Mu-Miao/Sunward_Data/README.md

# Sunward_Data

自动行驶小车项目的固件、调试记录、关键资料和当前车架交付文件。

## 项目入口

- [小车调试实测记录](小车调试实测记录_2026-10-07.md)
- [最新 T29 固件工程](output/固件接入包/T29_任务三四转向余量包/staged_Sunward)
- [T29 转向余量与烧录说明](output/固件接入包/T29_任务三四转向余量包/转向余量与烧录说明.md)
- [V19 FreeCAD 工程](output/车架模型/车架建模_v19/car_assembly_v19.FCStd)
- [V19 打印交付 ZIP](output/车架模型/打印交付/发给打印同学_v19.zip)
- [V19 设计说明](output/车架模型/车架建模_v19/设计说明_v19.md)
- [比赛题目](资料/比赛题目/H题_自动行驶小车.pdf)
- [元器件清单](资料/元器件清单.xlsx)
- [本地固件工程说明](firmware/README.md)
- [F407 OLED 驱动说明](oled_f407_hal/README.md)

## 目录

| 目录 | 内容 |
| --- | --- |
| `firmware/` | 早期本地固件工程与依赖 |
| `oled_f407_hal/` | OLED 驱动与转换工具 |
| `示例代码/` | 示例程序 |
| `文档/` | 实验操作手册 |
| `资料/` | 比赛题目、器件清单、主板资料、芯片和模块手册及参考例程 |
| `output/车架模型/` | 当前 V19 工程、STEP/STL、预览和打印交付 |
| `output/固件接入包/` | 最新 T29 完整源码与依赖；各阶段说明、补丁及验证记录 |
| `output/调试工具/` | WASD、串口记录和蓝牙调试工具源码及使用说明 |

## 归档说明

本仓库初次上传于 2026-10-14。根据项目用途筛选上传内容；本地历史文件保留原样。

不上传：旧版车架和重复项目压缩包、完整固件备份、历史接入包中重复的完整工程、临时报告与渲染中间文件、编译产物和缓存、厂家软件安装包、个人编辑器状态及原始调试接收日志。具体规则见 [.gitignore](.gitignore)。保留最新 T29 的交付 HEX 与 V19 打印 ZIP，便于按对应说明使用。

部分历史文档和脚本包含原机器的绝对路径，或引用仅保存在本地的历史模型。原 [项目导航](项目导航.md) 与 [Obsidian 首页](车车项目首页.md) 为本地入口；在 GitHub 浏览时优先使用本页的相对链接。T29 完整工程已包含 `Core`、`Drivers`、启动文件、链接脚本、工程配置和测试源码。

软件验证、固件烧录和实车测试分别记录；当前测试结果以实测记录为准。
