Mu-Miao/Sunward_Data/项目导航.md

# 车车项目导航

## 最新车架：V19，上下电池槽及插头避让

- [打开 V19 FreeCAD 工程](/Users/mzh/Desktop/车车/output/车架模型/车架建模_v19/car_assembly_v19.FCStd)
- [发给打印同学的 ZIP](/Users/mzh/Desktop/车车/output/车架模型/打印交付/发给打印同学_v19.zip)
- [整车装配预览](/Users/mzh/Desktop/车车/output/车架模型/车架建模_v19/后侧效果图_v19.png)
- [插头与电源线局部预览](/Users/mzh/Desktop/车车/output/车架模型/车架建模_v19/电源插头走线_v19.png)
- [上下电池槽剖面](/Users/mzh/Desktop/车车/output/车架模型/车架建模_v19/电池上下槽剖面_v19.png)
- [设计说明](/Users/mzh/Desktop/车车/output/车架模型/车架建模_v19/设计说明_v19.md)
- [打印说明](/Users/mzh/Desktop/车车/output/车架模型/车架建模_v19/打印说明_v19.txt)
- [完整 V19 项目压缩包](/Users/mzh/Desktop/车车/output/车架模型/项目压缩包/车架建模_v19_插头走线避让.zip)

V19 需要打印下底板、上托板各一件；主铜柱柱身 80 mm，C10B 铜柱柱身 20 mm。按目前模型，轮胎外侧跨度 200 mm，含预留 35 mm 外伸的前后长度 145 mm，高度 130.4 mm。实际装配间隙仍需试装确认。

旧版本在 `output/车架模型/历史版本`，旧打印包在 `output/车架模型/打印交付/历史版本`。以后新增车架版本请放入 `output/车架模型`，打印 ZIP 放入 `打印交付`，旧版移到相应历史版本目录。

## 资料与文档

- [比赛题目](/Users/mzh/Desktop/车车/资料/比赛题目/H题_自动行驶小车.pdf)
- [元器件清单](/Users/mzh/Desktop/车车/资料/元器件清单.xlsx)
- [C10B 主板原理图](/Users/mzh/Desktop/车车/资料/主控板/C10B主板原理图_2025-02-24.pdf)
- [C10B 接口说明图](/Users/mzh/Desktop/车车/资料/主控板/C10B主板接口说明图.jpg)
- [实验 3：定时器、PWM 与编码器操作手册](/Users/mzh/Desktop/车车/文档/实验3_定时器_PWM_编码器_详细操作手册.md)
- [小车调试实测记录](/Users/mzh/Desktop/车车/小车调试实测记录_2026-10-07.md)

芯片手册在 `资料/芯片手册`，LF04 和 OLED 模块资料在 `资料/模块资料`，厂家提供的使用说明、参考源码及软件工具在 `资料/厂家小车套件/小车`。实测记录保留在项目根目录，便于持续记录。

## 软件、接入记录和调试工具

- [本地固件工程说明](/Users/mzh/Desktop/车车/firmware/README.md)
- [F407 OLED 驱动说明](/Users/mzh/Desktop/车车/oled_f407_hal/README.md)
- [近期 T25 任务四独立重写记录](/Users/mzh/Desktop/车车/output/固件接入包/T25_任务四独立重写包/任务四独立重写与烧录说明.md)
- [近期 T26 中文注释核对记录](/Users/mzh/Desktop/车车/output/固件接入包/T26_中文注释/核对记录.json)
- [T27 任务四容错增强与烧录说明](/Users/mzh/Desktop/车车/output/固件接入包/T27_任务四容错增强包/任务四容错增强与烧录说明.md)
- [T28 任务三、四受限寻线与烧录说明](/Users/mzh/Desktop/车车/output/固件接入包/T28_任务三四受限寻线包/受限寻线与烧录说明.md)
- [T29 任务三、四转向余量与烧录说明](/Users/mzh/Desktop/车车/output/固件接入包/T29_任务三四转向余量包/转向余量与烧录说明.md)

2026-10-15 用户已主动将当前 Sunward 工程回退到 T28；T29 作为独立试调交付包保留。当前工程 Debug HEX 已核对为 T28，若要试 T29，需要明确选择 T29 包内固件文件；车上实际已烧录版本以设备显示为准。

`firmware` 和 `oled_f407_hal` 工程保留原位置。`output/固件接入包` 存放各阶段的交付文件和验证记录；`output/固件备份` 存放 Sunward 备份；`output/调试工具` 存放串口记录、蓝牙测试和 WASD 工具；`示例代码` 存放原根目录两个 main 示例。

接入包和编译记录属于历史过程资料，不凭文件夹编号认定当前固件或实车验收状态。目录整理没有烧录固件，也没有修改固件源代码。

## 归档和整理记录

临时脚本、实验报告渲染中间文件和主机检查产物放在 `归档/临时工作区`。

- [旧路径到新路径的移动清单](/Users/mzh/Desktop/车车/归档/目录整理记录_2026-10-13/移动清单.json)
- [文件完整性清单](/Users/mzh/Desktop/车车/归档/目录整理记录_2026-10-13/文件完整性清单.json)
- [路径引用修正记录](/Users/mzh/Desktop/车车/归档/目录整理记录_2026-10-13/路径引用修正.json)
- [整理结果](/Users/mzh/Desktop/车车/归档/目录整理记录_2026-10-13/整理结果.json)

这次移动了 125 个入口，校验了 14477 个文件，修正了 184 个文本文件中的路径引用，没有删除资料。修改前原文保存在整理记录内。备份快照和历史 ZIP 保留原内容，因此它们内部的旧绝对路径可以按移动清单定位新位置；需重新构建历史快照时，应另存副本并更新对应构建配置，保留原始备份。
