Mu-Miao/Sunward_Data/output/TASK4_V18_FLOW_2026-10-22/修改与验证说明.md

# V18 FLOW：基于 V14 的提前转向和连续换段

日期：2026-10-22。基线为用户指定分支 `codex/task4-v14-pwm22`，提交 `242b647ed1a8470ea77b5fc2576e4198fb08c912`；本地新分支 `codex/task4-v14-rolling`。原工作目录 dev 及 `.eide/eide.yml` 的未提交改动保持原状。未推送、未烧录。

## 原因与修改

V14 在候选顶点处输出 HALT，去抖后进入刹停阶段；转向对正后再次等待两轮低于 5mm/s 并停稳 200ms。前三圈回 A 也停车重启。这些步骤增加停顿和重新加速时间。

本版从 V14 移植仓库现有的连续控制及积分衔接实现，并新增首次候选线预转和任务四独立转弯速度：

1. C/D：保留原 ±120mm 候选窗口。前置探头首次读到有效黑线便开始两轮前进的低速转向；原连续 30ms 确认完成后才记点、发提示并换段。窗口外不预转；窗口内全白不按固定距离提前盲转。单帧毛刺消失时恢复原斜线航向，不计点。
2. A/B/C/D：正常去抖、角度确认、捕线到入弧和巡线的交接不再输出显式零驱动；不要求中途轮速归零。对正仍要求 ±3° 连续 30ms。
3. 圈间：前三圈 A 点当拍接续下一圈，固定使用第一次建立的 AC 航向；第四圈保留最终停稳。总共 4 圈、8 段入弧、17 次声光提示。
4. PI：仅在首次低速确认或换段时，对降速轮执行 `积分 *= 新目标 / 旧目标`，不增加升速轮积分，不重置反向/堵转累计。普通巡线每拍不重复缩减。PI 在实速高于目标时仍允许零 PWM 减速滑行，正目标不等于保证实物每拍有驱动力。
5. 任务四转向外轮最高 100、内轮 20mm/s；近目标角外轮降到最低 55mm/s。相比移植后 80/20 的配置，提高差速可避免双轮前进使转向过慢。

## 参数与范围

| 项目 | V14 | V18 FLOW |
| --- | --- | --- |
| 直线 / 正常弧线目标 | 270 / 240mm/s | 270 / 240mm/s |
| 转向外 / 内轮 | 最高80 / 0mm/s | 最高100 / 20mm/s |
| 转向平均编码器位移预算 | 80mm | 120mm |
| 转向时限 / 角度确认 | 4秒 / ±3°、30ms | 相同 |
| 入弧 / 捕线速度 | 50mm/s | 相同 |
| PI 输出上限 | 2200 | 相同 |
| B→BD 少转量 | 3° | 相同 |
| 正常中间停稳 / 圈间停车 | 有 | 取消；末圈终点停车 |

双轮前进转向的平移大于 V14 单轮转向，因此任务四位移预算明确从 80 改为 120mm；4秒时限不延长。任务三仍使用原单轮转向、80mm预算和停稳流程。任务四有效性检查限制双轮模式位移预算不得超过120mm。

STOP/OFF、IMU/ADC/UART异常、低压、节拍、超速、反向、堵转、失线/捕线/寻线边界及160秒总时限继续优先停车并锁存。连续运动不覆盖这些异常情形。几何、前置探头实际安装位置、车身对顶点和弧线的覆盖仍需真实场地验证；不通过扩大候选窗口替代覆盖验证。

## 文章参考

用户提供的[《2024年电赛H题自动行驶小车全代码思路讲解》](https://blog.csdn.net/2301_79299887/article/details/141063042)中，采用探头见线/离线事件衔接直线与循迹，并按偏差改变控制参数。参考的是事件换段和按偏差分配速度的思路。本车原有边缘探头降至120mm/s的策略继续保留。

文章为七路灰度、直接PWM方案；本车为LF04四路、MPU6050和双轮编码器PI。因此没有移植其PID数值、固定PWM、定时测距或每段重置yaw的实现。文章示例中的多路独立if会覆盖位置，且全白默认0，不能代替本项目对全白/全黑/离散图样的有效性检查。未复制文章代码。

赛题资料：`/Users/mzh/Desktop/车车/资料/比赛题目/H题_自动行驶小车.pdf`，第2页要求经过顶点时车身投影覆盖顶点、弧线过程中投影覆盖弧线。本版仅在原点位窗口并结合实际探头观测预转，软件测试不能证明实车投影满足条件。

## 软件验证与固件

- 10 类场景、CarApp与兼容API共20组ASan/UBSan回归通过。覆盖四圈16次连续转向、3次A点移动接续、8段入弧、17次提示、正常衔接显式零驱动为0、最终停车以及故障优先级。
- 新增 C/D 首候选预转、窗口外/全白/全黑不预转、单帧毛刺不误记点、传感器/航向/里程/STOP优先级。
- 同样巡航速度、160mm轮距、45mm探头提前量的理想输入模型：模拟 V14 停车策略128130ms，V18 FLOW122210ms，约少5.92秒。此对照包含转向100/20与80/0的差异，不是实车预测；模型按给定航向与理想轮速运行，不验证实际轮胎、惯性或轨迹覆盖。
- PI带死区/滞后的27组电机假设均在120mm预算内完成C点转向，最大90.23mm。该模型用于发现旧积分导致的转向问题，不作为实车拟合。
- 50 个 ARM 编译单元通过编译、链接。FLASH 56856B，RAM 5864B。HEX 校验和、EOF、版本字符串、FLASH范围与向量检查通过；构建警告为原 `main.c` 未使用诊断变量/函数。
- 构建脚本 `tools/build_firmware.py`；测试脚本 `tools/tests/run_tests.py`。输出、日志与清单在 `build/Debug/`。
- HEX SHA256：`9eeab0b7acb77f2b54db94debbefa200582d310901a6f86d57f3633d68a0015c`。
- ELF SHA256：`9245bf3c749abe674591f05629b015063ce7d595eae67d11e61cd58e2ccff467`。

本版只有软件验证与构建完成，未烧录、未启动电机、未进行实车验收。部署时使用本版HEX并核对 `TASK 4 V18 FLOW` 标题，不选历史归档V14固件。
