Mu-Miao/Sunward_Data/output/TASK4_V18_FLOW_2026-10-22/参考仓库代码对比.md

# hshsgxlj/stm32 与 V18 的入弧控制对比

核对日期：2026-10-22。参考版本固定为 `d58e622c16aeb1735e2873f35c9fa72f22ab202f`（main）。阅读了正式入口chapter.c、h_course.c、h_course.h以及motor.c、track.c，并区分独立line_follow.c与正式任务控制。此次只读审阅，没有运行外部仓库脚本、修改车上参数或烧录。

pyOCD采集进程已退出。会话20261022_195646在20:03:12(+08:00)因探针读取超时断开，进程退出码1，未重新连接。此前现场数据和故障提取记录已保存。

## 与当前问题最相关的实现

| 项目 | 参考仓库实际实现 | V18实际实现/现场观察 |
| --- | --- | --- |
| 捕线放行 | CAPTURE中1～3路连续黑线、连续30ms即可转ARC，最外侧单探头也有效 | 捕线后进入ARC_ENTRY，非最外侧有效图样连续60ms且已入弧至少200ms才转ARC |
| 最外侧探头 | 在ARC内部进入line_recover_dir，低速保持纠偏；中间P2/P3任一压黑连续30ms后退出恢复 | ARC_ENTRY把偏差与弧向前馈相加并限幅；现场1110时目标30/70mm/s，仍不能放行 |
| 专用恢复 | 任务3/4基准PWM的70%，固定修正85；制动期限参数10ms | 入弧50mm/s，差速限幅为基速40%；参数是目标速度单位，不可直接用PWM参数替换 |
| 全白 | 恢复方向最长保留1500ms；普通短空白前150ms保持上次差速 | 原入弧/失线时间、位移、角度预算；本次另有500ms全白触发F7 |
| 顶点衔接 | VERTEX_BRAKE等待200ms并检查轮速，单轮转向；A/B出弯还有摆正与停稳 | 正常换段连续运动，两轮前进转向100/20mm/s |
| 轮速执行 | MOTOR_SetSpeeds实际输出直接PWM，编码器用于计距和部分同步 | 双轮以mm/s目标通过PI闭环执行 |

关键代码：

- [有效线定义](https://github.com/hshsgxlj/stm32/blob/d58e622c16aeb1735e2873f35c9fa72f22ab202f/Core/Src/h_course.c#L369-L390)：接受1～3路连续黑线，包含最外单探头。
- [CAPTURE转ARC](https://github.com/hshsgxlj/stm32/blob/d58e622c16aeb1735e2873f35c9fa72f22ab202f/Core/Src/h_course.c#L805-L822)：确认有效线后直接交给巡线，没有V18独立60mm入弧放行阶段。
- [弧线边缘恢复](https://github.com/hshsgxlj/stm32/blob/d58e622c16aeb1735e2873f35c9fa72f22ab202f/Core/Src/h_course.c#L905-L1066)：保持恢复方向，内侧探头稳定后退出；普通巡线包含P/I/D。
- [恢复参数](https://github.com/hshsgxlj/stm32/blob/d58e622c16aeb1735e2873f35c9fa72f22ab202f/Core/Inc/h_course.h#L109-L128)：任务3/4 70%、85、10ms和恢复全白1500ms。
- [电机输出](https://github.com/hshsgxlj/stm32/blob/d58e622c16aeb1735e2873f35c9fa72f22ab202f/Core/Src/motor.c#L109-L140)：速度命名的参数最终换成占空比，没有与我们相同的mm/s速度PI。

## 不宜直接移植的部分

1. **任务3/4线尾判定缺少几何终点约束。** ARC每拍先调用task2_all_white_event，持续全白450ms就按阶段记作B或A。该函数的已见有效线/最小350mm保护仅对task2启用，没有给task3/4加入我们的弧长窗口与出口航向条件。因此本次V18第三趟在入弧阶段的全白，若套用这种判定，存在误计B点的风险，不能把不停车或切段误认为跑通。
2. **仍有主动停车。** C/D顶点、单轮转向完成和A/B出弯均有零输出或停稳阶段，不是本次目标所需的全程连续换段方案。task34的10ms恢复制动只是期限参数，10ms主周期下实际是否产生一个零输出周期还取决于调度时刻。
3. **左右次序不同。** 他们按PC8/PC4/PC9/PB8定义P1～P4从左到右；我们对同一组原始引脚读数反序解码物理O4/O3/O2/O1。相同字符串和纠偏正负号在两车上不能直接对应。应保留我们的物理映射。
4. **现场标定不同。** 他们配置35°斜线、222.6mm轮周长、62400计数/圈、B出口-175°等；我们使用38.66°几何、204.20mm轮周长及左右独立CPR。这些数值不应随控制策略一起搬入。
5. **代码/注释不能证明完赛。** h_course.c及h_course.h本身标注参考Sunward；仓库README的功能、构建及标定说明不等于一份匹配该提交的四圈实测记录。此处只评价静态实现，没有验证其实际成绩。

线尾判定依据：[task2_all_white_event](https://github.com/hshsgxlj/stm32/blob/d58e622c16aeb1735e2873f35c9fa72f22ab202f/Core/Src/h_course.c#L320-L347)、[任务3/4 ARC调用](https://github.com/hshsgxlj/stm32/blob/d58e622c16aeb1735e2873f35c9fa72f22ab202f/Core/Src/h_course.c#L825-L840)、[450ms参数](https://github.com/hshsgxlj/stm32/blob/d58e622c16aeb1735e2873f35c9fa72f22ab202f/Core/Inc/h_course.h#L53)。

## 对下一版的建议

参考“有效线接管与提速资格分开”的思路：在原点位/捕线边界内确认有效单探头后，进入受限的低速边缘巡线；内侧图样稳定后再允许正常速度。保留本车的探头映射、双轮PI、故障锁存，以及失线时间/位移/角度和弧线出口联合约束。低速恢复不直接放240mm/s，也不只放宽60mm或将500ms改成1500ms。

该建议尚需用本次1110持续见线和1110→1111两个现场片段验证。恢复方向保持和短空白冻结差速在V18中已有，真正需要调整的是低速入弧与巡线反馈接管的条件和轨迹，而不是重复添加同样的寻线功能。
