Mu-Miao/Sunward_Data/output/TASK4_V19_EDGE_2026-10-22/修改与验证说明.md

# V19 EDGE：捕线后先接管低速巡线，内侧稳定后再提速

2026-10-22，基于V18提交 `f2802b6bf4152c0142424c0d71640e7091490cd5`，本地分支 `codex/task4-v19-edge`。V14和V18分支保持原状。V19已完成软件验证与构建，未烧录、未实车验证，pyOCD保持关闭。

## 现场问题

板上56856字节FLASH已逐字节核对V18 ELF。保存的两趟独立故障：

- start_ms=225380：第一半圆ARC_ENTRY采到25帧，均为有效1110最左单探头；始终未通过非最外侧连续60ms的放行条件。入弧60.442mm、1220ms时锁存F6位移超限，CPU仍运行。
- start_ms=285471：先1110，后1111；失线500ms、24.85mm、8.00度时锁存F7时间预算，CPU仍运行。

原始提取记录见 `records/task4/2026-10-22_v18_entry_faults.json`。20Hz异步RAM不是10ms原子轨迹，短图样可能漏采；精确停车判据使用固件锁存快照。

## 实现

1. C/D点位与转向对正流程保留。CAPTURE仍需连续30ms有效线，且受原2秒/60mm捕线边界限制。通过后允许最外侧单探头进入ARC低速子状态 `edge_follow_active=1`，不再把内侧稳定作为低速巡线接管的前提。
2. 低速基速70mm/s。最外侧单探头采用±50mm/s差速，目标20/120或120/20mm/s；非最外侧有效图样按已有巡线增益生成差速并限幅。继续使用双轮PI，原左右映射不变，没有使用固定PWM或复制参考仓库参数。
3. 非最外侧有效图样连续60ms、且低速阶段已至少200ms，才取消低速标志。从70mm/s按原弧线加速度100mm/s²逐渐提速；不会立刻跳至240mm/s。接管与提速不重置半圆里程，不重复计弧、计点或发声光。
4. 低速子状态从捕线接管时起独立限120mm、2500ms和45°。这是V19新的反馈巡线预算；V18 ARC_ENTRY的60mm/1500ms/25°流程保留为可选旧配置回归，不用于V19默认接管。新预算不随探头闪烁或恢复重启。
5. 全白或未确认恢复时降到50mm/s，冻结最后可信差速并限为±30mm/s，最外侧历史通常为20/80。恢复仍须连续有效30ms，内侧提速确认从恢复完成后重新计时。全白500ms、普通20mm/12°、可信探头交接35mm/18°全部保留。全黑/离散图样立即零输出并使用原故障等待，不作为巡线有效线。
6. 入弧附近全白不能计作B/A。正常弧线出口仍同时要求里程窗口、出口航向和连续全白；低速子状态禁止线尾放行。参考仓库的“仅全白450ms判出口”未移植。
7. 低速阶段显示EDGE；故障快照区分EDGE时间/位移预算。只读采集器增加可选低速标志与恢复基速字段。V19 ELF的instance为944字节，V18为912字节。

## 保留与改变

| 项目 | V19 |
| --- | --- |
| 正常直线/半圆巡航 | 270/240mm/s，保持V18 |
| C/D提前转向、正常换段、前三圈A接续 | 保持连续；末圈终点停稳 |
| 顶点转向 | 外轮最高100、内轮20mm/s，120mm/4秒预算保持 |
| 低速巡线接管 | 新增70mm/s基速，外侧20/120；120mm/2.5秒/45°预算 |
| 内侧提速资格 | 非最外侧连续60ms且阶段至少200ms |
| 短暂全白 | 基速50、差速冻结；原500ms及位移/角度预算 |
| PI输出上限、增益 | 2200、原增益和换段积分缩减保持 |
| 启动方向、静态CAL、探头顺序 | 保持 |
| 任务三/可选旧入弧 | 默认不启用新接管；旧流程继续回归 |

STOP/OFF、按键取消、IMU/ADC/UART异常、低压、节拍、超速、反向、堵转与160秒总超时仍优先停车并锁存。两轮正目标不等于每拍PWM非零：PI仍允许超目标时滑行减速。

## 参考来源

参考[hshsgxlj/stm32的CAPTURE接管](https://github.com/hshsgxlj/stm32/blob/d58e622c16aeb1735e2873f35c9fa72f22ab202f/Core/Src/h_course.c#L805-L822)和[低速边缘恢复](https://github.com/hshsgxlj/stm32/blob/d58e622c16aeb1735e2873f35c9fa72f22ab202f/Core/Src/h_course.c#L905-L1066)的状态衔接思路。新实现使用本项目原物理映射、mm/s目标和轮速PI，未复制其实现代码、PWM值、1500ms寻线预算、轮周长或角度标定。

## 验证

- 11类场景、CarApp及兼容API共22组ASan/UBSan回归通过。四圈16次转向、3次A移动接续、8次入弧、17次提示与最终停车通过。
- 用V18保存的入弧帧构建输入夹具；10ms之间的插值是测试构造，不是假称10ms实测。关闭新接管时重现原60mm F6；启用后同样1110输入持续受限低速巡线，可越过原60mm停点，并在随后构造的内侧稳定输入后逐渐提速。该结果证明控制分支已改变，不能证明新实车轨迹一定恢复。
- 原始持续全白片段依然正确触发500ms F7，不伪造B点；另测期限内真实连续恢复输入可接续，毛刺不能续期、翻转冻结方向或提前提速。
- 覆盖CB/DA及左右探头镜像、最少200ms、60ms去抖被毛刺打断、毫秒溢出、70起步斜坡、距离/计数/航向参考保留；120mm/2500ms/45°、500ms/35mm/18°的边界和端口二次授权；全黑/离散图样与原各类故障停车。
- 50个ARM单元编译链接通过，FLASH58108B，RAM5896B；警告仅为原main.c未使用诊断变量/函数。HEX校验和、EOF、FLASH范围、栈/复位向量和版本标题通过。
- ELF离线布局通过：地址0x200000a8，instance944字节。该检查不连接USB探针。
- HEX SHA256：`3dac3f898b5aa6aa81e302646b10f2bdaf5f824c4f86a59f81a348e90999f145`。
- ELF SHA256：`4f3582504d99b9a9435b46f8bf58283abfa354e3e040b26e8c8cc968054a09cb`。

源码入口：Core/Src/car_task3.c、car_task3_port.c；调参入口Core/Inc/car_config.h。新增回归tools/tests/test_edge.c，原始帧夹具tools/tests/fixtures/v18_entry_onsets.h；日志和固件见deliverables/task4-v19-edge/。

V19当前只完成软件验证与构建。实际贴线、车身投影、圈时和整圈稳定性仍未验证；本次没有重开pyOCD、烧录、复位或启动电机。
