Mu-Miao/Sunward_Data/output/固件接入包/9.5_串口优化包/串口优化与复测.md

# 双轮版串口优化与复测

2026-10-08，已代做备份与代码接入。备份在[优化前版本](/Users/mzh/Desktop/车车/output/固件备份/Sunward_串口优化前备份_2026-10-08_3fxiu9pp)，包括源码、中断文件、main、构建文件、原ELF/HEX。main、CubeMX配置、115200波特率和双轮PI参数保持原样。

## 改了什么，为什么

旧双轮运行日志在主循环用HAL_UART_Transmit阻塞发送。一行比单轮更长，发送期间主循环不能处理命令和测量；115200/8N1每字节约86.8微秒，80～100字节约6.9～8.7ms，占用10ms控制周期的较大部分。接收只靠主循环逐字节轮询，期间可能发生UART溢出。旧逻辑遇到UART错误又将active置0，日志和命令处理一起退出，表现可能像卡死。未捕获用户本次卡死的运行日志，不将这些代码问题直接当作已复现的唯一原因。

新lab_uart_async.h/.c在双轮模块初始化后独占USART1。启动阶段之前的Boot等文字仍是有限时阻塞输出；双轮阶段改为：

- 发送先复制到512字节队列，由TXE中断逐字节发送，主循环不等待整行发完。满队列丢弃整条遥测，累计TXD，保留控制和接收。
- 接收由中断写入128字节队列，主循环每次最多处理32字节。RX溢出及ORE/FE/NE/PE错误累计RXE，清除错误状态，通知主循环两轮停车并清积分，丢弃残缺输入。模块继续输出和接收，允许恢复后的新完整命令。
- 半条命令闲置100ms后丢弃，避免残留RU之类字符干扰下一次STOP。
- 日志每200ms一条，增加RXE/TXD诊断字段。USART1中断优先级2，低于TIM2的0；ISR只搬运字节，不格式化文字或执行PI。

中断入口添加在stm32f1xx_it.c的USER CODE块，声明在.h的USER CODE块；启用NVIC放在驱动初始化中，不必在CubeMX再点USART1中断。当前运行阶段不要再混用HAL_UART_Transmit/Receive、HAL_UART_IRQHandler或其他UART中断驱动。若以后在CubeMX启用USART1中断并生成同名处理函数，需要合并入口，避免重复定义。

双轮模块的目标60、P32/I20、每轮上限1800、3秒结束、使能/ADC/采样/方向/堵转停车条件均保留。USART接收错误后日志ST=UART，但不会永久关闭模块；静置100ms以上让输入恢复边界，再发送完整命令。故障期间没有自动重新启动电机。

## 你现在这样测

1. 固定车身、双轮架空，使能OFF，下载新的`/Users/mzh/STM32Cube/Sunward/build/Debug/Sunward.hex`。
2. 连接115200/8N1串口后Reset，确认DPI提示末尾是`UART async`。
3. **保持OFF等20秒**，看日志是否持续刷新。正常时RXE=0、TXD=0。先确认待机通信，再启动电机。
4. 电池主电源ON，使能ON，等1秒，单次发送RUN!，观察两轮向前、约3秒自动停。
5. 停3秒，再RUN，约1秒后STOP!；再停3秒、RUN、约1秒后拨OFF，检查两轮均停。
6. 导出JSON发给我，说明文字是否还停住、轮子是否平顺。若有ST=UART/GAP或RXE/TXD不为0，保留这些行供定位。

不要循环发送RUN或大量AT命令做压力测试。正常用户命令和遥测已在模拟检查中覆盖；实际USB串口、浏览器显示和电机干扰仍需本轮实测。若停车异常，用使能OFF；软件无响应时切断电池主电源。

## 验证范围

主机集成模拟覆盖真实队列驱动与双轮模块：队列拥塞时控制/STOP继续运行；RX溢出/ORE停车后日志与重启恢复；RX与TX并行、队列回绕、队列保存调用者数据副本、空队列关闭TXE中断、半条命令过期，以及原双轮PI与停车条件。全工程ARM编译链接通过，最终ELF具有强USART1_IRQHandler与LabUART_IRQHandler符号。具体日志在本包内。模拟不代替硬件中断时序、USB设备或浏览器卡顿的验证；尚未自动烧录。
