Mu-Miao/Sunward_Data/output/固件接入包/9.5_双轮PI闭环测试包/9.5_第七步_双轮3秒测试.md

# 双轮同时前进，固定架空试转3秒

**串口优化更新：当前Sunward及本包源码已改为运行阶段USART1中断收发，启动提示末尾为`UART async`，目标/增益/3秒时长保持原样。先按[串口复测说明](/Users/mzh/Desktop/车车/output/固件接入包/9.5_串口优化包/串口优化与复测.md)检查OFF待机20秒，再做双轮试转。** 本包新增lab_uart_async.h/.c及更新后的stm32f1xx_it.c/.h，已自动接入，不必再次复制。

**2026-10-08 15:39已代你完成备份、复制文件、修改main并完整编译通过。你直接从下载和测试开始，不必再手动接入。** 原左轮8秒版本在[接入前备份](/Users/mzh/Desktop/车车/output/固件备份/Sunward_双轮接入前备份_2026-10-08_6jwjipiv)内；新HEX已生成，尚未烧录到板上。

右轮8秒和左轮8秒日志后段分别已接近60mm/s。本轮检查两轮同时控制时，供电、采样和停车是否正常。车身固定、双轮悬空，先短时试转3秒。

新模块dual_pi_test.h/.c用两个独立控制器：左编码器TIM8计数正向，右编码器TIM4计数取负；左/右各自P32、I20，目标均60mm/s，每轮命令上限1800。左CPR60104.3333、右59996.3333，轮径暂按65mm。统一驱动调用为A=右轮正命令、B=左轮负命令。

main只调用DualPITest_Begin和DualPITest_Poll，不同时运行LeftPITest/RightPTest。任一轮持续反向、异常速度或高命令但不转，均让两轮一起制动并清零两组积分。STOP、使能OFF、ADC/电池门槛、采样间隔异常及UART错误也停两轮；Reset不自动启动，运行中重复RUN不会延长3秒。

## 下载后这样操作

1. **固定车身，双轮架空**，使能OFF，打开电池主电源。
2. 下载`/Users/mzh/STM32Cube/Sunward/build/Debug/Sunward.hex`。串口115200/8N1连接后Reset，确认提示`DPI: send RUN! or STOP!; both forward; 3s; UART async`。
3. 待机UL/UR/IL/IR均应为0；BAT应接近此前电池接通时约1340～1350的读数。
4. 使能ON，等1秒，ASCII单次发送`RUN!`，不要循环发送。观察两轮都向前、无明显反复启停，约3秒同时自动停。
5. 若第一次正常，停3秒，再发一次`RUN!`，等自动停。
6. 再发`RUN!`，约1秒后发送`STOP!`，确认两轮都停；再停3秒，发`RUN!`，约1秒后拨使能OFF，确认两轮都停。
7. 导出JSON发给我，并说明两轮方向、有无明显抖动、自动停/STOP/OFF是否均正常。

如果任何轮方向错误、明显反复启停或停车异常，STOP并拨OFF，结束本轮。软件无响应时使用电池主电源开关。不要用手阻挡轮子，也不要把车放到地上发送RUN。

3秒末尾未达到60不一定是故障，积分需要时间。本轮先验证双轮同时运行与停车，再根据日志判断是否延长观察。两轮达到相同架空轮速不能证明落地直行；轮径、负载和打滑仍会影响行驶。

## 读日志

示例字段形状（数字只是说明格式，不是实测）：

```text
DPI T=60 L=55 R=54 UL=600 UR=580 IL=420 IR=410 BAT=1340 DT=10000 ST=RUN F=-
```

| 字段 | 含义 |
|---|---|
| T | 两轮共同目标，单位mm/s；停车时0 |
| L / R | 左/右轮实测速度，前进均应为正，单位mm/s |
| UL / UR | 左/右轮向前驱动量的正数；实际A=UR、B=-UL |
| IL / IR | 左/右积分项对PWM命令的贡献，不是Ki参数 |
| BAT | 电池ADC原始值；1200仅是本轮台架门槛，不是电池截止标准 |
| DT | 最近读取间隔，单位微秒，通常约10000 |
| ST | RUN、DONE、STOP、OFF或故障状态 |
| F | 轮子故障归属L/R；共用停车条件或无故障显示- |
| RXE / TXD | 串口优化版累计接收错误数/因发送队列满而丢弃的遥测条数，正常应0 |

每200ms打印最近一拍数据，不能用它排除全部10ms采样中的波动。停车检查UL/UR/IL/IR都回0、L/R随后回0，并观察实物。

## 接入位置与回退

双轮头文件在`/Users/mzh/STM32Cube/Sunward/Core/Inc/dual_pi_test.h`，源码在`/Users/mzh/STM32Cube/Sunward/Core/Src/dual_pi_test.c`。main Includes改为dual_pi_test.h；USER CODE BEGIN 2调用：

```c
if (DualPITest_Begin(&huart1, &htim8, &htim4, &hadc1,
                     Lab_MotorRawAB) != HAL_OK) {
    Lab_Write("DPI init FAIL\r\n");
    Error_Handler();
}
```

while循环只调用`DualPITest_Poll(lab_tick10_count);`。CubeMX和TIM2计数回调不用改。原单轮模块保留；恢复接入前main后重新编译即可回到左轮8秒版本。
