Mu-Miao/Sunward_Data/output/固件接入包/9.5_右轮PI闭环测试包/9.5_第三步_加入I.md

# 9.5第三步：右轮P=32，加入I=20，架空测试

P=32实测两次运行打印均值44.47、46.60mm/s，目标为60mm/s。当前未见故障停车、打印速度也未超过目标，但尚未记录全部10ms反馈。保持P=32，加入较小I=20作首次试调；目标60、输出上限1800、运行3秒保持原样。I会在速度持续偏低时累积驱动量，因此即使速度差变小，也能保留所需驱动。

## 1. 替换两个文件

先将原`/Users/mzh/STM32Cube/Sunward/Core/Inc/right_p_test.h`和`Core/Src/right_p_test.c`各复制一份到本次测试前的备份目录。

将本包的同名文件分别覆盖：

- `Core/Inc/right_p_test.h` → `/Users/mzh/STM32Cube/Sunward/Core/Inc/right_p_test.h`
- `Core/Src/right_p_test.c` → `/Users/mzh/STM32Cube/Sunward/Core/Src/right_p_test.c`

main.c和CubeMX不用改。确认头文件：

工程中该模块的位置应只有：

```text
Core/
  Inc/right_p_test.h
  Src/right_p_test.c
```

`Core`这一层不要另外保留同名`.c`或`.h`。同目录旧头文件会遮住Inc里的新头文件，重复`.c`也会重复编译。2026-10-08这次重复文件已备份归位，原EIDE完整重新构建通过。

```c
#define RPT_TARGET_MMPS     60.0f
#define RPT_KP              32.0f
#define RPT_KI              20.0f
#define RPT_MAX_CMD         1800
#define RPT_DURATION_MS     3000U
```

Kp单位是PWM计数/(mm/s)，Ki单位是PWM计数/((mm/s)×秒)。代码使用实际间隔乘Ki，不能再额外乘10ms。这里的32、20是试调值，并非最后的最佳增益。

## 2. 怎么测

1. 固定车身，两轮继续架空；使能先OFF。编译下载，连接115200/8N1串口后按Reset。
2. 启动提示应包含`PI active`，持续日志新增`I=`字段。等待时`T=0 U=0 I=0`，两轮不应转。
3. 使能ON，等1秒，ASCII单次发送`RUN!`，不启用循环发送。让右轮运行3秒自动停止。
4. 停3秒，再发一次`RUN!`，让它再次自动停止。
5. 另做一次RUN!，运行中发STOP!，检查停车及I归0；再做一次RUN!，运行中拨OFF，检查停车及I归0。
6. 导出本轮完整日志，告诉我有无明显抖动、反复启停，以及停车是否正常。

如果出现明显抖动、速度持续冲过目标，发送STOP!并拨OFF，停止重复测试；先把日志发来，不自行提高I、输出上限或测试时长。

## 3. 看哪些数

```text
RPI T=60 V=55 U=500 I=340 BAT=1350 DT=10000 ST=RUN
RPI T=0 V=0 U=0 I=0 BAT=1350 DT=10000 ST=DONE
```

上面仅为格式示例。T/V单位mm/s，U/I为PWM计数，DT为µs；I是当前积分贡献，不是Ki参数。初期若速度低于目标，I通常逐步增大，V应逐渐靠近60。速度到目标附近时，积分贡献可能仍非零，这是维持轮速的驱动量。

程序在输出饱和且误差继续向饱和方向推时暂停积分，积分贡献限制0～1800。每次RUN!从0积分开始；自动结束、STOP、OFF及故障都会清积分并制动。原有启动、ADC门槛、漏拍、反向、超速、停转与UART失败处理保持启用。停车后I必须为0，不能带着上一次积分重新启动。

V仍是每行最近一次约10ms读取的轮速，200ms日志不能证明所有拍都平稳。不要为了让3秒末尾刚好等于60而盲目加大Ki。本次仅验证小I加入后的趋势及积分复位，再按实际日志调整。
