Mu-Miao/Sunward_Data/output/固件接入包/9.5_蓝牙手动控制包/手动试车命令.md

# 蓝牙手动前进、后退、转弯与STOP打断

2026-10-08 19:46编译失败修复：现场头文件缺少DPT_MANUAL_MMPS、DPT_MANUAL_MAX_CMD、DPT_MANUAL_DURATION_MS、DPT_SWITCH_BRAKE_MS，源码已是手动新版，造成版本不一致。已备份并只补回120U/3000/10000U/200U四个定义，现场完整重编译通过，HEX与此前已验证的手动版本一致。编辑器若仍显示旧头文件，应重新加载磁盘内容后再保存。

已备份并接入Sunward，完整编译通过。新固件：`/Users/mzh/STM32Cube/Sunward/build/Debug/Sunward.hex`；本目录也有相同HEX。尚未烧录、尚未做实物新方向/提速验证。蓝牙USART3维持9600/8N1，USB USART1维持115200/8N1，两口使用中断收发，10ms轮速控制由TIM2节拍触发。

## 命令按文本/ASCII单次发送

| 命令 | 行为 |
|---|---|
| `F!` | 前进，左右目标均+120mm/s，默认最长10秒 |
| `B!` | 后退，左右目标均-120mm/s，默认最长10秒 |
| `L!` | 向左前方转弯：左轮60、右轮120mm/s |
| `R!` | 向右前方转弯：左轮120、右轮60mm/s |
| `STOP!`或`S!` | 收到完整命令后立即制动、清零积分；取消切换等待 |
| `V150!` | 停车时设置手动速度为150mm/s，范围40～200 |
| `TIME20!` | 停车时设置单次运行上限20秒，范围1～30秒 |
| `RUN!` | 保留原60mm/s、3秒双轮PI实验 |

速度为轮速目标，实物达到多少由日志与地面测试判断；转弯内轮目标为外轮的一半。V/TIME调整只在停车状态接受，重启后恢复120mm/s、10秒。需要更快/更长时，先发STOP!，看到停车后分别发送V150!、TIME20!，最后发F!。每条单独发送，不把STOP和启动拼成同一批。

## 这次这样上板

1. 使能OFF、双轮架空，烧录新HEX。在已用通的蓝牙工具里连接，关闭循环发送。
2. 主电源ON、使能ON，等1秒。发F!，约1秒后STOP!；再分别试B!、L!、R!，每次约1秒后STOP!。核对前进/后退/左右差速与实物一致，STOP和实体OFF都能让两轮停。
3. 架空验证正常才落地。先用默认F!跑约2～3秒就STOP!，记录距离、是否偏转和抖动，再延长到默认10秒。此次不需要USB线跟车。
4. 保存蓝牙日志，报告方向、转弯与停车行为。发生STALL/REV/FAST/GAP/LOW/UART等故障时保留日志，拨使能OFF。

不同运动命令切换时先制动200ms，再按新目标启动；等待期间也接受STOP/OFF。相同命令重复发送不延长当前倒计时，改变方向会开启新一段倒计时。STOP或接收故障在同一轮处理里优先于任何启动命令。收到完整STOP后在主循环制动，不等倒计时结束；UART中断只收发字节，控制/格式化不放到UART中断里。

保持原PI增益P32/I20；手动PWM命令幅度上限3000，原RUN实验仍1800。后退速度反馈按目标方向归一化，所以正确后退不会触发旧的“负速度”保护；向错误方向转、堵转、异常速度、电池/ADC异常、控制节拍异常和串口接收故障仍停两轮。此版没有蓝牙连接状态检测，单次超时和实体OFF仍有效。

DPI新增字段：M=TEST/FWD/BACK/LEFT/RIGHT，TL/TR为有符号的左右目标mm/s，V为手动速度配置，SEC为手动时限秒数。L/R仍以前进为正，后退为负；UL/UR也为有符号的左右前进命令，实际电机A=UR、B=-UL。积分IL/IR为各自目标方向上的非负驱动贡献。其余RXE/TXD/停车字段含义不变。

软件验证覆盖新方向映射、左右转目标、STOP/S打断与取消待切换、200ms制动、10秒边界/重复命令不延时、V/TIME范围及运行时拒绝配置、原RUN回归、双口STOP优先和原停车保护；本地记录工具也增加这些命令并通过伪终端测试。现场ARM编译成功：FLASH23940B、RAM4016B。备份：`/Users/mzh/Desktop/车车/output/固件备份/Sunward_手动控制前备份_2026-10-08_a9br3vgr`。
