Mu-Miao/Sunward_Data/output/固件接入包/T09_1米直行接入包/T09_第三步_1米直行与声光.md

# T09第三步：1米直行与停稳声光

2026-10-10。承接桌面GO20尺测约20.2cm、编码器估算20.1cm。按用户决定，跳过宿舍坑洼瓷砖与当前真实地面测试，先继续接功能。本版已接入Sunward，但尚未烧录或实车运行，不将软件验证写成1米路线验收通过。

新增 **`GO100!`**：保持启动时朝向，编码器累计目标1000mm，起步渐增、末段减速，到点制动并确认停稳，然后两盏灯与蜂鸣器同时提示一次500ms。既有GO20仍目标200mm、60mm/s，GO仍三秒；V与TIME只改手动运动，不改变GO20或GO100。

## 用户最新安排

用户已明确将本节下载、校准和实物运行统一留到下次真实测试场地（用户称“明天”）；今晚不要求执行。待测顺序见[现场清单](/Users/mzh/Desktop/车车/output/固件接入包/T09_1米直行接入包/下次真实场地测试清单.md)，可先继续独立按键等软件准备。

## 到场后怎样做

1. 实体使能保持 **OFF**，下载[本包Sunward.hex](/Users/mzh/Desktop/车车/output/固件接入包/T09_1米直行接入包/Sunward.hex)。工程的[当前HEX](/Users/mzh/STM32Cube/Sunward/build/Debug/Sunward.hex)是同一版本。
2. 连接原文本串口或蓝牙助手，关闭循环发送。启动命令说明应包含`GO100!=heading1000mm/120`。
3. 车放稳、保持OFF，发送一次`CAL!`，静止约7～8秒，等`YC=READY N=500`。这一步只确认下载和校准，不启动电机。
4. 本阶段不要求发GO100，不要求宿舍地面或桌面1米试跑。实物路线测试按用户安排后续进行；随后可继续接独立按键启动。

重新上电后必须重新校准；仅下载或CAL不会自动走车。PA0按键独立校准/启动尚未接入，本版仍以文本命令触发任务。

## 新命令的速度与停车

| 项目 | GO20保留 | GO100新增 |
|---|---:|---:|
| 编码器目标里程 | 200mm | 1000mm |
| 基速 | 60mm/s | 起步40mm/s，渐增至120mm/s |
| 起步目标增速率 | 原行为 | 100mm/s²，约0.8s到120 |
| 减速区间 | 最后40mm | 最后100mm |
| 末段基速下限 | 40mm/s | 40mm/s |
| 驱动阶段超时 | 10s | 13.5s |
| 制动后停稳确认 | 两轮均±5mm/s内持续200ms | 相同 |
| 制动阶段超时 | 1.5s | 相同 |
| 完成提示 | 原行为 | DONE后声光一次500ms |

120mm/s是本版初始目标，尚未验证实际地面速度。原60mm/s理论走1米就需16.7秒，无法满足手册15秒要求，因而为GO100单独设置巡航速度；不调整此前PI增益、轮周长或1800输出上限。1米速度基准更高，最后100mm提前减速。航向差速仍最多±15mm/s，低速时同比收窄；不因120基速把差速限幅自动翻倍。

本版超时限制为驱动13.5秒加制动1.5秒，不代表已经验证15秒内成功。未到目标触发TIMEOUT，制动未停稳触发SETTLE，两者都没有完成提示。低压、ADC、UART、GAP、REV、FAST、STALL、YAW、STOP与OFF停车保留。完成后的500ms声光另计；到点停稳后记录DONE才是运动完成时刻。

目标1000mm是开发阶段的车体参考点里程；正式A→B摆放与覆盖B还要按手册选择同一车体参考点，不凭前置探头到点来判定覆盖。

## 完成声光与日志

PC2/PC3低电平点亮两盏灯，PA15高电平鸣响；已核对现有GPIO初始化与JTAG释放。提示在BRAKE确认停稳进入DONE时启动，主循环计时500ms关闭，不调用HAL_Delay，不阻塞STOP或控制任务。长时间停在DONE不会反复提示；STOP、OFF、新运动或重新CAL会取消仍在进行的提示。

```text
DPI ... ST=RUN   M=DIST ... S=... SL=... SR=... G=1000 SIG=0
DPI ... ST=BRAKE M=DIST ... S=... SL=... SR=... G=1000 SIG=0
DPI ... ST=DONE  M=DIST ... S=... SL=... SR=... G=1000 SIG=1
DPI ... ST=DONE  M=DIST ... S=... SL=... SR=... G=1000 SIG=0
```

S/SL/SR/G单位mm；M=DIST共用于两种定距命令，以G=200或1000区分。SIG=1是软件声光输出活动标志，不证明实物灯和蜂鸣器确实工作。DPI约400ms一帧，HDG约1秒一帧；满发送队列可能丢日志，但不等待日志发完才停车。最终S包含制动后的编码器增量，可能略大于1000mm；实际距离仍待未来尺测。

## 后续有合适场地时

选择可连续前进至少1.5米的平整场地，标定同一车体参考点。OFF静止CAL到READY，再ON等1秒，发送一次GO100。观察直行、末段减速、停稳及一次声光，之后OFF并保存实际距离、偏向和日志。该步骤留待后续，不是现在继续开发的前置门槛。

## 接入与验证证据

只更新Core/Inc/dual_pi_test.h与Core/Src/dual_pi_test.c；main、GPIO/MPU/异步UART、CubeMX与构建配置未修改。主机模拟覆盖GO100独立参数、起步与末段目标、里程门槛、200ms停稳、完成一次提示/取消/500ms结束、计时回绕、超时故障、双串口STOP优先及RUN/BRAKE保护，并运行原GO20/GO/手动回归。完整临时及现场ARM编译链接成功，FLASH28036B、RAM4128B，只保留原main unused警告。本地串口记录工具GO100白名单与伪终端自检通过，未打开真实串口或蓝牙。

旧版备份：[1米接入前源码和完整构建](/Users/mzh/Desktop/车车/output/固件备份/Sunward_1米接入前备份_2026-10-10_o1d1gglg)。本包HEX SHA256：`5b35c4b6f896b13a3e54b9e8ce4a10b1bc5b11e81c3be3674aec5c8c6c79a454`。具体证据见本包主机验证.txt、临时编译验证.txt、现场编译验证.txt、接入差异.patch和接入记录.json。

## GO100第二趟结果（2026-10-11 16:05）

[本次日志](/Users/mzh/Downloads/records-2026-10-11-16-05-47.json)显示重新CAL成功、起步渐增、末段减速及BRAKE→DONE，最终S=1001mm（SL=1002、SR=1000），SIG=1→0，RXE/TXD=0，无故障。命令到首次DONE日志约10.46秒。用户确认尺测102cm、肉眼无偏移、自动停下、灯和声音都有；本趟可记为直行停车声光初步成功。实际比目标多约2cm，比编码器估算多约1.9cm；先保持参数，同一起点和参考点再做两趟确认重复性。先前右偏原因未唯一确认，独立按键启动尚未接入，完整路线验收仍未完成。

## GO100第三趟结果（2026-10-11 16:18）

[日志](/Users/mzh/Downloads/records-2026-10-11-16-20-42.json)：本次CAL约7.2秒至READY，后续一直READY；GO100约10.48秒至首次DONE报告，最终S=1001mm，SIG=1→0，无故障。用户尺测101cm并确认无明显偏向、自动停车、声光都正常。前一趟102cm、本趟101cm，已有两趟连续正常；先保持参数，同一起点/参考点再一趟确认三趟连续正常。未重启且READY时无需重复CAL。此前CAL一直NONE的原因不在本次成功日志中，尚未唯一确定；完整路线及独立启动未全部验收。

## GO100第四趟及三次距离汇总（2026-10-11 16:23）

[本次日志](/Users/mzh/Downloads/records-2026-10-11-16-24-20.json)：CAL到READY，GO100起步渐增、末段减速、BRAKE→DONE/SIG=1→0，最终S=1001mm，无故障，命令到首次DONE报告约10.39秒。尺测102cm，用户确认自动停车和声光正常；最新补充为轻微右偏，起始摆放角度影响未排除。最近三趟尺测102/101/102cm，日志S均1001mm，用时约10.4秒，停车声光均确认正常。定距停车声光与距离重复性初步成立；不把本趟写成完全无偏移，不将覆盖B或独立启动等未验证项标成通过。先保持参数，暂停追加同类GO100短跑，下一项接独立按键启动。

## 当前后续版本：按键独立启动（2026-10-11）

实际工程的当前HEX已更新为[按键启动版](/Users/mzh/Desktop/车车/output/固件接入包/T10_按键独立启动接入包/Sunward.hex)，与本T09目录的旧HEX不同。本目录原版本和历史场地结果继续保留；最新操作以[按键启动说明](/Users/mzh/Desktop/车车/output/固件接入包/T10_按键独立启动接入包/按键启动操作说明.md)为准。OFF短按KEY_U校准，LED1常亮后ON等1秒再短按启动GO100；运行中再按停车。软件验证和完整ARM编译通过，未代为烧录或实车验收。OLED未接入，原运动参数保持。
