Mu-Miao/Sunward_Data/output/固件接入包/T09_20cm定距接入包/T09_第二步_20cm定距停车.md

# T09第二步：航向保持＋20cm定距停车

2026-10-10。承接已确认的桌面GO航向短跑：重新CAL成功、无明显偏向、正常停车。当前保留60mm/s基速、P32/I20、航向差速增益及1800输出上限，新增`GO20!`。

GO20每次以新的编码器起点累计左右轮距离，取两轮平均作为车体驱动轴中点的里程估计；保持启动时朝向，接近200mm时减速，到达后制动并确认停稳。距离来自当前CPR和65mm初始轮径换算，实际车身位移仍用尺测，打滑与滚动周长误差会影响精度。

已接入Sunward，主机控制模拟及临时/现场完整ARM编译链接均通过（FLASH27400B、RAM4112B），仅保留原main unused诊断警告。本阶段历史固件：[Sunward.hex](/Users/mzh/Desktop/车车/output/固件接入包/T09_20cm定距接入包/Sunward.hex)；工程当前HEX已更新为支持GO100的一米版本，参见[后续操作](/Users/mzh/Desktop/车车/output/固件接入包/T09_1米直行接入包/T09_第三步_1米直行与声光.md)。历史HEX的SHA256为`6c5eac8ee15f2c3b322d772935c346a4717485b46cc8ad7f64b180d28b5951a6`。未烧录、未开真实串口/蓝牙、未启动电机。旧版备份：[定距接入前源码与构建](/Users/mzh/Desktop/车车/output/固件备份/Sunward_定距接入前备份_2026-10-10_qaedayck)。

现场只更新dual_pi_test.h/.c，main、MPU驱动、串口异步驱动、CubeMX配置保留。本地USB串口工具已支持GO20!，伪终端验证通过；也可用原蓝牙文本助手。

## 这次先做一趟

1. 使能OFF，下载本包新版HEX。启动提示应新增`GO20!=heading200mm`。本次需要新固件；原航向版只有GO三秒功能。
2. 用原文本串口或蓝牙助手连接，关闭循环发送。车放平、使能OFF，发送一次`CAL!`，保持静止直到`HDG YC=READY N=500`；通常约7～8秒。此前成功的校准在重新启动后需再做。
3. 选择平地或足够宽的桌面，车头前方至少留50cm连续可行驶空间。用尺记录一个固定车体参考点的起始位置；测终点时用同一个参考点。摆好车头朝向。
4. 使能ON，等1秒，只发送一次 **`GO20!`**。日志应出现`M=DIST G=200`，S开始增加。先前的GO!仍是三秒短跑，此步使用GO20!。
5. 观察自动前进、接近终点降速、停车。看到`ST=DONE`后使能OFF，量实际位移，保存日志。明显抖动、偏转或不动时用STOP!或实体OFF结束，保留日志。

这次按里程结束，不能按3秒判断完成；正常用时由实际轮速和减速过程决定，驱动阶段最长10秒。先报告：`实测__cm；偏左/偏右/不明显；有/无抖动；正常停车/异常；最终S=__mm。`

## 程序怎样计算和停车

```text
左轮距离 += TIM8有符号增量 × 周长 / 左CPR
右轮距离 += -TIM4有符号增量 × 周长 / 右CPR
里程 S = (左轮距离 + 右轮距离) / 2
剩余距离 = 200mm - S
```

只有本次启动后的增量进入该任务；不将启动前的轮子移动、上次里程或反向计数绝对值算成前进距离。16位编码器回绕按原delta16处理，左右CPR分别使用现有值。

剩余大于等于40mm时保持60mm/s基速；进入最后40mm后按剩余距离下调到最低40mm/s。低速下差速限幅随基速同比缩小，航向仍参与，两轮目标保持前进。最低基速40是本版初始试调值，用于避免目标趋零后停在终点前；真实低速表现待本轮确认。

S达到200mm后，立即制动并清两组积分，进入BRAKE。继续累计制动后编码器位移，直到两轮速度均在±5mm/s内持续200ms，才锁存DONE与最终里程。制动后最终S可能略大于200mm，用它和尺测距离一起判断停车误差。

## 日志字段和异常状态

| 字段/状态 | 含义 |
|---|---|
| M=DIST | GO20定距任务 |
| G=200 | 目标200mm |
| S / SL / SR | 本次平均/左/右里程，单位mm，整数打印 |
| T | 当前基速，接近终点由60降至40；停车时0 |
| TL / TR | 航向外环实际给两轮的目标mm/s |
| ST=BRAKE | 已制动，正在确认停稳；该状态很短，400ms日志可能没有打印到 |
| ST=DONE | 距离到达且停稳确认通过；最终S/SL/SR保留 |
| ST=TIMEOUT | 10秒内未完成距离，停车，不算成功 |
| ST=SETTLE | 制动后1.5秒仍未确认停稳，停车，不算成功 |

GO20期间DPI每400ms打印一次，HDG仍每秒一次，兼顾9600波特率蓝牙容量。V/SEC仍是手动配置，不改变GO20目标和超时。看见S=200这一条整数打印不等于达到精确触发点，程序内部用未取整的浮点里程判断。

每次重新GO20清本次里程与PI积分并保存当前朝向；重复发送不会清零里程或延长时限，BRAKE期间运动命令被忽略，不自动排队重启。STOP、实体OFF、串口接收故障以及原低压/ADC/GAP/REV/FAST/STALL/YAW保护保留。漏拍或不可信的异常计数不能触发正常完成；GO20前必须READY，启动/Reset不自动行驶。原RUN、GO三秒以及手动F/B/L/R命令仍可使用。

## 怎样评价这一轮

保存最终估算S、尺测位移、偏向、平顺和停车现象。第一趟不编造固定的厘米误差合格线；若实际距离明显偏离估算，再区分轮周长、打滑与制动超程，调整有证据的参数。桌面数据与瓷砖数据分别记录。

本步验证短距离累计、终点减速和停车。A→B的目标长度、端点覆盖、声光、独立启动和15秒路线验收在后续完成。

## 首次日志结果（2026-10-10 00:40）

[本次日志](/Users/mzh/Downloads/records-2026-10-10-00-40-37.json)显示CAL完成至READY N=500，GO20以M=DIST运行，目标由60降至58再到40mm/s，随后BRAKE→DONE，两轮速度/输出/积分归零。最终估算S=201mm（SL=202、SR=201），无故障状态及RXE/TXD计数。运行中的4条HDG航向误差在-0.46°～+0.24°，打印稀疏不能当成全程最大误差。用户补充本轮在桌面，尺测约20.2cm：比目标约多2mm，比编码器估算约多1mm。近似读数含尺测误差，一趟不据此修改轮周长或制动参数。桌面20cm定距功能初步通过；偏向/抖动及实车停止观察尚未单独补充，日志停车状态正常。
