Mu-Miao/Sunward_Data/output/固件接入包/T09_航向保持接入包/T09_第一步_航向保持3秒.md

# T09第一步：保持启动时朝向，低速走3秒

2026-10-09。用户决定结束追加速度复测，进入自动直行。已有桌面带载证据：60mm/s、3秒，距离约15.6cm、无明显偏向，首次无抖动、自动停车。瓷砖地板与不同目标验收暂缓，按低速开发继续。

本步新增航向外环：`CAL!`静止校准；`GO!`保存启动时朝向，以60mm/s基速运行3秒。航向参数为初始试调值，真实纠偏效果待上板验证。本步按时间结束；下一步接编码器里程和终点减速，不将本版写成定距停车或A→B已完成。

已接入Sunward并完整ARM编译链接通过（FLASH26136B、RAM4080B），主机控制模拟通过。新固件：[旧航向版Sunward.hex](/Users/mzh/Desktop/车车/output/固件接入包/T09_航向保持接入包/Sunward.hex)，（当前工程HEX已更新为GO20版）；SHA256为`4f0a2421f4dcd54a5f7bfc522e31b7177610abd1cefff5fc508d71f69d6565ab`。未烧录、未打开真实串口/蓝牙、未启动电机。备份：[航向接入前完整构建及原文件](/Users/mzh/Desktop/车车/output/固件备份/Sunward_航向接入前备份_2026-10-09_jfu72yno)。完整构建仅保留原main的unused诊断警告。

本地串口记录工具也已支持CAL/GO，并通过伪终端验证；使用USB时可启动[本地串口工具](/Users/mzh/Desktop/车车/output/调试工具/本地串口记录工具/打开本地串口.command)。蓝牙沿用能发文本命令的助手。

**2026-10-09实物更新：** [23:32日志](/Users/mzh/Downloads/records-2026-10-09-23-33-09.json)重发CAL后成功READY N=500，零偏-403.44 raw，IO_US2903～2905。GO运行期间M=HEAD、目标出现59/61的小差速，随后DONE/清积分/轮速归零；用户确认桌面运行无偏向、正常停止。开始记录时已存在的FAIL N=298没有触发瞬间数据，旧原因未唯一确认；本次成功运行后保持当前参数，下一步接定距停车。

## 原理：给现有轮速环一个小差速

MPU6050以Z轴测偏航、左转为正，当前量程±250°/s、灵敏度131。500次静止采样得到本次零偏，再按实际采样时间积分相对角度。

```text
航向误差 = 启动时朝向 - 当前朝向（取±180°的最短差）
差速 C = 1.0 mm/s/度 × 航向误差，限幅到±15mm/s
左轮目标 = 60 - C
右轮目标 = 60 + C
```

车头偏左：当前角度增大，误差/C为负，左轮请求更快、右轮更慢，向右修正；偏右时反过来。两轮目标范围45～75mm/s，保持前进，输出仍限1800，轮速PI仍P32/I20。

本步直接使用“轮速差/角度”的P增益，单位为mm/s/度；没有用猜测轮距换算车体角速度。后续量两驱动轮接地中心之间的轮距后，可按手册的角速度形式换算。

## 这次一起做这一趟

1. 使能OFF，下载本包新固件。旧版没有CAL/GO功能；下载后确认启动提示包含`CAL!=OFF/still; GO!=heading60/3s`。可用原有文本串口或蓝牙助手，关闭循环发送。WASD仍用于原手动命令，此步通过文本助手发命令。
2. 小车放平、保持静止，使能继续OFF，单次发送`CAL!`。预热2秒，再采500次约5秒；期间不碰车、不拉线、不拨ON。
3. 等到日志`HDG YC=READY N=500`。若YC=FAIL，保持OFF、静止，重新发CAL；YC=NONE说明未开始或已取消。YC未READY时GO不会启动。
4. 朝向前方空地，至少留50cm，将使能ON，等1秒，单次发送`GO!`。车以启动时的朝向为目标向前，约3秒后自动停；日志应为`M=HEAD`，TL/TR可随纠偏在45～75变化。手动V/TIME配置不改变GO的60mm/s基速和3秒时限。
5. 若明显转向、抖动或不动，用STOP!或实体OFF结束。正常结束后OFF，保存日志，记录实测距离、偏向及是否平顺/自动停。

初次GO只需这一趟。可在同一块瓷砖上选平整路径；如果跨缝，记录跨缝情况，便于解释短时轮速或角度变化。不要人为挡轮或在运行中用手强扭车头。

## 日志怎样读

DPI保留原有格式，M=HEAD表示本步；TL/TR为左右实际请求的目标，L/R为反馈轮速，UL/UR为轮速PI输出。HDG每秒打印一次，避免增加9600波特率蓝牙的持续发送负担。

| HDG字段 | 含义 |
|---|---|
| YC | NONE未校准、WARM预热、CAL采样、READY可用、FAIL校准/采样无效 |
| N | 校准样本数，READY应为500 |
| BZ100 | 本次GZ零偏×100，单位是原始计数；负号正常 |
| Y100 / E100 | 相对偏航角/航向误差×100，除100得到度 |
| C | 请求的差速mm/s，正数向左修正、负数向右修正 |
| IO_US | 最近一次MPU读取用时微秒 |

例如Y100=120表示相对左转1.20°；目标在0°时E100=-120，C约-1，左轮目标略高于右轮。GO每次重新保存当前朝向，不要求起点等于校准时的0°。

## 程序中的启动与停车边界

- 启动/Reset保持电机制动；不自动校准或运行。CAL仅在使能OFF且停车时接受，校准期间运动命令不会积压到校准结束后启动。
- 校准拒绝编码器移动、使能ON、三轴陀螺仪明显波动；恒定缓慢转动仍可能逃过波动判断，因此静止条件由操作保证。
- GO仅在已校准READY且停车时接受，重复GO不延长3秒。运行时切换到原手动命令沿用200ms制动；STOP与串口接收故障优先。
- MPU读取失败、饱和、读取超过5ms或采样间隔异常使航向失效；航向模式下停两轮。偏离目标超过20°也停止，DPI显示ST=YAW。控制漏拍仍报GAP。
- 软件I²C读取在主循环内完成，读取后再次检查实体使能再提交电机输出；原低压/ADC/反向/异常速度/堵转/串口故障停车保留。
- MPU初始化失败时GO不可用，原RUN/F/B/L/R仍可使用。蓝牙断线没有新增专用检测，GO的3秒时限和实体OFF沿用。

电脑模拟和ARM编译证明程序逻辑与构建通过；实际I²C耗时、控制节拍、纠偏方向和地面表现由本次上板日志确认。首次出现GAP/YAW时保存日志，先看DT/IO_US/YC，不增大输出强行运行。
