Mu-Miao/Sunward_Data/output/固件接入包/T10_按键独立启动接入包/按键启动操作说明.md

# PA0按键独立校准与启动

2026-10-11。按用户最新要求先交付按键版，OLED留到后续。已修改实际Sunward工程并完整编译，通过软件模拟验证；未替用户烧录、按实物键或运行车辆。此前场地GO100尺测102/101/102cm及停车声光结果属于旧版，不能作为新按键功能的实物验证。

固件：[本版Sunward.hex](/Users/mzh/Desktop/车车/output/固件接入包/T10_按键独立启动接入包/Sunward.hex)，交付时与工程HEX一致；实际工程当前已更新为下述OLED试亮版本。使用板上的 **KEY_U（PA0）**，不是RESET。不需要额外接按键，不需要改CubeMX配置。

## 操作顺序

1. 实体使能开关保持 **OFF**，烧录本版HEX，上电或复位时松开KEY_U。
2. 车放稳，OFF状态短按并松开KEY_U。LED1开始慢闪，表示校准预热和采样；保持车静止约7～8秒，直到LED1常亮。常亮表示陀螺仪已校准（YC=READY）。
3. 把车对准前进方向，切到 **ON**，等约1秒，再短按并松开KEY_U。开始执行现有1米直行任务，运行时LED1熄灭。
4. 到目标后制动、确认停稳，LED1和LED2加蜂鸣器提示一次500ms；之后LED2和蜂鸣器关闭，LED1恢复常亮。
5. 运行中再短按KEY_U会停车；实体OFF和原STOP!也可以停车。一次按键仅触发一次，要稳定松开后才能再次触发。

ON本身不会启动；重新上电需重新校准。ON时未READY按键只记录WAIT，不会等待校准完成后自动行驶。OFF状态按键会重新校准；校准期间再次按键会取消校准（YC=NONE），要松开后在OFF重新按一次。若切到ON仍在校准，校准失败，不能启动。

## 灯与日志

| 情况 | LED1 | LED2 / 蜂鸣器 |
|---|---|---|
| 未校准，停车 | 熄灭 | 关闭 |
| WARM / CAL | 每250ms切换亮灭，完整周期500ms | 关闭 |
| READY且停车 | 常亮 | 关闭 |
| RUN / BRAKE | 熄灭 | 关闭 |
| 校准或陀螺仪FAIL，停车 | 每100ms切换亮灭，完整周期200ms | 关闭 |
| GO100正常完成提示 | 与LED2一起亮500ms，随后恢复READY常亮 | 亮 / 响一次500ms，随后关闭 |

LED1常亮只说明陀螺仪READY；低压、ADC故障等原保护仍可能拒绝启动。LED2和蜂鸣器仍只在GO100停稳完成时提示；提前按键停车不会鸣响完成提示。未校准或校准失败时保持OFF、放稳后重新按KEY_U。

原USB/蓝牙文本指令CAL!/GO!/GO20!/GO100!/RUN!/F!/B!/L!/R!/STOP!和V/TIME继续保留。新增短日志例如：

```text
KEY EN=0 RAW=1 ARM=0 EVT=1 ACT=CAL TASK=1
HDG YC=READY N=500 ...
KEY EN=1 RAW=1 ARM=0 EVT=2 ACT=START TASK=1
KEY EN=1 RAW=1 ARM=0 EVT=3 ACT=STOP TASK=1
```

EN=0/1分别表示实际使能OFF/ON；RAW是PA0原始电平，ARM表示是否已经稳定松开、允许新的按下事件；EVT是消抖后的有效按下次数；ACT是最近一次按键处理结果，BLOCK代表被条件或同批STOP/接收故障拦截。KEY日志约每秒一次，按键事件后提前报告，日志队列满不阻塞停车。TASK=1为当前固定的一米任务，没有新增任务2～4的选择或路线。

## 软件验证与备份

修改仅限Core/Inc/dual_pi_test.h、Core/Src/dual_pi_test.c。加入30ms按下/松开消抖、上电需先释放、长按不重触发、按住时切换使能不启动；校准和行驶中按键停车，两个串口STOP/接收故障优先。LED反馈在主循环中计时，不新增HAL_Delay或控制中断工作。

主机验证覆盖按键完整流程、WARM/CAL/RUN/BRAKE取消、抖动、长按、上电按住、使能切换、双串口优先级、低压/ADC/MPU门槛、满发送队列、毫秒回绕及自主按键GO100正常完成；同时运行既有GO20、GO100、航向和手动运动回归。临时目录及实际工程完整ARM编译链接成功，FLASH28960B、RAM4152B，仅有原main.c未使用实验函数/变量警告。main、GPIO、MPU、软件I2C、异步UART、.ioc和EIDE配置逐字节校验未变；速度、PI、航向增益和周长参数保留。

旧版源码和完整构建备份：[备份目录](/Users/mzh/Desktop/车车/output/固件备份/Sunward_按键接入前备份_2026-10-11_sv7o14_t)。若回退，可直接烧录备份original/build/Debug/Sunward.hex；若还要恢复工程源码，将original/Core/Inc/dual_pi_test.h和original/Core/Src/dual_pi_test.c复制回实际工程后重编译。

本版HEX SHA256：`c921090bcda3f98a541745def3f25d3100538d183d87388a6469f47c7c7e8e95`。

证据：[主机验证](/Users/mzh/Desktop/车车/output/固件接入包/T10_按键独立启动接入包/主机验证.txt)、[工程编译验证](/Users/mzh/Desktop/车车/output/固件接入包/T10_按键独立启动接入包/工程编译验证.txt)、[接入记录](/Users/mzh/Desktop/车车/output/固件接入包/T10_按键独立启动接入包/接入记录.json)、[源码差异](/Users/mzh/Desktop/车车/output/固件接入包/T10_按键独立启动接入包/接入差异.patch)。实车按键电平、独立启动、按键停车及新日志还待烧录后确认，不把编译成功当作现场通过。

## 现场反馈更新（2026-10-11）

按键版操作步骤交付后，用户反馈“可以 依旧是102cm 全程没有异常”。记为新版正常一米流程的初步现场结果，保持运动参数。此次没有附日志，也未单独回传中途按键停车、上电按住或长按的实物结果，不能把这些单项都写成现场已通过。下一项为OLED任务与状态显示；本包HEX仍为按键版。

## 后续版本：OLED试亮（2026-10-11）

当前工程HEX已加入OLED试亮驱动，使用[新固件及操作说明](/Users/mzh/Desktop/车车/output/固件接入包/T11_OLED试亮接入包/OLED试亮操作说明.md)。本T10目录仍保留原按键版HEX和102cm现场反馈。OLED新版本软件验证/编译通过，实物屏幕兼容与效果待确认。
