Mu-Miao/Sunward_Data/output/固件接入包/T12_半圆出口里程修正版/半圆出口修正操作说明.md

# 任务二：第一半圆出口里程修正版

用户实车反馈第一半圆结束持续停车，第三行`LOST BC T13.4`、第四行S1256。旧任务二用600×π≈1885mm作为半圆预期，出弧窗口1685～2085mm，1256不在窗口内；即使角度正确，全白也被当作中途丢线，100ms后LOST。旧配置主机已复现此路径。

本次只把任务二独立里程DPT_TASK2_ARC_MM校准为1256mm，出弧窗口1056～1456mm。旧配置复现样例在修正版成功进入CD并提示C；完整四段回归通过。两个半圆沿用对称假设，都使用1256mm。出口仍需全白30ms、预期终点方向±20°；此趟没有角度读数，现场能否通过所有条件仍待新固件反馈。

初次修复编译后，发现用户又自行将独立半圆DPT_LINE_MM由600×π改为400×π，并重新生成HEX。保留该最新修改；助手不再写工程源码，只验证最新源文件并全量重编译、同步产物。最终HEX与用户刚生成的HEX完全一致，SHA256 `0828a816bebb763748441aaa06e6b8968b11efb450d39d6b5e267cce6e126730`。此前用户说半径60cm，当前源文件改为400×π且出口里程1256与40cm半径相符；没有新的尺测半径，不能把这一推断写成实测结论。

巡航200mm/s、独立半圆起步50mm/s、增益64、差速80、PI、按键、任务一、OLED驱动和全部丢线/航向/电池/编码器/定时/串口/超时保护不变。没有安装此前暂停的轮速下限诊断包。

## 接下来

1. 保持OFF，烧录[本包Sunward.hex](/Users/mzh/Desktop/车车/output/固件接入包/T12_半圆出口里程修正版/Sunward.hex)，或[当前工程Debug固件](/Users/mzh/STM32Cube/Sunward/build/Debug/Sunward.hex)。若已烧录你最后一次400×π编译的相同HEX，不需要重复烧录。
2. OFF长按约2秒并松开，逐次选到`TASK 2 ONE LAP`。
3. 回A朝B摆正，OFF短按松手，静止等READY；拨ON稳定约1秒，再新短按启动。
4. 这一趟直接观察BC出口是否切CD、再接DA并回A停车。无需重测独立半圆。若仍停，照抄STATE/段名/时间及S；若完成，记录每点提示、最后停车位置和最终时间。

运行不用蓝牙，故障后新启动从AB开始，先回A再启动。异常优先按键STOP或OFF。整圈和30秒要求尚未实测通过，45秒是联调异常上限。

## 证据

主机复现旧版S1256/正确航向时LOST；修正版同样输入进入CD。最新用户400×π独立半圆版本的四段/四次声光/最终停稳、16码、无蓝牙三模式、原GO100/GO20/航向/手动、丢线/错航向/缺边沿、STOP/OFF/两端RX/MPU/FAST/GAP/LOW/ADC/STALL/REV/超时和时间回绕回归通过。ARM全量编译成功，FLASH34988B、RAM5360B，只有原main未使用警告。最终同步检查源文件、配置、HEX一致；没有代用户烧录或运行实车。

- [主机验证与旧配置复现](/Users/mzh/Desktop/车车/output/固件接入包/T12_半圆出口里程修正版/主机验证.txt)
- [最终ARM编译](/Users/mzh/Desktop/车车/output/固件接入包/T12_半圆出口里程修正版/工程编译验证.txt)
- [头文件差异：助手出口修正和用户400×π修改](/Users/mzh/Desktop/车车/output/固件接入包/T12_半圆出口里程修正版/源码差异.patch)
- [接入记录](/Users/mzh/Desktop/车车/output/固件接入包/T12_半圆出口里程修正版/接入记录.json)
- [修改前完整备份](/Users/mzh/Desktop/车车/output/固件备份/Sunward_出口里程修正前备份_2026-10-11_bck1ykba)
- [用户随后编译的构建备份](/Users/mzh/Desktop/车车/output/固件备份/Sunward_出口里程修正前备份_2026-10-11_bck1ykba/user_build_after_half_length_edit)
