Mu-Miao/Sunward_Data/output/固件接入包/T14_任务三接入包/任务三烧录操作说明.md

# 任务三烧录与操作

2026-10-11：已接入实际 `/Users/mzh/STM32Cube/Sunward`，保留模块化结构、任务一/任务二及原调参。完整ARM编译链接及整车主机回归/ASan/UBSan通过。FLASH 42324B，RAM 5520B；只有原main未用诊断函数/变量警告。尚未烧录或代操作车辆，现场表现待实测。

## 烧录文件

- 本包 `Sunward.hex`。
- 实际工程同一文件：`/Users/mzh/STM32Cube/Sunward/build/Debug/Sunward.hex`。
- SHA256：`b953aa908464f9eaac7e3bc48eacb9603a505b0b4380f9267edd7d6f0d127f39`。两处文件已核对一致。
- 接入前完整源码、工具、配置与Debug构建备份：`/Users/mzh/Desktop/车车/output/固件备份/Sunward_任务三接入前备份_2026-10-11_2coz7puq`。

## 按键操作

1. 重新打开Sunward工程使下载配置刷新，确认目标为Debug。电机使能OFF，烧录上面的新HEX，随后RESET。复位默认仍是任务一。
2. 将车放在A点，车头朝C斜线方向，保持OFF。长按PA0约1.5秒后松手，依次选择任务一→独立半圆→任务二→任务三；从复位起长按三次，直到OLED第一行显示 `TASK 3 AC CB BD DA`。每次长按后先松开。
3. 保持车辆静止和OFF，短按PA0并松手开始CAL，等待OLED `YC READY`。
4. 打开电机使能ON，等约0.2秒，再新短按PA0启动。路线自动执行AC→CB→BD→DA，在A停稳后声光。运行中新的按键按下或使能OFF均停车。

任务三有A启动提示和C/B/D/A四次到达提示，共5次。顶点衔接先停稳，再单轮前进转向；内侧轮目标为零并清掉本轮积分，另一轮仍执行原PI与保护。无需蓝牙参与正常任务选择、校准和启动。

初始车头必须朝C，模块会把启动时航向作为AC参考。任务三会在运行中改变方向；故障或完成后重新启动须重新回A摆车，而不是从停车点继续。

## 当前任务三参数

几何：AB=1000mm，半径400mm，AC/BD≈1280.6mm，α≈38.66°，弧段1256mm。斜线和巡线巡航200mm/s、起步50mm/s、转向60mm/s、捕获50mm/s，总超时40秒。保留原巡线增益64、差速上限80mm/s、左右PI与编码器参数。任务三独立参数在 `Core/Inc/car_config.h` 的 `DPT_TASK3_*`；窗口、转向/捕获距离仍是初版值。

C处左转对正右侧半圆，CB沿右侧半圆向上；B处左转对正BD；D处右转对正左侧半圆，DA回A。LF04纠偏反馈的左右/极性保持原来设置。

40秒包含加减速、顶点停稳、对正和捕获、最终停稳；超过则TIMEOUT停车。当前主机测试不能证明实物40秒达标、车身投影覆盖每个顶点或沿弧保持覆盖。两个方向的弧长、传感器偏置与转向位移仍需真实场地验证。

## OLED故障记录

第一行TASK3，第三行例如 `LOST CB T13.4s`，第四行例如 `P8 F7 S800 Y90`。停车时保留这些字段，可直接记录第三、四行来定位，不依赖实时串口。

| P状态 | 含义 |
| --- | --- |
| 0 | IDLE |
| 1 | 斜线AC或BD |
| 2 | 顶点停稳 |
| 3 | 转向对正 |
| 4 | 捕获入弧线 |
| 5 | 巡线半圆 |
| 6 | A最终停稳 |
| 7 | 完成 |
| 8 | 锁存故障 |

| F故障 | 含义 |
| --- | --- |
| 0 | 无 |
| 1 | 配置无效 |
| 2 | OFF/STOP或整车保护取消；具体原因看第三行 |
| 3 | 传感器/节拍/数值错误 |
| 4 | 40秒超时 |
| 5 | 直线/捕获航向超差 |
| 6 | 预期入口/出口缺失或捕获越界 |
| 7 | 半圆丢线 |
| 8 | 对正超时或位移过大 |
| 9 | 停稳超时 |
| 10 | 里程反向/异常 |

S是当前路线段的平均编码器里程，Y是当前相对航向角。P2/P3/P4衔接时S暂时包含顶点相关移动；进入新斜线/半圆后重新建立段基线。

## 软件验证证据

`installed_host_tests.txt`：实际CarApp和旧兼容接口下，任务一/二回归、四模式按键、任务三完整路线、五次声光、零目标轮清积分、不后退、STOP/OFF/RX/MPU/ADC/LOW/FAST/REV/STALL/GAP、丢线/转向/超时、重新启动、TX拥堵以及编码器/millis回绕通过。该测试注入模拟传感器和运动数据，不是物理动力学或场地验收。

`installed_arm_build.txt`：49个编译单元完整构建。

源码修改：新 `car_task3` 和 `car_task3_port`，接入 `car_route/car_app/car_button/car_line/car_wheel/car_ui/car_command`，新增独立配置和上下文、EIDE两个源文件及数学库。main、GPIO/MPU/UART驱动、ioc以及所有原有调参值已做字节/配置核对；没有改成自动开机运行。

## 下载文件修正（2026-10-11）

用户实测任务二长按又回任务一。复查发现实际Debug ELF仍不含任务三标识或符号；先前只比较HEX副本哈希不足以证明实际烧录产物包含新功能。本次对实际工程全量重建，将Debug STLink下载文件从自动选择改为 `build/Debug/Sunward.hex`，明确下载路径。新ELF含CarTask3_Start/Update，解码HEX含TASK3标题，objcopy导出的ELF闪存数据与HEX逐地址一致。新版HEX大小119136字节，校验记录见 `下载修正记录.json`。尚未代为烧录；该修正的实物切换仍待用户下载后确认。
