Mu-Miao/Sunward_Data/output/固件接入包/T18_任务三半圆加速隔离包/半圆加速修正说明.md

# 任务三半圆加速隔离修正

本趟用户反馈 `LOST CB T12.8s`、`P8 F7 S182`，并确认入弧后逐渐加速然后偏出黑线。按当前版本，F7是半圆中无有效线持续100ms；S182是入弧后约182mm，不满足出口窗口1056～1456mm，不能当作正常出弧。未保留停车瞬间探头图样，无法区分全白、全黑或不连续黑线；也不能仅凭这些字段认定加速是唯一物理原因。

## 核对与修正

上一版T17为解决40秒超时，将任务三共用加速斜坡从100提高到150mm/s²。虽未修改半圆巡航200mm/s，但入弧加速也受到影响。助手之前强调半圆巡航保持，却没有将加速参数分开，已向用户说明并修正。

本版新增 `DPT_TASK3_ARC_ACCEL_MMPS2=100.0f` 和独立核心配置字段，CB/DA只用该参数计算加速；AC/BD继续用原T17的150mm/s²。半圆起步50mm/s，从50加至200约1.5秒，恢复T16入弧斜坡；斜线保留240mm/s、转向保留80mm/s。

保留半圆巡航200、LF纠偏增益64/差速上限80、T16偏线捕获反馈、起始朝B自动转向、任务一/二/独立半圆参数。40秒总计时、丢线第一帧零输出及100ms锁存、80mm/4秒转向、60mm/2秒捕获和停稳门槛均保持。

## 软件验证

CB与DA分别模拟入弧1.01秒、S182、有有效线：修正后基础目标151mm/s，斜线同一时长201.5mm/s，证明加速相互独立。模拟无有效线第一帧双轮零输出，100ms锁存F7并保留S182；无效/非有限半圆加速参数拒绝启动。

实际CarApp与兼容入口任务一/二/三ASan/UBSan全套通过，包括完整路线、T16捕获修正、40秒超时、启停与保护。保持原假设140mm轮距的理想目标跟随模型：T16参数39730ms、本版33540ms；模型不含实车动力学与安装偏差，不能当作实测用时或轨迹验收。

49个编译单元全量ARM编译链接成功，FLASH42880B、RAM5528B，仅原main未使用诊断警告。实际ELF与HEX逐地址一致，实际与验证暂存HEX闪存内容一致，并确认不同于T17。源码清单、哈希与备份见 `安装记录.json`。

## 烧录

电机使能OFF，在原Sunward工程Debug目标编译/下载 `build/Debug/Sunward.hex`；本包 `Sunward.hex` 为同一副本。RESET，OFF下从默认任务一长按PA0约1.5秒并松手三次选任务三；A点朝B，静止CAL等 `YC READY`，ON等约0.2秒后短按启动。

OLED标题仍为 `TASK 3 AUTO START`，标题不能区分T15～T18，以本次新HEX为准。若后续正常运行仍停车，保留OLED第三/四行原样读数。

本轮未代烧录或操作车辆。此修正撤回影响入弧的加速变化，是否消除实车偏线尚待用户现场反馈。

新版HEX SHA256：`9ab71779c7bce68652ddd54ca961b4b409365df06979f6a27406297f976d691a`。修正前备份：`/Users/mzh/Desktop/车车/output/固件备份/Sunward_任务三弧线加速修正前备份_2026-10-11_9miju_39`。
