Mu-Miao/Sunward_Data/output/固件接入包/T22_任务四半圆轮速修正包/半圆轮速修正与烧录说明.md

# 任务四半圆轮速修正（2026-10-12）

本次用户实测：`LOST 1/4 CB T11.6`、`P8 F7 S174 Y17`；两页快照为 `LF1111 PRE1101`、`E-100 C-64 PRE1`、`T136/264 V121/222`。这些数字为本次现场反馈，不是软件模型输出。

## 证据与解释

F7表示已进入CB半圆后的持续无有效线100ms，不是起步捕获F6或整段超时F4。S174是CB最终停车段里程；Y17是第一次无效样本时锁存的角度。PRE1与PRE1101证明之前有过有效线，不能将这次归因于从未吃到黑线。

O1～O4原始图样1101仅O3为黑，既有物理左→右为O4/O3/O2/O1，因此黑线在偏左内侧，误差-1.00。C=-64与左右目标136/264一致，右轮更快、向左纠偏，符合CB左转；随后原始1111为全白。当前纠偏方向与译码一致，不改探头排列/电机方向/陀螺仪符号。

目标轮速差128mm/s，失线首次采样实测差101mm/s；平均目标200、实测171.5mm/s。此刻右轮目标264、实测222，存在跟随滞后。只有单个采样，没有PWM、积分/电池与整段轨迹，不能认定饱和、打滑、漂移、过冲或欠转是唯一根因，也不能把222mm/s当作硬件最高速度。降速是针对当前负担的保守调整，尚不是现场修复验收。

## 修改

只在CarTask4_Config覆盖半圆巡航200→160mm/s、半圆加速100→70mm/s²，独立宏DPT_TASK4_ARC_MMPS和DPT_TASK4_ARC_ACCEL_MMPS2。任务三仍200/100，任务四斜线240/150、转向80、捕获50保持。共享巡线增益64、比例差速上限80及捕获/出口/失线/STOP等门槛保持。

半圆基础速度达到160mm/s、相同E=-1时左右目标108.8/211.2mm/s；极端偏线限制为96/224mm/s，因此半圆内单轮最高目标280→224mm/s。降低绝对速度及入弧目标变化速度，保留原纠偏比例和方向。四圈/三次A接续/17次提示、160秒总保护及快照均保留。

## 验证与烧录

新增任务四第一/第二圈半圆回归，验证1.01秒起步基础速度120.7mm/s、巡航160、相同偏差目标108.8/211.2、极端差速上限224；验证首帧全白双轮零、100ms仍F7锁存新目标，以及任务三200/100不变。原八套ASan/UBSan回归与实际工程ARM50单元全量编译通过。假设140mm轮距的理想目标跟随四圈时间146040ms（旧133560ms），不含实车动力学/轨迹，不能据此认定160秒保护内必定跑完。

在原Sunward工程Debug目标下载 `/Users/mzh/STM32Cube/Sunward/build/Debug/Sunward.hex`；包内HEX为同一副本。新任务四标题 `TASK 4 ARC V2`。选择任务四、A朝B、OFF静止CAL、READY后ON等待约0.2秒并短按启动的流程不变。RESET后长按PA0约1.5秒并松手四次选任务四，从任务三只需一次。丢线时可OFF，先记录两页再RESET。

FLASH44508B/RAM5576B。实际ELF/HEX闪存逐地址一致、实际/暂存固件一致、确认不同于T21。HEX SHA256 `ead34d28ac26ba8d615bacd56ead0cf9d9f08de5a6b909310a823bbf4fcd40af`。修改前备份 `/Users/mzh/Desktop/车车/output/固件备份/Sunward_任务四半圆轮速修正前备份_2026-10-12__8c4tnsk`。Git改动保留未提交；未代烧录或操作车辆。
