Mu-Miao/Sunward_Data/output/固件接入包/T27_任务四容错增强包/任务四容错增强与烧录说明.md

# T27 任务四容错增强（2026-10-13）

用户报告改动前的小车代码已经能够完成任务四。本次以该版本为基准增加短暂扰动容错，不将本次软件验证当作新车架实测结果。

## GitHub 与本地版本核对

本次通过 `git ls-remote` 实时核对 [GitHub main](https://github.com/Mu-Miao/Sunward/commit/cc6c87400eda20d3bf08589f485aacec2f402ea4)，提交为 `cc6c87400eda20d3bf08589f485aacec2f402ea4`，标题“任务四”。修改前本地 HEAD 与其完全一致。本地原有 34 个未提交文件，经去除注释后的词法比较，与 HEAD 的程序内容一致，差异仅为中文注释。

T27 已接入 `/Users/mzh/STM32Cube/Sunward`。本次功能增强相对修改前本地版本涉及 10 个文件，原有中文注释保留。未新建 Git 提交，未推送 GitHub。因此核对时两者的运行逻辑一致，完成本次修改后本地增加了 T27 功能，GitHub 仍是原任务四。

## 具体行为

| 情况 | 原任务四 | T27 任务四 |
|---|---|---|
| 半圆中暂时无有效线 | 立即零输出，连续失线 100 ms 锁存故障 | 立即零输出，最多等待 200 ms |
| 失线后的有效读数 | 单帧有效即可恢复 | 必须连续有效 30 ms，且在原 200 ms 预算内完成确认 |
| 有效和无效读数反复跳变 | 有效一帧便重置失线计时 | 确认完成前不重置失线起点，全程保持零输出 |
| 恢复行驶 | 直接使用阶段当前速度 | 基础目标从最高 50 mm/s 起步，以 100 mm/s² 逐步恢复 |
| 明显偏到探头边缘 | 按原巡航目标纠偏 | 偏差绝对值达到 2 时，基础速度最高 120 mm/s；纠偏方向和差速比例保持 |
| 前进转向接近目标角 | 外轮目标固定 80 mm/s | 误差小于 15° 后逐渐降低，当前参数最低 35 mm/s；内轮目标仍为零 |

“200 ms 容错”是零输出等待预算，不是允许失线继续前进。持续失线、全黑和不连续黑线图样仍会停车锁存故障；不会自动转动搜线，也不会在故障后自动重跑。仅适合短暂读数扰动或停车过程中重新读到线；若车已真正离开黑线，仍需要排查机械安装、位置或控制参数。

任务三仍使用原 100 ms 失线门槛，恢复确认参数为 0，原有行为保留。共享单圈核心增加了可选的恢复确认字段，只有任务四启用。PI、编码器 CPR、轮周长及 LF04 映射没有重新标定；原任务四斜线 240 mm/s、半圆 200 mm/s 的正常巡航设置保留。

四圈计数、三次 A 点自动接续、固定 AC 航向、17 次提示、最终停稳、160 秒总保护，以及使能、按键 STOP、传感器、轮速、电压、串口和漏拍保护继续生效。容错等待不重置段里程、阶段时限或总时限。失线快照在恢复确认完成前保留，不被一帧有效读数覆盖。

所有容错初值集中在[实际工程配置](/Users/mzh/STM32Cube/Sunward/Core/Inc/car_config.h)，使用 `DPT_TASK4_` 前缀。更换轮胎、电机或探头安装位置仍需检查对应标定；这些初值尚未通过新车架的真实场地验证。

## 烧录与识别

实际工程生成的固件为 [Sunward.hex](/Users/mzh/STM32Cube/Sunward/build/Debug/Sunward.hex)，包内 [Sunward.hex](/Users/mzh/Desktop/车车/output/固件接入包/T27_任务四容错增强包/Sunward.hex) 是相同副本。选择任务四后标题为 `TASK 4 ROBUST V1`，任务三标题仍为 `TASK 3 CAP V2`。

按键操作沿用现有流程：使能 OFF，RESET 后长按 PA0 约 1.5 秒并松手四次选择任务四；A 点朝 B 摆放，OFF 静止短按校准，等待 YC READY；ON 后等待约 0.2 秒，再短按启动。真实场地安排好后再烧录和验证，本次没有操作车辆。

## 软件验证与备份

八套实际模块回归（CarApp 和兼容入口）均通过 ASan/UBSan。新增覆盖：超过旧 100 ms 的短暂失线后恢复、连续确认、读数跳变不续期、200 ms 边界、无效图样、恢复加速、快照保留、两侧边缘降速、转向降速、恢复期间保护优先级和毫秒计数溢出。既有四圈完成、圈间停稳、17 次提示及后续圈故障测试继续通过。

实际 STM32 工程 50 个编译单元全量构建通过，FLASH 45428 B、RAM 5608 B。暂存与实际固件的闪存数据完全一致；分别从 ELF 导出的 HEX 与交付 HEX 逐地址一致，`git diff --check` 通过。

假设轮距 140 mm、编码器理想跟随目标且使用理想航向的四圈模型，用时从 134190 ms 增加到 138430 ms，增加 4240 ms，仍在软件总保护范围内。这是转向降速的用时取舍，只反映软件调度，不证明真实车架的过冲、抓地、场地用时或稳定性。

修改前完整源码及 Debug 固件备份位于：

`/Users/mzh/Desktop/车车/output/固件备份/Sunward_T27容错增强前备份_2026-10-13_ycuca8b5/original`

备份保留改动前的中文注释、旧固件和 Git 差异。需要比较或回退时以该备份为基准；当前未提交的中文注释不能通过直接恢复 Git HEAD 全部保留。

HEX SHA256：`fafec61b8e87e71673f0fb81f0ded270b952d92e38d66627d227abced3a562ed`。

本次仅软件接入及编译验证：未烧录、未做实车测试、未提交或推送。核对、安装和测试证据见同目录的 `版本核对.json`、`安装记录.json`、`容错修改.patch`、`installed_host_tests.txt` 和 `installed_arm_build.txt`。
