Mu-Miao/Sunward_Data/output/固件接入包/T28_任务三四受限寻线包/受限寻线与烧录说明.md

# T28 任务三、四受限寻线（2026-10-14）

本次响应更换车架后的 BD 到 D 点漏线反馈，以及用户要求“1111 时尝试寻线，不要立即结束”。已接入当前 Sunward，修改前 T27 源码和 Debug 固件均已备份。未烧录、未操作车辆、未提交或推送 GitHub。

后续状态更新（2026-10-14）：用户要求先保存当前版本再改转向角度，T28 已提交并推送到 GitHub main 的 [6473002](https://github.com/Mu-Miao/Sunward/commit/647300237b77a8ed63d9c459ead725308eb5bc7e)。上文“未提交或推送”描述的是最初接入时的状态。之后本地进入 T29 转向余量版本，T28 作为修改前基准保留。

## 题目要求与本次故障

核对[比赛题目第二页“说明（4）”](/Users/mzh/Desktop/车车/资料/比赛题目/H题_自动行驶小车.pdf)：启动、停车及经过顶点时，车身地面投影必须覆盖顶点；圆弧行驶过程中，投影必须始终与圆弧重叠，投影脱离圆弧即失败。题目没有要求 LF04 探头每一帧都读到黑线。

因此，探头 `1111` 与整车投影离线不是同一件事。软件可以在短暂全白时尝试恢复，但不能仅凭编码器、航向或“后来又找到线”证明中途投影一直在线。恢复期间的实际投影覆盖仍需真实场地确认；本次不把恢复成功自动视作题目验收通过。

用户报告任务一、任务二能完成；任务三显示 `LINE BD T27.7s P8 F6 S1401 Y-141`，并确认从 D 点黑线旁边偏过去。当前映射中 P8 是故障状态，F6 是边界超限。BD 名义长度约 1280.6 mm，原末端上限为 1400.6 mm，S1401 对应斜线末端没检测到有效黑线。它不是第二半圆已经巡线后发生的 F7 失线；当时尚未成功进入 DA。

## 新增行为

### C/D 顶点附近没检测到黑线

正常情况下仍优先使用有效黑线确认顶点。名义斜线里程已到且仍全白时，先零输出，再在原顶点窗口内低速、仅向前转到下一半圆的切线方向。角度到位后两轮停稳 200 ms，才以 40 mm/s 沿预计弧线方向接近入口。

从搜索起点计，搜索最多 3 秒、平均编码器位移最多 80 mm；原斜线末端 `名义长度+120 mm` 上限也同时保留，最先触发的限制停车。转向和接近都算入同一搜索预算；航向偏离也会停止。仅得到连续有效黑线 30 ms 后才提示经过 C/D，并继续正常停稳、对正、入弧流程。没有“只凭里程就报告经过 D”的逻辑。

这是对“从黑线旁边偏过”的一次有界入口接近尝试，不是沿整条斜线任意摆动搜索；偏移过大或当前位置不合适仍可能找不到线。不得靠扩大无限搜索范围替代真实投影覆盖检查。

### 半圆中短暂全白

只有本半圆内已经有有效巡线记录，且当前确为全白，才允许桥接。基础速度 40 mm/s，使用最后一次已确认的纠偏方向和陀螺仪航向，按半径 400 mm 的已知弧线几何给出短程航向参考。真实控制中不使用测试模型的假设轮距。

每次桥接从第一次失线计时，最多 300 ms、20 mm 平均编码器位移，实际航向变化不超过 12°，任一上限触发即 F7 停车。20 mm 和 300 ms 是两个独立上限，40 mm/s 下通常先到时间上限。全黑、不连续黑线图样、没有本段有效历史，不授权正向桥接。

黑线重新出现时保持零输出确认连续有效 30 ms；确认后从最高 50 mm/s 开始逐步恢复。本次任务三也启用恢复确认。未确认的单帧图样不能续期，也不能替换最后一次可信纠偏方向。不会把 `1111` 伪造为有效黑线；故障锁存后不会自动重启。

### 转向衔接

任务三接近目标角时也逐步降低外轮速度；任务四保留 T27 的减速行为。C、B、D 转向后新增两轮停稳和航向复核，避免转向余动直接带入 BD 或入弧段。停稳中角度离开容差时重新对正，但原转向时间、里程预算不重置。

## 保留范围与显示

任务一、二的控制逻辑、轮周长、编码器 CPR、PI、赛道几何参数保持。任务三 40 秒、任务四 160 秒总保护，原声光次数、四圈计数、固定 AC 参考、使能、STOP、传感器、轮速、电池、串口及漏拍保护继续生效。恢复不请求轮子倒转。

选择任务三显示 `TASK 3 SEEK V1`；任务四显示 `TASK 4 SEEK V1`。搜索顶点期间显示 `SEEK C` 或 `SEEK D`，弧段桥接显示 `SEEK`，中间转向停稳显示 `WAIT`。P8/F6/F7 原编号保持，新增阶段编号为 P11（转向后停稳）、P12（顶点搜索）。

## 固件、验证和回退基准

实际固件：[Sunward.hex](/Users/mzh/STM32Cube/Sunward/build/Debug/Sunward.hex)。交付副本：[Sunward.hex](/Users/mzh/Desktop/车车/output/固件接入包/T28_任务三四受限寻线包/Sunward.hex)。仍在当前 Sunward 工程 Debug 配置下编译下载，按键选模式、CAL、使能和短按启动方式不变。

实际模块十套 ASan/UBSan 回归通过：原任务一/二、任务三/四旧保护配置，以及默认新寻线配置，均覆盖 CarApp 与兼容接口。新增验证包括默认任务三/四完成、D 漏线后寻回、找不到线不误报点位、转向移动时不进入下一段、航向复核、白线桥接、连续恢复确认、原计时预算、异常图样、无历史、单帧反向噪声、STOP/使能/传感器/串口/漏拍/总超时优先级。旧保护配置回归显式关闭新搜索参数，用于与原行为对照；默认新配置由 `test_seek` 独立覆盖。

实际 STM32 50 个单元全量编译通过；FLASH 47180 B、RAM 5656 B。暂存与实际闪存数据一致，ELF 导出的 HEX 与交付 HEX 逐地址一致，`git diff --check` 通过。既有理想目标跟随模型中的任务三为 35210 ms、任务四为 140950 ms；这两项使用无搜索事件的对照配置及假设 140 mm 轮距，仅证明软件时间预算，不能作为场地用时或投影验收依据。

HEX SHA256：`39c1800c812c830bad6bfeaf319f3eab732c1aae045ecca32b04232f84aad80a`。

修改前 T27 完整备份：

`/Users/mzh/Desktop/车车/output/固件备份/Sunward_T28受限寻线前备份_2026-10-14__mppjzp1/original`

具体源码修改、备份和校验见 `容错修改.patch`、`install_manifest.json`、`安装记录.json`、`installed_host_tests.txt`、`installed_arm_build.txt`。这些结果是软件验证，新车架上的寻线方向、位置偏移、连续投影覆盖及完成用时仍需现场确认。
