Mu-Miao/Sunward_Data/output/车架模型/车架建模_v19/设计说明_v19.md

# V19：保留两层架构，增加 DC 插头及走线空间

用户确认插头插好后向上露出约 12 mm，电源线长 250 mm。按新电池图纸将电池尺寸更新为 24 × 88.6 × 61.6 mm，88.6 mm 横跨左右、61.6 mm 竖直，DC 插孔朝上并朝 Y 负端。电池仍靠上下反向槽固定，无绑带，两个打印件。

## 为什么 V18 不能直接使用

V18 用 30 × 90 × 60 mm 占位电池，上槽顶间隙只有 0.6 mm。实际电池高 61.6 mm，且插头再高 12 mm，会碰上槽和 C10B。旧位置下，按直径 14 mm 占位的插头与 C10B 实体检测到交叠；仅开线孔不能解决这个问题。

V19 保留底板平面、轮胎、电机、主支撑和主板平面位置，仅更新实际电池槽、上托板开口和主板支撑高度。

## 调整后的尺寸

| 项目 | V19 |
|---|---|
| 电池模型 | 24 × 88.6 × 61.6 mm |
| 电池槽内腔 | 25.2 × 89.8 mm，每侧名义间隙 0.6 mm |
| 下槽 | 20 mm 深，电池底面 Z22，槽口 Z42 |
| 上槽 | 包住电池顶部 16 mm，槽口 Z67.6，槽顶 Z84.2 |
| 电池顶面 / 插头顶面 | Z83.6 / Z95.6 |
| 上托板 | 平板厚 6 mm，底面 Z84，顶面 Z90 |
| 插头开口 | 18 × 26 mm，中心 X−20、Y−38；上槽端部也打开 |
| 四根主铜柱 | 仍是柱身 80 mm |
| 四根 C10B 铜柱 | 柱身改为 20 mm，可 10+10 mm 叠接 |
| 下底板打印包络 | 110 × 130 × 42 mm |
| 上托板打印包络 | 82 × 128 × 22.4 mm |
| 整车轮胎外侧跨度 | 200 mm |
| 含预留 35 mm 外伸的前后长度 | 145 mm |
| 轮胎接地处至 C10B 最高点 | 130.4 mm |

以底板下表面为 Z0、模型地面 Z−8。上槽仍有 0.6 mm 顶间隙，插头穿过新增开口。上板加厚到 6 mm 后，两个位于电池投影内的 C10B 固定螺丝头仍可藏进直径 6.6 mm、深 3.2 mm 的凹槽，凹槽上方约剩 2.6 mm 材料。

## 电源线怎么走

电源线先从顶部的插头开口出来，在 C10B 下方弯向侧边，再从板边接到 C10B。原有两条走线长孔保留；插头无需硬挤过原来的小孔。红色曲线只显示绕开主板的参考线路，不是实测线束，也没有指定主板供电端子的实际位置。

参考线路段约 56.1 mm（5.6 cm），用户 250 mm 电源线还留约 194 mm 可用于连接供电端、调整走向及留松弛量。模型中按电线直径 2.4 mm、弯曲半径 6 mm 占位，实际线径、护套和允许弯曲半径没有实测。插头直径暂按 14 mm，12 mm 露出高度由用户提供。

电池插孔中心位置在图纸里没有标尺寸：先按距 88.6 mm 长边端部约 8 mm、厚度方向居中设置，即 X−20、Y−36.3。将有插孔的一侧朝上、靠 Y 负端，避开 Y 正端附近的主板固定柱。孔位及插头宽度需试装校对，不能将图中估计的 8 mm 当成厂家标注值。

## 几何与打印检查

模型保存后重新打开，所有形状有效；整车零件没有检测到体积交叠。按上述参考尺寸，插头到 C10B 的最小间隙约 8.34 mm，参考电线到 C10B 约 2.07 mm。四主柱到轮胎约 8.82 mm、到输出轴约 24.16 mm、到电机约 8.45 mm；底板到轮胎约 5 mm。

实际 C10B 原几何体积和面数保持，四个 PCB 孔中心不变。两件独立 STEP 均读回确认一个有效实体；STL 为封闭网格，打印底面 Z0。上板文件已翻为平板朝下、槽口朝上。插头、电线是装配参考零件，不打印。

插头位置、宽度、真实电线、接线端子及延长板外伸尚未完整实测；上述是 CAD 检查，不是实物装配或振动验收。先核对电池及插头、再试装槽口，不可压紧电池。

## 保留项与文件

底板主支撑孔、钢电机支架四孔、两条 40 × 3.4 mm 侧槽、车头延长板安装槽、后轮位置和 LF04 模块位置均沿用。原 V18 保留在历史版本，打印说明明确本版 C10B 铜柱为 20 mm。

更新脚本从历史 V18 读取。手工修改后请另存版本；重新运行会重建 V19。
