Mu-Miao/Sunward_Data/output/README.md

# 成果目录

- `车架模型`：当前 V19、历史模型、打印交付、项目压缩包和设计演示。
- `固件接入包`：9.5、MPU6050 和 T08…T26 各阶段接入资料。
- `固件备份`：Sunward 历史备份，内容保持原样。
- `调试工具`：WASD、串口记录、蓝牙串口工具。

常用文件入口见 [项目导航](../项目导航.md)。
