Mu-Miao/Sunward_Data/output/车架模型/README.md

# 车架模型

当前版本：**V19，上下电池槽及插头避让**。

- [FreeCAD 工程](车架建模_v19/car_assembly_v19.FCStd)
- [打印 ZIP](打印交付/发给打印同学_v19.zip)
- [装配预览](车架建模_v19/后侧效果图_v19.png)
- [上下槽剖面](车架建模_v19/电池上下槽剖面_v19.png)
- [设计说明](车架建模_v19/设计说明_v19.md)

`历史版本` 保存 V7…V18；`打印交付/历史版本` 保存旧打印包；`项目压缩包` 保存项目 ZIP；`设计演示` 保存装配动画。
