Mu-Miao/Sunward_Data/车车项目首页.md

---
tags:
  - 车车
  - 项目
created: 2026-10-14
---

# 车车项目首页

> [!info] 项目资料库
> 当前资料库直接使用 `/Users/mzh/Desktop/车车`。文档、实验记录、固件资料和车架附件均来自原项目；在 Obsidian 编辑笔记会保存到对应的项目文件中。

从本页进入各项资料，或通过快速切换（⌘O）查找笔记。PDF 和图片可在 Obsidian 内查看；FreeCAD、Excel、ZIP 等链接交给系统默认应用打开。

[[项目导航|原项目导航]] · [[小车调试实测记录_2026-10-07|完整调试实测记录]]

> [!note] 进度判定
> 接入包、编译校验、烧录和实车测试分别记录；各项任务的实际完成情况以实测记录中的对应章节为准。

## 最新车架：V19，上下电池槽及插头避让

- [打开 V19 FreeCAD 工程](file:///Users/mzh/Desktop/%E8%BD%A6%E8%BD%A6/output/%E8%BD%A6%E6%9E%B6%E6%A8%A1%E5%9E%8B/%E8%BD%A6%E6%9E%B6%E5%BB%BA%E6%A8%A1_v19/car_assembly_v19.FCStd)
- [发给打印同学的 ZIP](file:///Users/mzh/Desktop/%E8%BD%A6%E8%BD%A6/output/%E8%BD%A6%E6%9E%B6%E6%A8%A1%E5%9E%8B/%E6%89%93%E5%8D%B0%E4%BA%A4%E4%BB%98/%E5%8F%91%E7%BB%99%E6%89%93%E5%8D%B0%E5%90%8C%E5%AD%A6_v19.zip)
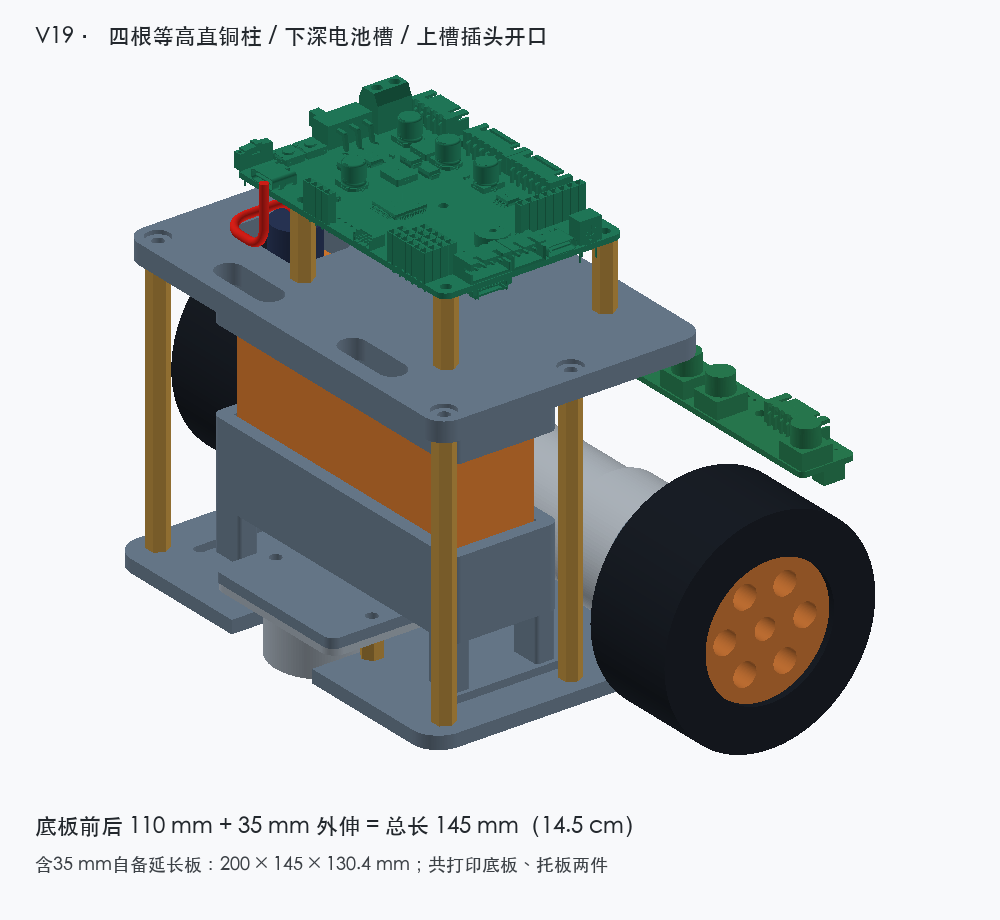
[picture p1: output/车架模型/车架建模_v19/后侧效果图_v19.png]
整车装配预览
- 
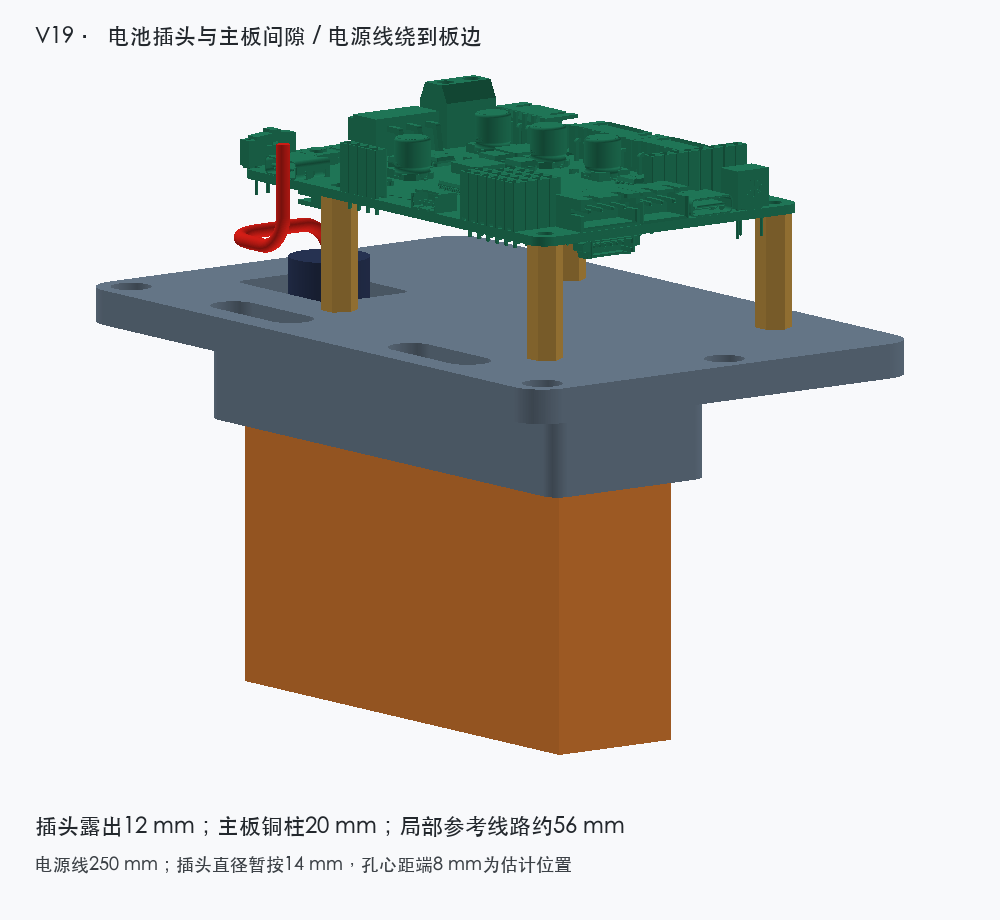
[picture p2: output/车架模型/车架建模_v19/电源插头走线_v19.png]
插头与电源线局部预览
- 
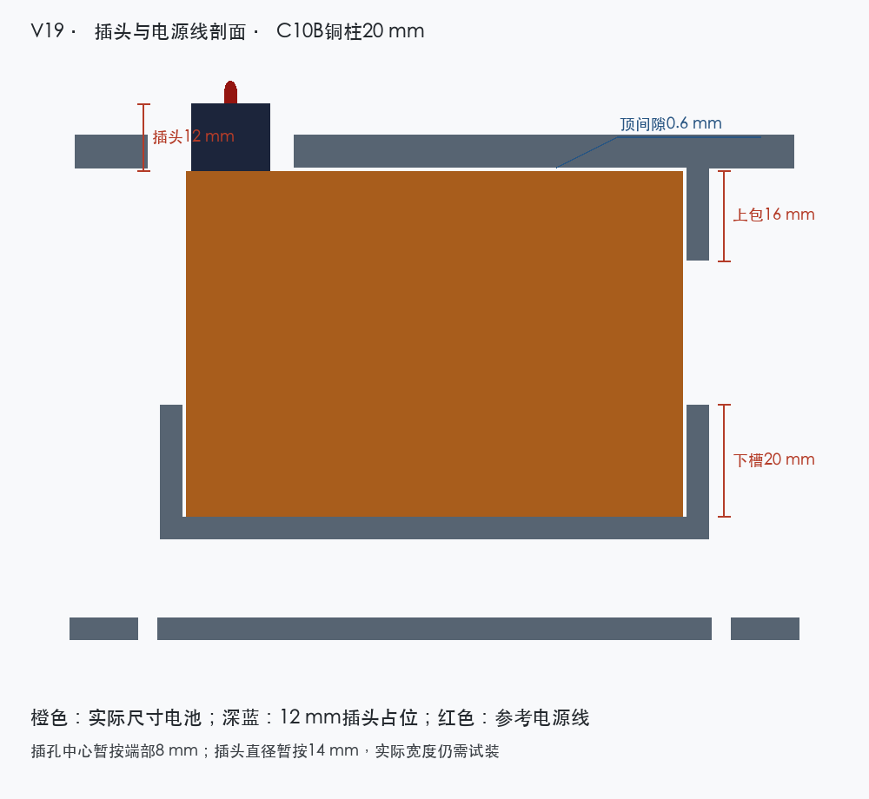
[picture p3: output/车架模型/车架建模_v19/电池上下槽剖面_v19.png]
上下电池槽剖面
- 
- [[output/车架模型/车架建模_v19/设计说明_v19|设计说明]]
- [打印说明](file:///Users/mzh/Desktop/%E8%BD%A6%E8%BD%A6/output/%E8%BD%A6%E6%9E%B6%E6%A8%A1%E5%9E%8B/%E8%BD%A6%E6%9E%B6%E5%BB%BA%E6%A8%A1_v19/%E6%89%93%E5%8D%B0%E8%AF%B4%E6%98%8E_v19.txt)
- [完整 V19 项目压缩包](file:///Users/mzh/Desktop/%E8%BD%A6%E8%BD%A6/output/%E8%BD%A6%E6%9E%B6%E6%A8%A1%E5%9E%8B/%E9%A1%B9%E7%9B%AE%E5%8E%8B%E7%BC%A9%E5%8C%85/%E8%BD%A6%E6%9E%B6%E5%BB%BA%E6%A8%A1_v19_%E6%8F%92%E5%A4%B4%E8%B5%B0%E7%BA%BF%E9%81%BF%E8%AE%A9.zip)

V19 需要打印下底板、上托板各一件；主铜柱柱身 80 mm，C10B 铜柱柱身 20 mm。按目前模型，轮胎外侧跨度 200 mm，含预留 35 mm 外伸的前后长度 145 mm，高度 130.4 mm。实际装配间隙仍需试装确认。

旧版本在 `output/车架模型/历史版本`，旧打印包在 `output/车架模型/打印交付/历史版本`。以后新增车架版本请放入 `output/车架模型`，打印 ZIP 放入 `打印交付`，旧版移到相应历史版本目录。

### V19 预览

![[output/车架模型/车架建模_v19/后侧效果图_v19.png]]

![[output/车架模型/车架建模_v19/电池上下槽剖面_v19.png]]

## 资料与文档

- [[资料/比赛题目/H题_自动行驶小车.pdf|比赛题目]]
- [元器件清单](file:///Users/mzh/Desktop/%E8%BD%A6%E8%BD%A6/%E8%B5%84%E6%96%99/%E5%85%83%E5%99%A8%E4%BB%B6%E6%B8%85%E5%8D%95.xlsx)
- [[资料/主控板/C10B主板原理图_2025-02-24.pdf|C10B 主板原理图]]
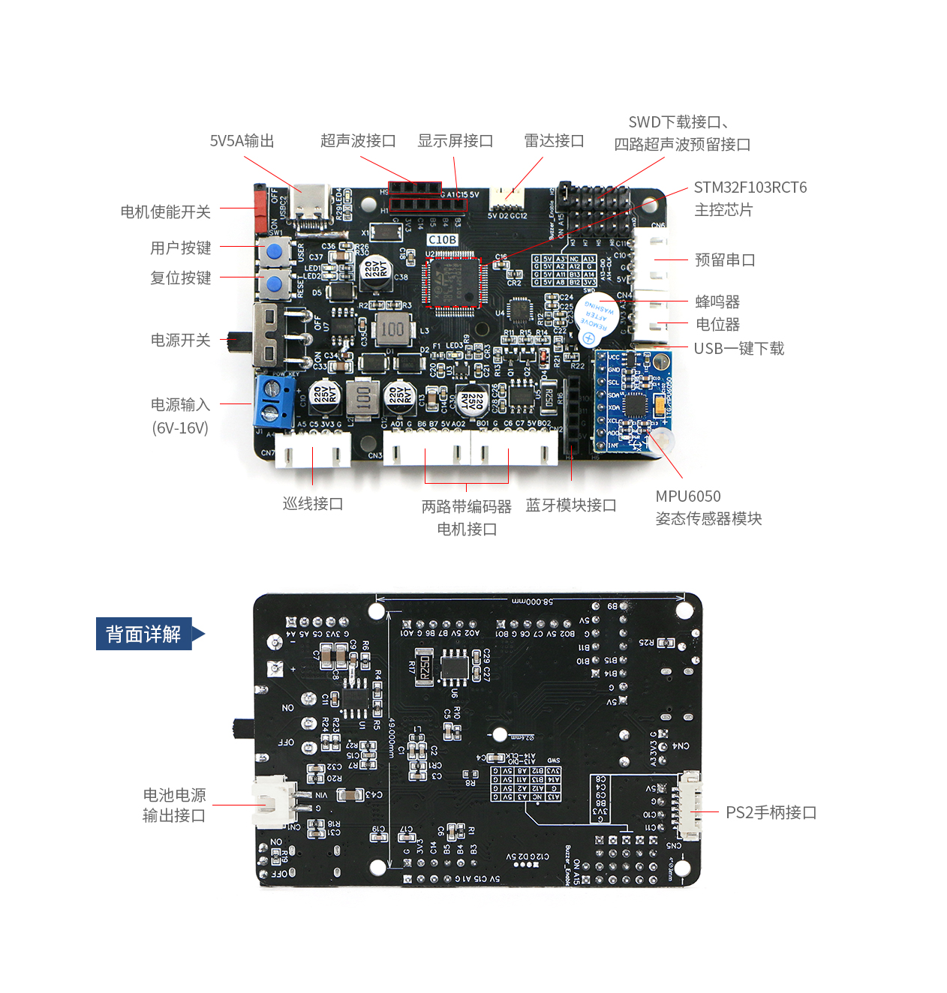
[picture p4: 资料/主控板/C10B主板接口说明图.jpg]
C10B 接口说明图
- 
- [[文档/实验3_定时器_PWM_编码器_详细操作手册|实验 3：定时器、PWM 与编码器操作手册]]
- [[小车调试实测记录_2026-10-07|小车调试实测记录]]

芯片手册在 `资料/芯片手册`，LF04 和 OLED 模块资料在 `资料/模块资料`，厂家提供的使用说明、参考源码及软件工具在 `资料/厂家小车套件/小车`。实测记录保留在项目根目录，便于持续记录。

## 软件、接入记录和调试工具

- [[firmware/README|本地固件工程说明]]
- [[oled_f407_hal/README|F407 OLED 驱动说明]]
- [[output/固件接入包/T25_任务四独立重写包/任务四独立重写与烧录说明|近期 T25 任务四独立重写记录]]
- [近期 T26 中文注释核对记录](file:///Users/mzh/Desktop/%E8%BD%A6%E8%BD%A6/output/%E5%9B%BA%E4%BB%B6%E6%8E%A5%E5%85%A5%E5%8C%85/T26_%E4%B8%AD%E6%96%87%E6%B3%A8%E9%87%8A/%E6%A0%B8%E5%AF%B9%E8%AE%B0%E5%BD%95.json)
- [[output/固件接入包/T27_任务四容错增强包/任务四容错增强与烧录说明|T27 任务四容错增强与烧录说明]]

`firmware` 和 `oled_f407_hal` 工程保留原位置。`output/固件接入包` 存放各阶段的交付文件和验证记录；`output/固件备份` 存放 Sunward 备份；`output/调试工具` 存放串口记录、蓝牙测试和 WASD 工具；`示例代码` 存放原根目录两个 main 示例。

接入包和编译记录属于历史过程资料，不凭文件夹编号认定当前固件或实车验收状态。目录整理没有烧录固件，也没有修改固件源代码。

## 归档和整理记录

临时脚本、实验报告渲染中间文件和主机检查产物放在 `归档/临时工作区`。

- [旧路径到新路径的移动清单](file:///Users/mzh/Desktop/%E8%BD%A6%E8%BD%A6/%E5%BD%92%E6%A1%A3/%E7%9B%AE%E5%BD%95%E6%95%B4%E7%90%86%E8%AE%B0%E5%BD%95_2026-10-13/%E7%A7%BB%E5%8A%A8%E6%B8%85%E5%8D%95.json)
- [文件完整性清单](file:///Users/mzh/Desktop/%E8%BD%A6%E8%BD%A6/%E5%BD%92%E6%A1%A3/%E7%9B%AE%E5%BD%95%E6%95%B4%E7%90%86%E8%AE%B0%E5%BD%95_2026-10-13/%E6%96%87%E4%BB%B6%E5%AE%8C%E6%95%B4%E6%80%A7%E6%B8%85%E5%8D%95.json)
- [路径引用修正记录](file:///Users/mzh/Desktop/%E8%BD%A6%E8%BD%A6/%E5%BD%92%E6%A1%A3/%E7%9B%AE%E5%BD%95%E6%95%B4%E7%90%86%E8%AE%B0%E5%BD%95_2026-10-13/%E8%B7%AF%E5%BE%84%E5%BC%95%E7%94%A8%E4%BF%AE%E6%AD%A3.json)
- [整理结果](file:///Users/mzh/Desktop/%E8%BD%A6%E8%BD%A6/%E5%BD%92%E6%A1%A3/%E7%9B%AE%E5%BD%95%E6%95%B4%E7%90%86%E8%AE%B0%E5%BD%95_2026-10-13/%E6%95%B4%E7%90%86%E7%BB%93%E6%9E%9C.json)

这次移动了 125 个入口，校验了 14477 个文件，修正了 184 个文本文件中的路径引用，没有删除资料。修改前原文保存在整理记录内。备份快照和历史 ZIP 保留原内容，因此它们内部的旧绝对路径可以按移动清单定位新位置；需重新构建历史快照时，应另存副本并更新对应构建配置，保留原始备份。
