Mu-Miao/Sunward_Data/output/固件接入包/9.5_双轮PI闭环测试包/9.5_第八步_落地3秒.md

# 第八步：落地跑3秒，复验地面负载

对应三天任务清单第一天T06，接在已确认的“双轮架空3秒、STOP与OFF均正常”之后。架空实验已完成，现用相同参数首次验证地面负载；无需改CubeMX、复制代码或重新烧录。

当前程序：双轮目标60mm/s，左右各P32/I20，每轮命令上限1800，RUN后3秒自动停；左B负命令/TIM8正反馈，右A正命令/TIM4负反馈。Reset不自动RUN。此次不加入航向修正、不调参数，先看原有轮速环在地面上能否正常前进。

## 直接这样做

1. 使能OFF。用目前能成功的开机流程启动，串口选115200/8N1。新版本地工具已修正RTS/DTR；若使用它，先关闭旧工具和网页串口，双击同目录`打开本地串口.command`。看到控制线释放提示后，原来无输出时只按一次Reset；有持续DPI输出即可继续，不做重复Reset排查。
2. 打开电池主电源，检查BAT在接通电池的正常范围附近（此前约1340～1355），待机UL/UR/IL/IR均0。没有持续输出时先用已成功的全断电流程恢复；不能把“没有输出”当作已准备好发送RUN。
3. 把车放在平整、无障碍的地面，车头前方至少留50cm。USB线放松，不能扯车或压轮；用地砖缝、尺子或地面已有参照记下车头起始位置。无需白底黑线。
4. 使能ON，等1秒，在终端输入`RUN!`并回车，只发送一次。看车是否向前走、约3秒自动停。若明显偏转、抖动或不动，拨使能OFF结束本轮，不用手挡轮子。
5. 停稳后使能OFF，记录车头前进距离和偏向哪侧。理想恒定60mm/s跑3秒为18cm，但本程序从静止起步，实际距离可能更短；此处不以18cm作为通过门槛。
6. 第一轮正常才把车摆回起点，再使能ON、等1秒、发送一次`RUN!`，重复3秒观察。随后OFF，输入`q`回车保存JSON。
7. 把JSON发来，并写一句：`落地能/不能向前；3秒能/不能停；第1次约__cm、第2次约__cm；偏左/偏右/不明显；有/无抖动。`

若软件提示STALL/REV/FAST/GAP/LOW/UART等故障，保留日志，结束本轮；不用增加占空比强行推过去。电池与USB同时连接时，关闭电池主开关不代表逻辑电路完全断电；使能OFF才是本轮立即停止电机的操作。

## 本轮怎样判断

本轮检查两轮在地面负载下能否前进、轮速反馈与实际行为是否一致、原有3秒停车是否有效，以及是否明显抖动/堵转。日志中的L/R为轮胎按标称周长换算的速度，打滑时不能代表车身实际速度，所以同时记录地面距离。

双轮速度相近仍可能偏转，原因包括左右有效轮径、摩擦和地面差异，不能凭本轮把偏转直接归于MPU或接反。完成负载复验后，再按数据决定T06是否需调参或阶跃复验，再接T09航向与定距。LF04黑白标定仍暂缓；圆弧巡线和整圈任务要在补齐标定后进行。
