Mu-Miao/Sunward_Data/output/固件接入包/9.5_左轮PI_8秒观察包/9.5_第六步_左轮8秒观察.md

# 左轮保持P32/I20，观察8秒

2026-10-08，左轮3秒测试日志显示速度向60mm/s靠近，积分还在增加。你已确认左轮向前、右轮不动、无明显抖动，自动停/STOP/OFF均正常。本轮只延长观察时间，先不增加Ki。

已代你备份左轮3秒版，修改Sunward中的三处：left_pi_test.h的LPT_DURATION_MS改8000U，left_pi_test.c初始化允许时长改8000U，启动提示改8s。main和CubeMX配置不需要再改。目标60、P32、I20、上限1800、方向和各项停车逻辑保持本轮设置。

备份：[左轮3秒原版](/Users/mzh/Desktop/车车/output/固件备份/Sunward_左轮3秒原版备份_2026-10-08_2v6x3udd)。新文件副本及编译/模拟验证记录也在本包内。板上固件需要你下载后才变成8秒版。

1. 固定车身、双轮架空，电池主电源ON，使能先OFF。
2. 下载`/Users/mzh/STM32Cube/Sunward/build/Debug/Sunward.hex`，串口115200/8N1连接后Reset。确认提示`left B only; 8s; PI active`；待机U/I均0。
3. 使能ON，等1秒，ASCII单次发送`RUN!`，不要循环发送。左轮向前、右轮不动，观察8秒自动停。
4. 停3秒，再单次发送`RUN!`，观察第二次8秒自动停。运行中不要碰轮子或人为加负载。
5. 结束后使能OFF，导出JSON发给我；说明两次是否自动停、运行中是否平顺。

如明显反复启停、速度大幅起伏，立即STOP并拨OFF；软件无响应时用电池主电源开关。此版用于固定架空测试。

本轮看最后约3秒V是否接近60、I是否逐渐稳定，而非持续大幅增长，结束时U/I是否归零。每200ms打印最近一拍数据仍需配合肉眼观察；不能据此证明每一拍都平稳。
