Mu-Miao/Sunward_Data/output/固件接入包/9.5_左轮PI闭环测试包/9.5_第五步_左轮3秒测试.md

# 左轮单独试转3秒

**2026-10-08 15:13已代你接入Sunward并完整重新编译成功。下面“复制两个文件”“修改main.c三处”已经完成，无需重复。从“操作顺序”的下载和实物测试开始即可。** 备份在[接入前备份](/Users/mzh/Desktop/车车/output/固件备份/Sunward_左轮接入前备份_2026-10-08_qhw559y1)，原右轮代码保留。新HEX为`/Users/mzh/STM32Cube/Sunward/build/Debug/Sunward.hex`，尚未烧录到板上。

右轮8秒日志后段已经接近60mm/s。若实物运行中段也连续、平顺，先保持右轮参数，把左轮单独接入并检查方向、反馈与停车。P=32、I=20借作左轮初始试调值，两只电机的合适参数可能不同。

左右以站在车尾、面向车头为准。已确认左轮是B电机，负命令向前；左编码器是TIM8，向前计数为正。新代码因此读取TIM8，速度计算不取负，并调用`Lab_MotorRawAB(0, -command)`。日志U为向前驱动量的正数，实际B命令为-U。

## 复制两个文件

将本包文件**复制**到以下位置，不要移动，也不要放在Core这一层：

| 本包文件 | Sunward目标路径 |
|---|---|
| Core/Inc/left_pi_test.h | /Users/mzh/STM32Cube/Sunward/Core/Inc/left_pi_test.h |
| Core/Src/left_pi_test.c | /Users/mzh/STM32Cube/Sunward/Core/Src/left_pi_test.c |

原right_p_test.h/.c保留供回退。CubeMX无需改动，两路编码器已启动。

## 修改main.c三处

先保存main.c备份到工程外。在`/Users/mzh/STM32Cube/Sunward/Core/Src/main.c`：

1. USER CODE BEGIN Includes内，将`#include "right_p_test.h"`替换成：

```c
#include "left_pi_test.h"
```

2. USER CODE BEGIN 2内，把原来的RightPTest_Begin初始化整个块替换成：

```c
if (LeftPITest_Begin(&huart1, &htim8, &hadc1,
                     Lab_MotorRawAB) != HAL_OK) {
    Lab_Write("LPI init FAIL\r\n");
    Error_Handler();
}
```

3. while循环的USER CODE BEGIN 3内，将`RightPTest_Poll(lab_tick10_count);`替换成：

```c
LeftPITest_Poll(lab_tick10_count);
```

初始化和循环都只调用左轮测试。不要同时调用右轮模块；两个模块都直接控制电机并接收同一串口，会互相干扰。其余初始化、TIM2计数回调和被注释的点动保持原样。

头文件本轮参数为目标60mm/s、P32、I20、最长3000ms、上限1800、左CPR60104.3333、轮径暂按65mm。不要先把时长改8秒，先看左轮短时表现。

## 操作顺序

1. 车身固定，双轮架空。使能先OFF，电池主电源ON。编译下载；若提示LeftPITest未定义，检查新增.c是否被工程编译，完整重新构建。遇到错误先保存报错，不继续测试。
2. 连接115200/8N1串口，按Reset。应出现`LPI: send RUN! or STOP!; left B only; 3s; PI active`。待机U=0、I=0；电池ADC应接近此前主电源ON时约1350的读数。
3. 使能ON，等1秒，ASCII单次发送`RUN!`，不要循环发送。观察左轮向前、右轮不动，约3秒自动停。转动中V应主要为正。
4. 若第一次方向正确、没有明显反复启停且能自动停，停3秒，再发一次`RUN!`，等自动结束。
5. 再发`RUN!`，转动约1秒发送`STOP!`，确认左轮停下；随后日志ST=STOP、U=0、I=0，V随后回到0。
6. 停3秒，再发`RUN!`，转动约1秒把使能拨OFF，确认左轮停下；随后ST=OFF、U=0、I=0，V随后回到0。
7. 导出本轮JSON发给我，并说明左轮方向、右轮是否不动、是否明显抖动，以及自动停/STOP/OFF三个停车表现。

若第一轮反向、右轮也动、明显反复启停或不能停车，立即STOP并拨OFF，先结束本轮；软件无响应时用电池主电源开关切断电机供电。不要用手阻挡轮子，不把架空测试参数直接当作落地参数。

## 看哪些数据

日志前缀变成LPI。T/V单位mm/s，U/I单位PWM计数，DT单位微秒。V是打印时最近一个10ms测量间隔的轮速，每200ms打印一次。3秒内可能仍未完全接近60，本轮先确认左轮方向和停车，再根据误差、输出与积分变化判断是否需要更长观察或调参数。

运行结束后U/I归零和编码器回零是日志证据，仍需观察实物停车。CPR和65mm轮径是目前初始标定值，绝对速度精度还未用滚动距离校核。

回退时恢复main原三处右轮include、RightPTest_Begin(&huart1,&htim4,...)和RightPTest_Poll即可；无需删除新左轮文件。
