Mu-Miao/Sunward_Data/output/固件接入包/9.5_蓝牙命令接入包/蓝牙收发与测试.md

# 蓝牙复用现有命令和DPI日志

已备份并接入实际Sunward工程，现场完整编译通过；尚未烧录。USB维持USART1/115200，蓝牙使用你已配置并报告可用的USART3/PB10、PB11/9600，均8N1、无流控。保留原蓝牙Echo测试函数但不调用，主循环运行双轮PI实验。

固件：[Sunward.hex](/Users/mzh/STM32Cube/Sunward/build/Debug/Sunward.hex)。本目录另有同内容HEX和修改后的源码。备份：`/Users/mzh/Desktop/车车/output/固件备份/Sunward_蓝牙接入前备份_2026-10-08_y96eg8eq`。

1. 使能OFF、双轮架空，烧录新HEX。
2. 在刚才已经连通的蓝牙工具中保持原连接方式，按文本/ASCII发送，关闭循环发送。持续收到`DPI ...`即说明日志通路已接入；上电提示为`DPI: send RUN! or STOP!; both forward; 3s; USB/BT async`，连接较晚时可能错过该提示，但之后仍每200ms有DPI。
3. 主电源ON、使能ON，等1秒，单次发送`RUN!`：两轮向前，3秒自动停。重复RUN不延长本次计时。
4. 再发一次`RUN!`，约1秒后发`STOP!`：两轮停，日志显示ST=STOP，UL/UR/IL/IR均0。若异常立即拨使能OFF。
5. 架空无线启动/停车正常后，拔USB、仅电池供电，用蓝牙做原定的落地两次3秒短跑，保存日志与两次前进距离/偏向。

`!`、回车或换行都可作为命令结束符，推荐明确发送大写`RUN!`、`STOP!`；不要HEX发送。此版运行阶段不再回复hello/ECHO，使用DPI中的ST=RUN/STOP/DONE观察命令结果。

USB与蓝牙各有512字节TX、128字节RX队列和独立命令解析，不把两口的碎片拼成命令。DPI日志同时放入两口发送队列，队列满丢弃整条日志，不等待串口。每次处理两口命令后才接受RUN，同一轮处理中的STOP或接收故障优先。RXE/TXD现在是两口错误/丢弃计数的合计；队列保存字节，不保证对端蓝牙工具已收到或显示。

程序仍为目标60mm/s、左右P32/I20、命令上限1800、3秒；方向、OFF/STOP和所有原故障停车条件保留。蓝牙未提供连接状态信号给此程序，断开不会另触发“失联停车”，仍靠3秒自动结束和实体使能OFF；本轮不延长运行时间。

验证：主机模拟覆盖蓝牙RUN/STOP、双口相同日志、碎片隔离、两种同时命令顺序下STOP优先、蓝牙RX错误/溢出停车与恢复、蓝牙TX满仍能控制和停车、3秒与OFF；原轮速/方向/PI/停车回归通过。完整ARM工程编译链接成功，FLASH22952B、RAM3984B，两个USART中断均为强符号。未连接实际串口、未自动烧录、未做实物无线试车。
