Mu-Miao/Sunward_Data/output/固件接入包/MPU6050_9.4.2接入包/9.4.2_先读身份和原始数据.md

# 9.4.2：先读MPU6050身份和原始数据

本接入包适用于当前Sunward工程：STM32F103RCT6、STM32F1 HAL、PB14/PB15软件I²C。现在只做身份、配置读回和三轴原始数据检查。轮子保持停止。

文件已做ARM编译检查；通信、电平和实际读数仍需你烧录后验证。原有Sunward项目没有被自动修改。

## 1. CubeMX设置两根引脚

在Pinout中分别点击PB14、PB15，选择GPIO_Output。然后在System Core → GPIO中，设置：

| 选项 | PB14 | PB15 |
|---|---|---|
| User Label | MPU_SCL | MPU_SDA |
| GPIO output level | High | High |
| GPIO mode | Output Open Drain | Output Open Drain |
| GPIO Pull-up/Pull-down | No pull-up and no pull-down | No pull-up and no pull-down |
| Maximum output speed | High | High |

保存并Generate Code。保持PB6/PB7为TIM4编码器引脚，不启用I2C1来接这块模块。

**为什么：** PB14是时钟线SCL，PB15是数据线SDA；厂商就是用这两根线连接模块。新驱动使用开漏方式：写High表示释放总线，让模块回答；实际高电平依赖模块/线路上的上拉电阻。输出速度High是GPIO边沿设置，不是I²C通信频率。代码留有微秒延时，实际频率需仪器验证。

本驱动初始化也会设置这两根GPIO；CubeMX同步配置是为了使生成代码和驱动一致。模块已安装，先检查现有供电、接线和上拉，不改变模块电源接法。如果上拉缺失或总线拉到错误电压，需要根据实物处理；不能用推挽强拉高掩盖问题。

## 2. 复制四个文件到Sunward

| 本接入包中的文件 | 复制到你的工程 |
|---|---|
| Core/Inc/soft_i2c.h | /Users/mzh/STM32Cube/Sunward/Core/Inc/soft_i2c.h |
| Core/Inc/mpu6050.h | /Users/mzh/STM32Cube/Sunward/Core/Inc/mpu6050.h |
| Core/Src/soft_i2c.c | /Users/mzh/STM32Cube/Sunward/Core/Src/soft_i2c.c |
| Core/Src/mpu6050.c | /Users/mzh/STM32Cube/Sunward/Core/Src/mpu6050.c |

是复制文件，不是把文件内容全部粘到main.c。复制时如果目标已有同名文件，先检查，不覆盖你自己后来加入的驱动。

**为什么：** soft_i2c负责起始/停止、发送接收、ACK、SCL等待超时和复位后的总线恢复；mpu6050负责地址探测、芯片唤醒、配置读回和14字节连续读取。

当前EIDE配置srcDirs包含Core，因此这两份.c正常应进入构建。编译后检查build/Debug/compile_commands.json或构建输出里有soft_i2c.c和mpu6050.c；若出现undefined reference，先检查源文件是否加入构建，而不是再写空函数。

## 3. main.c加头文件

在`/* USER CODE BEGIN Includes */`和`/* USER CODE END Includes */`之间，增加：

```c
#include "mpu6050.h"
#include "soft_i2c.h"
```

原有stdio.h、stdint.h、string.h保留。

## 4. main.c加状态变量

在`/* USER CODE BEGIN PV */`和`/* USER CODE END PV */`之间，增加一次：

```c
static int lab_mpu_ready = 0;
```

**为什么：** 初始化失败时不继续使用无效传感器数据。本实验仅记录故障，不启动电机。

## 5. main.c加打印函数

在`/* USER CODE BEGIN 0 */`区域里，放在已有Lab_Write函数后面、`/* USER CODE END 0 */`前面，增加：

```c
static void Lab_PrintMPURaw(void)
{
    if (!lab_mpu_ready) return;
    MPU6050_Raw raw;
    HAL_StatusTypeDef status = MPU6050_ReadRaw(&raw);
    if (status != HAL_OK) {
        Lab_Write("MPU read FAIL\r\n");
        return;
    }
    char msg[112];
    int n = snprintf(msg, sizeof msg,
        "MPU AX=%d AY=%d AZ=%d GX=%d GY=%d GZ=%d\r\n",
        (int)raw.ax, (int)raw.ay, (int)raw.az,
        (int)raw.gx, (int)raw.gy, (int)raw.gz);
    if (n > 0 && n < (int)sizeof msg) Lab_Write(msg);
}
```

**为什么：** AX/AY/AZ是加速度计，GX/GY/GZ是陀螺仪。本阶段同时看三个轴，先找出小车平面转弯对应的轴；不预先假定一定是GZ。

## 6. main.c加初始化和身份日志

在`/* USER CODE BEGIN 2 */`区域，现有ADC校准代码后面、`/* USER CODE END 2 */`前面，增加：

```c
MPU6050_Info info;
HAL_StatusTypeDef mpu_status = MPU6050_Init(&info);
char mpu_msg[128];
int mpu_n = snprintf(mpu_msg, sizeof mpu_msg,
    "MPU status=%u ADDR=0x%02X WHO=0x%02X PWR=0x%02X "
    "DIV=%u DLPF=%u GYRO=0x%02X ACCEL=0x%02X LINES=%u\r\n",
    (unsigned)mpu_status, (unsigned)info.address, (unsigned)info.who,
    (unsigned)info.power, (unsigned)info.divider, (unsigned)info.filter,
    (unsigned)info.gyro_config, (unsigned)info.accel_config,
    (unsigned)SoftI2C_Lines());
if (mpu_n > 0 && mpu_n < (int)sizeof mpu_msg) Lab_Write(mpu_msg);
lab_mpu_ready = (mpu_status == HAL_OK);
```

身份日志只在初始化时打印一次。状态0表示HAL_OK；1表示HAL_ERROR（例如NACK、身份不符或配置读回不符），2表示HAL_BUSY，3表示HAL_TIMEOUT。LINES是当时读到的总线电平，正常空闲应为3（SCL=1、SDA=1）。LINES=0/1/2可辅助检查哪根线被拉低；即使LINES=3，也不保证对方已应答。

地址自动尝试0x68和0x69，WHO_AM_I预期均为0x68。身份值和总线地址不同。初始化失败时ADDR/WHO是最后一次探测信息或初始零值，其他字段可能还没有成功读回；不要把失败日志当作有效量程。

本驱动设置并读回：陀螺仪±250°/s、加速度计±2g、DLPF=3、采样分频9（内部数据更新100Hz），不启用DMP/FIFO/外部中断。陀螺仪raw除以131得到°/s，加速度raw除以16384得到g。先读回确认配置，再使用换算。

初始化内部有约300ms等待，仅用于初始化；不要放进TIM2中断或循环重复调用。

## 7. 改主循环中的一行

保留现有100ms的if和全部循环花括号，把其中`Lab_PrintBatteryRaw();`暂时替换为`Lab_PrintMPURaw();`。替换后的循环部分如下：

```c
  /* USER CODE BEGIN WHILE */
  while (1)
  {
    /* USER CODE END WHILE */

    /* USER CODE BEGIN 3 */
    if ((uint32_t)(HAL_GetTick() - line_log_ms) >= 100U) {
        line_log_ms = HAL_GetTick();
        Lab_PrintMPURaw();
    }
  }
  /* USER CODE END 3 */
```

这段只覆盖while循环；其后main函数原有的最后一个`}`保留。

两个LAB_TEST_CMD继续为0，`Lab_MotorTestOnce()`继续注释。TIM2回调仍只计数，本实验传感器通信与串口打印均在主循环，不在中断里做阻塞操作。

## 8. 编译、烧录、复位并验收

正常启动日志格式（ADDR也可能是0x69）：

```text
MPU status=0 ADDR=0x68 WHO=0x68 PWR=0x01 DIV=9 DLPF=3 GYRO=0x00 ACCEL=0x00 LINES=3
MPU AX=... AY=... AZ=... GX=... GY=... GZ=...
MPU AX=... AY=... AZ=... GX=... GY=... GZ=...
```

带省略号的第二、三行只是格式示意，不是预设实测值。

按顺序做：

1. 核对status=0、WHO=0x68，以及PWR、DIV、DLPF、GYRO、ACCEL读回值。
2. 小车放平、静止，记录至少10行。GX/GY/GZ可以有小的非零值和抖动，不要求全部等于0。
3. 保持车身水平，手动左右转动车头，记录GX/GY/GZ中哪个变化最明显，以及左转/右转的符号。一次只做一种转动，避免抬起车身造成其他轴同时转动。
4. 若身份或读回配置失败，先检查模块电源、共地、PB14/PB15接线、上拉和构建文件；暂不做角度运算。

**本轮通过标准：** 身份和配置读回正确、原始数据持续输出、静止与手动转动的读数能区分。仅身份成功还不能证明传感器测量功能和精度全部正常。

## 9. 下一轮才做零偏和角度

这次记录选出的轴和左右转符号后，再接入：静止平均零偏 → 角速度扣零偏 → 按实际采样时间积分 → 手动约90°检查 → 静止30秒记录漂移。不能把raw直接当角度，也不能把100ms日志读取误当成10ms实时控制采样。

本指南完成9.4.2的通信和原始数据阶段。下一步的两个新文件和详细代码位置已提供，见[零偏与角度操作指南](/Users/mzh/Desktop/车车/output/固件接入包/MPU6050_9.4.2接入包/9.4.2_下一步_零偏与角度.md)。静止校准、90°角度和30秒漂移仍需实物验收，未宣称已完成。

## 10. 依据与限制

- 厂商HAL工程中的IOI2C.h确认PB14=SCL、PB15=SDA。本驱动采用开漏释放和带超时的通信流程，不依赖厂商全套Header.h、任务框架或DMP代码。
- 本地MPU6050英文寄存器手册：0x75身份值、0x6B唤醒、0x19分频、0x1A滤波、0x1B/0x1C量程、0x3B起的14字节连续数据。
- 软件延时使用STM32F103 Cortex-M3的DWT周期计数器；初始化检查计数是否运行。只用于当前前台诊断，不与其他软件I²C任务并发访问，不在运行中改变HCLK。
- 编译成功证明文件和HAL接口匹配；ACK、上拉、波形和真实测量仍要在你的板子上验证。
