Mu-Miao/Sunward_Data/output/固件接入包/T08_LF04静态标定接入包/LF04静态标定操作说明.md

# LF04四路静态黑白标定

> 新静态确认（2026-10-11）：从车尾面向车头，仅左内侧（第2个）压黑读1101，确认O3是左内侧；本次没有改变物理通道映射。

> 已有更新的[纯按键版本](/Users/mzh/Desktop/车车/output/固件接入包/T11_纯按键巡线接入包/纯按键巡线操作说明.md)：OFF长按选模式、短按松手校准；运行不需要LF20!或蓝牙。本文件及HEX保留为上一版调试记录，实际工程当前HEX已更新为纯按键版本。

> 巡线开发版本已接入实际工程，工程当前HEX不再与本静态包HEX相同。下一步使用[20厘米低速巡线说明](/Users/mzh/Desktop/车车/output/固件接入包/T11_20cm低速巡线接入包/20cm低速巡线操作说明.md)和对应新固件；本静态包仍保留作为历史版本。

> 最新更正（2026-10-11）：用户说明此前黑白记反，并重新实测全白1111、内侧两路压黑1001。当前采用黑线0、白底1；此前全白0000、居中0110及表中的白0黑1结论已被更正，不可据旧结论接入运动。物理通道对应沿用此前逐路发生变化的通道：从车尾面向车头，左→右为O4/O3/O2/O1。

2026-10-11。用户已确认OLED镜像修正版正常，并确认LF04已经接主板、尚未做黑白标定。新增静态原始读数，保留OLED正向显示与按键校准/一米启动。软件验证及完整编译通过；新读数、黑白响应、物理通道顺序仍待实测。

## 先做第一组

1. 保持实体使能OFF，烧录[新Sunward.hex](/Users/mzh/Desktop/车车/output/固件接入包/T08_LF04静态标定接入包/Sunward.hex)。本版与[工程当前HEX](/Users/mzh/STM32Cube/Sunward/build/Debug/Sunward.hex)一致。松开KEY_U；静态读数不需要CAL。
2. 保持车不动、探头高度固定，将四个探头下方都放白底，等约1秒，记OLED末行四个数字。例如`LF 1 1 1 1`只是示例，实际数值照抄。
3. 站在车后面、面向车头，将四个物理探头从左到右编号1～4。只把黑线移到最左的1号探头下方，其余保持白底，等约1秒，再记四个数字。
4. 先回传上述全白、仅左1黑两组四位读数。随后依次覆盖左2、左3、左4，完成四路对应关系。

整个静态步骤保持OFF、车不动。移动黑线/白底而非按键启动。数字排列始终是电气O1/O2/O3/O4，不预设为物理左→右，也不先写死白=1/黑=0。某次仅遮一个物理探头、一个电气通道发生稳定变化，才能据此对应通道；多个变化要检查黑线是否同时覆盖相邻探头。

## 本版显示

```text
TASK 1 A->B
YC NONE EN OFF
STATE IDLE
LF 1 1 1 1
```

最后一行从左到右为O1、O2、O3、O4的原始0/1。OFF时显示LF；ON时恢复原里程/目标速度显示。上三行任务、YC与STATE继续保留。静态读数不需要陀螺仪READY。任务仍固定一米，没有新增自动巡线、选任务或其他路线。

可选串口/蓝牙记录约每秒输出`LINE O1=... O2=... O3=... O4=...`，无需发送新指令。OLED每200ms取一组快照并分块刷新，转换黑白后等1秒再抄数，避免读到刷新中的旧帧。已有DPI/HDG/KEY/OLED日志继续保留，发送队列满不阻塞停车。

## 首轮读数表（黑白结论已被下方复测更正）

| 放置情况 | O1 | O2 | O3 | O4 | 发生变化的通道 |
|---|---|---|---|---|---|
| 四个探头全白底 | 0 | 0 | 0 | 0 | 用户已报告基准 |
| 仅物理左1下方黑线 | 0 | 0 | 0 | 1 | O4，白0→黑1 |
| 仅物理左2下方黑线 | 0 | 0 | 1 | 0 | O3，白0→黑1 |
| 仅物理左3下方黑线 | 0 | 1 | 0 | 0 | O2，白0→黑1 |
| 仅物理左4下方黑线 | 1 | 0 | 0 | 0 | O1，白0→黑1 |

另记安装高度、实际白底/黑线材料及现场光照。先照抄原始值，再判断每路白/黑极性和稳定性；全1或全0本身不代表黑白标定已通过。必要的阈值/高度调整由实际读数决定，先保留当前安装与设置。

## 代码与证据

只改dual_pi_test.c：低频读取O1=PC8、O2=PC4、O3=PC9、O4=PB8，OFF显示与日志；四路读数没有进入运动、转向或启动条件。GPIO既有配置为输入上拉，未改接线、GPIO/MPU/UART、OLED驱动、按键或PI/航向/距离参数；OLED水平修正A0保留。快照刷新尝试固定每200ms，遇到忙帧下一周期重试。

主机模拟验证16种四路组合的精确针脚顺序、OLED与双口输出、OFF无运动、ON恢复里程、LF输入不参与GO100控制、按键STOP/OFF保护、满发送队列、校准/航向和时间回绕。实际工程全量ARM编译链接成功；新增代码无警告，只有原main unused警告。未替用户打开串口、烧录、驱动车辆或填黑白实测结果。

旧版备份：[LF04静态显示前源码与完整构建](/Users/mzh/Desktop/车车/output/固件备份/Sunward_LF04静态显示前备份_2026-10-11_m_4fx6vk)。新HEX SHA256：`afeb293a8e2bad0b0ff8856e7115b324f600d8b2c47242ecff738fd6ec27e3b0`。

证据：[主机验证](/Users/mzh/Desktop/车车/output/固件接入包/T08_LF04静态标定接入包/主机验证.txt)、[工程编译](/Users/mzh/Desktop/车车/output/固件接入包/T08_LF04静态标定接入包/工程编译验证.txt)、[接入记录](/Users/mzh/Desktop/车车/output/固件接入包/T08_LF04静态标定接入包/接入记录.json)、[差异](/Users/mzh/Desktop/车车/output/固件接入包/T08_LF04静态标定接入包/源码差异.patch)。标定完成后才能按物理左→右归一化，再把巡线纠偏接到两轮速度内环。

## 首组实物读数（2026-10-11）

用户报告四个探头全白底时OLED原始读数为0000，即O1/O2/O3/O4均0。只记录当前白底原始值，不据此认定黑线值或各路响应已经标定完成。视角再次明确：站在车尾、面向车头，从左到右编号物理探头1～4，小车自身左侧最外端为物理左1；电气O1～O4顺序尚待逐路对应。下一组为保持OFF，仅左1下方放黑线，其余三路白底。

## 仅物理左1黑线：0001（2026-10-11）

在上述车尾面向车头视角下，用户报告仅最左探头下方黑线时读数0001。结合全白0000，初步确认物理左1对应电气O4，O4白底0、黑线1；不能直接推定其余三个探头的排列或极性。下一组为仅从左数第2个探头下方黑线，其余白底，保持OFF。

## 仅物理左2黑线：0010（2026-10-11）

统一车尾面向车头视角，用户报告仅从左数第2个探头下方黑线时为0010。结合全白0000，初步确认物理左2对应电气O3，O3白底0、黑线1。已测物理左1→O4、左2→O3，剩余两路继续逐路测，不提前推定。下一组仅物理左3下方黑线，其余白底，保持OFF。

## 仅物理左3黑线：0100（2026-10-11）

统一车尾面向车头视角，用户报告仅从左数第3个探头下方黑线时为0100。结合全白0000，确认物理左3对应电气O2，O2白底0、黑线1。已测左1→O4、左2→O3、左3→O2；最右端左4尚待实测。下一组仅最右端探头下方黑线，其余白底，保持OFF。

## 仅物理左4黑线：1000；四路映射确认（2026-10-11）

用户报告仅最右端（物理左4）探头下方黑线时为1000。结合全白0000，确认物理左4→O1，O1白0/黑1。四路单探头实测齐全：从车尾面向车头，物理从左到右对应O4、O3、O2、O1，均白底0、黑线1。OLED仍按电气O1～O4显示，尚未改固件或接入巡线转向；本轮确认映射与极性，不替代动态巡线验收。

下一步保持OFF，以正常行驶安装高度把车身中心对准实际赛道黑线，回传静止时四位读数，用于确认居中时实际覆盖哪些探头。中间两个同时压黑且外侧白时为0110；实际值受线宽、探头间距及安装位置影响，不预先指定必须为0110。

## 居中读数0110（2026-10-11）

用户按上述居中放置步骤回传0110。O2/O3为黑线1，O1/O4为白底0，结合物理映射，表示两个内侧探头压黑、两个外侧探头在白底。本轮四路单探头映射、白0黑1极性及静止居中图样均已确认；未额外推定长时间稳定性、动态纠偏表现或丢线处理已经验收。

下一阶段为固件接入巡线纠偏：将O4/O3/O2/O1归一化为物理左→右，计算黑线偏差，再调整两轮目标速度，保留原速度PI、停止保护和独立GO100行为。接入并编译后再进行低速短程巡线；当前静态显示固件尚不会依据LF读数转向。

## 用户纠正极性并复测：全白1111、居中1001（2026-10-11）

用户说明“刚才记反了，黑线是0，白底是1”，随后按OFF、全白与内侧两路压黑的步骤重新回传：全白1111；中间黑线1001。以这次复测为当前极性和居中读数依据，撤回首轮白0黑1、全白0000和居中0110的有效性。旧记录保留用于追溯，不据旧数值填造新的逐路黑线实测值。

物理通道对应由此前逐路变化的通道确认：左1→O4、左2→O3、左3→O2、左4→O1；巡线软件需先反转电气排列，再以原始0归一化为“见黑”。居中原始1001表示两内侧见黑，全白1111表示无黑线；均为静态读数，动态修正方向仍待低速测试。
