Mu-Miao/Sunward_Data/output/固件接入包/T10_按键独立启动接入包/现场反馈_2026-10-11.md

# 按键版现场反馈

在交付按键版HEX及OFF按键校准、READY后ON按键启动的操作步骤后，用户回复：“可以 依旧是102cm 全程没有异常”。按本次按键版操作反馈记录，实际前进约102cm，整体运行未报告异常；与此前GO100的102/101/102cm结果接近，暂不调整速度、PI、航向增益、CPR或周长。该反馈作为按键版正常一米流程的初步现场证据。

本轮未附串口日志，不补写编码器S、用时或具体按键/灯状态；中途再次按键停车、上电按住键及长按等特殊情形没有单独实测反馈，软件验证通过与现场单项验收分别保留。不因此宣称完整T09或任务2～4完成。下一项准备六针OLED接入，显示当前任务与校准/运行状态。
