Mu-Miao/Sunward_Data/output/固件接入包/T11_20cm低速巡线接入包/20cm低速巡线操作说明.md

# T11：20厘米低速巡线方向测试

> 已有更新的[纯按键版本](/Users/mzh/Desktop/车车/output/固件接入包/T11_纯按键巡线接入包/纯按键巡线操作说明.md)：OFF长按选模式、短按松手校准；运行不需要LF20!或蓝牙。本文件及HEX保留为上一版调试记录，实际工程当前HEX已更新为纯按键版本。

本版将LF04接到两轮速度目标，再由原PI控制电机。它是单独20厘米的循线试验，尚未实现整段半圆、端点识别、整圈或项目2～4。软件模拟与实际ARM编译已通过，未代为烧录或操纵车辆，动态效果待现场回传。

## 当前实测依据

以用户最后纠正并复测的结果为准：**黑线0、白底1，全白1111、两个内侧压黑1001**。此前白0黑1及居中0110的结论已撤回。电气OLED顺序O1/O2/O3/O4，对应GPIO PC8/PC4/PC9/PB8；从车尾面向车头的物理左→右顺序为O4/O3/O2/O1。

下表是依据极性和通道映射计算的预期值，除了全白/居中外，不作为本轮新增实测：

| 电气OLED原始值O1→O4 | 黑线位置 | 纠偏作用 |
|---|---|---|
| 1001 | 两内侧，当前静止居中图样 | 左右等速，无额外纠偏 |
| 1101 | 左内侧O3 | 左轮慢、右轮快，向左修正 |
| 1011 | 右内侧O2 | 左轮快、右轮慢，向右修正 |
| 1110 | 最左O4 | 较大左修正 |
| 0111 | 最右O1 | 较大右修正 |
| 1111 | 全白，当前循线状态无黑线 | 立即发零电机命令；持续100ms锁存LOST |
| 0000或不连续见黑 | 全黑或形状含混 | 立即发零电机命令；持续100ms锁存LINE |

复杂码不当成端点，当前试验按编码器两轮平均里程结束。

## 现场按顺序操作

1. 实体使能保持OFF。用VS Code/EIDE打开实际工程 `/Users/mzh/STM32Cube/Sunward`，Debug→烧录；当前工程HEX已更新。也可用原烧录工具选择[本包Sunward.hex](/Users/mzh/Desktop/车车/output/固件接入包/T11_20cm低速巡线接入包/Sunward.hex)。烧录/复位后默认仍是原一米直行。
2. 在实际弧线中部摆车，车头沿黑线切线朝准备前进的方向，保持正常落地高度，让OLED原始LF为**1001**。保持OFF。
3. ASCII手动发送一次 **`LF20!`**（不要循环发送）。这是OFF选测试，车不会起步；OLED首行应变为 **`TEST LF20`**。选中状态只保存在RAM，复位后要重新选。
4. OFF下短按并松开KEY_U，车保持静止，约7秒等YC **READY**（LED1常亮）。如果已经READY且车保持静止，可直接继续。CAL过程中不拨ON。
5. 确认居中1001保持约1秒，再拨ON，松开按键并等约1秒，然后**重新短按KEY_U**。ON本身不启动；必须是新按键事件。稳定居中不足100ms、YC未READY或其他保护条件不满足，均不能起步，也不排队等待自动起步。
6. 本次目标20厘米，起步40mm/s渐升至60mm/s，最后40mm减速、最低40mm/s，最大运行10秒。按编码器平均累计200mm制动，停稳200ms才DONE，然后灯和蜂鸣器提示一次500ms。实际停车距离仍由尺量/观察确认。
7. 回传是否沿黑线修正、是否明显摆动、是否自动停下，以及停下后OLED的STATE。若出现异常偏离，拨OFF或短按KEY_U停止。`STOP!`也可停止。

第一次只确认这一小段的纠偏方向和停止行为；通过后再扩到完整弧段及各行驶方向。

## 恢复一米直行

停止后拨OFF，ASCII手动发送一次 **`GO100!`**，选择回原任务；OLED应显示`TASK 1 A->B`。如果YC READY，拨ON稳定后新短按KEY_U按原方式跑一米。复位后也默认一米，但要重新校准。

`LF20!`在ON且满足启动门槛时也可直接启动，属于调试指令；推荐本次按OFF选择→校准→ON新按键启动来验证独立执行。运行时重复LF20不会重置里程或截止时间。OFF选模式和STOP同一轮到达时，STOP优先。

## 控制与保护

10ms按电气GPIO读LF，按物理左→右排列并将原始0转换为见黑。1～3个连续见黑探头计算重心，左右权重为−3、−1、+1、+3；纠偏增益8mm/s/权重，最大每轮偏离基速24mm/s，随低基速比例缩小。两轮目标始终正向，原PI/PWM限幅不变。这是初始软件参数，尚未成为实测圆弧参数；未使用未实测轮距来添加弧线前馈。

巡线状态由LF决定差速，避免原直线航向保持和相对起点20°门槛抵消正常转弯。MPU读取/时间/饱和检查仍监测，异常仍YAW停车。GO/GO20/GO100原直线航向与20°保护继续保留。

无有效线的第一帧立即清PI、发零电机命令；不足100ms且恢复有效线时可恢复低速循线，持续100ms锁存LOST或LINE，之后不会自动找线或自动重新启动。锁存故障后需重新居中稳定并发新启动事件。丢线发生在200mm触发点也不当成成功。制动后的轮速停稳和超时沿用原实现；制动时不再进行循线转向。

OFF/STOP、两串口接收故障、ADC/电量、控制间隔、编码器过快/反向、堵转、运行超时、制动停稳超时保留。OLED仍按电气O1～O4显示：OFF末行LF原始值，巡线ON末行`LF1001 S.../200`；巡线日志`LINE RAW=... E100=... C=... VALID=... CENTER=... MODE=LF20`，DPI为`M=LINE G=200`。CENTER是起步用的居中稳定标志，偏离中心但仍有效时可为0；它不表示陀螺仪READY。日志非阻塞，满发送队列不阻塞控制。

## 编译和验证证据

只修改dual_pi_test.c/.h。OLED驱动与镜像A0、主程序、GPIO、MPU、软件I2C、UART、CubeMX与EIDE配置保持原样。完整ARM编译链接成功，FLASH33108B、RAM5336B，新增代码无警告；原main未用函数/变量警告保留。

主机模拟覆盖16种输入码及左右方向/限幅，黑0/白1纠正、居中稳定与新鲜输入启动门槛、OFF选择、默认恢复、按键/串口启动和STOP优先、正常转弯不受直线航向抵消、MPU异常停车、距离减速/制动滑行/停稳一次提示、丢线和复杂码立即制动及100ms故障锁存、丢线不当终点、保护/超时/满TX/时间回绕，并重新运行原PA0、GO100、GO20、航向和手动控制回归用例。均为软件验证，不能替代实车效果。

HEX SHA256：`60555c276885124a1730ad5dd717d1fc10514f5c9b0d48e891ce02d1e163be94`。

- [主机验证](/Users/mzh/Desktop/车车/output/固件接入包/T11_20cm低速巡线接入包/主机验证.txt)
- [工程编译验证](/Users/mzh/Desktop/车车/output/固件接入包/T11_20cm低速巡线接入包/工程编译验证.txt)
- [源码差异](/Users/mzh/Desktop/车车/output/固件接入包/T11_20cm低速巡线接入包/源码差异.patch)
- [接入记录](/Users/mzh/Desktop/车车/output/固件接入包/T11_20cm低速巡线接入包/接入记录.json)
- [原始静态显示固件与完整构建备份](/Users/mzh/Desktop/车车/output/固件备份/Sunward_巡线纠偏前备份_2026-10-11_voipc8km)
