Mu-Miao/Sunward_Data/output/固件接入包/T11_OLED镜像修正版/显示方向修正说明.md

# OLED左右镜像修正版

2026-10-11。用户照片确认屏幕能显示四行任务/校准/运行/里程内容，存在左右镜像，行顺序正常。说明当前SPI驱动能够驱动这块屏幕，但不能只凭显示推定精确控制芯片型号。

已把Core/Src/task_oled.c初始化中的水平段重映射命令A1改为A0，垂直COM扫描C0保持原值；这是唯一程序变更。接线、字体、按键启动和运动控制参数保持原版。

保持使能OFF，烧录[本版Sunward.hex](/Users/mzh/Desktop/车车/output/固件接入包/T11_OLED镜像修正版/Sunward.hex)，上电后检查TASK 1 A->B等文字是否从左到右正常显示。此步仅确认显示方向，修正效果待实物回传。

模拟SPI解码与显存/字体/分块检查通过，确认发送A0而非A1；实际工程完整ARM编译链接成功，仍为FLASH31216B、RAM5288B，仅原main unused警告。新HEX与工程build/Debug/Sunward.hex一致。其他核心文件、.ioc、EIDE及builder.params逐字节校验未改。未替用户烧录或实车验收。

SHA256：`bb1deb12183e3a9ad295b66bf12232454d129de0b16ccf9057191ab6acc3b96b`。

备份：[镜像修改前源码与完整构建](/Users/mzh/Desktop/车车/output/固件备份/Sunward_OLED镜像修改前备份_2026-10-11_r6y3ea84)。原试亮版HEX继续保留在T11_OLED试亮接入包中。证据见本包SPI主机验证.txt、工程编译验证.txt、源码差异.patch和接入记录.json。

## 最新现场与后续固件（2026-10-11）

用户已确认本版方向正常。工程当前更新为[LF04静态标定版](/Users/mzh/Desktop/车车/output/固件接入包/T08_LF04静态标定接入包/LF04静态标定操作说明.md)，保留本版显示方向，OFF时OLED末行显示四路LF原始值。本目录HEX保留镜像修正版历史版本。
