Mu-Miao/Sunward_Data/output/固件接入包/T11_巡线轮速下限与屏幕诊断包/轮速下限与OLED诊断操作说明.md

# 巡线轮速下限与OLED诊断

所有左右方向统一为站在车尾、面向车头。实测仅左内侧压黑为1101，确认它对应O3；物理从左到右为O4/O3/O2/O1，OLED四位原始读数仍按电气O1/O2/O3/O4排列。黑线0、白底1；居中1001，全白1111。

本次增加有效巡线时每轮目标至少40毫米/秒，避免差速把一轮目标压得过低。这个值是初步试验设定，不是测得的电机最低稳定速度。停车、丢线、故障依然立即输出零。保持两轮目标均值等于原基速，因此起步基速40时两轮都40，基速升高后才逐渐允许差速。该限制也会减小转弯能力，需要现场短段验证；暂不据此认定左轮慢的问题已经解决。

## 屏幕怎么看

运行时第三行例如`RUN L48/38 R72/65`：L与R分别是实车左、右轮，每个斜杠前是目标，后是编码器实测，单位毫米/秒。这些只是格式示例，照实际数值判断。

第四行每秒轮流显示原始探头和里程，例如`LF1101 S123/200`，或原始探头和左右PWM命令，例如`LF1101 U1000/1200`。U依次为左/右轮软件控制命令的幅值计数，正常上限1800；不是示波器测到的引脚占空比百分比。不同轮子的PWM大小不能直接代替实测速度比较。

停下且保持ON时，第三行显示`STOP S123 LAST`、`DONE S202 LAST`或故障状态；第四行轮流显示保存的`L目标/实测 R目标/实测`与`LF四位 U左/右`。优先保留最后一次仅O3见黑（1101）的有效运动样本；若从未见过1101，就保留最后一次有效样本。LAST表示此前运动中的记录，不是停车后的轮速。两页属于同一保存样本。

拨OFF后恢复当前静态四路读数。保存数据仍在内存，但OFF不显示诊断页；切换模式、重新开始巡线或复位会清除它。ON本身不会启动。

## 下一趟操作

1. 保持OFF，烧录本包新Sunward.hex，或在VS Code/EIDE烧录Sunward工程当前Debug产物。
2. OFF下长按KEY_U约2秒，看到`TEST LF20`后松开。在短段黑线上摆车，车尾面向车头视角读居中1001。
3. OFF短按并松手，车静止等约7秒至YC READY。已READY可跳过校准。
4. 保持居中，拨ON稳定约1秒，再新短按KEY_U启动。操作全程不需要蓝牙。
5. 如果再次出现左轮过慢，新短按KEY_U停止，先保持ON，不再按启动。停稳后记下LAST两种页面（目标/实测、LF/PWM）及停车状态，或分别拍下两页；记录完再拨OFF。如果明显失控，直接OFF优先停车。

若左轮实测已经达到或超过目标，低PWM可能是控制器正常减力；若实测明显低于目标，再结合PWM判断目标设定、控制器输出或机械负载。O3是左内侧，触发左修正，不单凭线路向右弯就反转通道或转向符号。

一米直行、OFF选模式、短按校准、ON新按启动、忙状态按键停止及复位默认一米保持原行为。此版本仍是独立20厘米巡线试验，完整弧线、端点识别及后续协同尚未实现。
