Mu-Miao/Sunward_Data/output/固件接入包/T11_纯按键巡线接入包/纯按键巡线操作说明.md

# T11：纯按键选择与20厘米低速巡线

> 当前工程已接入[任务二整圈版本](/Users/mzh/Desktop/车车/output/固件接入包/T12_任务二整圈接入包/任务二整圈操作说明.md)，并保留用户最新半圆调参。OFF长按现在循环任务一/半圆/任务二三种模式。本包旧HEX保留为历史版本。

运行全程不需要蓝牙、串口指令或电脑。用现有PA0/KEY_U和ON/OFF使能开关完成选择、校准、启动和停止。当前可选择已实现的一米直行和独立20厘米巡线试验；尚未实现完整圆弧、端点识别、整圈或项目2～4。OLED以TEST LF20标明试验，不能当作项目2已完成。

已在实际工程 `/Users/mzh/STM32Cube/Sunward` 修改dual_pi_test.c/.h并完整编译。软件模拟验证通过，未代用户烧录或操纵车辆，按键新操作和循线动态效果仍待现场回传。

## 按键含义

| 车辆状态 | 操作KEY_U | 结果 |
|---|---|---|
| OFF，未在校准或运动 | 长按约2秒，看到屏幕切换后松开 | 一米直行 ↔ 20厘米巡线；不校准、不起步 |
| OFF，未在校准或运动 | 短按并松开 | 松开消抖后启动静止校准，约7秒达到READY |
| READY，ON已稳定 | 新短按 | 启动当前选中动作；巡线还需100ms稳定居中1001 |
| WARM/CAL/RUN/BRAKE | 新按一次 | 停止或取消，按下消抖后即处理，不等长按 |
| 任意运动状态 | 拨OFF | 停止 |

长按判定为稳定按下后1500ms，操作时按约2秒便于看到反馈。每次长按只切换一次，再久也不重复；松手不触发校准。短按OFF在松开稳定30ms后执行，避免长按选择之前误校准。ON启动、运行/校准中的停止仍在按下稳定30ms后执行。

一直按住上电、按住时改变ON/OFF，均不会自动选模式或启动；要先松手稳定，再重新操作。校准过程中想选模式，先按一次取消、松开，然后OFF长按。MODE切换可保留已完成的YC READY；切换到巡线后仍需重新稳定居中。

## 现场顺序

1. 保持OFF，用VS Code/EIDE打开实际工程Sunward，Debug→烧录。工程当前HEX已更新；也可选[本包Sunward.hex](/Users/mzh/Desktop/车车/output/固件接入包/T11_纯按键巡线接入包/Sunward.hex)。这一步是下载程序；下载后拔开电脑也可操作。
2. 上电/复位默认显示 **TASK 1 A->B**。保持OFF、按住KEY_U约2秒，看到首行 **TEST LF20** 后松开。如果选错了，松开后再次OFF长按切换回来。
3. 在实际黑色弧线中段摆车，车头沿切线朝要前进的方向，保持正常落地安装高度，OLED末行读数 **LF 1 0 0 1**（1001）。最新复测为黑0白1，全白1111；物理左→右对应O4/O3/O2/O1。
4. OFF下短按并松开KEY_U，保持车静止约7秒，直到 **YC READY**、LED1常亮。若已READY可直接下一步；没有READY就不拨ON启动。
5. 保持居中1001约1秒，拨ON，松开按键并等约1秒，再**新短按KEY_U**。ON本身不会起步，不能按住键从OFF直接拨ON。起步40mm/s渐升至60mm/s，约20厘米后按编码器平均里程停车。
6. 停稳200ms后应显示DONE并提示灯和蜂鸣器一次500ms。回传是否沿线修正、是否明显摆动、是否自动停下及OLED STATE；异常时拨OFF或新按KEY_U停止。

第一趟仅检查小段纠偏方向和停稳，不要求完整半圆。丢线故障LOST、复杂码故障LINE、YC故障YAW或其他故障不会当作DONE提示。故障后不自动搜索或自动重新启动，需处理原因、重新居中，再新按启动。

## 恢复一米直行

停止后拨OFF，先松开KEY_U，再长按约2秒，首行从TEST LF20切回 **TASK 1 A->B** 后松开。若YC READY，拨ON稳定后新短按即按原方式跑一米；复位也默认一米，但复位后需重新校准。不要在黑线试验位置直接启动一米，把车放回原一米直行起始位置。

两种模式只存在RAM，复位后默认一米。串口/蓝牙原调试入口仍保留，正式操作无需连接或发送任何指令；本次操作不使用LF20!/CAL!/GO100!。

## 控制与保护

10ms按电气GPIO读LF，按物理左→右排列并将原始0转换为见黑。1～3个连续见黑探头计算重心，左右权重为−3、−1、+1、+3；纠偏增益8mm/s/权重，最大每轮偏离基速24mm/s，随低基速比例缩小。两轮目标始终正向，原PI/PWM限幅不变。这是初始软件参数，尚未成为实测圆弧参数；未使用未实测轮距来添加弧线前馈。

巡线状态由LF决定差速，避免原直线航向保持和相对起点20°门槛抵消正常转弯。MPU读取/时间/饱和检查仍监测，异常仍YAW停车。GO/GO20/GO100原直线航向与20°保护继续保留。

无有效线的第一帧立即清PI、发零电机命令；不足100ms且恢复有效线时可恢复低速循线，持续100ms锁存LOST或LINE，之后不会自动找线或自动重新启动。锁存故障后需重新居中稳定并发新启动事件。丢线发生在200mm触发点也不当成成功。制动后的轮速停稳和超时沿用原实现；制动时不再进行循线转向。

OFF/STOP、两串口接收故障、ADC/电量、控制间隔、编码器过快/反向、堵转、运行超时、制动停稳超时保留。OLED仍按电气O1～O4显示：OFF末行LF原始值，巡线ON末行`LF1001 S.../200`；巡线日志`LINE RAW=... E100=... C=... VALID=... CENTER=... MODE=LF20`，DPI为`M=LINE G=200`。CENTER是起步用的居中稳定标志，偏离中心但仍有效时可为0；它不表示陀螺仪READY。日志非阻塞，满发送队列不阻塞控制。

## 编译和验证证据

本次只改按键事件、模式选择与帮助文本；LF黑0白1、物理对应、巡线参数、两轮PI、陀螺仪/里程/停车/声光、OLED驱动和GPIO配置继续保留。实际ARM全量编译成功，FLASH33400B、RAM5344B；新增代码无警告，原main未使用函数/变量警告保留。

主机模拟完整验证：不注入RX命令、不初始化蓝牙情况下，按钮选择/校准/启动分别完成一米与20厘米停车提示；长按一次且松手不CAL、OFF短按松开消抖、ON和忙状态按下即响应、抖动/上电长按/跨使能保持抑制、WARM/CAL/RUN/BRAKE取消、无READY和未居中不排队、双串口STOP/RX故障优先、外部CAL取消未决手势、OFF在MPU读后复查、MPU失败/满TX/缺陀螺仪、复位默认和时间回绕。原16码巡线以及GO100/GO20/航向/手动运动回归也通过。这些是软件验证，实车按键操作与循线还未验收。

HEX SHA256：`551f53fb1cf72bced21f6cd86af926ca612e7f8abf30721e5ad7305df7b41b72`。

- [主机验证](/Users/mzh/Desktop/车车/output/固件接入包/T11_纯按键巡线接入包/主机验证.txt)
- [实际工程编译验证](/Users/mzh/Desktop/车车/output/固件接入包/T11_纯按键巡线接入包/工程编译验证.txt)
- [源码差异](/Users/mzh/Desktop/车车/output/固件接入包/T11_纯按键巡线接入包/源码差异.patch)
- [接入记录](/Users/mzh/Desktop/车车/output/固件接入包/T11_纯按键巡线接入包/接入记录.json)
- [修改前源码、固件与完整构建备份](/Users/mzh/Desktop/车车/output/固件备份/Sunward_纯按键选模式前备份_2026-10-11_1x5nd5_w)
