Mu-Miao/Sunward_Data/output/固件接入包/T12_任务二整圈接入包/任务二整圈操作说明.md

# T12：任务二整圈按键启动

> 已更新为[出口里程修正版](/Users/mzh/Desktop/车车/output/固件接入包/T12_半圆出口里程修正版/半圆出口修正操作说明.md)：按实测S1256校准任务二出弧门槛，并保留用户随后改的独立半圆400×π。实际工程当前HEX已同步，本文件及旧HEX保留作历史。

已在实际工程 `/Users/mzh/STM32Cube/Sunward` 修改 dual_pi_test.c/.h 并全量编译。新[Sunward.hex](/Users/mzh/Desktop/车车/output/固件接入包/T12_任务二整圈接入包/Sunward.hex)与[工程当前Debug固件](/Users/mzh/STM32Cube/Sunward/build/Debug/Sunward.hex)一致。尚未替用户烧录或运行车辆。

## 本次路线与保留参数

从A朝B摆车，自动依次走 **A→B直行、B→C黑线半圆、C→D直行、D→A黑线半圆**。B/C/D换段时各提示一次，最终回到A刹车、停稳后再提示一次。中途不用按键换段，不需要蓝牙。

用户已报告独立半圆能行驶并自动停车；本次保留最新半圆参数：长度600×π≈1885毫米、巡航200毫米/秒、起步50毫米/秒、巡线增益64、差速偏移上限80毫米/秒、独立半圆超时45秒。黑线0、白底1，物理左右统一为车尾面向车头，左→右O4/O3/O2/O1；左内侧单独见黑原始1101。

用户确认实际场地半径60厘米，故本版按两段1000毫米直线、两段约1885毫米半圆配置，一圈标称约5770毫米。题目PDF半径40厘米，实际场地与题面不同；本版没有擅自把已跑通的半圆改成40厘米。若之后换到40厘米场地，需重新配置半圆长度。

任务二直线单独设置200毫米/秒，原任务一的一米120毫米/秒不变。当前版本用于首次整圈联调，45秒为异常保护上限，任务二30秒要求仍需实车计时验收。仿真中约207毫米/秒的合成编码器输入能完成整圈及四次提示，不代表实车达到这一速度或用时。

## 现场操作

1. 保持OFF，烧录本包新HEX；也可在VS Code/EIDE打开Sunward，烧录当前Debug产物。
2. 上电默认 `TASK 1 A->B`。OFF下长按KEY_U约2秒并松开，每次只选一个模式：`TASK 1 A->B` → `TEST HALF ARC` → **`TASK 2 ONE LAP`** → 任务一。复位后默认任务一。
3. 从A点将车头朝B，沿AB直线摆正。直线区是白底，任务二启动不要求1001；独立半圆模式仍要求1001稳定居中才能启动。
4. OFF下短按并松开KEY_U，保持车静止约7秒至 `YC READY`。已经READY可以跳过校准。
5. 拨ON，松开按键并等约1秒，再新短按KEY_U启动任务二。拨ON本身不会起步，不要按住键拨ON。
6. 观察它能否由AB进入BC、由BC进入CD、由CD进入DA，最终回到A停车；B/C/D各提示一次，停稳A再提示一次。异常时新短按KEY_U或直接OFF停止。故障后不要在半途直接重新启动：新启动始终从AB开始，应把车放回A再启动。

第一趟直接检查四段衔接。无需再重复独立半圆和原一米验收。

## OLED读数

```text
TASK 2 ONE LAP
YC READY EN ON
RUN BC T8.3s
LF1001 S620
```

第三行是状态、当前段AB/BC/CD/DA和从启动开始的累计秒数；例如RUN BC表示正在第一半圆。第四行LF仍是电气O1/O2/O3/O4原始读数，S是当前段平均编码器里程（毫米），换段时归零。OFF下第四行恢复当前静态读数。

停稳后例如 `DONE DA T29.6s`，累计用时冻结；只有DONE表示本圈完成。LOST/LINE/YAW/TIMEOUT等不是完成提示。回传停在哪一段、最终STATE和时间，以及有无偏离黑线、漏提示、停车是否在A，便于只调整失败的衔接点。

## 自动衔接条件及当前限制

AB/CD使用陀螺仪保持方向，白底不会被当作丢线；累计接近1000毫米（±200毫米试验窗口）后探头连续30毫秒发现有效黑线，才换入半圆并提示B/D。超过1200毫米还没有找到入口则LOST停止，不继续盲走。

BC/DA使用原巡线差速，不叠加直线航向纠偏。接近1885毫米（±200毫米试验窗口）、航向接近对应终点方向（与起始方向相反/相同，误差±20°）、全白连续30毫秒，才确认离开黑线并换段或停车。确认白底的30毫秒内输出零；声光提示本身不阻塞运行。这个判断是里程、航向和黑线终止的组合推断，没有新增场地标记，也没有精确测得车身对顶点的覆盖位置；窗口与提示位置必须现场核对。

半圆中途丢线、全黑或分裂码，仍在第一帧输出零，持续100毫秒锁存LOST/LINE；故障不当终点。半圆超过2085毫米仍未确认离开则LINE停止。末端A按同样终点条件刹车，速度停稳200毫秒后DONE及一次500毫秒提示；制动超过1.5秒未停稳为SETTLE故障。

保留OFF/按键STOP、低电池ADC门槛、定时异常、编码器过快/反转/堵转、MPU失败、双串口STOP/RX故障优先及超时保护。不合入此前待确认的40毫米/秒轮速下限/OLED诊断包，避免改变本轮已跑通的半圆差速。

## 编译与备份

主机验证通过四段整圈、四次声光、最终制动/停稳、三模式按键、无蓝牙命令、16种探头码、早到黑线/丢线/错航向不误换段、缺入口/出口停车、STOP/OFF/双端RX/MPU/FAST/GAP/LOW/ADC/STALL/REV/超时、保持按键与时间回绕。原GO100/GO20/航向/手动运动回归通过。全量ARM编译成功：FLASH34988字节、RAM5360字节；新增代码无警告，原main未使用函数/变量警告保留。

只修改dual_pi_test.c/.h；OLED驱动、主程序、GPIO、MPU、I2C、UART、ioc、EIDE与builder.params经逐字节核对保持原样。源码接入前校验哈希保护并备份完整build/Debug；编译失败会恢复两个源码及构建目录。

HEX SHA256：`5cd99f7eea70d545d5320d46ce686b14b979b472bb759204991e3dfb7a1b66a0`。

- [主机验证](/Users/mzh/Desktop/车车/output/固件接入包/T12_任务二整圈接入包/主机验证.txt)
- [实际工程编译验证](/Users/mzh/Desktop/车车/output/固件接入包/T12_任务二整圈接入包/工程编译验证.txt)
- [源码差异](/Users/mzh/Desktop/车车/output/固件接入包/T12_任务二整圈接入包/源码差异.patch)
- [接入记录](/Users/mzh/Desktop/车车/output/固件接入包/T12_任务二整圈接入包/接入记录.json)
- [修改前备份](/Users/mzh/Desktop/车车/output/固件备份/Sunward_任务二前备份_2026-10-11_henbzfhz)
- [题目来源](/Users/mzh/Desktop/车车/资料/比赛题目/H题_自动行驶小车.pdf)
