Mu-Miao/Sunward_Data/output/固件接入包/T15_任务三启动自动转向包/任务三烧录操作说明.md

# 任务三：初始朝B，陀螺仪自动转向

已按用户确认的“初始朝B”接入模块化Sunward工程。启动先右转约38.66°对准AC，待双轮停稳200ms后执行AC→CB→BD→DA。方向由陀螺仪角度反馈判定；单轮前进转向，内侧轮零目标并清积分。起始方向仍需以A→B作为场地参考。

## 在原项目烧录

下载目标选择Debug，电机使能保持OFF。在 `/Users/mzh/STM32Cube/Sunward` 工程编译/下载即可，STLink已经明确指向 `build/Debug/Sunward.hex`。本包的 `Sunward.hex` 是同一固件副本。下载完成后RESET。

1. 将车放在A点，车头朝B，保持OFF。
2. 从复位默认任务一开始，长按PA0约1.5秒并松手，重复三次，直到第一行显示 **`TASK 3 AUTO START`**。顺序为任务一→独立半圆→任务二→任务三；如果已经在任务二，只需长按一次。每次松手后再按。
3. 保持车身静止，OFF下短按PA0并松手，等待校准完成 `YC READY`。
4. 电机使能ON，等约0.2秒，再短按PA0启动。屏幕先显示 `TURN A`，随后 `WAIT A`，再进入AC。

运行中新按键按下、使能OFF或STOP都会停车。完成/故障后重启，应重新摆回A点且车头朝B，并静止校准。

## 转向与保护

AB=1000mm、半径400mm，目标右转角由 atan2(800,1000) 算出约38.66°。以启动航向为AB基准，AC目标为启动航向减38.66°，不要求陀螺仪起始读数为零。

角度进入±3°范围并稳定30ms后进入停稳阶段；停稳阶段偏离角度范围会重新对正。双轮速度均不超过5mm/s并连续停稳200ms后才能进入AC。启动对正及停稳共用原始4秒/80mm转向预算，停稳另有1.5秒上限。初始转向时间计入整圈40秒，转向里程不计入AC段。单轮转向会带来车身位移，起步位置和轨迹覆盖效果需场地验证。

OLED标题 `TASK 3 AUTO START` 用于确认此次固件版本。启动时第四行 `START Y当前角/目标角`；新增阶段P9为启动对正、P10为启动停稳，旧阶段P0～P8保持编号。故障锁存P8，F8为转向超时/位移越界，F9为停稳超时。具体整车停车原因看第三行。

保留任务一、任务二、原半圆调参、轮速PI、巡线与编码器参数。源码变化见 `source_changes.patch`，本包Core目录给出本次改动文件；完整工程在 `staged_Sunward`。

## 验证

主机ASan/UBSan回归覆盖实际CarApp与兼容入口：启动右转、停稳门槛、偏航重对正、转向里程隔离、启动STOP、整圈五次声光及任务一/二与保护回归。测试注入模拟传感器/编码器数据，不是实车动力学验收。

全量ARM编译链接通过，49个编译单元，FLASH 42800B，RAM 5528B；仅原main未使用诊断函数/变量警告。安装后另核对实际ELF的任务三符号、ELF及解码HEX的新标题，以及ELF导出闪存数据和HEX逐地址一致。安装、备份与哈希见 `安装记录.json`。

本轮未操作硬件烧录或实车测试。现场验收状态沿用实测记录。

本次HEX SHA256：`1ffd841ee4556884f3bc7ad63317c5e35fc3d5fe4c27a321bfc8bd0ce85b1242`。接入前备份：`/Users/mzh/Desktop/车车/output/固件备份/Sunward_任务三启动转向前备份_2026-10-11_uwyslvvc`。
