Mu-Miao/Sunward_Data/output/固件接入包/T16_任务三入弧捕获修正包/入弧修正与烧录说明.md

# 任务三入弧找线修正

用户回报 `LINE CB T13.6s`、`P8 F6 S1319`，确认固件标题 `TASK 3 AUTO START`。停车后移动车身但未复位、未重启，本次P/F/S和时间仍锁存，Y角度和当前探头读数可能已改变。

## 读数定位

F6是入口/出口判定失败。按当前T15代码，真正半圆阶段只有超过1256+200=1456mm才会F6；反向里程是F10，普通丢线是F7/LOST。因此S1319指向C后捕获阶段的超时或超过60mm：此时S尚未重置，仍含AC及衔接里程。CB段名在C停车之后就切换，不能仅凭CB判断已进入巡线半圆。缺少停车瞬间探头日志，尚不能区分本趟触发的是2秒超时还是60mm位移门槛。

主机复现了捕获F6/LINE CB路径，以及停车后推动车辆不会改变P/F/S、Y可以改变；这不等同于重建本趟真实运动数据。

## 修改

原捕获阶段仅固定切线航向前进，只有两个内侧探头同时居中稳定30ms才进入半圆。即使侧边已看到有效黑线也没有巡线纠偏，会存在擦过线而不能居中的路径。

本版捕获阶段：

- 有有效连续黑线、尚未居中：使用原LF巡线反馈，向黑线对正。
- 中间双探头居中：先停下确认稳定30ms，再进入半圆并重建弧段里程基线。
- 全白/无效图样：保留原切线航向的有限前进找线。

保留50mm/s捕获速度、60mm/2秒捕获门槛、20°航向保护、半圆丢线100ms、整圈40秒、初始朝B自动右转及任务一/二全部参数。未扩大盲走范围。C和D都应用同一修正。

## 烧录

电机使能OFF，在原Sunward工程Debug目标编译/下载 `build/Debug/Sunward.hex`；本包 `Sunward.hex` 为同一副本。复位后从默认任务一开始长按PA0约1.5秒并松手，三次选任务三；标题仍为 `TASK 3 AUTO START`。A点朝B、OFF静止短按校准，等 `YC READY`，ON等待约0.2秒后短按启动。

若再次停车且准备记录，保留第三/四行原样读数；若已移动车身，注明Y不是停车角度。操作步骤未改变，标题不能单独区分T15/T16，以新HEX和安装哈希为准。

## 软件验证

新增测试先对修正前真实生产模块执行，偏线纠偏断言失败，证实能检测原缺陷；修正后通过。实际CarApp与兼容入口下任务一/二/三ASan/UBSan回归通过，包括C/D左右偏线纠偏、居中入弧、无效图样航向找线、60mm/2秒门槛及停车后移动数据保持。

全量ARM编译49个单元成功，FLASH42808B、RAM5528B，仅原main未用诊断警告。实际工程源码与修正清单一致，实际ELF/HEX逐地址一致，实际HEX闪存数据与验证过的暂存固件一致，并确认已不同于T15固件。

本轮没有操作硬件烧录或实车运行。修正针对已确认的代码反馈缺失，实物是否能居中捕获、转向位移与点位覆盖仍待现场确认。详见 `安装记录.json`、`source_changes.patch` 和验证日志。

新版HEX SHA256：`23da9869e92293440055de638f9d497271ac0edcf03c16ffbe4800e082063936`。备份：`/Users/mzh/Desktop/车车/output/固件备份/Sunward_任务三入弧修正前备份_2026-10-11_ncqt4d0f`。
