Mu-Miao/Sunward_Data/output/固件接入包/T19_任务三丢线快照包/丢线快照查看说明.md

# 任务三丢线瞬间快照

用户最新反馈 `LOST CB T11.7s`、`P8 F7 S90 Y-1`。用户在询问停车角度时确认“没动”，因此该次读取Y约-1°可以作为停车后角度参考；随后表示已经移动过车身，无法再用原地LF读数还原停车图样。

若从C预期切线位置正常沿半径400mm弧线走90mm，几何上应左转约12.9°。该对照支持排查入弧时转向反馈/轮速跟随，但真实捕获起点、安装偏置及完整轨迹未知，不能仅凭S/Y证明唯一根因。当前缺少失线之前的偏线图样和轮速目标/反馈，本版补足这些数据，不再继续盲调速度或增益。

## 新版界面

标题为 `TASK 3 SNAP V1`，起点摆放、选模式、校准/启动沿用T18：A点朝B，OFF静止CAL，READY后ON短按启动。

F7丢线后屏幕每两秒轮换两页。第三行仍显示LOST CB/DA及锁存时间。

| 页 | 第二行示例 | 第四行示例 |
| --- | --- | --- |
| 第一页 | `LF1111 PRE1101` | `P8 F7 S90 Y-1` |
| 第二页 | `E-100 C-24 PRE1` | `T126/174 V125/130` |

上述值是说明格式的示例，不是此次用户真实丢线的测量结果。

第一页LF：首次无有效线的原始O1～O4图样；PRE：此前最近一次有效线的原始图样。黑为0、白为1，物理左→右对应O4/O3/O2/O1。Y：第一次无效样本的陀螺仪角度，锁存后不随搬车改变；S仍为最终停车时的段里程。

第二页E：此前有效线偏差×100；C：此前左右轮目标差的一半，正表示左轮目标更快/向右纠偏，负表示向左纠偏。PRE1表示此前有有效线记录，PRE0表示没有。T为第一次无效采样前的左/右目标速度，V为该次采样实测左/右速度，单位mm/s。保留左右顺序。

下一次正常运行如果再停，记录两页的第二、第四行及第三行即可；可以先关使能，读数仍显示故障快照，不再被OFF下当前LF覆盖。搬动、改变探头下方图样不会改变已锁存信息。不要在记录前RESET或重新启动；复位、新启动或重新选模式都会清掉该快照。短暂失线后恢复有效线时快照窗口重新建立，最终保留的是导致这次F7的那段失线。

## 修改范围与验证

新增内部快照上下文与前台有界复制：首次无效采样在HALT/清PI/清目标之前保存，最近有效线数据在输出计算后保存。没有新增电机指令、阻塞通信、Flash持久化写入或自动重启。控制参数及核心路线逻辑与T18相同：斜线240、半圆200、转向80mm/s；斜线/半圆加速150/100mm/s²；40秒与丢线100ms仍保持。

新增主机回归验证首次失线存正确目标/实测轮速、F7第一帧零轮和100ms锁存、OFF/推车/图样变化后快照保持、两页≤21字符、暂态恢复后保留下一次失线、新启动清快照。实际CarApp和兼容入口ASan/UBSan全套任务一/二/三回归通过；原时间模型仍33540ms，属于理想假设，不是实车达标。

ARM全量编译49个单元成功。实际ELF含新标题和任务三符号、ELF/HEX闪存内容逐地址一致，实际HEX与验证过的暂存固件一致，并确认不同于T18。安装记录提供备份、哈希和内存用量。

## 烧录

保持电机使能OFF，在原Sunward工程Debug目标编译/下载 `build/Debug/Sunward.hex`；包内 `Sunward.hex` 是同一副本。RESET后长按PA0约1.5秒并松手三次选择任务三，确认标题 `TASK 3 SNAP V1`。此版未代操作硬件烧录或车辆，持续丢线的实物原因尚未确认。

## 安装留档

实际工程与包内HEX SHA256：`6b6888ae88f6665af239a0619bc5759c38842cab49b7c26a5b79183734c7d31a`。FLASH 43824B，RAM 5576B。

安装前备份：`/Users/mzh/Desktop/车车/output/固件备份/Sunward_任务三丢线快照前备份_2026-10-11_mt3d3bmd`。已接入、编译及软件回归通过；用户是否已烧录此版本尚未确认。
