Mu-Miao/Sunward_Data/output/固件接入包/T20_任务三有效线捕获修正包/入弧捕获修正说明.md

# 任务三有效线捕获修正（2026-10-12）

用户本次反馈 `LINE DA T29.2s`、`P8 F6 S1308 Y173`，并确认D点之后刚走一小段就停。29.2秒未达到整圈40秒，F6不是丢线F7；半圆内F6越界要求S>1256+200=1456mm，因此当前配置下本次定位为D后捕获T3_CAPTURE失败。捕获阶段的S仍包含上一段BD及D点转向/捕获路程，进入真正DA半圆后才重设弧段零点；不能将S1308解释为第二半圆已走1308mm。Y173°接近D点预期切线180°，支持用户的动作描述。

原捕获条件只接受连续30ms的正中两路黑。偏心单路或三路连续黑虽然是有效巡线输入，程序也在纠偏，但不能进入半圆；若图样迟迟未成为正中两路，仍触发2秒/60mm的F6。此次未获得停车LF图样及捕获阶段计时，不能确定是时间还是距离门槛，也不能证明该门槛是唯一现场根因。

修正：任务三C/D捕获在连续有效线30ms后进入半圆。有效线仍由既有译码规定为1～3路连续黑，捕获的30ms内继续以50mm/s基础目标巡线纠偏；第一次正中样本不再暂停电机等待。无效样本重置稳定计时，保持原有受限切线接近。确认捕获的转换帧仍清控制器、零输出，之后半圆起步斜坡保持原值。

保留捕获60mm/2秒、捕获航向误差20°、40秒整圈、半圆无有效线100ms、出口里程/航向/白底条件以及电源/轮速/STOP/OFF等保护。单路/三路可用线不能绕过这些限制。任务一/二启动及巡线接口、速度参数均未修改，T19丢线快照保留。

## 软件验证

新增C和D单路/三路非中心图样回归，旧代码无法进入ARC的断言失败，修正后通过。回归检查稳定窗口期间继续纠偏、进入ARC时清弧段里程、失效图样重置稳定计时、全黑/不连续图样拒绝、有效线仍受超时/航向/距离限制。实际CarApp与兼容入口的任务一/二/三ASan/UBSan全套及ARM全量编译通过。理想目标跟随时间模型仍33540ms，假设140mm轮距，不是实车时间验收。

## 烧录

直接在原Sunward工程Debug目标烧录 `/Users/mzh/STM32Cube/Sunward/build/Debug/Sunward.hex`。包内 `Sunward.hex` 为同一副本。任务三标题改为 `TASK 3 CAP V2`，用于核对新固件。RESET后OFF状态长按PA0约1.5秒并松手三次选任务三；A点朝B，OFF静止校准，YC READY后ON等待约0.2秒再短按启动，沿用已有操作。

此版已准备供用户烧录，未代操作车辆。是否消除本次D后停车，仍须下一次正常现场运行确认。

## 安装留档

HEX SHA256：`9b2e0fa9fe35e703034f32b447fdb7068e2b0e8a9dc281fe3c0a5506972fbad7`。实际ELF/HEX逐地址一致，实际/暂存固件一致。FLASH 43804B/RAM 5576B。安装前备份：`/Users/mzh/Desktop/车车/output/固件备份/Sunward_任务三有效线捕获前备份_2026-10-12_mhoryjrf`。
