Mu-Miao/Sunward_Data/output/固件接入包/T21_任务四四圈接入包/任务四烧录与操作说明.md

# 任务四四圈接入（2026-10-12）

用户已报告任务三完成一次，仍担心第二半圆入弧一开始探头没有黑线，要求先完成任务四，之后去场地重复测试。成功运行的总时间、结束OLED和各点覆盖未提供；不能将一次完成认定为稳定性验收。任务三速度与捕获参数保留，本轮不要求额外现场测试。

题目要求（4）：按要求3的路径自动行驶4圈停车，用时越少越好。实现采用A→C→B→D→A重复四圈，继续每点声光提示。题面只作为功能需求来源，保留用户已选STM32 Sunward工程。

## 已接入的行为

新增 `car_task4.h/car_task4.c` 配置模块，共用现有任务三路线核心与车端接口，在原car_app/car_route/car_heading/car_line结构中增加任务四模式。原Motion枚举顺序保留，末尾增加MOVE_TASK4。任务三仍只走一圈且40秒限制；任务四走四圈，160秒整段保护超时。160秒为软件故障保护上限，不是题目给出的任务四达标时间。

仅在A出口已满足里程、白底和末端航向且轮速≤5mm/s持续200ms后增加圈数。前三圈A点短暂停稳、提示，再自动对正AC并进入下一圈，无需按键；第四圈A点停稳后DONE结束。初始仍A点朝B，第一次启动自动右转约38.66°朝AC；后续圈使用同一陀螺仪参考，既不重启核心、不重新校准，也不清总时间/累计里程。各直线/半圆自己的段里程基线仍按阶段更新。

共17次点位提示：启动A一次，四圈分别C、B、D、A各一次。TASK4故障保留已完成圈数，不自动重跑；新启动清圈数及丢线快照。STOP、OFF、电压、时序、串口、陀螺仪、轮速和路线限制均保持。

巡航速度继续斜线240/半圆200mm/s，转向80、捕获50mm/s；加速斜线150/半圆100mm/s²。沿用T20有效连续1～3路黑稳定30ms即可入弧，在确认前继续纠偏；捕获仍受60mm/2秒/20°限制，半圆失线仍100ms停车。未找到黑线不会直接跳进ARC盲走，超过捕获限制仍F6；用户担心的现场入弧稳定性需以后多次测试。

## 选模式与烧录

可在你的原Sunward工程Debug目标正常编译/下载。固件 `/Users/mzh/STM32Cube/Sunward/build/Debug/Sunward.hex`，包内 `Sunward.hex` 为同一副本。菜单顺序：任务一→半圆测试→任务二→任务三→任务四→任务一。

1. 电机使能OFF，RESET后默认任务一。
2. 长按PA0约1.5秒并松手四次，确认标题 `TASK 4 FOUR LAPS`。若当前已经选任务三，只需长按并松手一次。
3. A点车头朝B，OFF状态静止短按并松手校准，等 `YC READY`。
4. 使能ON等待约0.2秒，重新短按PA0启动。圈间不需要操作；忙时再按是STOP。

第三行示例 `RUN 2/4 CB T45.2`，显示当前第2圈、当前段与总运行时间；最后应为 `DONE 4/4 DA T…`。丢线F7继续两秒切换LF/PRE和目标/实测轮速快照，OFF/搬动车不会改变已锁存快照，RESET或新启动会清掉。维护用串口增加TASK4!，正常运行不依赖蓝牙。

## 验证与Git

任务一/二/三/四，CarApp与兼容接口共八套ASan/UBSan回归通过。覆盖四圈与三次A自动接续、固定陀螺仪参考/总时限、17次提示、第四圈最终停稳、后续圈故障/STOP优先级、重启清数、屏幕长度以及毫秒/编码器溢出。理想目标跟随、假设140mm轮距模型四圈133560ms，仅验证调度预算，不是实车时间或动力学结论。

ARM全量50个单元编译链接通过，实际ELF/HEX闪存内容逐地址一致，实际/暂存闪存内容一致，并不同于任务三旧版本。已更新EIDE Debug/Release模块列表，避免漏编或重复编译。FLASH44496B/RAM5576B。

基于用户Git提交 `4334a99`（任务三），改动留在工作区供查看和提交，未创建Git提交或推送。新增任务四模块与测试，另有共用调度/UI/配置及回归更新。安装前备份：`/Users/mzh/Desktop/车车/output/固件备份/Sunward_任务四接入前备份_2026-10-12_57n58mu7`。HEX SHA256：`a7ec941025fe53ac9355d375bbfa957f73480ba1a785292b25c743d9bbf7f52d`。

本轮完成软件接入、构建和验证，未代烧录或操作车辆。任务四四圈实车结果及任务三第二半圆入弧重复性，留待用户之后正常场地测试。
