Mu-Miao/Sunward_Data/output/固件接入包/T25_任务四独立重写包/任务四独立重写与烧录说明.md

# T25 任务四独立重写（2026-10-12）

从Git4334a99/T20干净工作区重新接入。car_task3.c与car_task3.h逐字节保持T20原样；任务四的四圈生命周期独立放在car_task4.c/.h中。Task3单圈控制、参数与40秒时限保持；任务四复用相同的直线、半圆、捕获、出口、转向和停稳算法。

## 四圈生命周期

首次启动仍在A朝B，单圈核心自动右转约38.66°朝AC。路线A→C→B→D→A。单圈核心在A出口及轮速≤5mm/s持续200ms后报告完成，任务四才增加圈数；前三圈在这个零输出状态重新启动下一圈的转向/停稳阶段，第四圈最终停车DONE。

A点接续采用T20首次启动的转向+停稳流程，固定使用最初保存的AC航向参考。重新初始化单圈阶段计时和里程基线，保持车辆总累计里程、任务四总时间和已完成圈数；不重新校准陀螺仪、不用A点当前角度重新定义AC。上一圈A提示保留，下一圈重复的启动A提示被抑制，整段共17次点位提示。

任务四总保护160秒；内层单圈使用80秒故障上限（T20核心允许的上限），避免把任务三40秒比赛时限机械地施加到任务四每圈。160/80秒是软件保护选择，不是任务四题面规定。所有阶段自己的转向、捕获、失线与停稳限制仍保留。STOP/OFF/传感器/电池/轮速等故障停止任务四，不自动重跑，重新启动清圈数。

## 控制参数

任务三与任务四均沿用T20：斜线240mm/s、半圆200mm/s、转向80、捕获50；斜线/半圆加速150/100mm/s²。沿用有效连续1～3路黑稳定30ms的捕获条件，以及60mm/2秒/20°捕获界限和半圆连续无有效线100ms停车。没有加入T22的160/70半圆降速，也没有翻转探头/电机/陀螺仪方向或改PI/巡线增益。

之前现场LOST的完整原因仍未确定。独立重写解决四圈生命周期与单圈核心分离、圈间A转向后停稳、固定参考和重复提示问题；不能据此宣称已消除现场偏线。

## 烧录与显示

在原Sunward工程Debug编译/下载 `/Users/mzh/STM32Cube/Sunward/build/Debug/Sunward.hex`。包内HEX为同一副本。新标题 `TASK 4 REBUILD V1`；任务三仍显示TASK 3 CAP V2。

电机使能OFF，RESET后长按PA0约1.5秒并松手四次选任务四；从任务三只需长按并松手一次。A点车头朝B，OFF静止短按校准，等待YC READY；ON等待约0.2秒，再重新短按启动。前三圈A自动接续无需操作，忙时按键STOP。

菜单任务一→半圆测试→任务二→任务三→任务四→任务一。第三行显示当前圈/段/总时间，最终DONE 4/4 DA。T19快照继续适用于任务三/四的F7，屏幕两秒换页；OFF或搬动车保留锁存，RESET或新启动清除。维护入口TASK4!可用，正常GPIO操作无需蓝牙。

## 验证与Git

八套实际CarApp/兼容入口ASan/UBSan回归通过，涵盖四圈、三次A自动接续、每圈转向+停稳、17次提示、固定AC参考（含A点读数偏移）、总时限、圈数清除、后续圈保护/STOP优先级、毫秒/编码器溢出及屏幕长度。任务三原回归与理想单圈33540ms模型保持。假设140mm轮距的任务四目标跟随模型134190ms，只是软件调度预算，不是实车动力学或稳定性验收。

实际ARM50单元全量构建通过，FLASH44856B/RAM5592B；实际ELF/HEX逐地址一致、实际/暂存闪存内容一致，含CarTask4_Start/Update及新标题。Git diff --check通过，Git对car_task3.c/.h无差异。基准提交仍4334a99，独立重写改动保留未提交，未推送。

HEX SHA256：`27a0f17128f1fd89ba3c4713f3a888617a96db6a55b04dec6e561c6c1db2d4b6`。接入前T20备份：`/Users/mzh/Desktop/车车/output/固件备份/Sunward_任务四独立重写前备份_2026-10-12_0qdc9a1m`。本轮未代烧录或操作车辆；软件完成与实车验收分别记录。
