Mu-Miao/Sunward_Data/output/固件接入包/T29_任务三四转向余量包/转向余量与烧录说明.md

# T29 任务三、四转向余量（2026-10-14）

用户要求暂不处理任务四在 B 点停住的问题，先把当前版本上传 GitHub，再减小任务三、四的转向角度；随后明确 A、B 的斜线对正也一起减少。

## 已先上传修改前基准

当前修改前的 T28 源码、中文注释和测试共 38 个文件已提交并成功推送到 GitHub `main`：

[6473002：任务三四受限寻线与容错基准（T28）](https://github.com/Mu-Miao/Sunward/commit/647300237b77a8ed63d9c459ead725308eb5bc7e)

推送完成、本地工作区干净后，才创建 T29 副本修改角度。T29 已接入实际 Sunward 本地工程；本次新角度修改尚未提交或推送，因此 GitHub 目前保留 T28 回退基准。构建产物沿用仓库原来的忽略规则，固件副本保存在本地交付包。

## 减少哪部分角度

统一新增 `DPT_TASK3_TURN_RELIEF_DEG=5.0f`，任务三与任务四共用。它把原地转向的目标提前 5°，不改变赛道几何、最初保存的 AC 航向参考或白底斜线的目标方向。

按 A 点朝 B、校准角接近 0 的理想几何计算，各处完整转向约为 38.66°，本次原地转向目标约为 33.66°。实际转角还受原来 ±3° 对正容差、起始朝向及转动惯性影响，不能把 33.66° 写成已测得的实际角度。

| 点位 | 原地转向留量 | 随后动作 |
|---|---|---|
| A：AB→AC | 目标由约 -38.66° 改为 -33.66° | 停稳后起步，航向反馈逐步趋向原 AC 方向 |
| C：AC→CB 切线 | 切线目标提前 5°，约 -5° | 低速捕获黑线，读到有效线后由巡线纠偏接管 |
| B：BA→BD | 目标由约 -141.34° 改为 -146.34°，左转少 5° | 停稳后起步，航向反馈逐步趋向原 BD 方向 |
| D：BD→DA 切线 | 切线目标提前 5°，约 -175° | 低速捕获黑线，读到有效线后由巡线纠偏接管 |

任务四每次 A 点接续仍保留第一次启动保存的真实 AC 参考，新的转向留量只用于当前对正目标，不把少转的角度累加到下一圈参考中。C/D 受限顶点寻线也使用对应留量，避免正常转向少转后，搜索流程又强制转满。

A/B 的“减少”指原地转向部分，起步后仍会用航向反馈逐步补齐剩余方向，开始的一小段可能呈缓弯。C/D 少转后的方向会改变探头接触弧线的位置；本次 5° 是首个试调值，不能仅凭软件判断它一定让车身投影或探头更接近黑线。实际偏移、覆盖情况与捕获效果仍需场地验证。

## 参数与保留项目

参数集中在[实际工程 car_config.h](/Users/mzh/STM32Cube/Sunward/Core/Inc/car_config.h)，`DPT_TASK3_TURN_RELIEF_DEG` 设置为 0 可恢复完整几何对正角度；配置检查只接受有限的 0～10°，且正留量必须小于几何转向角。这是角度回退开关，不等于整套固件逐字节回退。

任务一/二控制、轮周长、CPR、PI、正常巡航速度，以及停稳复核、40 秒/160 秒总保护、各阶段时间/距离预算、受限寻线、声光提示和四圈计数保留。没有为暂存的 B 点停车问题另调故障时限，也未认定该故障根因已解决。

## 软件验证、固件和识别

十二套实际模块 ASan/UBSan 回归通过，覆盖 CarApp 与兼容入口。新增验证 A/B/C/D 的留量方向、A/B 原斜线航向反馈逐步收敛、固定 AC 参考不漂移、C/D 少转后低速捕获、停稳门槛、无效留量拒绝和 0° 参数回退。原任务一/二、任务三/四、受限寻线及停车保护回归继续通过。

实际 STM32 50 个单元全量编译通过，FLASH 47392 B、RAM 5664 B。暂存与实际闪存数据一致，ELF 导出的 HEX 与交付 HEX 逐地址一致，`git diff --check` 通过。理想目标跟随模型的任务三为 34610 ms、任务四为 138550 ms，仅是软件模型，不能证明真实场地的用时或投影覆盖。

实际固件：[Sunward.hex](/Users/mzh/STM32Cube/Sunward/build/Debug/Sunward.hex)。相同交付副本：[Sunward.hex](/Users/mzh/Desktop/车车/output/固件接入包/T29_任务三四转向余量包/Sunward.hex)。选择任务三显示 `TASK 3 TURN V2`，任务四显示 `TASK 4 TURN V2`。按键选模式、CAL、使能及短按启动方式沿用原流程。

HEX SHA256：`6ef094d8ff2c5f87662489a0dd8846e5a68b74216b6be017d60ca2f28bc340c8`。

修改前完整 T28 源码及 Debug 固件备份：

`/Users/mzh/Desktop/车车/output/固件备份/Sunward_T29转向余量前备份_2026-10-14_g_johs5b/original`

本次只接入、编译和软件验证，没有烧录或操作车辆。GitHub 基准推送、新角度补丁、安装和测试证据分别见同目录 `GitHub基准推送.json`、`容错修改.patch`、`安装记录.json`、`installed_host_tests.txt` 和 `installed_arm_build.txt`。
