Mu-Miao/Sunward_Data/output/车架模型/车架建模_v19/发给打印同学_v19/底板_v19.png

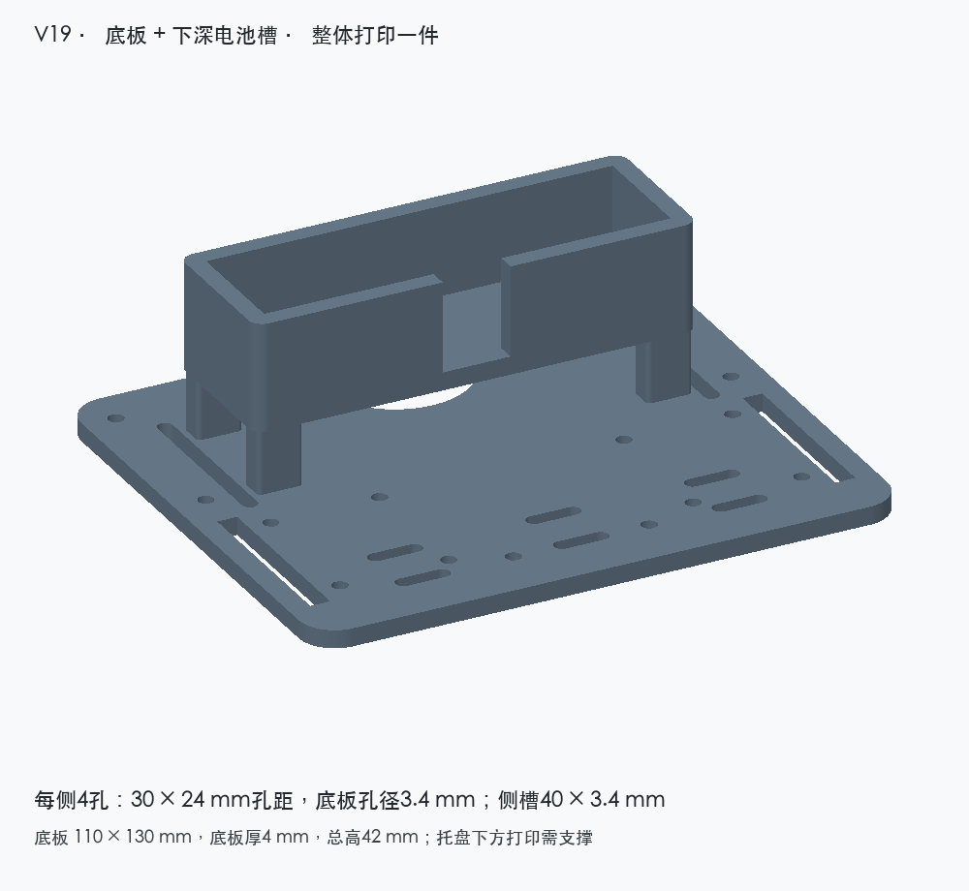
output/车架模型/车架建模_v19/发给打印同学_v19/底板_v19.png
