Mu-Miao/Sunward_Data/output/车架模型/车架建模_v19/支架尺寸原图.jpg

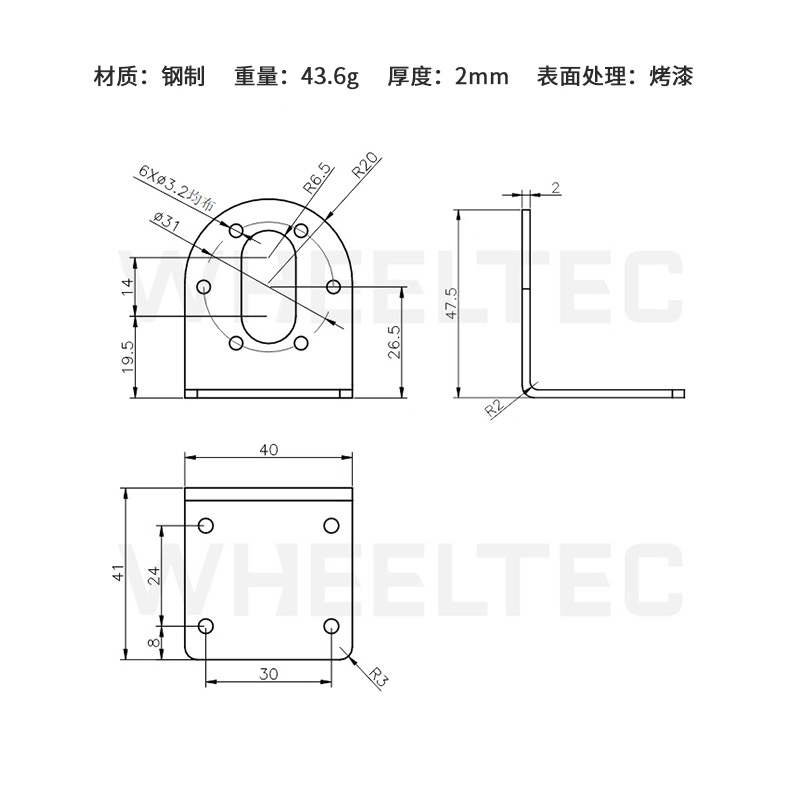
output/车架模型/车架建模_v19/支架尺寸原图.jpg
