Mu-Miao/Sunward_Data/output/车架模型/车架建模_v19/效果图_v19.png

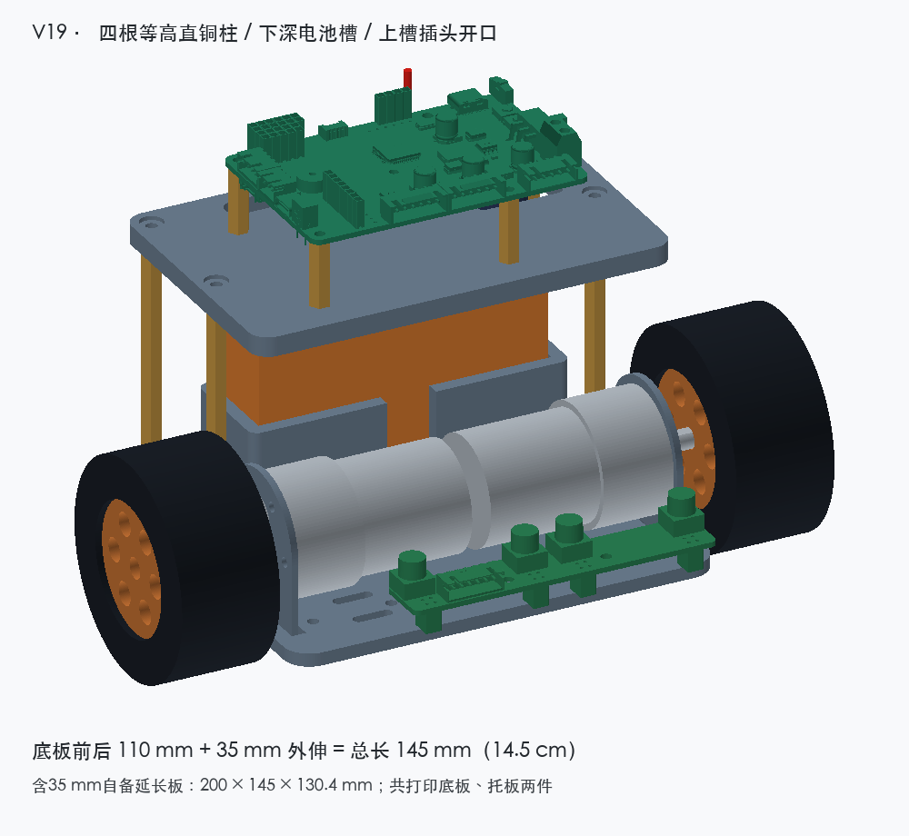
output/车架模型/车架建模_v19/效果图_v19.png
