Mu-Miao/Sunward_Data/output/车架模型/车架建模_v19/电池尺寸原图.jpg

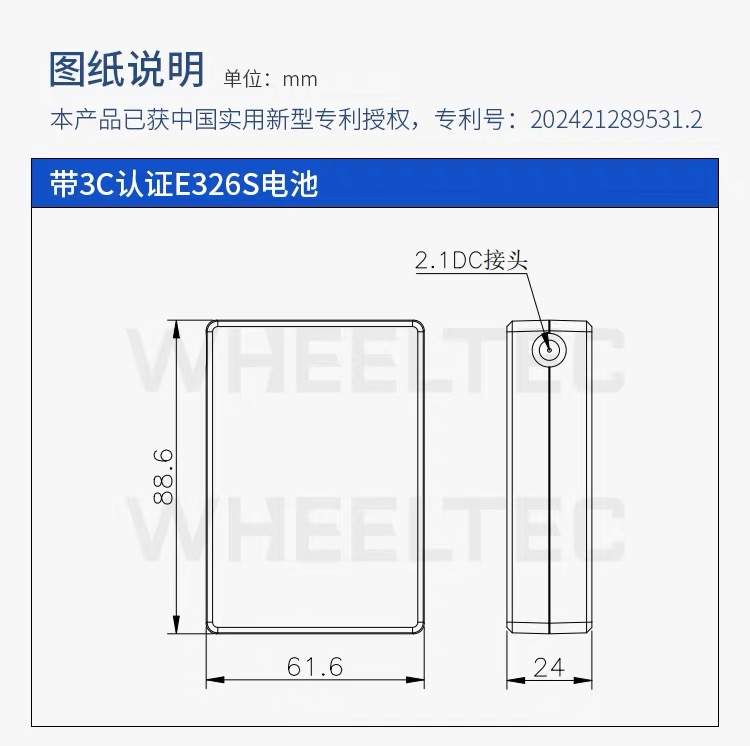
output/车架模型/车架建模_v19/电池尺寸原图.jpg
