Mu-Miao/Sunward_Data/资料/厂家小车套件/小车/5.STM32源码/LD14与LD14P外观区别判断.png

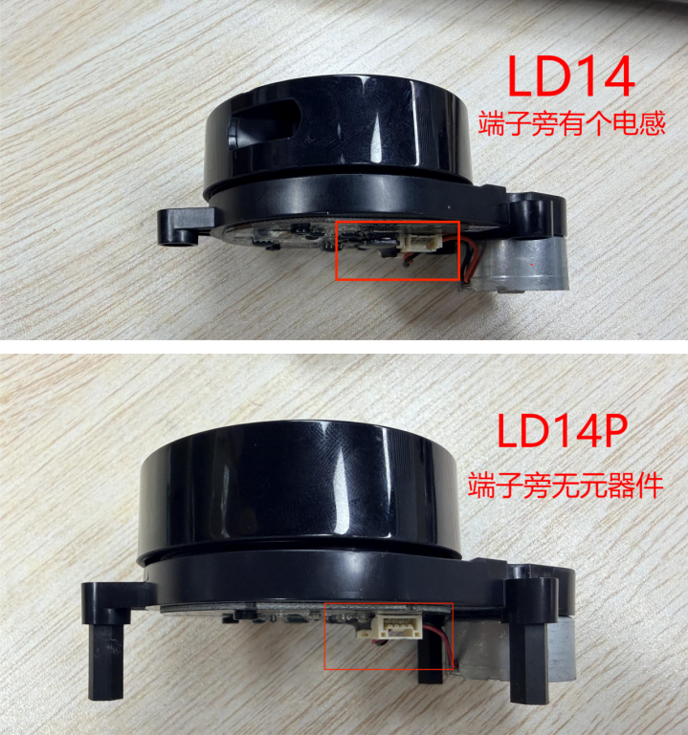
资料/厂家小车套件/小车/5.STM32源码/LD14与LD14P外观区别判断.png
