Mu-Miao/Sunward_Data/资料/厂家小车套件/小车/5.STM32源码/R1_AKM实物图.png

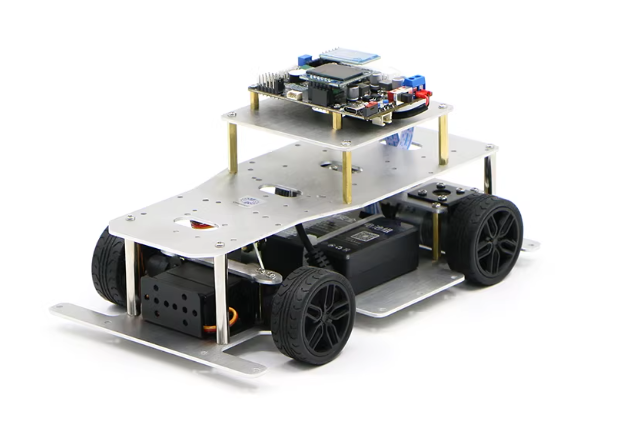
资料/厂家小车套件/小车/5.STM32源码/R1_AKM实物图.png
