Mu-Miao/Sunward_Data/资料/模块资料/【WHEELTEC】LF04四路红外巡线模块附送资料/2.使用手册/LF04安装到轮趣智能小车底盘示意图/R1四驱系列.jpg

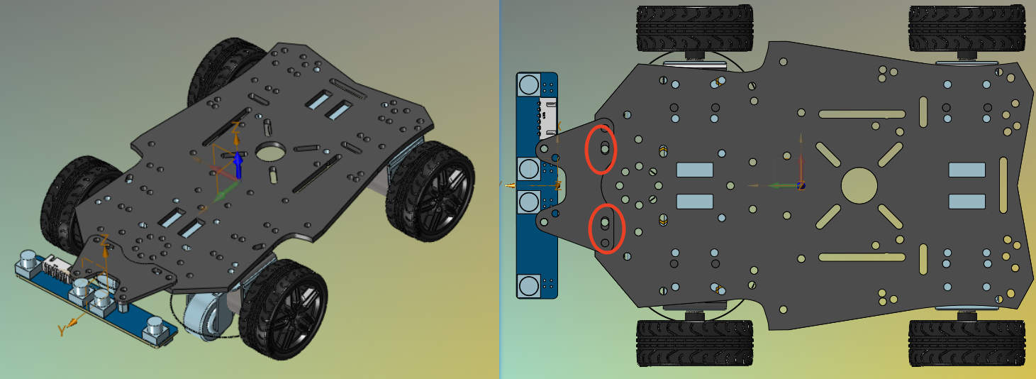
资料/模块资料/【WHEELTEC】LF04四路红外巡线模块附送资料/2.使用手册/LF04安装到轮趣智能小车底盘示意图/R1四驱系列.jpg
