Mu-Miao/Sunward_Data/output/固件接入包/T09_1米直行接入包/下次真实场地测试清单.md

# 下次真实场地测试清单

安排来源：2026-10-10凌晨用户明确要求“先不测这些”，明天到真实测试地点再做。具体公历日期未单独确认；按用户下一次到真实场地执行。今晚不要求下载、CAL或试跑，宿舍坑洼瓷砖测试不作为开发门槛。

当前已接入但未实测的一米版本：本目录Sunward.hex，GO100目标1000mm，巡航目标120mm/s，起步渐增、最后100mm减速、停稳后声光一次500ms。桌面GO20已有尺测约20.2cm、编码器估算20.1cm，不重新调PI或轮周长。独立按键启动尚未接入；若后续接入，需要先更新本清单的最终固件版本，再去现场。

## 到场后按顺序做

1. 保持OFF，确认使用最终准备好的固件，保存版本及日志。重新上电后静止CAL到READY N=500，观察校准是否正常。
2. 正式场地先做一趟GO20短距离，核对偏向、抖动、自动停车、尺测距离及日志S；不重做整套单轮PI实验。
3. 再做GO100一米直行，记录同一车体参考点的实际位移、是否偏向/抖动、运行时间、停点以及两灯/蜂鸣器是否提示一次；保存完整日志。途中异常用STOP或OFF，按故障证据处理。
4. 以后续独立按键版本为准，验证无需电脑发GO即可启动、重新上电不会自行运动、OFF与STOP有效。
5. 有真实黑白线时补LF04四路黑白原始读数、物理左右顺序、安装高度与阈值，之后才做弧线巡线。

本轮先获取现场数据；完整A→B验收另要求起点摆放一致、车体覆盖B、声光、≤15秒、连续3次成功且保留至少5次记录。只有软件编译通过或桌面20cm成功不等于这些项目已通过。

## 今晚可继续的准备

优先接PA0按键独立校准/启动，处理消抖、上电不自走、运行时停车与重复按键；准备LF04静态读数与数据表，整理最终固件及参数备份。缺失的轮距、探头前伸量等机械尺寸可以补记录，正式地面参数留待现场再定。

## 2026-10-11现场进展

用户已到场并报告第一趟GO20实际约19.7cm，较目标少约3mm。最终S、偏向/抖动及自动停止观察尚未回传，未判全部通过。先保持参数；实车平顺且自动停下后继续GO100一米与声光验证，独立按键仍未接入。

## GO100首趟结果（2026-10-11 15:51）

[日志](/Users/mzh/Downloads/records-2026-10-11-15-52-40.json)显示起步渐增、末段减速、BRAKE→DONE、S=1001mm、SIG=1→0，命令到首次DONE报告约10.5秒，无故障。用户实物反馈明显右偏，怀疑轮子螺丝松；直行尚未通过，实际距离/声光实物表现未确认。先OFF断开电机电源检查轮毂与轴、电机架、轮胎侧摆、从动轮和主板固定，再对准起始朝向。先保持固件参数；机械固定恢复后先GO20再一米，不把陀螺仪朝向小误差当成横向位置已纠正。

用户补充：右偏距离未知，车头没明显转动，电机没晃动。暂不认定螺丝松动；优先用直尺对准起步中心线，保持参数做一次有参考方向的GO100，区分初始斜向右与保持朝向的横向滑移。电机不晃动不是轮毂/轮胎全部排查完成的证据。

## GO100第二趟结果（2026-10-11 16:05）

[本次日志](/Users/mzh/Downloads/records-2026-10-11-16-05-47.json)显示重新CAL成功、起步渐增、末段减速及BRAKE→DONE，最终S=1001mm（SL=1002、SR=1000），SIG=1→0，RXE/TXD=0，无故障。命令到首次DONE日志约10.46秒。用户确认尺测102cm、肉眼无偏移、自动停下、灯和声音都有；本趟可记为直行停车声光初步成功。实际比目标多约2cm，比编码器估算多约1.9cm；先保持参数，同一起点和参考点再做两趟确认重复性。先前右偏原因未唯一确认，独立按键启动尚未接入，完整路线验收仍未完成。

## GO100第三趟结果（2026-10-11 16:18）

[日志](/Users/mzh/Downloads/records-2026-10-11-16-20-42.json)：本次CAL约7.2秒至READY，后续一直READY；GO100约10.48秒至首次DONE报告，最终S=1001mm，SIG=1→0，无故障。用户尺测101cm并确认无明显偏向、自动停车、声光都正常。前一趟102cm、本趟101cm，已有两趟连续正常；先保持参数，同一起点/参考点再一趟确认三趟连续正常。未重启且READY时无需重复CAL。此前CAL一直NONE的原因不在本次成功日志中，尚未唯一确定；完整路线及独立启动未全部验收。

## GO100第四趟及三次距离汇总（2026-10-11 16:23）

[本次日志](/Users/mzh/Downloads/records-2026-10-11-16-24-20.json)：CAL到READY，GO100起步渐增、末段减速、BRAKE→DONE/SIG=1→0，最终S=1001mm，无故障，命令到首次DONE报告约10.39秒。尺测102cm，用户确认自动停车和声光正常；最新补充为轻微右偏，起始摆放角度影响未排除。最近三趟尺测102/101/102cm，日志S均1001mm，用时约10.4秒，停车声光均确认正常。定距停车声光与距离重复性初步成立；不把本趟写成完全无偏移，不将覆盖B或独立启动等未验证项标成通过。先保持参数，暂停追加同类GO100短跑，下一项接独立按键启动。

## 当前后续版本：按键独立启动（2026-10-11）

实际工程的当前HEX已更新为[按键启动版](/Users/mzh/Desktop/车车/output/固件接入包/T10_按键独立启动接入包/Sunward.hex)，与本T09目录的旧HEX不同。本目录原版本和历史场地结果继续保留；最新操作以[按键启动说明](/Users/mzh/Desktop/车车/output/固件接入包/T10_按键独立启动接入包/按键启动操作说明.md)为准。OFF短按KEY_U校准，LED1常亮后ON等1秒再短按启动GO100；运行中再按停车。软件验证和完整ARM编译通过，未代为烧录或实车验收。OLED未接入，原运动参数保持。
