Mu-Miao/Sunward_Data/output/车架模型/车架建模_v19/exports/car_assembly_v19.step

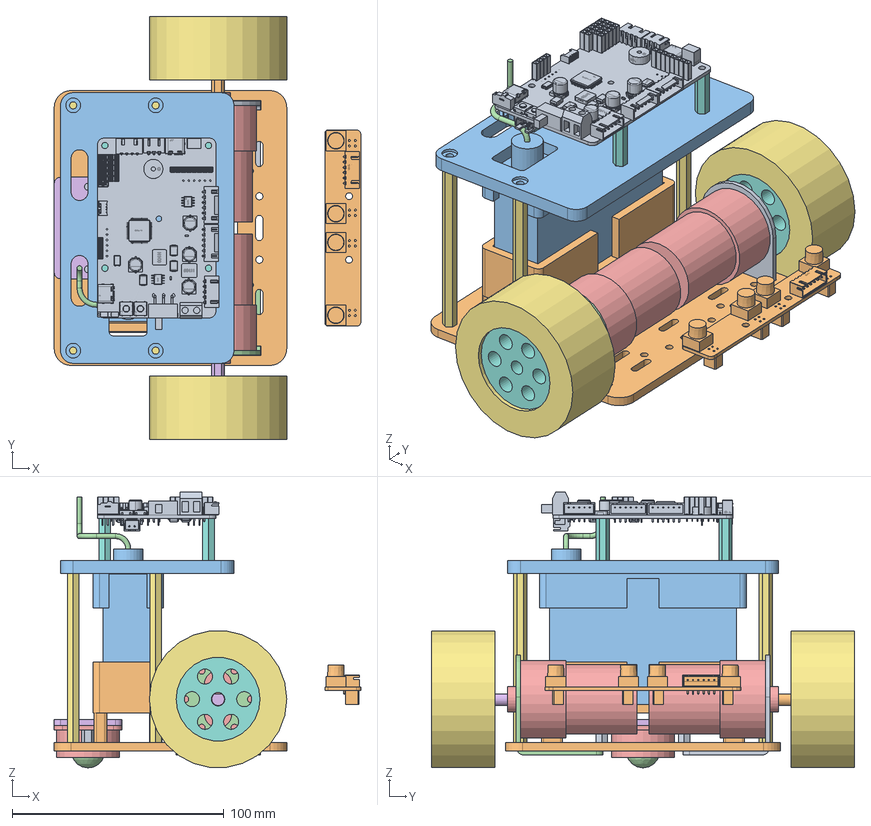
[picture p26: CAD file, 2026-10-14]
output/车架模型/车架建模_v19/exports/car_assembly_v19.step
145.0 x 200.0 x 130.4 mm
01_base_battery_tray
02_controller_deck_redesigned_82x128
05_bracket_40x41_right
06_MG513_envelope_right
07_motor_shaft_right
08_tire_right
09_wheel_hub_right
05_bracket_40x41_left
06_MG513_envelope_left
07_motor_shaft_left
08_tire_left
09_wheel_hub_left
10_battery_upright_30x90x60
12_C10B_original_STP_reference
16_rear_ball_caster_ball_provisional
19_rear_ball_caster_housing_provisional
17_rear_ball_caster_mount_bridge_provisional
03_deck_post_1_M3x80+6
03_deck_post_2_M3x80+6
03_deck_post_3_M3x80+6
03_deck_post_4_M3x80+6
04_pcb_post_1_M3x20+6
04_pcb_post_2_M3x20+6
04_pcb_post_3_M3x20+6
04_pcb_post_4_M3x20+6
18_rear_bridge_post_right_M3x6+6
18_rear_bridge_post_left_M3x6+6
20_LF04_user_extension_position_reference
13_DC_plug_height12_reference
14_power_cable_route_reference
