Mu-Miao/Sunward_Data/output/车架模型/车架建模_v19/发给打印同学_v19/02_C10B上托板_插头避让_打印1件.step

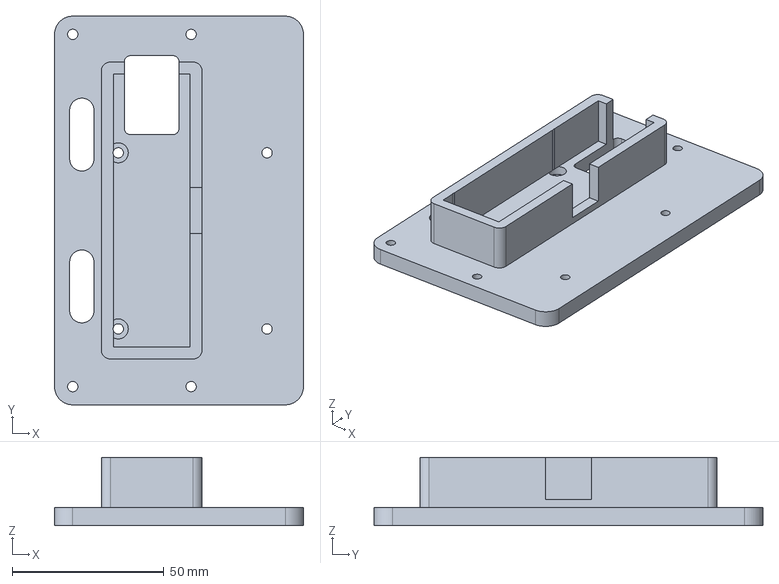
[picture p27: CAD file, 2026-10-14]
output/车架模型/车架建模_v19/发给打印同学_v19/02_C10B上托板_插头避让_打印1件.step
82.0 x 128.0 x 22.4 mm
