Mu-Miao/Sunward_Data/资料/模块资料/【WHEELTEC】LF04四路红外巡线模块附送资料/5.三维模型/四路红外巡线模块（含亚克力）.stp

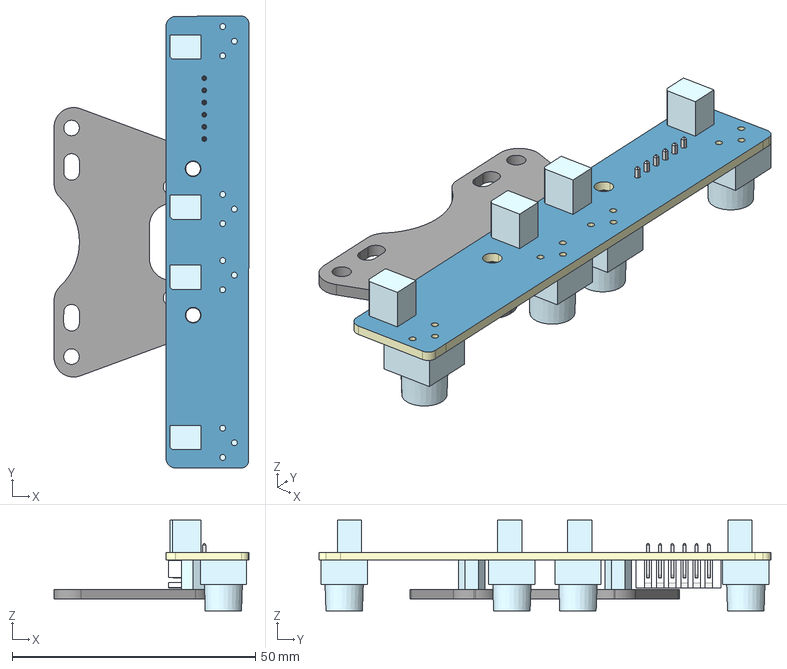
[picture p28: CAD file, 2026-10-14]
资料/模块资料/【WHEELTEC】LF04四路红外巡线模块附送资料/5.三维模型/四路红外巡线模块（含亚克力）.stp
40.1 x 92.9 x 18.6 mm
3D_PCB_四路红外巡线模块_2025-04-24_1_2
M3-6 六角铜柱_1_2 x 2
连接支架1_1_2
