Mu-Miao/Sunward_Data/output/车架模型/车架建模_v19/exports/01_lower_base.stl

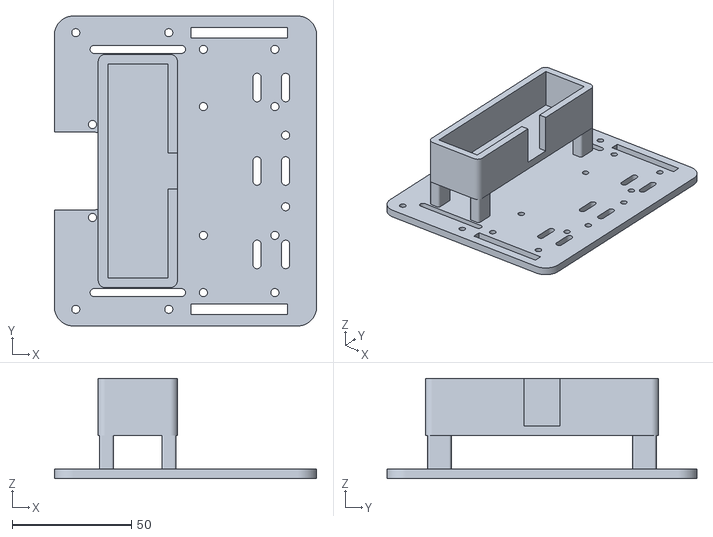
[picture p29: CAD file, 2026-10-14]
output/车架模型/车架建模_v19/exports/01_lower_base.stl
110.0 x 130.0 x 42.0
