Mu-Miao/Sunward_Data/资料/模块资料/【WHEELTEC】LF04四路红外巡线模块附送资料/5.三维模型/LF04四路电磁巡线（自研）.stp

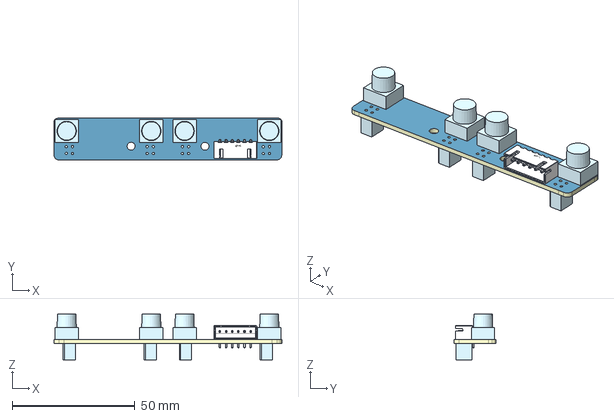
[picture p30: CAD file, 2026-10-14]
资料/模块资料/【WHEELTEC】LF04四路红外巡线模块附送资料/5.三维模型/LF04四路电磁巡线（自研）.stp
92.9 x 17.0 x 18.6 mm
