Mu-Miao/Sunward_Data/(list of files, cad)

Other CAD files:
output/车架模型/车架建模_v19/发给打印同学_v19/01_下底板_实际电池槽_打印1件.step
output/车架模型/车架建模_v19/car_assembly_v19.FCStd
output/车架模型/车架建模_v19/发给打印同学_v19/02_C10B上托板_插头避让_打印1件.stl
