Mu-Miao/Sunward_Data/小车调试实测记录_2026-10-07.md

# C10B小车调试实测记录

整理日期：2026-10-07；更新至2026-10-11。资料来源：本次聊天中你报告的实测结果、你上传的串口截图及日志，以及整理时核对的Sunward工程代码。

工程：`/Users/mzh/STM32Cube/Sunward`

说明：本文分别标明“你实测确认”“代码配置”“计算估算”和“待验证”。代码或计算正确，不等于实物波形、测量精度已经验收。没有提供过的数值留空。

## 1. 当前最重要的结论

| 项目 | 当前记录 | 证据/状态 |
|---|---|---|
| 使能开关ON | PC13原始值为0 | 你实测确认 |
| 使能开关OFF | PC13原始值为1 | 你实测确认 |
| 右轮电机 | A，正命令向前，例：`+1200` | 你最后确认 |
| 左轮电机 | B，负命令向前，例：`-1200` | 你最后确认 |
| 左轮编码器 | TIM8，向前时增量为正 | 你最后确认 |
| 右轮编码器 | TIM4，向前时增量为负 | 你最后确认 |
| 轮胎外径 | 65mm；计算周长约204.2mm（0.2042m） | 你提供直径；周长为π×直径估算，尚未分别确认左右轮及负载下滚动周长 |
| TIM2节拍 | 已能持续正常输出节拍日志 | 你确认“ok 正常输出” |
| MPU6050偏航轴 | Z轴；按站在车尾面向车头，左转正、右转负 | 原始日志＋你确认先左转 |
| MPU6050静止GZ候选 | 14:13测试约-423 raw | 初始和结束均静止；后续正式校准见下一行 |
| MPU6050正式校准 | 15:28：BIAS_Z=-424.44、SPAN_Z=31；15:33重启后：BIAS_Z=-424.00、SPAN_Z=27 | 两次均显示CAL OK；15:33此前有一次CAL UNSTABLE |
| MPU6050静止漂移 | 最新15:43复测：30秒+0.03°，31.4秒+0.04°；此前15:38：30秒+0.01°、62秒+0.11° | 你确认最新复测从Reset松手后全程没有碰车或拉线，30秒漂移检查已完成；此前校准时碰过车 |
| 电池标称电压 | 12V | 你提供 |
| 电池万用表实测 | 11.94V | 你提供 |
| 电池开关ON、USB连接 | `BAT_RAW=1349～1355` | 你提供 |
| 电池开关OFF、USB连接 | `BAT_RAW≈484` | 你提供 |
| LF04黑白标定 | 暂缓，未填黑白数据表 | 当时没有白底黑线 |

## 2. 左右轮、电机方向、编码器方向

### 2.1 最后有效的映射

左右统一按你最新确认的观察方向定义：**站在车尾，面向车头**，即坐在车上朝前看的左右。

| 你命名的轮子 | 电机通道 | 向前的电机原始命令 | 编码器 | 向前的原始增量 | 统一成“向前为正”的处理 |
|---|---|---|---|---|---|
| 左轮 | B | 负，例如`-1200` | TIM8 | 正 | 左轮增量=`d8` |
| 右轮 | A | 正，例如`+1200` | TIM4 | 负 | 右轮增量=`-d4` |

据此，后续使用“左右轮目标为正表示前进”时：

```text
左轮前进命令 -> B取负号
右轮前进命令 -> A取正号
左轮前进编码器增量 -> d8
右轮前进编码器增量 -> -d4
```

电机命令符号和编码器符号是两件不同的事，应分别处理。

### 2.2 观察方向的确认

你曾说明：“我的左轮是从车头往后看的左边。”本次整理时再次向你确认，你最新答复为“站在车尾，面向车头”。因此先前观察方向已修正，本文全部左右按最新答复统一。接线和贴标签时，保留这一观察方向。

### 2.3 已被后续结果取代的说法

对话中先后出现过“左TIM4、右TIM8”和相反的编码器符号；最终以“左TIM8为正、右TIM4为负”为准。早期“A在1200时向后转”的描述，也以你后面明确确认的“A是右轮，+1200向前”为准。

### 2.4 每圈计数的第一轮手转记录（16:20～16:21）

数据来源：[records-2026-10-07-16-21-35.json](/Users/mzh/Downloads/records-2026-10-07-16-21-35.json)。共591条编码器日志，记录约58.936秒。你确认每段意图转轮胎一整圈，但没有做标记，存在对齐误差。关于另一轮及车身是否保持不动、末段是否碰轮子/搬车/碰线，你答“可能没有”，具体条件仍不明确。

按明显转动与停顿划分，下表是各段带符号delta的累计值；“每圈”仍待有标记的复测确认：

| 轮子 | 段 | 时间窗口 | 对应编码器累计增量 |
|---|---|---|---:|
| 右轮 | 1 | 16:20:37～16:20:43前 | d4=-62351 |
| 右轮 | 2 | 16:20:44～16:20:49前 | d4=-61645 |
| 右轮 | 3 | 16:20:50～16:20:55前 | d4=-64686 |
| 左轮 | 1 | 16:21:08～16:21:12前 | d8=+59991 |
| 左轮 | 2 | 16:21:14～16:21:18前 | d8=+59662 |
| 左轮 | 3 | 16:21:19～16:21:25前 | d8=+61688 |

右轮三段绝对值平均62894，最小61645、最大64686，最大最小差约为平均值的4.84%；左轮平均60447，最小59662、最大61688，最大最小差约为平均值的3.35%。**这些只是本轮累计计数的统计，不作为已验收的CPR，不写入速度控制常数。**

方向与此前映射一致：主要右轮转动d4为负，主要左轮转动d8为正。右轮第2、3段期间，另一通道d8分别累计+1337、+1005；原因可能涉及实际轮子移动或输入信号，需要静止条件下检查，不能直接归因于串扰或接线故障。

当前工程核对：TIM4/TIM8均Encoder TI12、PSC=0、ARR=65535、IC1/IC2分频DIV1、滤波10，编码器GPIO为输入无内部上下拉；Lab_Delta16处理16位回绕，Lab_PrintEncoders每100ms读取并更新前值。相邻日志中的TIM4计数差全部与d4一致；TIM8只有最开始两行存在一次差4而d8为0的情况，后续计数差与d8一致。主要转动段未出现接近半量程32768的单次delta，因此未见主要分段因16位回绕算法而丢掉整圈计数的证据。

下一步：轮胎和车架分别做对齐标记，架空并固定车身；保持点动关闭，从静止开始，单独手转一个轮子按前进方向整整一圈，回到标记处停下，重复3次，每次间隔至少3秒；另一轮保持不动。开始和结束都留至少10秒完全不碰车、轮子或线的静止记录。分别确认左右外径是否均65mm。先用复测确认重复性和静止计数，再接速度闭环。

### 2.5 每圈计数的第二轮复测（16:28～16:29）

数据来源：[records-2026-10-07-16-29-29.json](/Users/mzh/Downloads/records-2026-10-07-16-29-29.json)。共498条编码器日志，记录约49.630秒。本轮按上一轮建议进行复测；是否每段均有标记对齐整圈、左右轮外径均为65mm，待你确认。

| 轮子 | 第1段带符号计数 | 第2段 | 第3段 | 绝对值平均 |
|---|---:|---:|---:|---:|
| 右轮TIM4 | -60007 | -60344 | -59638 | 59996.33 |
| 左轮TIM8 | +60292 | +60013 | +60008 | 60104.33 |

右轮分段：16:28:40.630～46.129、48.029～52.229、55.029～59.129。左轮分段：16:29:06.529～10.629、12.529～16.029、17.729～21.029。以上均按各段带符号delta累计，反向小幅修正按负号计入，没有把所有delta的绝对值相加。

右轮最大最小差706，约为平均值的1.18%；左轮最大最小差284，约为平均值的0.47%。相比上一轮4.84%、3.35%，本轮重复性明显改善。

所有三段主要右轮转动期间，d8均为0；所有三段主要左轮转动期间，d4均为0。可见停顿段的情况：

| 停顿段 | 记录时长约 | 日志条数 | 两路delta |
|---|---:|---:|---|
| 16:28:38.629～40.529 | 1.9秒 | 20 | 均为0 |
| 16:28:59.229～16:29:06.429 | 7.2秒 | 73 | 均为0 |
| 16:29:21.129～28.228 | 7.1秒 | 72 | 均为0 |

文件开头两条TIM4计数从21027变22367，但第二条d4=0，未满足相邻日志差值一致性，故不把这次变化纳入任何一圈；其后相邻计数差均与两路delta吻合。开始和结束未记录满此前建议的10秒，但上述停顿段已经有稳定零计数证据，无需仅为凑足10秒而重做整套测试。单次delta最大绝对值为TIM4的5065、TIM8的4123，均未接近16位有符号差值的半量程限制。

若你确认每段均对应有标记的一整圈，则可先使用本轮平均值作为首版实测换算：右轮CPR约59996，左轮约60104，轮周长按65mm直径估算为0.2042035m；左轮正向增量=d8，右轮正向增量=-d4。以上保留手动对齐和轮径测量的误差，后续可用多圈或负载滚动距离进一步校核。目前未改动Sunward代码中的控制参数，也未启动速度闭环。

### 2.6 下一步：10ms轮速读取诊断，代码已准备

已准备[9.5第一步：测轮速](/Users/mzh/Desktop/车车/output/固件接入包/9.5_轮速测量接入包/9.5_第一步_测轮速.md)，包含wheel_speed_diag.h/.c及main.c三处接入位置。暂按第二轮复测的平均计数和65mm轮径换算；物理整圈与左右轮径确认仍保留为前提，不将未确认参数写成最终标定。

TIM2发布10ms节拍，主循环读取两路计数，以DWT实际间隔统计；每约500ms打印窗口平均左右速度（mm/s）、样本数N、间隔范围DT和遗漏节拍MISS。右轮计数取负，左轮保持正，使前进速度都为正。该诊断不调用电机驱动，不运行PI。

在临时目录中按指南改动main并添加模块，全工程ARM编译、链接通过；主机模拟检查通过方向、静止输出、计数器/节拍/DWT回绕、实际时间换算和遗漏节拍统计。Sunward原文件未自动修改，未下载到硬件。等待你手动接入后提供静止、慢转、快转、反转的实物日志，再决定速度控制接入。

### 2.7 轮速诊断首次实物日志（17:50～17:51）

数据来源：[records-2026-10-07-17-51-17.json](/Users/mzh/Downloads/records-2026-10-07-17-51-17.json)。共119条SPD输出，串口时间戳17:50:13.300～17:51:12.711，跨度约59.411秒。文件未包含启动日志，但连续轮速输出证明轮速诊断已实际运行。

| 项目 | 本文件结果 |
|---|---|
| 左轮打印速度范围 | -349～+321mm/s |
| 右轮打印速度范围 | -273～+495mm/s |
| 两轮同时显示0 | 33条 |
| 每个窗口读取次数N | 50或51；50共46条，51共73条 |
| 窗口内读取间隔DT | 所有119条均为9999～10000µs |
| 遗漏节拍MISS | 所有119条均为0 |

先有右轮通道正、负速度变化（约17:50:16～42），此阶段L始终为0；随后左轮通道正、负速度变化（约17:50:45～17:51:10），此阶段R始终为0。较大的速度幅值与较小幅值均有记录，支持诊断能区分两路、两个方向和速度大小；具体哪段是你实际手转的前进、反转、快转、慢转尚未逐段标注，不根据日志反向宣称操作已全部确认。

若仍使用已提供的诊断代码，速度为约500ms窗口的净计数平均，整数mm/s输出；不足半mm/s可能显示0，因此0不能单独证明编码器每一次读取都没有增量。N=51可以由实际周期略小于10ms、累计到500ms阈值需多一个采样产生，是该窗口实现的正常现象。DT是该诊断窗口累计的读取间隔范围；本轮MISS=0说明该诊断未发现节拍积压，不等同于未来增加PI、其他任务后仍必然无漏拍。

本轮数据有用，可验证当前轮速输出、两路分离和诊断读取时序。无需仅为这些项目重做同样手转测试。首版CPR及65mm轮径仍需物理整圈与左右轮尺寸确认；绝对m/s精度尚未用滚动距离/时间校核。本文件没有目标轮速、驱动命令或PI输出，不能据此验收电机速度闭环或选择Kp/Ki。下一阶段是接入受控的单轮低速闭环测试及目标/实际速度、驱动和停车状态日志。

### 2.8 右轮短时P闭环测试代码已准备，尚未实物运行

见[右轮P测试操作指南](/Users/mzh/Desktop/车车/output/固件接入包/9.5_右轮P闭环测试包/9.5_第二步_右轮P测试.md)。新增right_p_test.h/.c，main三处替换；CubeMX无需新增配置。代码只驱动右轮A正向，左轮B制动，Reset不自动启动，串口完整命令RUN!才启动，STOP!或使能OFF停车。

首轮试调值：目标60mm/s，Kp=24 PWM计数/(mm/s)，Ki=0，命令上限1800，最长3秒。零速度时初始P命令1440；参数属于初始试调，不是实测最终增益。CPR及轮径暂按前述复测结果和65mm估算。运行中发现ADC失败、BAT_RAW低于1200、漏拍/明显间隔异常、持续反向、超速或低速不动时制动；UART失败也制动并退出诊断。1200的ADC门槛约10.64V，是本轮台架条件，不是电池截止标准。

临时main全工程ARM编译和链接通过；主机模拟启动、限幅和各项停车条件通过。未自动修改Sunward或下载到车上。等待用户固定架空实物测试，记录是否转动、方向、目标/实际速度、驱动输出、STOP和OFF停车表现。软件测试不替代实物制动验证，也不能保证MCU停死后的断电，必要时使用电池主电源开关。

### 2.9 右轮P=24首次实物闭环日志（18:15）

数据来源：[records-2026-10-07-18-16-00.json](/Users/mzh/Downloads/records-2026-10-07-18-16-00.json)。共115条记录：111条RPI输出，4条串口发送记录。现场工程头文件仍为目标60mm/s、Kp=24、最大1800、最长3秒、Ki=0。

| 测试 | 命令与结果 |
|---|---|
| 第一次RUN! | 18:15:39.878发送，随后15条RUN；V=35～46mm/s、打印值平均39.53，U=329～607；18:15:42.943显示DONE、U=0 |
| 第二次RUN!/STOP! | 18:15:44.345发送RUN!；11条RUN，V=35～44mm/s、打印值平均40.00，U=386～599；18:15:46.628发送STOP!，46.743输出STOP、V=0、U=0 |
| 第三次RUN!/OFF | 18:15:56.146发送RUN!；3条RUN，V=38～43mm/s，U=411～533；56.942输出OFF、U=0、V=23，57.142起V=0 |

首次DONE时V=-10mm/s，下一行回0；可能包含停止后的回弹或短暂计数变化，不能仅凭一行认定方向故障。OFF时首条V仍为23、U已经为0，随后V回0，表明驱动撤掉与轮子停稳不是同一瞬间；不能把UART行间隔当作精确制动时间。

全文件BAT_RAW=1352～1361，打印时最近一次DT=9997～10001µs，未见LOW、ADC、GAP、REV、FAST、STALL或UART故障状态。RUN中输出未达到1800上限。目标60，采样到的运行轮速多为35～46，存在约20mm/s的速度差；符合纯P控制需要非零误差维持驱动的表现，不能写成已经准确跟随目标。此200ms打印只是每次最近一拍轮速，并未记录全部10ms反馈，不能据此排除拍间振荡。

你确认实际右轮向前、左轮不动，3秒自动停、STOP!和使能OFF均能使右轮停下；本轮单轮映射及三种停车行为已经得到实物确认。进行Kp=32的下一轮对照：仅改RPT_KP，目标60、上限1800、时长3秒、Ki=0保持不变，固定架空，重复两次RUN!并留停顿。Kp=32为根据本轮偏差选取的试调值，不是最终增益；零速度理论P输出1920，被上限限制为1800。

### 2.10 右轮P=32实物对照（18:23）

数据来源：[records-2026-10-07-18-23-53.json](/Users/mzh/Downloads/records-2026-10-07-18-23-53.json)。共70条串口记录，含2次RUN!发送；开头读记录有两条OFF文字粘连和一段截断文字，按已知状态拆分可提取69条完整RPI输出，不把粘连的OFFRPI当成固件新状态。两段RUN各15条，不受开头粘连影响。

现场头文件已核对P=32、Ki=0，目标60mm/s，上限1800、时长3秒保持原样。

| 测试 | 运行打印值 | 结束 |
|---|---|---|
| 18:23:40.658发送RUN! | V=40～52mm/s，打印平均44.47；U=265～634 | 18:23:43.723显示DONE、U=0，短暂V=-4后回0 |
| 18:23:46.991发送RUN! | V=42～49mm/s，打印平均46.60；U=341～580 | 18:23:50.123显示DONE、U=0，短暂V=-2后回0 |

BAT_RAW=1345～1357，打印时最近一次DT=9997～10000µs；未见LOW、ADC、GAP、REV、FAST、STALL或UART故障状态。运行输出没有到1800上限。相较P=24时约39.53、40.00mm/s，P=32的速度提高了，但仍差约13～16mm/s才到目标。200ms采样打印未显示大幅速度跳变，不代表已经验证每一拍无振荡；不能把打印均值当作完整采样平均或绝对速度精度。

### 2.11 加入小I的右轮PI测试包已准备

见[加入I操作说明](/Users/mzh/Desktop/车车/output/固件接入包/9.5_右轮PI闭环测试包/9.5_第三步_加入I.md)。保持P=32，新增Ki=20 PWM计数/((mm/s)×秒)，目标60、上限1800、时长3秒不变；按实际间隔积分、限制积分0～1800、饱和且误差继续推向饱和时暂停积分。每次RUN从0积分开始，停车及故障清积分。日志增加I=，单位是PWM计数，表示积分贡献，不是Ki参数。

只需用户备份后替换right_p_test.h/.c，main和CubeMX不变。全工程ARM编译及链接通过，主机模拟积分增长、上下限抗积分饱和、STOP/重新RUN积分复位和原有停车条件通过。未自动修改Sunward、未下载到小车。Ki=20是本轮试调值，实际趋近目标、抖动及停车复位仍待用户架空测试日志。

### 2.12 PI文件重复与头文件遮蔽修复（2026-10-08）

你提交14:22编译报错：同时编译Core/Src/right_p_test.c和Core/right_p_test.c，后者报告RPT_KI未定义。现场检查发现Core/Inc/right_p_test.h已经是Ki=20新头文件，Core/Src/right_p_test.c仍是旧P源码；新PI源码放在Core/right_p_test.c，而Core/right_p_test.h是无RPT_KI的旧头文件。带引号的include优先查源码同目录，因此Core下的新源码使用了Core下的旧头文件。

已备份全部四个相关原文件和生成的构建参数，将新PI源码放入Core/Src/right_p_test.c，保留正确的Core/Inc/right_p_test.h，将Core下重复源码、旧头文件移出工程，并从当前生成的源码清单移除重复入口。恢复了接入包中被移走的可下载文件。

使用用户原EIDE unify_builder执行完整重新构建，2026-10-08 14:26显示build successfully，32个编译单元，PI模块仅参与编译一次。生成build/Debug/Sunward.elf和Sunward.hex；FLASH约21308B、RAM约2528B。原main里未使用诊断函数/变量仍产生警告，没有编译或链接错误。未连接下载工具、未烧录或运行小车。

备份与完整日志：[修复备份](/Users/mzh/Desktop/车车/output/固件备份/Sunward_PI编译修复备份_2026-10-08_5zt9j04y)，内含original、removed、rebuild.log和result.json。

### 2.13 右轮P=32、I=20首次实物测试（2026-10-08 14:31～14:32）

数据来源：[records-2026-10-08-14-32-23.json](/Users/mzh/Downloads/records-2026-10-08-14-32-23.json)。共373条记录，提取363条完整RPI输出；包含5次RUN!发送和1次STOP!发送，启动读回明确提示PI active。文件最开始有少量早于14:31:12启动日志的IDLE数据，运行段均在本次启动后，未将旧数据混入运行统计。

| 操作 | 结果 |
|---|---|
| 14:31:21.186首次RUN! | 随后LOW，U/I均0；最初BAT约474，符合低于1200门槛的拒启动条件，不等同于证明电池本身欠压 |
| 14:31:35.205 RUN! | 15条RUN，V=35～60mm/s，打印均值50.33；I=23逐步增至480；最后5条V=60、53、51、60、53，平均55.4；随后DONE、U/I均0 |
| 14:31:42.821 RUN! | 15条RUN，V=38～62mm/s，打印均值51.40；I=16逐步增至459；最后5条V=54、55、56、62、56，平均56.6；随后DONE、U/I均0 |
| 14:31:53.786 RUN!，后进入OFF | 6条RUN，V=45～51，I增至282；14:31:55.090显示OFF、U/I均0，首条V=13，下一条V回0 |
| 14:32:16.172 RUN!，18.870发送STOP! | 13条RUN，V=45～59，I增至442；18.890显示STOP、U/I均0，首条V=49，下一条V回0 |

所有非RUN输出U和I均为0。自动结束、OFF和STOP均有积分复位和编码器随后停稳的日志证据；精确停车时间未用仪器测量。首次LOW后成功运行时BAT已回到此前接通电池的约1350读数，不降低门槛绕过LOW。

全文件BAT_RAW=473～1366，打印时最近一次DT=9997～10002µs；未见ADC、GAP、REV、FAST、STALL或UART故障状态。成功RUN中U=393～821，未持续达到1800上限。积分逐渐提高，速度总体向目标60接近，表明本次I项发挥了作用；3秒末尾仍有变化，不能据此宣称长时间稳态已验收，也不能把200ms打印值当作全部10ms采样。

待你确认本轮实物有无明显抖动/反复启停和停车是否正常。若正常，先保持P32/I20不变，将观察时间延至8秒，检查后半段是否维持在目标附近，避免同时改变增益和时长。

### 2.14 8秒观察版本准备与验证

见[8秒观察操作说明](/Users/mzh/Desktop/车车/output/固件接入包/9.5_右轮PI_8秒观察包/9.5_第四步_观察8秒.md)。只将头文件时长改为8000U、源码初始化时长上限改为8000U、启动提示改为8s；目标60、P32、I20、输出1800及故障/停车逻辑不变。main与CubeMX无需改动。

8秒版本全工程ARM编译链接通过；主机模拟8秒自动结束、积分与原有停车逻辑通过。准备包时未自动修改Sunward参数或烧录。后续实物日志见2.15。

### 2.15 右轮PI两次8秒运行及停车日志（2026-10-08 15:02～15:03）

数据来源：[records-2026-10-08-15-03-56.json](/Users/mzh/Downloads/records-2026-10-08-15-03-56.json)。300条原始记录，串接接收片段后提取289条完整RPI输出。按本轮参数目标60mm/s、P32、I20分析；日志有两段完整8秒运行，启动提示仍写3s，提示文字尚未同步，实际运行时长已改变。

| 运行 | 后段速度（最后15条打印，约3秒） | 结束 |
|---|---|---|
| 15:02:57.585起 | 56～62mm/s，均值59.13mm/s | 15:03:05.586显示DONE，U/I均0 |
| 15:03:09.384起 | 57～63mm/s，均值59.60mm/s | 15:03:17.386显示DONE，U/I均0 |

之后另有两段RUN被STOP结束、一段被OFF结束。所有非RUN完整打印均U=0、I=0，编码器随后回到0；未见LOW、ADC、GAP、REV、FAST、STALL或UART故障状态。启动时一次U达到1800，未持续饱和。两段完整运行后段速度已接近目标，打印数据未见明显持续的大幅起伏。

“无明显抖动”的实物观察尚待确认：固定架空，观察起转后、自动停车前的运行中段，查看轮子是否反复一快一慢、停一下再转，并听转动声音是否反复忽高忽低。正常轻微振动以及一次起转/刹停不能直接算速度环振荡。日志每200ms打印最近一拍数据，不能排除打印间隔内更快的波动。本轮先保持P32、I20，不因这些小幅打印变化立即调参。

### 2.16 左轮3秒PI测试包已准备（2026-10-08）

见[左轮3秒操作说明](/Users/mzh/Desktop/车车/output/固件接入包/9.5_左轮PI闭环测试包/9.5_第五步_左轮3秒测试.md)。新增left_pi_test.h/.c，main三处切换为LeftPITest与TIM8。左轮速度按TIM8正计数，电机输出A=0、B=-U；CPR60104.3333，目标60mm/s，P32/I20借作初始试调值，时长3秒，上限1800。右轮模块保留，运行时只调用左轮模块。

根据当前Sunward源文件生成临时接入main，全工程ARM编译与链接通过，包含左右模块且无重复符号。主机模拟验证左轮正反馈、仅B负方向输出、3秒边界停车、积分增长和抗饱和、STOP/重新RUN积分复位以及OFF/LOW/ADC/GAP/REV/FAST/STALL/UART等停车条件通过。证据保存在包内主机验证.txt、编译验证.txt，临时ELF位于/private/tmp/leftpi-check-wqxtbgf8/Sunward_leftpi_check.elf。未修改Sunward或烧录。左轮实物方向、速度与停车尚待本轮测试；右轮无明显抖动仍需实物观察确认。

### 2.17 已按用户要求完成左轮代码接入及现场编译（2026-10-08 15:13）

备份当前main、右轮头文件/源码、构建参数和旧ELF/HEX到[接入前备份](/Users/mzh/Desktop/车车/output/固件备份/Sunward_左轮接入前备份_2026-10-08_qhw559y1)。复制left_pi_test.h/.c到Sunward的Core/Inc、Core/Src，main切换include、LeftPITest_Begin与TIM8、LeftPITest_Poll，初始化失败提示改为LPI。保持main原换行和右轮文件原内容；当前只运行左轮模块。生成的EIDE源码清单加入左轮模块，以用户原unify_builder完整重新构建33个编译单元成功。原main未使用诊断函数/变量的警告仍在，无编译或链接错误。FLASH21304B、RAM2520B，输出build/Debug/Sunward.hex。备份内有rebuild.log和result.json。

未烧录或启动小车。下一次下载后才是左轮3秒测试版本：目标60mm/s、P32、I20、B负方向、TIM8正反馈。实物结果等待用户固定架空测试。

### 2.18 左轮P32/I20首次3秒实物日志（2026-10-08 15:15）

数据来源：[records-2026-10-08-15-16-01.json](/Users/mzh/Downloads/records-2026-10-08-15-16-01.json)。239条原始记录，串接接收片段后提取231条LPI输出。开头少量IDLE数据早于15:15:17.856本次启动，未用于运行统计。启动提示left B only、3s、PI active；现场main接入TIM8，左轮参数60mm/s、P32、I20、时长3000ms。

| 操作 | 日志表现 |
|---|---|
| 15:15:25.276 RUN! | 15条RUN，V43～58mm/s，打印均值50.80；末5条平均55.20；I41→504；28.400显示DONE，U/I均0，V先-12后0 |
| 15:15:32.160 RUN! | 15条RUN，V46～66mm/s，打印均值52.53；末5条平均53.80；I10→463；35.199显示DONE，U/I均0，V先37后0 |
| 15:15:47.693 RUN!，49.942 STOP! | 11条RUN，V45～58，I26→378；49.999显示STOP，U/I均0，V先26后0 |
| 15:15:54.193 RUN!，随后OFF | 14条RUN，首条V/U/I均0（命令接受后新测量拍尚未施加输出）；之后V42～56；56.999显示OFF，U/I均0，V先-1后0 |

所有非RUN完整输出U/I均0；未见LOW、ADC、GAP、REV、FAST、STALL或UART故障状态。全日志BAT475～1355，其中475在启动前旧IDLE段；RUN段没有低于本轮1200门槛。打印时最近一次DT9997～10001µs。停车后的短暂正/负速度下一行归0，不据此认定运行方向错误，也不把200ms打印间隔当作精确制动时间。

左轮速度在3秒内总体接近60，但积分仍增长，暂不判定稳态误差，也不直接增大Ki。日志支持自动结束、STOP、OFF时撤掉驱动并清积分。你已确认实际左轮向前、右轮不动、无明显抖动，自动结束/STOP/使能OFF均能停车。保持P32/I20、目标60、上限1800，将左轮观察延至8秒。

### 2.19 已代做左轮8秒版文件操作（2026-10-08）

备份3秒版源码、main、生成的构建文件和ELF/HEX到[左轮3秒原版备份](/Users/mzh/Desktop/车车/output/固件备份/Sunward_左轮3秒原版备份_2026-10-08_2v6x3udd)。只修改左轮时长为8000ms、初始化时长上限8000ms及提示8s；main未变。EIDE生成的源码清单此前恢复为旧清单，本次补入left_pi_test.c再完整编译。主机模拟8秒边界、积分、方向、原停车条件通过；全工程编译日志保存在备份和[8秒观察包](/Users/mzh/Desktop/车车/output/固件接入包/9.5_左轮PI_8秒观察包)中。未烧录或启动电机。

用户下载后按[左轮8秒观察说明](/Users/mzh/Desktop/车车/output/固件接入包/9.5_左轮PI_8秒观察包/9.5_第六步_左轮8秒观察.md)重复两次RUN并导出日志，观察末段是否接近目标及实物是否平顺。

### 2.20 左轮P32/I20两次8秒实物日志（2026-10-08 15:22）

数据来源：[records-2026-10-08-15-22-45.json](/Users/mzh/Downloads/records-2026-10-08-15-22-45.json)。261条原始记录，串接接收片段后提取251条完整LPI输出，其中22条早于15:21:58.233启动。启动附近一条旧IDLE消息被截断并含替代字符，未用于数值统计。启动提示left B only、8s、PI active；现场头文件保持目标60mm/s、P32、I20、8000ms。

| 操作 | 后段及结束表现 |
|---|---|
| 15:22:05.039 RUN!，完整8秒 | 40条RUN。最后15条（约3秒）V55～64mm/s，均值60.07；I515→537，U412～684；13.177显示DONE，U/I均0，V先-3后0 |
| 15:22:16.631 RUN!，完整8秒 | 40条RUN。最后15条V58～61mm/s，均值59.40；I500→522，U496～583；24.776显示DONE，U/I均0，V先1后0 |
| 15:22:29.523 RUN!，33.239 STOP! | 19条RUN；33.376显示STOP，U/I均0，V先2后0 |
| 15:22:38.839 RUN!，随后使能OFF | 12条RUN；41.376显示OFF，U/I均0，V先-5后0 |

完整运行后段速度已接近60，积分增长明显减缓，未见持续大幅速度起伏或输出饱和。所有非RUN完整打印U/I均0，未见LOW、ADC、GAP、REV、FAST、STALL、UART状态。全日志BAT483～1353，低值483只在本次启动前的旧IDLE段；打印时最近一次DT9997～10002µs。

本轮日志支持左轮在当前架空条件、60mm/s目标下的短时PI跟随和各停车路径。每200ms打印最近10ms一拍，不能证明所有采样都无振荡；65mm轮径与CPR仍属初始标定，不能据此验收落地速度精度、负载变化或双轮直行。已请求用户确认本次8秒实物是否也方向正确、右轮不动、平顺及停车正常，确认待回复。保持P32/I20，无需仅为小幅打印波动继续提高增益。

### 2.21 已接入双轮3秒PI测试并编译（2026-10-08 15:39）

按用户“then？”继续单轮后的双轮测试阶段，并沿用用户授权的代做备份/文件接入。备份左轮8秒现场main、左右单轮源码/头文件、构建文件和原ELF/HEX至[双轮接入前备份](/Users/mzh/Desktop/车车/output/固件备份/Sunward_双轮接入前备份_2026-10-08_6jwjipiv)。新增dual_pi_test.h/.c，main只调用DualPITest，CubeMX不变。TIM8左计数正、TIM4右计数取负，A=右正命令、B=左负命令；两路独立P32/I20、目标均60mm/s、每轮上限1800、共同最长3秒。

任一轮持续反向、超速或高命令低速不转，双轮一起停止；所有停车清两组积分。共用ADC、使能、时长、采样间隔及UART停车路径。日志DPI包含L/R速度、UL/UR输出、IL/IR积分，以及轮子故障归属F=L/R（共用条件显示-）。反向和堵转累积按微秒计算，以避免9998µs整除毫秒造成累计时间偏差。

主机模拟验证两路独立响应与积分、上下限抗饱和、左右编码器符号、两电机命令映射、STOP/重新RUN清两组积分、3秒边界、重复RUN不延时、共享条件停车及任一轮REV/FAST/STALL让双轮一起停，计数/tick/DWT回绕通过。临时全工程ARM编译链接通过后接入Sunward，再完整重新构建34个编译单元成功，FLASH21784B、RAM2552B；原unused诊断警告保留，无编译链接错误。证据见[双轮测试包](/Users/mzh/Desktop/车车/output/固件接入包/9.5_双轮PI闭环测试包)和备份内rebuild.log/result.json。未烧录或启动电机。

本轮等待固定架空双轮实物测试。此前单轮8秒的实物平顺情况仍未逐项确认，不将其写成确认通过；本轮同时复核两轮方向、抖动、自动停/STOP/OFF。双轮架空速度一致不能等同于落地直行。

### 2.22 双轮运行串口卡住的代码优化（2026-10-08 16:04）

用户反馈串口“会卡死”，尚未提供本次双轮故障日志，已询问是文字停更、STOP无响应还是显示断续，具体表现待回复。代码检查发现双轮遥测仍由主循环阻塞发送，接收只轮询；遇到HAL UART错误后置active=0，导致控制模块的日志与命令永久退出。这些是确认存在的代码问题，未据此宣称已经复现用户的唯一故障原因。

已备份源码、中断文件、原ELF/HEX和构建信息到[串口优化前备份](/Users/mzh/Desktop/车车/output/固件备份/Sunward_串口优化前备份_2026-10-08_3fxiu9pp)。新增lab_uart_async.h/.c，双轮阶段独占USART1：512字节TX队列、128字节RX队列，中断搬运；发送拥塞丢整条遥测而不阻塞控制；接收溢出/ORE等错误清标志，通知主循环两轮停车、清积分及丢残缺命令，但继续收发。输入碎片100ms过期。日志仍200ms一条，新增RXE/TXD累计计数，启动提示UART async。USART1优先级2低于TIM2的0，入口放USER CODE块，运行时启用NVIC；main、usart配置、CubeMX及双轮参数未改变。

主机集成模拟覆盖实际队列驱动与双轮模块：TX满时仍控制并响应STOP，RX ORE/溢出停车后日志与完整新命令恢复，收发并行、缓冲区副本、队列回绕、空队列关TXE中断、输入碎片过期，以及原方向/PI/停车条件。临时及现场全工程ARM编译链接通过，现场35个编译单元，FLASH22420B、RAM3216B；ELF确认USART1_IRQHandler和LabUART_IRQHandler是强符号。仅原main unused诊断警告保留。证据见[优化包](/Users/mzh/Desktop/车车/output/固件接入包/9.5_串口优化包)及备份。未烧录，USB设备/浏览器显示和电机干扰仍待用户按OFF待机20秒、再双轮3秒的方式复测。

### 2.23 串口卡住现象补充与双轮日志（2026-10-08 18:36～18:40）

用户提供18:36截图：少量IDLE输出后卡住，RXE/TXD为0、BAT约480；明确确认网页“整个页面都点不动”。之后报告“现在能用”，进一步补充：每次全断电再按流程可用，正常连接期间能用，但按Reset后第二次Reset会让页面卡死。该现象仍未完成跨接收工具对照，不能写成硬件问题已解决，也不能将网页整页冻结直接等同于单片机停止运行。

新日志：[records-2026-10-08-18-40-11.json](/Users/mzh/Downloads/records-2026-10-08-18-40-11.json)。256条记录（251接收、5发送），18:39:20.424～18:40:10.196，共49.772秒。拼接接收片段后提取244条完整DPI输出；开头有截断/粘连的旧消息，未用于运行数值统计。完整记录RXE/TXD均0、DT9997～10002µs，未见UART/GAP等故障状态。3秒两次完整运行：

| 运行 | 最后5条左/右平均速度 | 积分末值与结束 |
|---|---|---|
| 18:39:28.059 RUN! | 左57.8、右55.8mm/s | IL432、IR440；31.197显示DONE，两路输出/积分0，速度先4/-1后0/0 |
| 18:39:33.935 RUN! | 左53.8、右57.2mm/s | IL418、IR425；37.000显示DONE，两路输出/积分0，速度先7/24后0/0 |

第三次RUN于18:40:00.510 STOP!结束，00.597显示STOP，两路输出/积分0，速度先-6/-13后0/0；第四次RUN随后OFF，07.800显示OFF，两路输出/积分0，速度先2/0后0/0。所有非RUN完整输出UL/UR/IL/IR均0。本日志支持正常连接下的双轮短时控制及停车路径，但不能检验那次导致网页冻结的第二次Reset。你已明确确认两轮向前、无明显抖动，3秒自动结束/STOP/使能OFF均能让两轮停下；当前架空双轮3秒的方向与停车项目通过。重复Reset问题仍需定位。

### 2.24 为重复Reset定位准备本地串口记录工具（2026-10-08）

工具：[打开本地串口.command](/Users/mzh/Desktop/车车/output/调试工具/本地串口记录工具/打开本地串口.command)，[使用说明](/Users/mzh/Desktop/车车/output/调试工具/本地串口记录工具/使用说明.md)。初版使用本机已有Python标准库，不依赖网页或第三方串口库，115200/8N1，原始.bin和JSON流式保存，支持手动RUN!/STOP!、q/Ctrl+C退出；不自动发命令，初版不主动切换DTR/RTS。实际打开串口的驱动行为仍由操作系统负责。用户启动前需关闭网页串口占用、使能OFF。现已按2.25修正，明确释放控制线。

仅用软件伪终端测试复位截断数据、持续接收、JSON/原始字节一致、STOP写入、非法命令拒绝和终端转义，全部通过；没有连接真实小车。发现本机USB接口/dev/cu.usbserial-5B310185631，但没有打开它。此轮未继续修改MCU代码。待用户保持OFF、用本地工具连续两次Reset并回传日志，再区分网页与USB/MCU问题。

### 2.25 Reset后无输出：原理图核对与串口控制线修正（2026-10-08）

用户报告本地工具第一次Reset就停止输出，之后连接也没有信息。已读取接收记录原始.bin：18:49:21文件2312字节，后面18:49:59、18:50:25、18:51:00三份均0字节；四份都没有`C10B_LINE_LAB boot`。第一份原始字节包含约30行OFF日志，不能证明Reset后程序正常启动。第一份JSON未完整收尾，分析以.bin为准，未修改用户原文件；18:51记录只有手动发送RUN!，无接收，发送成功不能证明MCU正常运行。

已视觉核对C10B原理图：第1页R1 10k将BOOT0下拉、R9 10k将BOOT1(PB2)下拉；第2页CH9102F的RTS经R11、PNP Q1、R13接BOOT0，DTR/RTS经Q2和D4接NRST。RTS物理低时Q1导通，可将BOOT0拉高；BOOT1为低时，下一次Reset可能进入ST系统下载程序，因而没有用户程序Boot/DPI。RTS低且DTR高时Q2还可能拉低NRST。Reset按钮本身通过NRST复位MCU，不切断CH9102电源；Type-C VBUS经D3进入板上5V，所以电池开关OFF不代表全部断电。依据原理图及厂家CH9102低有效定义，这是当前优先假设，未测量实物电压，尚未确认根因；不能把问题仅归于网页。

已备份初版工具至`output/调试工具/本地串口记录工具/备份_RTS修正前`，修正当前脚本：配置串口后用TIOCMBIC取消RTS/DTR置位，并用TIOCMGET读回验证；未释放或不支持时停止连接，不伪报成功。输出打开时的置位状态与释放提示。连续5秒没有新数据时也提示接收循环仍在运行。说明已改成“关闭旧工具→新版显示控制线已释放→保持使能OFF→按两次Reset比较Boot/DPI”。不自动RUN，不修改MCU、不烧录，没有打开真实USB串口。

仅软件测试通过：模拟ioctl验证两位清除、调用顺序、保留其他位、未释放/不支持时拒绝；伪终端再次验证截断流与JSON/bin一致、STOP发送、非法命令和终端转义。实物复测仍待用户执行；驱动位读回不是引脚电压测量，也不能据此宣称Reset问题已解决。

### 2.26 按用户要求继续逐日计划：准备T06地面负载复验（2026-10-08）

用户明确要求能修则修，不能修暂缓，继续实验与逐日计划。RTS/DTR工具修正保留，暂停围绕重复Reset追加排查。核对`01_三天任务清单.md`：当前处于第一天T06速度环，T07传感器基础已测，T08 LF04黑白标定仍暂缓，T09航向/定距尚未接入。已确认架空双轮3秒与STOP/OFF实物正常，下一项为T06地面负载复验，不直接认定A→B或第二天巡线已完成。

已写具体操作：[第八步：落地3秒](/Users/mzh/Desktop/车车/output/固件接入包/9.5_双轮PI闭环测试包/9.5_第八步_落地3秒.md)。使用已确认架空行为的现有60mm/s、P32/I20、3秒程序，不改MCU代码、不重新烧录；在持续正常串口输出的条件下，地面两次短跑，记录距离、偏向、抖动和自动停车。尚未执行实车落地实验。Reset问题仅保留为未确认根因，不作为已解决事项。

### 2.27 蓝牙复用RUN/STOP和DPI日志（2026-10-08）

用户确认蓝牙模块已能使用，并要求将现有收发命令复制到蓝牙。现场核对：USART3已生成、PB10/PB11、9600/8N1，main已调用MX_USART3_UART_Init；用户新增BT_TestRun回显函数存在，但调用已注释。保留这些用户配置与代码，未改CubeMX或波特率。

已备份至`output/Sunward_蓝牙接入前备份_2026-10-08_y96eg8eq`，实际接入双口异步驱动。USB与蓝牙独立队列/解析；两口可发送RUN!/STOP!，DPI每200ms镜像到两口，同一轮处理中STOP/接收故障优先，RXE/TXD为两口合计。main在DualPITest_Begin后启用蓝牙，新增USART3_IRQHandler，原USB接口保留。目标60mm/s、P32/I20、3秒、方向与所有原停车条件不变。未接入蓝牙连接状态检测，断开仍由3秒自动结束/实体OFF处理，不声称已实现失联停车。

模拟测试及旧控制回归通过：蓝牙RUN/STOP、日志一致、碎片隔离、双口命令优先级、BT接收故障停车/恢复、BT发送拥堵不阻塞控制/STOP，3秒和OFF均通过。现场完整ARM编译链接成功：FLASH22952B、RAM3984B，USART1/3中断为强符号。新HEX：`/Users/mzh/STM32Cube/Sunward/build/Debug/Sunward.hex`，SHA256 `71d5997349009a02ef9e4153edca00abf332550ae5847686160b7f7749e5deee`。仅编译生成，未烧录、未开真实串口，待用户架空无线试转/停车再落地。操作与证据见[蓝牙收发与测试](/Users/mzh/Desktop/车车/output/固件接入包/9.5_蓝牙命令接入包/蓝牙收发与测试.md)。

### 2.28 手动提速、延时、转弯/后退与STOP打断（2026-10-08）

用户要求速度更快、时长更长、可转弯后退；明确确认“中断”指随时发STOP!打断行驶。已备份并接入手动模式F!/B!/L!/R!，默认目标120mm/s、10秒，上限PWM幅度3000；V40!..V200!和TIME1!..TIME30!只在停车时调整。原RUN!保留60mm/s、3秒、1800上限，方向与PI增益不变。左/右转为同向前进差速、内侧半速；后退双目标为负，使用目标方向归一化的反馈与保护。不同运动命令切换先制动200ms，STOP/接收故障/OFF可取消切换，同批STOP优先，相同命令不延长倒计时。没有新增USER按键中断；沿用USB/蓝牙中断收发与TIM2控制节拍。

主机模拟与原双口/PI回归通过，新命令已加入本地记录工具并通过伪终端测试。现场完整ARM编译链接成功：FLASH23940B、RAM4016B，新HEX SHA256 `035a801296f2f64bdf54d50f42cffac1fd544950a6adfdd1f1e341f49918c3af`。备份`output/Sunward_手动控制前备份_2026-10-08_a9br3vgr`；操作见[手动试车命令](/Users/mzh/Desktop/车车/output/固件接入包/9.5_蓝牙手动控制包/手动试车命令.md)。尚未烧录，新速度/后退/左右转均未实物验证，不写成逐日计划的路线或负载验收已通过。

### 2.29 19:46缺少手动控制宏导致编译失败及修复（2026-10-08）

用户提供19:46:31增量编译失败日志，四个DPT_MANUAL/DPT_SWITCH宏未定义；此时尚未进入烧录。现场核对编译依赖确实引用Core/Inc/dual_pi_test.h，该头文件缺四个新增定义，而Core/Src/dual_pi_test.c仍为手动新版；没有发现同名头文件或重复dual_pi_test.c。此前完整编译已成功，当前文件版本不一致，但未确定头文件为何变回旧内容。

已备份至`output/Sunward_缺宏修复前备份_2026-10-08_p561gwth`，仅补回DPT_MANUAL_MMPS=120U、DPT_MANUAL_MAX_CMD=3000、DPT_MANUAL_DURATION_MS=10000U、DPT_SWITCH_BRAKE_MS=200U；保留其余现场配置，未修改源码。现场完整重编译链接通过，FLASH23940B、RAM4016B，HEX SHA256仍为`035a801296f2f64bdf54d50f42cffac1fd544950a6adfdd1f1e341f49918c3af`，与上次已验证的手动版本相同。操作包头文件和HEX同步，尚未烧录。建议编辑器若有旧文件缓存则重新加载磁盘版本，避免再次用旧内容覆盖。

### 2.30 独立WASD工具、蓝牙收发修复及手动运行记录（2026-10-08 20:12～20:15）

用户要求终端WASD控制工具独立于Sunward，工具保存在`output/WASD键盘控制工具`，没有加入Sunward工程。最初CRLF拆行错误导致实际收到DPI却误报无数据，按字节拆行后回放原日志识别70条DPI。20:08选择FFE1写入时，电脑发出方向及STOP命令，但178条主板DPI始终IDLE；工具随后改为BT24自动选FFE2发送、FFE1接收，并要求主板ST=STOP后才放行移动键。编译、自检和旧日志拒绝错误就绪的回放通过。用户随后回复“okok”，新日志提供了真实命令响应。Sunward HEX未改，SHA256仍为035a801296f2f64bdf54d50f42cffac1fd544950a6adfdd1f1e341f49918c3af。

数据来源：工具接收记录`records-wasd-2026-10-08-20-12-53.json`与`records-wasd-2026-10-08-20-13-37.json`，原文件保留。

- 20:12日志：电脑STOP、F发送记录；主板37条STOP、50条RUN、34条DONE。FWD运行打印左轮90～124mm/s、右轮90～122mm/s，支持120mm/s目标的前进响应和10秒自动结束。
- 20:13日志：主板409条RUN、11条STOP、66条DONE；含FWD/BACK/LEFT/RIGHT模式。后退运行打印左轮-119～-1mm/s、右轮-120～0mm/s；切换方向的瞬态也保留在日志中，不能将整段极值当作稳态性能。
- 两份日志RXE/TXD均0，未见LOW/ADC/GAP/REV/FAST/STALL/UART故障状态。此处反映日志结果，不替代实物方向、抖动及停止检查。

当前逐日计划定位：第一天T06速度闭环的地面负载与正式验收阶段；T07传感器基础已完成，T08 LF04黑白标定暂缓，T09航向外环和定距停车尚未接入。最新WASD操作是在地面还是架空已询问用户，待确认；尚无对应地面实测距离、偏向与抖动记录，不据遥控运行认定A→B已完成。当前主循环运行DualPITest_Poll，YawDiag_Poll仍注释，MPU已初始化但未参与当前行驶纠偏。

### 2.31 T06四次60mm/s架空复验日志（2026-10-09 00:48～00:49）

数据来源：[records-2026-10-09-00-49-16.json](/Users/mzh/Downloads/records-2026-10-09-00-49-16.json)。原文件未改。156个事件，含5次发送（4次RUN!、1次STOP!）；拼接接收片段后得到150条以DPI开头的行，其中149条完整、1条在00:48:49.755截断并拼接启动提示。统计缺失字段时排除该行；不把它当完整记录，也不据此确认复位根因或重复Reset问题已解决。

49条RUN日志均为M=TEST、TL/TR=60mm/s。V=120、SEC=10是手动模式配置，不表示本轮RUN使用120mm/s或10秒。

| 运行 | 发送及状态时间 | RUN条数 | 最后5条打印速度均值：左/右mm/s | 停车记录 |
|---|---|---:|---|---|
| 第1次 | 00:48:54.024发送RUN!；57.225首条DONE | 15 | 55.2 / 56.4 | 首条DONE输出/积分均0，速度57/59；下一条57.405为0/0 |
| 第2次 | 00:48:58.074发送RUN!；00:49:01.395首条DONE | 15 | 56.6 / 55.8 | 首条DONE速度、输出、积分均0 |
| 第3次 | 00:49:04.235发送RUN!；06.308发送STOP!；06.615首条STOP | 11 | 54.6 / 54.6 | 首条STOP输出/积分均0，速度-1/0；下一条06.795为0/0 |
| 第4次 | 00:49:11.522发送RUN!；13.395首条OFF | 8 | 53.8 / 53.0 | 首条OFF速度、输出、积分均0；日志没有实体开关的操作时间 |

首两次从电脑发送到首条DONE约3.201秒、3.321秒；这些包含通信与200ms打印时机，不能当作固件精确运行时长。STOP发送到首条STOP报告约307ms，也不能当作精确制动响应延迟。

所有100条完整非RUN日志的UL/UR/IL/IR均0。完整记录中RXE/TXD均0，未见LOW/ADC/GAP/REV/FAST/STALL/UART故障状态。打印DT为9993～10007µs、BAT为1311～1336。第1及第3次运行各有一条起步L/R=0、UL/UR=1800，随后输出下降；运行打印最大积分为IL383、IR389，未见持续满输出。两次完整短跑末段仍约比目标低3～5mm/s，不据3秒日志认定已经完全稳定，也不为此直接提高PI增益。

本日志支持当前60mm/s短时双轮响应以及自动结束、STOP、OFF的软件停车/清积分路径。用户后续明确确认本次是在悬空车轮条件下测试，因此归为架空复验，不计入地面负载验收。每200ms打印最近一拍轮速，不能证明所有10ms采样均无振荡或绝对速度精度。当前不将T06地面验收或T09自动直行标为完成。不同目标的地面响应尚未包含在本文件中。

### 2.32 T06第一次落地短跑：15.6cm（2026-10-09 22:49）

数据来源：[records-2026-10-09-22-50-05.json](/Users/mzh/Downloads/records-2026-10-09-22-50-05.json)。用户按前述落地测试报告第一次向前行驶15.6cm，并确认“没有抖动，3秒后停下了”。偏向/横向偏移尚未报告，不能将未回答的偏向项目记为无偏转。

原文件100个事件，含1次RUN!发送。接收片段拼接后有97条完整DPI记录，另有1条在22:49:41.108截断并拼入启动提示，不纳入完整记录统计。RUN!发送于22:49:46.652；15条RUN打印从46.958至49.748，均为M=TEST、TL/TR=60mm/s；49.929首条DONE。发送至首条DONE约3.277秒包含通信及打印时机，不作为精确运行时长。

| 项目 | 本轮结果 |
|---|---|
| 左/右RUN打印速度范围 | 左43～57、右37～57mm/s |
| 左/右最后5条打印速度均值 | 53.4 / 52.2mm/s |
| 左/右RUN打印输出范围 | UL437～924、UR545～883；未见持续1800满输出 |
| 结束前积分 | IL537、IR574；仍在增加，3秒内不能认定稳态已完全达到目标 |
| 自动结束 | 首条DONE输出及积分均0，速度-10/-4；下一条50.138速度0/0，此后保持0/0 |
| 用户实物观察 | 向前15.6cm、无抖动、3秒后停下；偏向待补充 |
| BAT/DT | BAT1312～1325；打印最近一拍DT9993～10005µs |
| 故障/队列 | 完整记录RXE/TXD均0，未见故障状态；非RUN输出和积分均0 |

按设置的3秒粗算，15.6cm对应全程平均约52mm/s，包含起步及停车测量条件，不是独立测速或精确稳态速度。恒定60mm/s的18cm仅作计算参照，不是本轮距离门槛。比架空复验，落地末段速度略低、驱动输出及积分更高，符合负载增加的表现；原因不能仅凭这份日志进一步归为某个机械问题。

本轮已取得第一次落地前进、无抖动与自动停车的实物证据。先保持60mm/s、3秒、P32/I20及原上限不变，摆回同一起点做第二次RUN!，记录距离、偏向与停车，核对重复性。不同目标响应及地面STOP/OFF仍待验证；T06未作全部通过结论，不修改或烧录固件。

### 2.33 T06落地重复短跑：仍约15.6cm，无明显偏向（2026-10-09 22:55～22:57）

数据来源：[records-2026-10-09-22-57-42.json](/Users/mzh/Downloads/records-2026-10-09-22-57-42.json)。用户报告“测出来15.6cm左右，没有明显的偏向”。文件实际包含两次RUN!，用户没有分别指定两段距离，因此将15.6cm与无明显偏向作为本次落地复验的观察，不为两段分别填入独立测量值。本次抖动与实物自动停车未再次单独确认，保留第一次已有确认。

文件165个事件，163条完整DPI日志，无残留半行。两段各15条RUN，均M=TEST、TL/TR=60mm/s；没有手动提速或STOP发送。

| 段 | RUN!发送 | 首条DONE | 最后5条打印左/右均速mm/s | RUN打印输出范围UL/UR | 结束前IL/IR |
|---|---|---|---|---|---|
| 22:55段 | 22:55:34.135 | 22:55:37.362 | 54.2 / 54.8 | 453～914 / 559～1138 | 569 / 584 |
| 22:57段 | 22:57:36.033 | 22:57:39.373 | 53.6 / 55.0 | 419～851 / 295～787 | 565 / 553 |

第一段首条DONE为速度0/1，下一条0/0；第二段首条DONE即0/0。全部非RUN完整日志输出及积分均0，RXE/TXD均0、F均为“-”，未见故障状态。BAT1313～1333，最近一拍DT9993～10004µs。两段运行打印输出均低于1800，没有持续满输出。末段轮速仍略低于60目标、积分仍在增加，不能将3秒短跑当作长时稳态精度验收。

与22:49首次实测15.6cm相比，本次约15.6cm支持同参数低速短跑的距离重复性；无明显偏向是用户的定性观察，没有毫米级横向偏移数据。两段速度响应与自动结束状态相近，先保留P32/I20、60mm/s及3秒设置，不据此调增益。

下一项使用现有手动模式分别做V60!/TIME3!/F!及V120!/TIME3!/F!，均采用手动上限3000，比较相同上限下目标提高后的轮速响应；每条停车后单独发送并确认日志V/SEC。地面STOP/OFF实物测试仍需补齐。当前仅收下60mm/s落地短跑复验，不宣称T06全部通过或T09完成。

### 2.34 场地补充：前述15.6cm在桌面测试，瓷砖地板待复验（2026-10-09）

用户进一步说明：之前测试放在桌上，现在移到有缝隙、不完全平整的瓷砖地板。因此2.32、2.33所称“落地”应理解为轮子接触桌面的带载测试，不是瓷砖地板实测；15.6cm、无明显偏向及首次无抖动/自动停车的原报告保留。桌面带载测试仍不同于2.31的架空复验，但不能直接保证不同地面条件下表现相同。

瓷砖缝及高低差可能带来负载、接触及反馈的短时变化；没有瓷砖地板日志或现象数据，不能把此前速度差归因于瓷砖缝。下一步先保持现固件、P32/I20，使用RUN!的60mm/s、3秒，在瓷砖地板相同起点/朝向/路径复测两次，记录是否跨缝、距离、偏向、抖动及自动停车。可先选一块瓷砖内的平整区域作基线，再单独观察跨缝；若必须跨缝，保持两次路径一致。不同目标的手动60/120测试在这项地面基线正常后继续。

### 2.35 按用户决定进入T09：接入航向保持3秒（2026-10-09）

用户明确要求暂缓追加测试并一起进行下一步。T06按现有低速桌面带载证据继续开发，瓷砖、不同目标及地面STOP/OFF正式复验暂缓，不重复要求补齐后才允许进入T09。

已在现有DualPITest中新增CAL!/GO!：CAL仅在OFF且停车时接受，预热2秒、500组约5秒静止校准，READY后GO保存启动时朝向，基速60mm/s、时限3秒、输出1800、P32/I20。差速P初始值1mm/s/度，限±15mm/s，目标45～75；未猜测轮距，不把该增益当手册的角速度Kh。当前是航向保持的限时短跑，定距/减速和声光端点逻辑将在后续接入，T09未实车验收。

MPU实际采样在前台10ms节拍处理；读取错误/饱和/超过5ms或采样异常使航向失效；GO偏航超过20°停两轮。STOP及双口接收故障仍优先，读取后再次检查实体使能。校准期间ON/编码器移动/明显陀螺仪波动拒绝校准，CAL与GO同批不积压启动；重复GO不延长时限。原RUN/F/B/L/R/V/TIME、200ms切换制动及低压/ADC/GAP/REV/FAST/STALL保护保留。蓝牙专用失联检测未新增。

主机模拟覆盖新校准/航向/限幅/异常停车及旧命令保护回归，通过-Wall/-Wextra/-Werror。临时和现场全工程ARM编译链接均通过，FLASH26136B、RAM4080B；仅原main unused警告。现场只改Core/Inc/dual_pi_test.h、Core/Src/dual_pi_test.c、Core/Src/main.c，保留MPU驱动、异步UART、CubeMX与构建配置。備份：[Sunward_航向接入前备份](/Users/mzh/Desktop/车车/output/固件备份/Sunward_航向接入前备份_2026-10-09_jfu72yno)。新HEX SHA256：`4f0a2421f4dcd54a5f7bfc522e31b7177610abd1cefff5fc508d71f69d6565ab`。尚未烧录或打开真实串口/蓝牙，没有启动电机。

本地串口工具仅添加CAL/GO白名单与提示，伪终端收发及原工具自检通过，旧脚本保存在航向包内。下一步用户依[航向保持3秒操作](/Users/mzh/Desktop/车车/output/固件接入包/T09_航向保持接入包/T09_第一步_航向保持3秒.md)下载新固件，OFF静止CAL至READY，再ON/GO做一次短跑，保留DPI/HDG日志与偏向、平顺、停车观察。实际I²C读取耗时与控制节拍需要本次上板验证。

### 2.36 T09首次航向保持实测：重校准成功，桌面GO正常（2026-10-09 23:32）

数据来源：[records-2026-10-09-23-33-09.json](/Users/mzh/Downloads/records-2026-10-09-23-33-09.json)。用户确认“在桌上的，一切正常，没有偏向，正常停止”。实测距离未提供，按桌面带载航向短跑记录，不记为瓷砖地面或定距验收。

200个事件，含CAL!、GO!各1次发送；拼接后198条完整DPI和40条HDG。开头23:32:11～19已是YC=FAIL N=298，IO_US=2903；此前失败发生过程没有录入，不能唯一确定是否由使能/编码器移动、读取/饱和或节拍异常触发。N=298说明没有走到500次后的波动范围验收，因此不能将初次失败归为该项阈值拒绝。此处的2903是保留的最近一次读取耗时，不证明失败瞬间所有条件正常。

23:32:19.210重发CAL!；20/21秒HDG为WARM，22～26秒CAL样本数64/164/264/364/464；27.054出现READY N=500 BZ100=-40344，即本次GZ零偏-403.44 raw。后续保持READY，运行前HDG打印相对角度约0～+0.05°。MPU最近读取耗时2903～2905µs，低于5ms限制；这次校准与采样链路有效。

23:32:42.754发送GO!，15条RUN自43.069至45.799，均M=HEAD；46.075首条DONE（发送至报告约3.321秒包含通信与打印时机，不是精确运行时长）。运行TL/TR主要60/60，三条为59/61，证明航向差速目标已参与。运行期三条HDG的E100=-30/+27/+17，即打印时误差-0.30°/+0.27°/+0.17°；C四舍五入为0时仍可能有小数差速，不代表内环没有纠偏。仅每秒打印一次角度，不能据此得出完整最大偏差。

| 项目 | 本轮结果 |
|---|---|
| 左/右RUN打印速度范围 | 均45～58mm/s |
| 左/右最后5条打印速度均值 | 52.6 / 53.8mm/s |
| RUN打印输出UL/UR | 394～800 / 230～854，未见持续满输出 |
| 自动结束 | 首条DONE输出及积分均0、速度-9/14；下一条46.189速度0/0，此后保持0/0 |
| 所有非RUN日志 | 输出及积分均0 |
| 采样/队列/电池 | DT9993～10007µs，RXE/TXD均0，BAT1311～1331；未见故障状态 |
| 实物观察 | 用户确认桌面运行正常、无偏向、正常停止；距离未提供 |

本轮支持新固件已运行、重新静止校准成功、航向差速接入以及桌面3秒停车。旧FAIL根因仍未唯一确认，但本次成功后无须按持续故障处理或修改阈值。保留当前参数；下一阶段接编码器短距离累计及定距停车，航向保持继续工作。T09的A→B、减速/声光/路线时间等完整验收尚未完成。

### 2.37 T09第二步：接入GO20航向保持＋20cm定距停车（2026-10-09～10跨日）

用户要求一起进入下一步，承接2.36已确认的桌面航向短跑。已在现有模块新增GO20!，原GO!三秒行为保留。GO20仅在已校准READY且停车时接受，捕获启动朝向与两路编码器新起点；左右分别按原CPR/符号/周长累计有符号距离，取平均作为驱动轴中点里程估计。启动前移动不计入，重复GO20不清里程或延长时限。

基速60mm/s，进入最后40mm后按剩余距离降低，最低基速40mm/s；航向差速随基速限幅，输出仍1800，P32/I20和航向增益不变。里程达到200mm后制动、清积分，进入BRAKE，继续累计制动滑行；两轮反馈在±5mm/s内持续200ms才DONE并锁存最终里程。驱动阶段10秒超时为TIMEOUT，制动1.5秒未确认停稳为SETTLE；均停车，不冒充完成。BRAKE期间不积压新运动命令。

STOP/OFF/串口接收故障优先，原电池/ADC/采样/反馈/MPU保护保留，BRAKE期间也检查关键故障；无效节拍、异常计数或航向错误不能触发正常完成。DPI在DIST模式400ms一次，新增S/SL/SR/G（mm），HDG仍1秒一次。V/TIME仍是手动配置，不改变GO20里程和超时。

主机测试覆盖初始快照、左右CPR/符号/平均距离、反向增量、16位计数回绕、millis回绕、重复/重新启动、20cm门槛、减速下限、制动滑行、200ms停稳确认、制动超时、总超时和异常停车；原CAL/GO/手动命令回归同时通过。临时及现场ARM全工程链接通过，FLASH27400B、RAM4112B，仅原main unused警告。现场只改Core/Inc/dual_pi_test.h与Core/Src/dual_pi_test.c，main/MPU/异步UART/CubeMX/构建配置未变。备份：[定距接入前源码与完整构建](/Users/mzh/Desktop/车车/output/固件备份/Sunward_定距接入前备份_2026-10-10_qaedayck)。新HEX SHA256：`6c5eac8ee15f2c3b322d772935c346a4717485b46cc8ad7f64b180d28b5951a6`。

本地串口工具增加GO20白名单和提示，伪终端自检通过，旧脚本在本包保留。未烧录、未打开真实串口/蓝牙、未启动电机。按[20cm定距操作](/Users/mzh/Desktop/车车/output/固件接入包/T09_20cm定距接入包/T09_第二步_20cm定距停车.md)下载新固件、OFF静止CAL至READY、再ON发GO20做一趟，待用户回传尺测位移、偏向/平顺/停车及日志最终S。估算200mm不等于已验收实际20cm；滚动周长与制动误差待实测校核，A→B声光/独立启动/路线验收尚未接完。

### 2.38 GO20首次实物日志：校准、减速与定距停车流程完成（2026-10-10 00:39～00:40）

数据来源：[records-2026-10-10-00-40-37.json](/Users/mzh/Downloads/records-2026-10-10-00-40-37.json)，193条串口记录，解析出185条DPI。用户补充：本轮在桌面测试，用尺量约20cm，大概20.2cm。偏向/抖动与实车自动停止现象尚未单独补充；停车状态可由日志确认。

00:39:56.849发送CAL!；YC由NONE经过WARM、CAL，在00:40:04.785首次报告READY N=500，BZ100=-40286。随后始终READY，没有FAIL。MPU读取耗时2893～2895us，控制DT9994～10008us，RXE/TXD均0，BAT raw1301～1317；未见故障状态。

00:40:23.567发送GO20!，随后M=DIST、ST=RUN。S=139mm时目标60mm/s；S=161mm时目标58mm/s；S=179、195mm时目标40mm/s，符合末段减速。00:40:28.151首次报告BRAKE，00:40:28.571首次报告DONE；均L/R与UL/UR/IL/IR为0，后续一直DONE且里程冻结。命令到首次BRAKE日志约4.58秒，到首次DONE日志约5.00秒，包含通信和打印延迟，不等于精确控制时刻。

最终日志S=201mm、SL=202mm、SR=201mm、G=200mm；字段各自四舍五入，S由内部浮点左右平均后取整，不能用已取整的SL/SR重新平均要求完全一致。停止后的编码器估算均值约20.1cm，不能代替尺测实际位移。运行期间4条HDG的E100为-46、+24、+15、-7，对应-0.46°、+0.24°、+0.15°、-0.07°，仅是约1Hz采样；C取整为0也不能说明小幅航向修正未参与。

结论：首次GO20日志支持校准成功、定距运行、末段减速、制动及停稳完成流程正常。用户尺测约20.2cm，相对目标20cm约多2mm（约1%），相对最终编码器估算20.1cm约多1mm；均为近似读数，含尺测与定位误差，不能据一趟区分轮周长或制动超程。本轮支持桌面短距离定距功能初步通过，保持当前固件与参数，不据此认定完整A→B路线验收通过。

### 2.39 用户暂缓地面测试，接入GO100一米直行与完成声光（2026-10-10）

用户指出宿舍瓷砖有坑，与正式测试场地不同，并明确要求跳过真实地面测试继续下一步。取消将宿舍GO20地面复验作为继续开发门槛，保留既有桌面约20.2cm结果；真实路线精度尚未验收。

接入[一米版本操作](/Users/mzh/Desktop/车车/output/固件接入包/T09_1米直行接入包/T09_第三步_1米直行与声光.md)：新增GO100!，独立目标1000mm，基速40渐增至120mm/s（100mm/s²），最后100mm降速、40mm/s下限，保留P32/I20和1800输出上限、原航向增益及最多±15mm/s差速。到点BRAKE后两轮速度±5mm/s内持续200ms才DONE，PC2/PC3两灯及PA15蜂鸣器非阻塞提示一次500ms。GO20仍200mm/60mm/s/10秒，GO仍三秒，V/TIME不影响定距命令。

GO100驱动超时13.5秒，制动超时1.5秒，未到点或未停稳进入TIMEOUT/SETTLE，无成功提示。并非15秒路线已验收，120mm/s实际地面表现待后续场地；独立PA0按键启动还未接入。STOP/OFF与旧保护保留，完成提示可取消且不会DONE重复触发。

模拟控制验证通过，原GO20/GO/手动回归通过；临时及现场ARM全工程编译通过，FLASH28036B、RAM4128B，仅原main unused警告。现场只改dual_pi_test.h/.c，其余既有源与配置字节核对未变。备份：[Sunward_1米接入前备份_2026-10-10_o1d1gglg](/Users/mzh/Desktop/车车/output/固件备份/Sunward_1米接入前备份_2026-10-10_o1d1gglg)；HEX SHA256 `5b35c4b6f896b13a3e54b9e8ce4a10b1bc5b11e81c3be3674aec5c8c6c79a454`。本地串口工具支持GO100，伪终端自检通过。本轮未烧录、未打开真实串口/蓝牙、未启动电机。当前操作仅OFF下载与静止CAL检查，不安排宿舍地面或桌面1米行驶。

### 2.40 实物测试统一延后至用户下次到真实场地（2026-10-10凌晨）

用户明确要求“能不能先不测这些，你记一下，明天我去真实测试的地方再做这些”，并询问除此以外还需做什么。今晚不要求新固件下载、静止CAL或运动实测；不再催促宿舍坑洼瓷砖或桌面一米运行。按用户所称“明天”的下一次正式场地安排执行，具体公历日期未额外确认。

待现场：最终固件下载/版本确认与重新上电CAL；一趟GO20场地短跑，再做GO100一米航向/减速/定距停车/时间/声光记录；后续独立按键版本的脱离电脑启动与停车；真实黑白线下LF04标定及巡线。软件准备可继续，优先PA0独立校准/启动、按键消抖与防自动启动，再准备LF04静态读数、数据表与最终工程备份。当前GO100仍未烧录/实测，独立按键未接入。

清单：[下次真实场地测试](/Users/mzh/Desktop/车车/output/固件接入包/T09_1米直行接入包/下次真实场地测试清单.md)。这项安排是暂缓实物测试，不代表取消项目或将未测项标成通过。

### 2.41 到真实场地：GO20首趟尺测约19.7cm（2026-10-11）

用户已到真实测试场地；蓝牙截图曾显示等待连接、ST=UART RXE=2、YC=READY N=500，建议OFF重连并用STOP确认命令链路。随后用户曾报告CAL等不到READY，已说明保持OFF、关闭循环发送、单次CAL并观察WARM→CAL→READY；用户回复ok后按GO20现场短跑步骤继续。没有收到本次完整日志，不据ok推定每项诊断状态均已确认。

用户报告“GO20开了19.7”，结合此前厘米测量语境，记录本轮现场实际前进约19.7cm，比200mm目标少约3mm（约1.5%）。最终编码器S、偏向/抖动及实车自动停下现象尚未提供。单趟近似尺测不足以区分起终点定位、滚动周长与制动因素，保持固件和PI/周长参数。若实车运行平顺、无明显偏向且自动停止，下一步做GO100一米直行及停稳声光，保存完整日志、距离与时间。

### 2.42 GO100首趟现场日志：流程正常但用户观察明显右偏（2026-10-11 15:51）

数据来源：[records-2026-10-11-15-52-40.json](/Users/mzh/Downloads/records-2026-10-11-15-52-40.json)，116条导出事件，按行拼接得到94条DPI、38条HDG。用户反馈“明显向右偏移，可能轮子螺丝松动产生偏移”；松动尚为用户推测，未确认机械故障具体部位。本轮不将A→B直行判通过。

日志开始已是GO20的DONE：S=201、SL=202、SR=200、G=200，只有上一趟停后片段，没有GO20完整行驶过程。可补充2.41的19.7cm尺测对照，但不能据此重建其运行轨迹。

15:51:18.401发送CAL，WARM→CAL，15:51:25.925首次报告READY N=500，BZ100=-40057，此后始终READY。15:51:36.553发送GO100；DPI基速65→105→120，后段S=908时T=110，S=945时T=66，S=969及988时T=40，起步和末段减速均可见。15:51:46.628首次BRAKE，15:51:47.077首次DONE且SIG=1；后续SIG=0，速度、输出、积分保持0。

命令到首次DONE日志约10.524秒，含通信/打印延迟，不是精确控制完成时刻。最终冻结S=1001mm、SL=1002mm、SR=1001mm（各字段独立取整）；软件声光事件已触发，但未收到实物灯/声音确认，实际尺测长度亦未提供。

RUN期间HDG打印的E100=-30～+6，即误差-0.30°～+0.06°，只有约1Hz稀疏样本，不能证明全部控制拍的最大误差。小幅TL/TR差异（例如65/64、105/104、111/110）说明差速在参与；C打印取整为0不等于没有修正。全段DT9990～10009us，MPU读取2956～2958us，RXE/TXD始终0，BAT raw1290～1311；未见故障状态。

分析：日志支持起步、速度跟随、减速、距离停车及软件完成提示正常，无法仅凭这些数据证明轨迹直线或确定螺丝松动。陀螺仪保持启动朝向，不测相对指定直线的横向位置；起始朝向偏右、轮毂/电机架松动、轮胎侧摆/打滑、从动轮受阻或主板相对车架松动都需实物排查。先OFF并关闭电机电源，检查轮毂与轴、电机支架、轮胎侧摆、从动轮和主板固定；不要先修改PI、周长或航向增益。用户随后补充：不知道右偏多少厘米，车头没有明显转动，电机也没晃动。该观察与日志小航向误差相符，不能据此确认螺丝松；电机不晃动也不等于已逐项检查轮毂与轴的结合。先保持参数，重点复核起步车体中心线是否对准预定方向；保持启动朝向不能消除初始朝向误差或横向滑移。下趟用直尺对准起点，比较行驶路径是否从开始就斜向右，还是车身朝向基本平行而逐渐向右横移，记录同一参考点的横向偏移；在空间足够且固定可靠时复做一趟GO100，无需据此重做单轮PI。

### 2.43 GO100第二趟：肉眼无偏移，尺测102cm，自动停止与声光确认（2026-10-11 16:05）

数据来源：[records-2026-10-11-16-05-47.json](/Users/mzh/Downloads/records-2026-10-11-16-05-47.json)，219条导出事件，拼接为198条DPI、59条HDG。用户报告“这次没偏移，肉眼看不出来了，开了102cm”，并明确补充“自动停下，灯和声音都有”。本轮直行、自动停车、实际完成声光可记为初步成功；此前右偏的原因仍不能反推为已确认的螺丝松动或起步对准问题。

16:04:47.673发送CAL；NONE→WARM→CAL，16:04:55.857首次READY N=500，BZ100=-39706。16:05:07.144发送GO100，目标基速66→106→120，S=909时T=109，S=946时T=65，S=970/989时T=40，起步渐增与末段减速均正常。16:05:17.217首次BRAKE，16:05:17.603首次DONE/SIG=1，16:05:18.023首次SIG=0，此后速度/输出/积分均0且里程冻结。

命令到首次DONE报告10.459秒，含通信/打印延迟，不等于精确控制完成时刻。最终S=1001mm、SL=1002mm、SR=1000mm；字段独立取整。RUN期间HDG打印E100=-33～+18（-0.33°～+0.18°），为约1Hz稀疏采样，不能作为全采样最大误差。全段DT9992～10007us，MPU读数耗时2956～2958us（NONE阶段IO=0），RXE/TXD始终0，BAT raw1290～1307；没有故障状态。

尺测102cm相对目标100cm多约2cm（约2%），比编码器最终100.1cm多约1.9cm。日志显示终点估算仅多1mm，不能直接把尺测的2cm都归为制动超程；有效滚动周长、打滑或测量/定位差异尚需重复性证据。先保持当前PI/航向/轮周长和1000mm目标，不因单趟直接缩短目标或改周长。下一步同一起点、同一车体参考点再做两趟GO100，记录尺测距离、偏向与停车声光并保存日志；若差值稳定再处理有证据的标定因素。完整T09仍需车体覆盖B、重复成功记录及独立按键启动等，不能仅凭本趟宣布全部完成。

### 2.44 GO100第三趟：尺测101cm、运行观察全正常；本次CAL成功（2026-10-11 16:18～16:20）

数据来源：[records-2026-10-11-16-20-42.json](/Users/mzh/Downloads/records-2026-10-11-16-20-42.json)，426条导出事件，拼接370条DPI、129条HDG。用户报告实际行驶101cm，并确认本趟无明显偏向、自动停下、灯和蜂鸣器都有提示（“都正常”）。继上一趟102cm后已有连续两趟用户确认观察正常，距离相差约1cm；先保持参数，不直接按上次102cm修改周长或目标。

本日志起始YC=NONE/ST=IDLE，16:18:35.502发送CAL，35.712首次WARM，38.709首次CAL N=100，42.699首次READY N=500/BZ100=-40126，命令至READY报告约7.197秒。之后117条HDG均READY，没有再次NONE或FAIL。本次CAL已正常接受并完成，不能用该文件确定此前“CAL一直NONE”的拒绝原因，因为它不包含那次失败过程；没有在本轮修改固件或声称修复了已定位的软件故障。

16:18:49.835发送GO100，基速65→105→120，S=910时T=109，S=946时T=65，S=970/989时T=40。16:18:59.889首次BRAKE，16:19:00.310首次DONE/SIG=1，00.760首次SIG=0。命令至首次DONE报告10.475秒，含通信和打印延迟，不是精确控制完成时刻。

最终S=1001mm、SL=1003mm、SR=1000mm（字段独立取整），后续冻结至记录结束，双轮速度/输出/积分为0。RUN期间HDG打印E100=-21～+6（-0.21°～+0.06°），约1Hz稀疏样本。全段DT9991～10008us，非NONE MPU读取约2956～2958us，BAT raw1288～1309，RXE/TXD均0，未见故障状态。

尺测101cm相对目标100cm约多1cm（1%），相对编码器100.1cm约多0.9cm。下一步相同起点/参考点再一趟GO100，争取三趟连续正常；未重启且当前READY时无需每趟重新CAL。保留实际距离、偏向、停车声光和日志记录，仍不将完整覆盖B、独立按键启动等未验收项写成通过。

### 2.45 GO100第四趟：尺测102cm，停车声光正常，轻微右偏可能受起始角度影响（2026-10-11 16:23）

数据来源：[records-2026-10-11-16-24-20.json](/Users/mzh/Downloads/records-2026-10-11-16-24-20.json)，233条导出事件，拼接213条DPI、61条HDG。用户报告“又开了102”，随后先回复观察“都正常”，再补充“稍微向右偏了一点点，但是不排除我一开始放的角度稍微的偏移”。以后者为方向观察的最新描述：轻微右偏，起始角度影响尚未排除；自动停车、灯和声音正常的确认保留。

16:23:24.882发送CAL，32.864首次READY N=500、BZ100=-40016，命令至READY报告约7.982秒，之后一直READY。16:23:43.022发送GO100，基速61→101→120；S=904时T=115，S=942时T=69，S=967/987时T=40。16:23:53.024首次BRAKE，右轮打印R=-6mm/s但输出/积分已0，是制动瞬间单拍反馈，不是反向驱动；53.414首次DONE/SIG=1且双轮速度0，53.896首次SIG=0。命令到首次DONE报告10.392秒，包含通信/打印延迟。

最终S=1001mm、SL=1002mm、SR=1001mm，各字段独立取整，后续冻结。RUN期间截取的HDG打印E100=-18～+19（-0.18°～+0.19°），只代表约1Hz样本。全段DT9990～10008us，非NONE MPU读取约2956～2958us，BAT raw1288～1308，RXE/TXD均0，未见故障状态。

最近三趟同版本尺测依次102、101、102cm，范围1cm，平均约101.7cm；三个日志最终S均1001mm，首次DONE报告用时约10.46、10.48、10.39秒。用户确认三趟停车声光均正常，前两趟无明显偏向，本趟有轻微右偏且起始角度不确定。支持一米定距、自动停车、完成声光及距离重复性初步成立；仍有约1～2cm偏长和未量化的方向误差，不将严格直线/覆盖B或完整T09认定通过。

先保持PI、航向增益、CPR与周长。理论上起始朝向偏1°，沿该朝向前进1米会产生约17.5mm横向差；这里只解释摆放误差的可能影响，不证明本次偏移一定由它导致。当前航向环保持启动朝向，不测相对目标直线的横向位置。停止重复追加GO100，以后正式覆盖B时统一起点参考点与对准方式；下一项为独立按键启动接入，尚未完成。

### 2.46 PA0按键独立启动已接入并编译（2026-10-11，软件阶段）

用户明确要求先改代码、编译固件并实现按键启动；OLED照片已提供，但本版按最新优先级暂不接入OLED。实际工程已接入OFF短按KEY_U开始CAL、READY后ON稳定再短按启动现有GO100；WARM/CAL/RUN/BRAKE期间再按取消或停车。30ms按下/松开消抖，一次按下仅一次事件，上电按住或按住切换ON不会自动走车，STOP/串口接收故障仍优先。LED1慢闪校准、常亮READY、快闪FAIL，行驶中熄灭；GO100正常停稳保留双灯与蜂鸣器一次500ms，之后LED1恢复READY常亮。新增KEY日志记录实际EN、RAW、ARM、EVT与ACT。

仅修改dual_pi_test.h/.c；原速度、PI、航向、CPR与周长参数不变。主机按键模拟和既有GO20/GO100/航向/手动回归通过，临时及实际工程完整ARM编译成功（FLASH28960B/RAM4152B），原main unused警告保留，无新代码警告。未打开真实串口或蓝牙，未替用户烧录或驱动车辆；按键原始电平和现场独立启动/停车仍待实物确认。旧版GO100的102/101/102cm不能替代新版按键验收。

固件和操作步骤：[按键接入包](/Users/mzh/Desktop/车车/output/固件接入包/T10_按键独立启动接入包/按键启动操作说明.md)。实际工程HEX与包内一致，SHA256 `c921090bcda3f98a541745def3f25d3100538d183d87388a6469f47c7c7e8e95`。旧源码与完整构建：[接入前备份](/Users/mzh/Desktop/车车/output/固件备份/Sunward_按键接入前备份_2026-10-11_sv7o14_t)。TASK固定为1米任务，未接LF04路线切换、任务2～4或OLED任务显示。

### 2.47 按键版现场反馈：仍为102cm，全程无异常（2026-10-11）

在交付按键版HEX及OFF按键校准、READY后ON按键启动的操作步骤后，用户回复：“可以 依旧是102cm 全程没有异常”。按本次按键版操作反馈记录，实际前进约102cm，整体运行未报告异常；与此前GO100的102/101/102cm结果接近，暂不调整速度、PI、航向增益、CPR或周长。该反馈作为按键版正常一米流程的初步现场证据。

本轮未附串口日志，不补写编码器S、用时或具体按键/灯状态；中途再次按键停车、上电按住键及长按等特殊情形没有单独实测反馈，软件验证通过与现场单项验收分别保留。不因此宣称完整T09或任务2～4完成。下一项准备六针OLED接入，显示当前任务与校准/运行状态。

### 2.48 六针OLED已接入并编译，待静态试亮（2026-10-11）

用户已按H1接好六线，并提供屏幕背面照片：Default:4SPI、R3/C5处于默认位，支持按默认四线SPI接入；照片未直接标控制芯片型号，不能确定就是资料里的SSD1306。已采用SSD1306 SPI128×64试亮配置，驱动直接编入固件，不需要用户另装电脑驱动；未改焊跳线。H1沿用GND/3.3V/PC14/PB5/PB4/PB3。

新增task_oled.c/.h，dual_pi_test.c接入四行任务/YC/EN/STATE/编码器估计里程。每次最多8字节数据+3命令、每毫秒最多一块，文本200ms更新，帧刷新期间冻结；复位延时仅发生于启动控制尚未primed前，运行时无HAL_Delay。保留上版按键启动、停车及旧运动参数。SPI无型号读回，新增OLED TRY日志不是屏幕已识别/亮屏证明。

真实OLED驱动的模拟SPI时序/显存/字模/边界/回绕验证及原按键/GO20/GO100/航向/手动回归通过；临时及实际工程完整ARM编译成功，FLASH31216B/RAM5288B，无新增代码警告。未替用户烧录或上电；当前仅交付保持OFF的静态试亮步骤，OLED型号兼容、显示效果与新增运行耗时尚待实物结果。之前按键版102cm不能替代本版验收。

固件与步骤：[OLED试亮包](/Users/mzh/Desktop/车车/output/固件接入包/T11_OLED试亮接入包/OLED试亮操作说明.md)。包内HEX与实际工程一致，SHA256 `2649c47370be8b2dbddff3c77009f37511a8ba23caf41c01b01fd6032d4e3c46`。上一版备份：[OLED接入前](/Users/mzh/Desktop/车车/output/固件备份/Sunward_OLED接入前备份_2026-10-11_to31kzet)。本版不新增任务2～4、选任务或LF04巡线。

### 2.49 OLED实物已显示，左右镜像修正并编译（2026-10-11）

用户提供OLED亮屏照片并要求镜像翻转。照片显示任务1、YC、STATE及S四行内容，左右反向，四行上下顺序正常；可确认原SPI试亮驱动能够显示内容，精确控制芯片型号仍未直接标出。不将此静态显示照片作为运动或按键验收。

仅将task_oled.c初始化的段重映射A1切为A0，COM扫描C0保持原值。SPI解码/显存/字模/分块检查通过，实际工程完整ARM编译成功（FLASH31216B/RAM5288B），其他核心代码、控制参数、接线及构建配置逐字节校验未改。新方向仍待用户烧录后实物确认，未代为烧录或运动。

固件与说明：[OLED镜像修正版](/Users/mzh/Desktop/车车/output/固件接入包/T11_OLED镜像修正版/显示方向修正说明.md)。HEX SHA256 `bb1deb12183e3a9ad295b66bf12232454d129de0b16ccf9057191ab6acc3b96b`。备份：[镜像修正前](/Users/mzh/Desktop/车车/output/固件备份/Sunward_OLED镜像修改前备份_2026-10-11_r6y3ea84)。

### 2.50 OLED方向已确认；LF04已接线，静态标定读数固件已准备（2026-10-11）

用户对OLED镜像修正版反馈“ok了”，确认显示方向正常；随后确认LF04已接主板、尚未做黑白标定。下一项为T08四路黑白与物理左右顺序标定，不追加同类GO100试跑。

已在dual_pi_test.c加入OFF时OLED末行LF O1/O2/O3/O4原始读数及1Hz LINE日志；ON恢复原里程/目标速度，原按键/运动保护保留，LF读数不参与控制。现有PC8/PC4/PC9/PB8输入配置与OLED A0方向、PI/航向/CPR/周长参数未改。模拟16种输入组合、显示/日志、OFF/STOP与原启动等检查通过，实际工程完整ARM编译成功。未代为烧录或进行黑白实测，极性、各路黑白稳定性、物理左→右顺序、探头高度尚待回传。

操作步骤：[LF04静态标定包](/Users/mzh/Desktop/车车/output/固件接入包/T08_LF04静态标定接入包/LF04静态标定操作说明.md)。保持OFF，先记录全白与仅最左探头下方黑线两组，再逐路完成表。HEX SHA256 `afeb293a8e2bad0b0ff8856e7115b324f600d8b2c47242ecff738fd6ec27e3b0`。上一版备份：[接入前备份](/Users/mzh/Desktop/车车/output/固件备份/Sunward_LF04静态显示前备份_2026-10-11_m_4fx6vk)。

### 2.51 LF04全白底原始值0000；重新明确探头左右视角（2026-10-11）

用户报告全白读数0000，记为O1=0、O2=0、O3=0、O4=0。本轮未回传单路黑线读数，不能推定黑线电平或通道顺序，暂不修改原始读数/巡线极性。为消除从车头或车尾观察的歧义，统一站在车尾、面向车头，从左到右编号物理探头1～4；“最左”指小车自身左侧最外端。下一组保持OFF，仅物理左1下方放黑线，其余三路白底，回传O1～O4四位原始值。

用户随后报告仅物理左1下方黑线时为0001。结合全白0000，初步确认物理左1→O4，O4白0/黑1，其他三个电气通道本次保持0。其余物理左右顺序和各路黑线响应仍未确认，不直接假定整组为O4/O3/O2/O1。下一组仅遮住从左数第2个探头，其余白底，保持OFF。

用户报告仅物理左2（从车尾面向车头、从左数第2个）下方黑线时为0010。结合全白0000，初步确认物理左2→O3，O3白0/黑1。已测左1→O4、左2→O3；物理左3/左4尚待逐路实测。下一组仅左3下方黑线，其余白底，保持OFF。

用户报告仅物理左3（从车尾面向车头、从左数第3个）下方黑线时为0100。结合全白0000，确认物理左3→O2，O2白0/黑1。已测左1→O4、左2→O3、左3→O2；最右端左4尚待逐路实测。下一组仅最右端探头下方黑线，其余白底，保持OFF。

用户报告仅最右端（物理左4）探头下方黑线时为1000。结合全白0000，确认物理左4→O1，O1白0/黑1。四路单探头实测齐全，物理从左到右为O4/O3/O2/O1，均白0/黑1；视角统一从车尾面向车头。当前固件仍为原始读数显示，不参与巡线控制，本次不作为动态巡线验收。下一步保持OFF、正常安装高度，车身中心对准实际赛道黑线，记录居中读数；不假定线宽必然同时覆盖两内侧探头。

用户按OFF、正常落地安装高度、车身中心对准赛道黑线的步骤回传居中读数0110。结合四路映射，两个内侧探头O3/O2压黑，两个外侧O4/O1在白底。四路映射、黑白极性与静止居中图样已确认；长时间稳定性和动态巡线尚未实测。下一阶段接入物理左→右归一化与巡线纠偏到两轮速度目标，编译后进行低速短程测试；当前固件LF读数仍不参与转向。

### 2.52 LF04极性纠正与两组复测（2026-10-11）

用户纠正“刚才记反了，黑线是0，白底是1”，随后按OFF、不要启动的步骤复测，报告全白1111、中间黑线1001。当前以这两组复测为准：白1/黑0，居中1001，无线1111。2.51中首轮白0黑1与对应全白/居中结论撤回，保留历史，不虚构补码后的逐路实测。

此前逐路变化的通道身份仍为从车尾面向车头的物理左→右O4/O3/O2/O1；接入软件先排列再将0转换为见黑。下一阶段20厘米、60毫米/秒的独立低速巡线测试，先验证方向，保留一米直行；未烧录或完成动态验收。

### 2.53 T11低速20厘米巡线接入与编译（2026-10-11）

依据用户最后更正和复测，采用黑0白1、全白1111、居中1001；按物理左→右O4/O3/O2/O1排列计算线偏差，差速接到原两轮速度PI。新增独立LF20试验：目标200mm、起步40/巡航60mm/s、末40mm减速、最大10秒，停稳200ms才DONE并提示500ms。OFF手动LF20!仅选择，OFF键仍CAL，READY+ON新短按键启动；复位默认原一米，OFF GO100!可恢复。

起步需100ms稳定居中且当前GPIO仍1001。无有效线第一帧即清PI发零电机命令，持续100ms锁存LOST/LINE，故障后需新启动；丢线不当终点。LF控制转向时不叠加直线航向纠偏和起点20°限制，MPU健康与原运动/按键/串口保护仍保留；一米直行控制不变。OLED标TEST LF20，不将短程试验标为项目2完成。GPIO/主程序/OLED/MPU/I2C/UART/工程配置未改。

主机16码方向/极性/有效性、启动/停止、里程/丢线/停稳、保护/超时/满TX/时间回绕与原PA0/GO100/GO20/航向/手动回归通过；实际工程全量ARM编译成功，FLASH33108B、RAM5336B，只有原main未用警告。代码及HEX已接入实际Sunward工程，未代为烧录或运行车辆，动态方向和效果待现场测试。HEX SHA256 `60555c276885124a1730ad5dd717d1fc10514f5c9b0d48e891ce02d1e163be94`。

操作：[20厘米巡线说明](/Users/mzh/Desktop/车车/output/固件接入包/T11_20cm低速巡线接入包/20cm低速巡线操作说明.md)。固件：[新Sunward.hex](/Users/mzh/Desktop/车车/output/固件接入包/T11_20cm低速巡线接入包/Sunward.hex)。旧版可恢复备份：[Sunward_巡线纠偏前备份_2026-10-11_voipc8km](/Users/mzh/Desktop/车车/output/固件备份/Sunward_巡线纠偏前备份_2026-10-11_voipc8km)。

### 2.54 T11改为纯按键选择、校准与启动（2026-10-11）

用户明确正式测试不能靠蓝牙指令选择或启动。本次增加OFF空闲长按KEY_U1500ms选择一米/20厘米巡线，OLED显示TASK 1 A->B或TEST LF20；OFF短按在松开消抖后CAL，长按不先CAL、松手不CAL。READY+ON新按键启动，WARM/CAL/RUN/BRAKE新按键立即按下消抖后停止；长按只一次，上电按住/使能改变时保持按住均不误触发，复位默认一米。保留现有全部运动与巡线参数/保护及调试串口入口，运行不需要连接蓝牙或发送指令。

主机无RX命令、无蓝牙初始化的完整按键一米/巡线流程通过；模式、长短按/抖动/保持/忙状态取消、STOP/RX优先、传感器/OFF复查与回绕检查通过。此前16码巡线及GO100/GO20/航向/手动回归通过。实际Sunward工程修改并ARM全量编译成功，FLASH33400B、RAM5344B，只有原main未用警告。尚未代为烧录，纯按键新版的现场操作和巡线效果待用户实测。

新HEX SHA256 `551f53fb1cf72bced21f6cd86af926ca612e7f8abf30721e5ad7305df7b41b72`。操作：[纯按键巡线说明](/Users/mzh/Desktop/车车/output/固件接入包/T11_纯按键巡线接入包/纯按键巡线操作说明.md)。固件：[Sunward.hex](/Users/mzh/Desktop/车车/output/固件接入包/T11_纯按键巡线接入包/Sunward.hex)。备份：[Sunward_纯按键选模式前备份_2026-10-11_1x5nd5_w](/Users/mzh/Desktop/车车/output/固件备份/Sunward_纯按键选模式前备份_2026-10-11_1x5nd5_w)。

### 2.55 首次巡线动态反馈：转弯时一侧轮胎过慢（2026-10-11）

用户反馈目前正在巡线，“有一边轮胎太慢，拐弯的时候太慢”。尚未说明转弯方向、慢轮位于弯内/外侧、是否近乎停转、是否偏离黑线或最终停车STATE；不据此认定动态巡线通过或电机故障。

核对当前工程的试验参数：起步/末段基速40mm/s、巡航60mm/s、每轮最大差速偏移24mm/s且随基速比例缩小。因此最强纠偏时，两轮目标在起步/末段为24/56mm/s，巡航为36/84mm/s；这是目标值，不是实测轮速。需区分正常内侧减速、目标低于稳定运行区间以及实际轮速未达到目标，暂不盲改PI或左右映射。已请用户OFF停止并补充弯向、慢轮和循线表现。

用户补充右拐时左轮慢，O3见黑时左轮PWM占空比太少。尚无本趟目标/实测轮速及PWM数值。当前代码按旧通道身份将O3判为左内侧：仅O3黑（电气原始1101）时误差−1，巡航基速60得到左目标52、右68mm/s；起步基速40得到左约34.7、右45.3mm/s。低左目标是左纠偏设定，不能直接据PWM大小判定左轮PI不足或证明应反转纠偏符号；实际右转需要左轮实际速度大于右轮。右弯过程中O3见黑也可能在触发反向修正，弧线方向不等于每一拍纠偏方向。

由于此前黑白报告有过更正，本次先要求OFF下按车尾面向车头视角，仅左内侧（从左数第2个）压黑、其余白底，重新回传四位原始值，核对通道身份；不先交换左右或强制抬高PWM。动态轮速跟随与是否偏离黑线仍待证据。

### 2.56 左右视角和O3确认；巡线诊断软件准备（2026-10-11）

用户在OFF静态核对中回复：站在车尾、面向车头，仅从左数第2个探头（左内侧）压黑，其余白底，读数1101；再次明确轮子、弯向和巡线模块都使用车尾向车头视角。因此O3为左内侧，与当前物理左→右O4/O3/O2/O1一致，不交换通道或反转纠偏符号。

已准备有效巡线时每轮目标下限40mm/s，以及OLED目标/实测轮速与左右PWM命令诊断；停止且ON时保存最后O3-only运动样本（从未遇到则保存最后有效样本），OFF恢复当前静态读数。40是试验目标下限，不是测得的稳定转速阈值；限制差速会减小起步转弯能力，动态效果尚待现场验证。两轮PI、电机/编码器符号、GPIO、OLED驱动与纯按键操作保持。

准备期间发现实际工程头文件DPT_LINE_GAIN先由8改12，再改16；两次接入前哈希校验均拦截覆盖，未安装新代码或编译新固件。已向用户确认最终增益并请暂停编辑，待参数确定再复核和编译。原始报告与现有工程不同，因此不能把准备包当作工程当前已编译固件。尚无本趟数字化轮速/PWM，左轮慢的根因仍未确认。

### 2.57 用户半圆自动停车反馈；任务二整圈首次接入（2026-10-11）

用户自行调参、修正初始化限制后报告“已经能跑半圆”，并确认是自动停车；随后明确要完成任务二绕一圈。此次只记录该用户反馈，不把独立半圆当作四段整圈验收。用户确认实际场地半径60cm，保持已跑通的600×π毫米半圆长度。

接入前读取实际Sunward最新参数：DPT_LINE_MM=(600×π)、巡航200mm/s、起步50mm/s、增益64、差速上限80mm/s、半圆超时45s；初始化检查已由固定200mm改为正值并允许新速度。以这份实时工程作为基线，不覆盖回旧8/16增益或20cm参数，也没有安装2.56中暂停的轮速下限诊断包。

新增MOVE_TASK2四段AB直线→BC半圆→CD直线→DA半圆。直线1000mm、任务二直线巡航200mm/s，半圆沿用用户参数。白底直线保持航向，接近预期里程窗口±200mm且稳定30ms见有效线才入弧；近半圆末端窗口±200mm、预期航向误差±20°且全白30ms才出弧，白底确认期间先零电机输出；中途丢线依旧立即零、100ms锁存。缺入口1200mm或缺出口2085mm停止。B/C/D换段各非阻塞500ms声光，回A刹车停稳后第4次声光；不靠蓝牙或手动换段。

OFF长按选择新增第三模式，顺序任务一→独立半圆→任务二→任务一；OFF短按松手CAL，READY+ON新短按启动，忙状态新按STOP和OFF优先保持，复位默认任务一。OLED显示TASK 2 ONE LAP、当前AB/BC/CD/DA、累计时间与当前段里程；独立半圆标题更新TEST HALF ARC，末行目标不再错误写死200。故障后新启动从AB开始，必须回A摆车。

主机四段合成编码器/航向/探头输入模拟通过（含四次提示、最终停稳及<30s模拟用时，但不证明实车速度或时间），16码与独立半圆参数、原任务一/GO20/航向/手动回归、模式按键/无蓝牙、换段边界/错航向/早黑/丢线/缺边沿、STOP/OFF/双口RX/MPU/FAST/GAP/LOW/ADC/STALL/REV/超时及时间回绕通过。实际工程接入并全量ARM编译成功，FLASH34988B、RAM5360B，只有原main未使用警告；只改dual_pi_test.c/.h，其他控制/硬件配置逐字节保留。

尚未代为烧录。四段现场衔接、顶点覆盖及每点提示位置、回A停车和30s要求待现场实测；本版45s是联调保护上限，不是任务二30s验收通过。题目标准半径40cm，本版按用户实际60cm场地配置。

操作：[任务二整圈说明](/Users/mzh/Desktop/车车/output/固件接入包/T12_任务二整圈接入包/任务二整圈操作说明.md)。固件：[Sunward.hex](/Users/mzh/Desktop/车车/output/固件接入包/T12_任务二整圈接入包/Sunward.hex)。HEX SHA256 `5cd99f7eea70d545d5320d46ce686b14b979b472bb759204991e3dfb7a1b66a0`。备份：[Sunward_任务二前备份_2026-10-11_henbzfhz](/Users/mzh/Desktop/车车/output/固件备份/Sunward_任务二前备份_2026-10-11_henbzfhz)。

### 2.58 任务二首圈反馈：第一半圆后持续停车（2026-10-11）

用户报告“现在第一个半圆走完就会直接停掉”。尚未提供OLED首行选中模式、第三行故障状态/段名/用时或本趟日志；不能认定第一半圆出口故障根因，也不据此前主机模拟判定实车四段衔接通过。

核对实际Sunward源码与参数：仍为任务二四段版，半径60cm（600×π）、巡线200/50mm/s、增益64、最大差速80。BC出口要求约1685～2085mm段里程、终点航向相对起点180°±20°、全白稳定30ms；满足后切CD、提示C并使用直线航向继续。白底确认期间输出零，但不应持续停车。半圆中途/出口条件未满足的全白持续100ms会LOST；错航向可能使出口门槛不成立或在直线段触发YAW。若仍在独立半圆模式TEST HALF ARC则该模式本来在1885mm停。

已请求停车后OLED第三行原样读数（如LOST BC/YAW CD/DONE DA及时间）以区分问题；此轮仅只读检查与记录，没有修改、编译或烧录新程序，未调整巡线参数或放宽丢线保护。

### 2.59 LOST BC T13.4、S1256：任务二出口校准与用户半圆长度更新（2026-10-11）

用户回复停车状态LOST BC T13.4、当前段S1256。旧任务二半圆600×π≈1885mm，出弧窗口1685～2085mm；1256不在窗口内，即使航向正确也将全白当中途丢线，100ms后LOST。主机用旧配置、S1256及正确终点航向复现此路径。

助手仅将DPT_TASK2_ARC_MM改为独立1256mm，任务二出弧窗口1056～1456mm，同一主机输入成功切CD并提示C；两个对称半圆使用同一校准里程。保留出口航向±20°及全白30ms、丢线100ms及原全部保护；本趟无角度数据，仍不能证明现场角度条件必然满足。

初次修正版编译后观察到用户自行把独立半圆DPT_LINE_MM由600×π改为400×π，并生成新HEX。未覆盖该用户修改，包头文件同步最新400×π，重新验证主机并只全量编译现有工程（没有再写工程源码），最终HEX与用户新生成HEX完全一致。此前用户说半径60cm，1256≈400×π、当前源文件400×π与半径40cm相符，但没有新的尺测半径，只记录读数与源文件变化，不写成新实测几何。

最新参数：独立半圆400×π≈1257mm、任务二校准1256mm、巡线200/50mm/s、增益64、差速80；任务一、PI、OLED驱动、主程序/GPIO/MPU/UART/ioc/EIDE/配置不变。整圈、16码、独立半圆、原GO100/GO20/航向/手动、三模式无蓝牙、各换段边界与STOP/OFF/两端RX/MPU/FAST/GAP/LOW/ADC/STALL/REV/超时/时间回绕主机验证通过。实际ARM全量编译成功，FLASH34988B、RAM5360B，仅原main未使用警告。

未代烧录或操作车辆。BC→CD、DA→A的现场衔接、提示位置、最终停车和30s要求待新固件实测。HEX SHA256 `0828a816bebb763748441aaa06e6b8968b11efb450d39d6b5e267cce6e126730`。操作：[出口修正版](/Users/mzh/Desktop/车车/output/固件接入包/T12_半圆出口里程修正版/半圆出口修正操作说明.md)。固件：[Sunward.hex](/Users/mzh/Desktop/车车/output/固件接入包/T12_半圆出口里程修正版/Sunward.hex)。修改前备份：[Sunward_出口里程修正前备份_2026-10-11_bck1ykba](/Users/mzh/Desktop/车车/output/固件备份/Sunward_出口里程修正前备份_2026-10-11_bck1ykba)；另保留用户新编辑后构建备份。

### 2.60 Sunward按功能模块拆分与软件验证（2026-10-11）

按用户“现在就模块化、分模块写”的要求，以实际Sunward当前源码为基线，将原1026行dual_pi_test.c拆为car_app、car_pi、car_wheel、car_heading、car_line、car_button、car_route、car_command、car_power、car_signal、car_ui共11个独立编译模块。CarApp私有持有按模块分组的上下文，内部接口显式传入上下文；PI内核不依赖HAL。main改用CarApp接口，dual_pi_test.c仅保留旧接口转发；不是通过include .c拼接源码。

全部51个DPT参数逐项与接入前一致，集中到Core/Inc/car_config.h；原GPIO/定时器/MPU/异步UART/OLED底层源码与ioc经哈希确认未变。保持当前独立半圆400×π、任务二弧段1256mm、巡线200/50mm/s、增益64和原PI/CPR/周长，45s仍为开发保护上限。软件重构不新增整圈或30s现场验收结论。

原运动与任务二测试沿用原断言；旧单文件与分别链接的新模块对照电机写入、GPIO声光、串口帧、OLED文本和轮询后状态，113009+129735=242744个事件/采样摘要一致。CarApp新接口与DualPITest兼容接口均通过，ASan/UBSan无异常，覆盖三模式按键、无蓝牙、完整四段、1256出口、停稳和各故障优先/回绕。统一入口为工程tools/tests/run_tests.py；主机模拟不替代实物测试。

首次接入时编辑器重生成构建清单漏掉新增模块，链接失败后自动还原源码与Debug构建。随后EIDE增加CarModules显式引用，Debug/Release排除这些模块的普通目录重复引用；其他构建/烧录选项不变。修正后实际工程完整ARM编译链接及常用builder.params入口重编译均通过，所有模块各编译一次；FLASH35036B（较原版+48B）、RAM5360B（不变），只有原main未使用诊断的警告。

实际工程：[模块说明](/Users/mzh/STM32Cube/Sunward/MODULES.md)、[CarApp入口](/Users/mzh/STM32Cube/Sunward/Core/Src/car_app.c)、[调参入口](/Users/mzh/STM32Cube/Sunward/Core/Inc/car_config.h)。接入证据：[模块化包](/Users/mzh/Desktop/车车/output/固件接入包/T13_模块化重构/安装记录.json)。完整接入前备份：[Sunward_模块化前备份_2026-10-11_pvw63pzt](/Users/mzh/Desktop/车车/output/固件备份/Sunward_模块化前备份_2026-10-11_pvw63pzt)。新HEX SHA256 `165e2a31d363a0696e39c2ed1ccbfbb363982ea0328f26c76e9d100fef530311`，位于实际工程build/Debug/Sunward.hex及模块化包。

本轮未烧录、未打开真实串口/蓝牙、未操作电机。原实测结论沿用2.59及此前记录；新模块固件的实物行为仍需在下一次正常现场运行中确认。

### 2.61 任务三接入模块化Sunward并完整编译（2026-10-11）

用户明确要求“接入一下呀 我要烧录了”。本轮以实际已安装的T13模块化工程为基线，备份Core、tools、.eide、Debug构建与ioc至[任务三前备份](/Users/mzh/Desktop/车车/output/固件备份/Sunward_任务三接入前备份_2026-10-11_2coz7puq)，接入独立car_task3/car_task3_port及整车调度。

新增第四模式任务三：A朝C起步，AC/BD各约1280.6mm，CB/DA弧段1256mm，C/B左转对正、D右转对正，顶点停稳→仅前进单轮转向→捕获/航向或巡线。40秒总计时，A启动加C/B/D/A到达共5次声光，最终A提示在停稳后发出。保持任务一/二和原半圆/巡线/PI调参，任务三参数独立集中在car_config。OFF长按模式循环任务一→独立半圆→任务二→任务三→任务一；OFF短按松手CAL，READY+ON新短按启动，忙时新按STOP。复位默认仍为任务一。

实际CarApp与旧兼容接口下任务一/二/三主机回归、ASan/UBSan通过：路线与声光、零目标轮清积分/无后退命令、保留原保护、故障优先、重新启动、TX拥堵、计数与时间回绕。完整ARM重编译49个单元成功，FLASH42324B、RAM5520B；只有原main未使用警告。源码和配置对照确认main/底层驱动/ioc及原调参保持。

实际工程和接入包HEX一致，SHA256 `165e2a31d363a0696e39c2ed1ccbfbb363982ea0328f26c76e9d100fef530311`。固件：[任务三Sunward.hex](/Users/mzh/Desktop/车车/output/固件接入包/T14_任务三接入包/Sunward.hex)。操作：[任务三烧录说明](/Users/mzh/Desktop/车车/output/固件接入包/T14_任务三接入包/任务三烧录操作说明.md)。本轮未代烧录或操作车辆；转向位移、探头捕获、顶点/弧线投影覆盖和40秒要求仍待真实场地实测。

### 2.62 任务二长按回任务一：下载产物复查与重建修正（2026-10-11）

用户烧录后报告任务二长按又回任务一。复查实际源码已有第四模式，但实际Debug ELF不含任务三标题/CarTask3符号，与旧三模式行为一致；先前仅核对HEX副本SHA没有充分验证实际下载内容。此次完整重建实际工程，FLASH42324B/RAM5520B，将Debug STLink下载目标明确为build/Debug/Sunward.hex。

核对新ELF包含CarTask3_Start/Update，解码HEX含TASK3标题；ELF经objcopy导出的闪存内容与HEX逐地址一致。新版HEX119136字节，SHA256 `b953aa908464f9eaac7e3bc48eacb9603a505b0b4380f9267edd7d6f0d127f39`；ELF SHA256 `0abb806b2afb8bc0579500ca9c4b007dc29a74f4c668494a55fe235701ecd698`。原构建和下载配置备份：`/Users/mzh/Desktop/车车/output/固件备份/Sunward_任务三下载修正前备份_2026-10-11_bi0go3am`。接入包和烧录说明同步更新。本轮未代烧录，任务二→任务三实物切换仍待用户重新下载确认。

### 2.63 任务三初始朝B，陀螺仪自动对正AC（2026-10-11）

用户要求起步利用陀螺仪自己转向，并确认“可以，初始朝B”。本轮已接入实际模块化Sunward：以启动航向为AB场地参考，AC目标为起始航向减atan2(800,1000)≈38.66°。左轮前进、右轮零目标，通过陀螺仪角度反馈右转；±3°稳定30ms后双轮停稳200ms再进入AC，停稳期间偏航超差返回对正。启动转向共用原始4秒/80mm预算，转向里程不计入AC，总40秒计时包含启动对正。

OLED标题更新为 `TASK 3 AUTO START`，启动阶段显示TURN A/WAIT A及当前角/目标角；新增P9启动对正、P10启动停稳，旧阶段编号保持。模式选择、校准/启停和任务一/二参数保持。

暂存及实际工程的CarApp/兼容入口回归、ASan/UBSan均通过，包含初始右转/停稳门槛/偏航重对正/里程隔离/启动STOP和完整路线。实际工程全量ARM构建49单元成功，FLASH42800B、RAM5528B；只有原main未使用诊断警告。安装第一次产物校验发现中文路径经JSON转义导致构建根仍指向暂存目录，自动恢复接入前文件；修正路径映射并断言实际rootDir后重新安装构建成功。

实际ELF包含任务三符号和AUTO START标题，解码HEX也包含新标题，ELF导出闪存数据与HEX逐地址一致，实际项目与包内HEX哈希一致。HEX SHA256 `1ffd841ee4556884f3bc7ad63317c5e35fc3d5fe4c27a321bfc8bd0ce85b1242`。接入前备份 `/Users/mzh/Desktop/车车/output/固件备份/Sunward_任务三启动转向前备份_2026-10-11_uwyslvvc`。固件：[新版Sunward.hex](/Users/mzh/STM32Cube/Sunward/build/Debug/Sunward.hex)。操作与验证：[启动自动转向说明](/Users/mzh/Desktop/车车/output/固件接入包/T15_任务三启动自动转向包/任务三烧录操作说明.md)。本轮未代烧录或操作车辆，单轮转向位移、真实轨迹/点位覆盖与40秒达标仍待现场验证。

### 2.64 任务三第一半圆中途停车反馈，复位后故障读数丢失（2026-10-11）

用户报告任务三“在第一个半圆时停了”，随后确认已经沿半圆走了一段才停；停车后误按RESET，未保留第三/四行故障字段或本趟日志。可确认用户反馈已进入第一半圆CB，但停车原因、所在里程/航向仍未确认，不据此认定转向/捕获或整圈验收通过。

只读核对实际工程任务三/路线/巡线/配置与T15相同，Debug HEX哈希仍为T15版本，ELF含TASK 3 AUTO START。CB/DA弧长1256mm已使用当前校准值，未使用旧任务二1885mm的出口里程。CB预期出弧窗口1056～1456mm，还须相对AB起始参考约180°±20°及全白稳定30ms；中途无有效线立即输出零，持续100ms锁存LOST，其他轮速/低压/时序/传感器保护也可能停车。

缺少故障字段，暂不改巡线增益、出弧窗口或保护限值。下一次正常运行若再次停车，保留OLED第三/四行原样读数并记录大致位置；如有本趟串口日志可据其判断。此次没有修改/构建/烧录固件，没有操作车辆。

### 2.65 LINE CB T13.6s、P8 F6 S1319：定位C后捕获门槛与反馈修正（2026-10-11）

用户提供第三行LINE CB T13.6s、第四行P8 F6 S1319（先抄成319，复查为1319），确认标题TASK 3 AUTO START。用户已移动车辆位置但尚未复位/重新启动；P/F/S/时间仍锁存，Y与当前LF可能已变化，因此没有停车瞬间航向或探头数据。助手最初把LINE描述成巡线无效过于笼统，查代码后已更正：任务三F6也映射为LINE。

按已核对T15源码：CB实际半圆阶段F6只在段里程超过1456mm触发，反向里程为F10、普通丢线为F7/LOST。S1319/F6指向C后捕获超时或超过60mm，此阶段段名已CB但S仍包含前面AC与衔接里程。主机复现捕获越界显示LINE CB/F6，以及停车后推车不改变P/F/S而Y可改变；不能据此区分本趟2秒超时或60mm门槛。

确认代码缺陷：捕获阶段即使偏侧探头已看到有效黑线也只固定切线航向前进，没有用黑线反馈居中。本轮改car_task3捕获输出：有效非居中线用原LF反馈纠偏；居中稳定30ms后入弧并重置弧段里程；白底/无效图样保留有限切线找线。保留50mm/s、60mm/2秒、20°、原丢线/整圈/启停保护及任务一/二调参，只修改生产car_task3.c及回归测试。

新增偏线回归对原代码失败、修正后通过；C/D两侧反馈、居中入弧、白底找线、门槛与停车后移动保持通过，实际工程CarApp/兼容入口ASan/UBSan全套回归通过。实际ARM49单元全量构建成功，FLASH42808B、RAM5528B；原main未用诊断警告保留。实际ELF/HEX逐地址一致，实际/暂存HEX闪存内容一致且不同于T15。HEX SHA256 `23da9869e92293440055de638f9d497271ac0edcf03c16ffbe4800e082063936`；备份 `/Users/mzh/Desktop/车车/output/固件备份/Sunward_任务三入弧修正前备份_2026-10-11_ncqt4d0f`。

新版：[实际工程Sunward.hex](/Users/mzh/STM32Cube/Sunward/build/Debug/Sunward.hex)。[修正说明](/Users/mzh/Desktop/车车/output/固件接入包/T16_任务三入弧捕获修正包/入弧修正与烧录说明.md)。本轮未代烧录或操作车辆；新增LF反馈修正的软件验证不等于实物入弧、点位覆盖或40秒现场验收。

### 2.66 TIMEOUT DA T40.0s、P8 F4 S993：任务三时间预算及速度调整（2026-10-11）

用户反馈第二半圆未完成停车，第三行TIMEOUT DA T40.0s、第四行P8 F4 S993。本次原因确认为整圈40秒超时：DA已前进约993mm，距当前弧段名义1256mm还差约263mm；没有各阶段日志，不能精确拆分实车巡航、转向、捕获和停稳时间。本次进入DA反馈说明此前C后捕获故障没有在这一趟触发，不据此认定完整路线/点位覆盖或40秒达标。

核对用户提供题目PDF第二页要求（3）：任务三一圈不大于40秒；题面用于时间要求背景，不执行其他参赛规定或改变现有STM32开发范围。本次保留40秒，任务三独立调参：斜线200→240mm/s、转向60→80mm/s、加速100→150mm/s²（新增任务三独立参数）、减速窗口150→100mm、末端速度下限40→60mm/s。保留半圆巡航200mm/s、起步50mm/s、捕获50mm/s和T16黑线反馈入弧。原PI、任务一/二及全部保护、对正/停稳条件不变。

配置校验区分末端速度下限与起步斜坡，允许60mm/s末端下限大于50mm/s起步；起步仍经斜坡限速。实际CarApp用目标速度理想跟随的编码器反馈、假设140mm轮距及理想黑线/弧线航向比较，同一模型旧39730ms、新33160ms；属于软件时间预算，不含实际动力学/安装/打滑，不是现场验收。新增DA S993在40秒的回归仍F4停车、不误报DONE；C/D捕获及CarApp/兼容入口任务一/二/三ASan/UBSan全套通过。

实际工程全量ARM49单元编译链接通过，FLASH42844B/RAM5528B，原main未用诊断警告保留。安装源码对清单一致、实际ELF/HEX逐地址一致、实际和暂存HEX闪存数据一致，确认不同于T16。HEX SHA256 `93e47c1da4ba5fd2101877e76959365af3a60b1eef7cefe3099e489555da1da8`，调整前备份 `/Users/mzh/Desktop/车车/output/固件备份/Sunward_任务三速度调整前备份_2026-10-11_h48uspm7`。固件：[Sunward.hex](/Users/mzh/STM32Cube/Sunward/build/Debug/Sunward.hex)。[速度调整说明](/Users/mzh/Desktop/车车/output/固件接入包/T17_任务三40秒速度调整包/速度调整与烧录说明.md)。本轮未代烧录或操作车辆，实车新速度下的轨迹、提示与40秒结果待现场确认。

### 2.67 LOST CB T12.8s、P8 F7 S182：半圆加速参数独立恢复（2026-10-11）

用户反馈LOST CB T12.8s、P8 F7 S182，并确认“入弧后逐渐加速，然后偏出黑线”。本次锁存为CB中无有效线持续100ms，里程182mm远小于1056mm出口窗口，不是终点/总超时。缺少停车瞬间图样及轨迹日志，不能区分全白/全黑/不连续线，不能认定加速是唯一实物原因。

核对T17：助手虽保持半圆巡航200mm/s，但将共用加速100→150mm/s²，半圆入弧也受到影响。已向用户说明上版未隔离斜线/半圆加速的问题。本轮新增任务三独立arc_acceleration_mmps2及DPT_TASK3_ARC_ACCEL_MMPS2=100，CB/DA恢复T16的起步斜坡，AC/BD继续150。保留斜线240、半圆200、转向80、T16捕获反馈及原全部几何/PI/巡线/任务一二参数，40秒/丢线100ms/对正/停稳门槛保持。

实际CarApp/兼容入口新回归验证CB/DA在入弧1.01秒、S182且有效线时基础目标151mm/s，斜线同时间201.5mm/s；无有效线第一帧双轮零，100ms仍F7停车并保留S182；无效半圆加速配置拒绝。全部任务一/二/三ASan/UBSan回归通过。原假设140mm轮距理想目标跟随模型旧39730ms，本版33540ms，不是实车动力学或场地用时验收。

实际ARM49单元全量构建通过，FLASH42880B/RAM5528B，原main未使用诊断警告保留。安装源清单一致，实际ELF/HEX逐地址一致、实际/暂存闪存内容一致、确认不同于T17。HEX SHA256 `9ab71779c7bce68652ddd54ca961b4b409365df06979f6a27406297f976d691a`，备份 `/Users/mzh/Desktop/车车/output/固件备份/Sunward_任务三弧线加速修正前备份_2026-10-11_9miju_39`。固件：[Sunward.hex](/Users/mzh/STM32Cube/Sunward/build/Debug/Sunward.hex)。[半圆加速修正说明](/Users/mzh/Desktop/车车/output/固件接入包/T18_任务三半圆加速隔离包/半圆加速修正说明.md)。本轮未代烧录或操作车辆，修正是否消除本次实车偏线待用户现场反馈。

### 2.68 LOST CB T11.7s、P8 F7 S90 Y-1：丢线快照接入（2026-10-11）

用户反馈上述读数，最初确认停车后“没动”，随后准备读取LF时表示已移动过车身。停车后Y约-1°有当时读数依据，移动后的当前LF不能还原原始失线图样。若从正常C切线位置沿半径400mm弧线走90mm，几何转角约12.9°；捕获起点、探头安装偏置及实际轨迹未知，不能据此认定唯一实物原因。

T19仅新增诊断，未改变T18速度、加速度、巡线增益、40秒及100ms失线条件。首次无效弧线采样在清目标前保存原始LF、左右目标/实测速度与角度，另存最近有效LF和纠偏差。F7停车后OLED每两秒切换两页，标题TASK 3 SNAP V1；OFF或搬动车身不改快照，RESET/新启动/重新选模式清除。软件回归包含首次失线、瞬态恢复、OFF/移动保持及重新启动清除。

实际Sunward全套ASan/UBSan回归及ARM49单元编译通过，FLASH43824B/RAM5576B；实际ELF与HEX闪存逐地址一致，实际/暂存固件一致。HEX SHA256 `6b6888ae88f6665af239a0619bc5759c38842cab49b7c26a5b79183734c7d31a`。备份 `/Users/mzh/Desktop/车车/output/固件备份/Sunward_任务三丢线快照前备份_2026-10-11_mt3d3bmd`。[快照说明](/Users/mzh/Desktop/车车/output/固件接入包/T19_任务三丢线快照包/丢线快照查看说明.md)。仅证明软件接入与验证，未代烧录；不认定已消除实车丢线。

### 2.69 用户再次反馈第二半圆未完成停车（2026-10-12）

用户表示当前代码在第二半圆没开完就停，已离开场地，未提供本次OLED故障信息，也未确认所烧录版本。此次原因未确定；此前2.66的TIMEOUT DA T40.0s可作为历史证据，不能直接套用于此次停车。未要求用户返场重跑。

复核当前Sunward：T19五个修改文件与安装清单一致，当前Debug HEX与T19包内HEX及安装哈希一致。实际配置仍整圈40000ms，从启动自动转向开始计时；半圆连续无有效线100ms报F7，出口判定仍需里程窗口、全白、末端航向及稳定时间同时成立。TIMEOUT/F4与LOST/F7应分别诊断，没有将40秒放宽或根据未知故障继续修改速度/增益。快照版已准备完成，用户已烧录的实际版本及本次现场原因仍未知。

### 2.70 LINE DA T29.2s、P8 F6 S1308 Y173：D点入弧捕获门槛修正（2026-10-12）

用户反馈上述读数，并确认“刚前进一小段就停”。当前任务三总超时40秒，此次29.2秒/F6不是超时。ARC阶段越界F6要求段里程>1456mm，所以S1308对应D后CAPTURE失败；阶段文字DA在D点转向前已切换，捕获阶段S沿用BD起点，不能解释成半圆已走1308mm。Y173°接近D切线180°。捕获LF/阶段计时未获得，不能确定触发60mm还是2秒，也不认定唯一现场根因。

源码发现捕获仅接受正中两路黑持续30ms，单路/三路连续黑已可巡线纠偏却不能完成捕获。T20改为连续有效线30ms即进入ARC，稳定窗口持续50mm/s基础巡线纠偏，确认转换帧仍零输出清控制器并重设弧段基线。无效样本重置计时；1～3路连续黑的译码条件、捕获60mm/2秒/20°、40秒总限制、失线100ms及其他保护保持。任务一/二行为及全部速度/增益不变，T19丢线快照保留。新标题TASK 3 CAP V2。

C/D单路和三路非中心图样回归在旧源码的进入ARC断言失败，修正后通过；验证窗口中持续纠偏、基线重置、短暂失效重建稳定窗口、全黑/不连续拒绝及有效线仍受超时/航向/距离限制。实际CarApp与兼容入口ASan/UBSan六套及全量ARM49单元通过。理想模型33540ms仅为软件验证。实际与暂存闪存内容一致、实际ELF与HEX逐地址一致，FLASH43804B/RAM5576B。

HEX SHA256 `9b2e0fa9fe35e703034f32b447fdb7068e2b0e8a9dc281fe3c0a5506972fbad7`，安装前备份 `/Users/mzh/Desktop/车车/output/固件备份/Sunward_任务三有效线捕获前备份_2026-10-12_mhoryjrf`。[修正说明](/Users/mzh/Desktop/车车/output/固件接入包/T20_任务三有效线捕获修正包/入弧捕获修正说明.md)。已接入实际Sunward并生成可烧录固件，未代烧录/操作车辆；本次实物捕获是否恢复待用户下一次正常运行确认。

### 2.71 用户反馈任务三已完成一次，任务四四圈接入（2026-10-12）

用户明确反馈“刚才任务三完成了”，仍担心第二半圆开始没吃到黑线导致暂停；要求先做任务四，完成后去多测试几遍。本轮记为用户报告的一次完成，总时间、最后OLED及逐点覆盖数据未提供，不能认定重复稳定性/完整现场验收。不要求用户立即补测，也未调整已完成任务三的速度或捕获参数。

核对题目第二页要求（4）：按要求3路径自动行驶4圈停车，用时越少越好。T21新增任务四模式与car_task4配置模块，共用既有八字路线核心。A→C→B→D→A四圈；前三圈A短暂停稳后提示并自动对正AC接续，第四圈A停稳后最终DONE。总17次提示。初始A朝B及首次右转38.66°保留，圈间固定陀螺仪参考、不重新校准、不清累计时间/里程；任务四整段160秒故障保护，任务三仍40秒/1圈。任务四故障不自动恢复，新启动清圈数。T20有效线30ms捕获、60mm/2秒/20°门槛及T19丢线快照保持。

菜单扩展为任务一→独立半圆→任务二→任务三→任务四→任务一；RESET后OFF长按松手四次选任务四，从任务三只需一次。TASK4 FOUR LAPS标题及当前圈/段/总时间显示已接入；GPIO校准/READY/ON短按流程不变。新增TASK4!维护入口，正常启动不需要蓝牙。

八套实际CarApp/兼容入口ASan/UBSan回归通过，验证四圈/三次A停稳接续/17次提示/固定参考与总时限/后续圈保护/重启/溢出等。理想目标跟随假设140mm轮距模型133560ms，不是场地验收。实际ARM50单元全量构建通过，FLASH44496B/RAM5576B，实际ELF/HEX逐地址一致、实际与暂存固件一致。原main未用诊断警告保留。

实际Sunward基于Git4334a99接入，改动未提交/推送。HEX SHA256 `a7ec941025fe53ac9355d375bbfa957f73480ba1a785292b25c743d9bbf7f52d`，备份 `/Users/mzh/Desktop/车车/output/固件备份/Sunward_任务四接入前备份_2026-10-12_57n58mu7`。[任务四说明](/Users/mzh/Desktop/车车/output/固件接入包/T21_任务四四圈接入包/任务四烧录与操作说明.md)。本轮未代烧录或操作车辆；任务四四圈实测及第二半圆入弧重复性待用户之后反馈。

### 2.72 任务四 LOST 2/4 CB T47.7，快照因RESET丢失（2026-10-12）

用户反馈屏幕第三行LOST 2/4 CB T47.7，随后确认已经RESET并准备再测一次。记录为任务四第二圈CB半圆失线停车，不是160秒总超时。没有本次LF/PRE、段里程/角度、纠偏和左右目标/实测轮速，不能确认偏出方向、入弧位置或动力学原因；RESET已清快照，当前探头读数不能还原该次失线。

圈数显示2/4表明程序已完成第一圈并进入第二圈，不等于第一圈点位覆盖已独立验证，也不认定四圈完成。当前Sunward仍Git4334a99加T21工作区改动，源配置四圈/160秒，故障快照仍两秒轮换并可在OFF下保留。本次仅记录现场反馈，未修改控制参数或重新烧录。用户自选重跑；如再次停车，应先关使能并保留两页信息再RESET。

### 2.73 LOST 1/4 CB T11.6、F7 S174 Y17：完整快照与任务四半圆独立降速（2026-10-12）

用户本次完整反馈：LOST 1/4 CB T11.6；P8 F7 S174 Y17；LF1111 PRE1101；E-100 C-64 PRE1；T136/264 V121/222。记录为第一圈CB半圆已吃到有效线后持续失线100ms；不是F6捕获/总超时。原始PRE1101与E=-1表示黑线在偏左内侧，目标右轮264高于左轮136、C=-64，向左纠偏符合CB方向；下一次采样全白。

失线首次采样平均实测171.5mm/s（目标200），实测差速101（目标128），右轮222低于目标264。有瞬时跟随滞后，但缺少PWM/积分/电池及完整轨迹，不能确定饱和/打滑/过冲/欠转等唯一原因。没有将222认定为硬件上限，也未修改探头排列/转向符号。

T22只调整任务四半圆独立配置：巡航200→160、加速100→70；任务三已完成的200/100及任务四斜线/转向/捕获、共享巡线增益、四圈/17次提示/160秒保护保持。同样E=-1的新目标108.8/211.2mm/s，极端偏线时96/224，半圆单轮最大目标280→224。此次为保守减轻轮速负担，现场是否消除失线待反馈。

新增第一/第二圈半圆起步/巡航/差速上限与失线快照回归通过；八套CarApp/兼容入口ASan/UBSan及实际ARM50单元全量构建通过。理想目标跟随假设140mm轮距四圈146040ms，不是实车时间验收。FLASH44508B/RAM5576B，实际ELF/HEX逐地址一致、实际与暂存固件一致。

新标题TASK 4 ARC V2。HEX SHA256 `ead34d28ac26ba8d615bacd56ead0cf9d9f08de5a6b909310a823bbf4fcd40af`，修改前备份 `/Users/mzh/Desktop/车车/output/固件备份/Sunward_任务四半圆轮速修正前备份_2026-10-12__8c4tnsk`。[轮速修正说明](/Users/mzh/Desktop/车车/output/固件接入包/T22_任务四半圆轮速修正包/半圆轮速修正与烧录说明.md)。已接入实际Sunward，Git改动未提交/推送，未代烧录或操作车辆。

### 2.74 用户要求Git回退，恢复T20任务三提交（2026-10-12）

用户反馈T22“改坏了”，要求回退，随后明确使用Git回退，并询问对应T几；未提供T22新故障的动作/日志，不追加根因推断。核对Git HEAD为4334a9933c56284744901322ac33886a67674e31（任务三），Core、tools/tests、.eide共75个已跟踪文件与T20暂存源码75/75完全一致。因此恢复目标为T20，不是保留任务四的T21。

已先留档当前未提交修改，再用git restore将17个已修改跟踪文件恢复到4334a99，移除已留档的3个未跟踪任务四文件：car_task4.h/car_task4.c/test_task4.c。未移动HEAD、未改远程历史、未创建或推送新提交。最终Git工作区干净。回退前留档 `/Users/mzh/Desktop/车车/output/固件备份/Sunward_Git回退前留档_2026-10-12_k53adv86`。

忽略任务四旧构建参数，按T20的49单元构建清单重建。六套CarApp/兼容入口ASan/UBSan及实际ARM全量编译通过；实际ELF/HEX逐地址一致，闪存内容与T20已验证固件完全一致。HEX SHA256 `9b2e0fa9fe35e703034f32b447fdb7068e2b0e8a9dc281fe3c0a5506972fbad7`。实际工程标题恢复TASK 3 CAP V2，任务四模式已撤回。[Git回退记录](/Users/mzh/Desktop/车车/output/固件接入包/T24_Git回退T20/Git回退记录.json)。本轮仅软件回退和重建，未代烧录，车上已烧固件不会自动改变。

### 2.75 从Git T20重新编写独立任务四（2026-10-12）

用户要求“回退完后重新写任务四”。以Git4334a99/T20干净工作区为基础重写。car_task3.c/.h逐字节保持T20，无Git差异；CarTask4模块独立管理已完成圈数、固定AC参考、总时间和A点接续，不再将多圈字段/分支加入任务三核心。

每圈T20核心在A出口且轮速≤5mm/s持续200ms后报告DONE，任务四计数。前三圈在零输出状态重新建立单圈阶段，复用T20启动的陀螺仪转向+停稳流程；固定最初AC参考，不根据A点当前角度重定义航向，不重新CAL。单圈阶段时间/里程基线重建，任务四总时间/累计里程保持。保留上一圈A提示，抑制下一圈重复启动A提示，共17次。第四圈最终DONE，故障不自动重跑，新启动清计数。

Task3时限40秒保留；Task4总保护160秒、内层单圈80秒故障上限。四圈路线及原阶段限制保持，速度与T20相同（斜线240/半圆200、加速150/100、转向80、捕获50）。未加入T22降速。以往现场失线根因仍未确定，不认定独立调度重写消除了现场偏线。

八套CarApp/兼容入口ASan/UBSan回归及实际ARM50单元全量编译通过，包含四圈/三次A转向停稳接续/17次提示/固定参考（A点读数偏移）/总超时/后续圈保护/重启/溢出。理想目标跟随假设140mm轮距模型134190ms，不是场地实测。FLASH44856B/RAM5592B，实际ELF/HEX逐地址一致、实际与暂存固件一致。新标题TASK 4 REBUILD V1，原任务三标题CAP V2保留。

HEX SHA256 `27a0f17128f1fd89ba3c4713f3a888617a96db6a55b04dec6e561c6c1db2d4b6`，接入前备份 `/Users/mzh/Desktop/车车/output/固件备份/Sunward_任务四独立重写前备份_2026-10-12_0qdc9a1m`。[独立重写说明](/Users/mzh/Desktop/车车/output/固件接入包/T25_任务四独立重写包/任务四独立重写与烧录说明.md)。Git基准仍4334a99，改动未提交/推送，git diff --check通过。本轮未代烧录或操作车辆，四圈实车结果待用户之后正常测试反馈。

### 2.76 更换车架后任务一定距偏长（2026-10-14）

用户报告：“我现在测试了任务一，更换框架后的，现在任务一跑了105cm”。记录为更换车架后的一次用户实测反馈，实际距离约 1050 mm。当前本地任务一目标 `DPT_ROUTE_MM=1000 mm`；若测量采用起止相同的车身参考点并在完全停稳后读取，则相对目标多 50 mm，约 +5%。测试地点、测量参考点、轨迹直线程度、停稳状态与重复性尚未提供，不据此认定完整任务一验收或归因于重量变化。

本轮核对实际 Sunward：仍使用 `DPT_CIRC_M=0.2042035225 m`、左/右 CPR `60104.3333/59996.3333`；任务一以左右编码器平均里程达到目标进入 BRAKING，期间继续累计编码器里程，轮速绝对值均不超过 5 mm/s 持续 200 ms 后 DONE。OLED 定距行显示 `S 实际估算里程/目标mm`。本地已有 T27 任务四容错增强，但本次车上烧录版本尚未确认；此前 T27 不调整任务一目标、轮周长、CPR 或减速参数。

已询问本次停稳后的 DONE 状态、S 数值，以及 105 cm 是否按车身同一个参考点测得。若停稳 S 接近 1000 而尺量 1050，应优先检查里程换算、测量方式或未被编码器反映的滑移；若停稳 S 本身接近 1050，则应优先检查达到目标后的继续滚动与停车过程。单次数据不足以区分这些因素。本轮未调整固件参数、未烧录，也未要求额外的宿舍地面测试。

用户后续补充：“state done s1002/1000mm，但是我量出来大概是103cm左右”。当前采用最新反馈：停稳显示 DONE，编码器估算累计 1002 mm，目标 1000 mm，尺量约 1030 mm。尚未说明这是对原 105 cm 的重新测量还是另一次运行，不把两次口述算作两轮重复性验证。编码器超过目标仅 2 mm，而尺量比估算约多 28 mm（相对估算约 +2.79%）；优先检查有效滚动距离换算和起止测量参考点，不能据此断言是重量导致刹车过冲，编码器未反映的滑移仍未排除。

仅作候选计算：若同一车身参考点、轨迹及重复测量均支持此比例，而且电机/编码器参数未变，距离比例为 `1030/1002≈1.027944`，现有有效周长乘此系数约为 `0.2099098086 m`。这只是单次近似数据下的候选值，不是已完成标定。全局周长同时参与其他任务的速度与里程换算，本轮保持 `DPT_CIRC_M`、CPR、PI 和任务一目标原值，未修改或烧录固件。起止是否同一参考点、轮胎及电机是否沿用原件仍待确认。

### 2.77 同一参考点与原电机轮胎确认；BD 到 D 漏线（2026-10-14）

用户随后确认起止使用同一参考点，电机及轮胎沿用原件，并报告换车架后任务一、任务二都可以完成。按用户反馈记录，未追加完整轨迹/声光/用时数据要求，也未据单次约 103 cm 的尺量修改全局里程换算或 PI。

任务三报告 `LINE BD T27.7s P8 F6 S1401 Y-141`，用户进一步明确“从黑线旁边偏过去了”。本次是 BD 斜线到 D 的有效线检测失败，而不是已进入第二半圆后的失线。P8 是故障状态；BD 名义长度 `hypot(1000,800)≈1280.625 mm`，末端限制加 120 mm 得 1400.625 mm，S1401 对应此超限；27.7 秒没有到 40 秒总超时。若初始 A 朝 B 且校准角接近 0，BD 名义航向约 -141.34°，与本次 -141° 相近，但航向相近不能证明横向位置正确。车上烧录版本未独立核实；本次映射与当前及既有任务三核心一致。

### 2.78 按车身投影要求增加任务三、四受限寻线 T28（2026-10-14）

用户明确希望探头全白时能够尝试找线，避免仅因没读到黑线结束。已核对题目第二页“说明（4）”：顶点由车身地面投影覆盖，圆弧期间投影必须始终与弧线重叠；探头全白不能直接等同车身完全离弧，也不能据恢复成功推断中途始终合规。

已以当前 T27 为基准接入 T28。C/D 名义斜线里程处仍全白时，先停，再仅向前转到下一半圆切线，停稳后低速接近；原顶点窗口保留，搜索总预算 3 秒/80 mm，找到连续有效线后才发点位提示。半圆全白且本段有有效历史时允许 40 mm/s 短程桥接，限制 300 ms/20 mm/12°，使用最后一次可信纠偏与航向参考；连续有效 30 ms 后低速恢复。全黑、异常图样、无历史不授权桥接，单帧噪声不续期、不更换可信方向。

任务三也增加近目标转向降速；C/B/D 转向后增加停稳及航向复核，保留原转向预算，避免转向余动进入下一段。此处属于有依据的衔接改进，尚未证明它就是本次横向偏出的唯一原因。任务一/二控制、全局轮周长/CPR/PI、40 秒/160 秒保护保持。

十套实际模块 ASan/UBSan 回归及实际 STM32 50 单元构建通过，FLASH 47180 B、RAM 5656 B，暂存/实际及 ELF/HEX 闪存数据一致。标题为 TASK 3 SEEK V1 / TASK 4 SEEK V1。[说明与固件](/Users/mzh/Desktop/车车/output/固件接入包/T28_任务三四受限寻线包/受限寻线与烧录说明.md)。T27 备份在 `/Users/mzh/Desktop/车车/output/固件备份/Sunward_T28受限寻线前备份_2026-10-14__mppjzp1`；本次未烧录、未操作车辆、未提交/推送，不认定已通过新车架的连续投影覆盖及任务三现场验收。

### 2.79 用户报告任务四“第四次”在 B 点停住（2026-10-14）

用户反馈：“刚才任务四的时候，第四次的后半圈没开，在B点停住了”。先记录为任务四在 B 点附近停止的用户观察。“第四次”是第四圈还是第四次重跑尚未明确；未收到标题、状态、圈数、路线段、用时及 P/F/S/Y，当前不能认定前三圈已完成，也不能区分正常短暂停稳、停稳/转向故障、顶点检测或总超时。

按任务三/四路线 A→C→B→D→A，B 点之后应对正 BD 斜线，抵达 D 后才进入第二半圆 DA。因此“在 B 点停住”本身不证明发生了 DA 入弧失线。当前本地是 T28，但用户本次车上烧录版本未确认，不将此前 T28 软件编译结果等同本次运行版本。

已请求停住时的屏幕标题、状态/圈数/段/时间和 P/F/S/Y，并请用户明确第四圈或第四次重跑。若还保留现场屏幕信息，先不要 RESET；本轮仅记录和代码核对，不修改时限、转向、寻线、PI 或里程参数，不要求另跑一趟补测。

用户回复“没看，我再去做一次”。本次故障屏幕数据未取得，用户自行选择重跑；没有据此追加原因判断或修改固件。后续如再次停车，记录 RESET 前的屏幕四行，以核对运行版本、圈数及故障阶段。

### 2.80 暂存 B 点停车问题；先推 T28，再减少 A/B/C/D 原地转向（2026-10-14）

用户明确要求暂不改上一条 B 点停车问题，保留待查，先把当前代码上传 GitHub，再增加转向余量；进一步确认 A、B 的斜线对正也一起减少。此前停车仍缺标题、圈数、时间和 P/F/S/Y，不追加根因判断，不把本次修改称为解决了该停车问题。

修改前当前 T28 源码、中文注释和测试共 38 个文件已提交并成功推送 GitHub main，提交 [647300237b77a8ed63d9c459ead725308eb5bc7e](https://github.com/Mu-Miao/Sunward/commit/647300237b77a8ed63d9c459ead725308eb5bc7e)，标题“任务三四受限寻线与容错基准（T28）”。远端获取和推送输出确认 main 从 cc6c874 前进至 6473002；本地工作区干净后才准备 T29。

T29 在任务三/四统一增加 5° 原地转向留量。A 目标为真实 AC 参考加 5°；C 切线目标减 5°；B 的 BD 对正目标减 5°；D 切线目标加 5°。按理想 AB 零参考，原地目标转角约 38.66°→33.66°，实际仍含 ±3° 对正容差。A/B 起步后航向反馈仍趋向原斜线方向，C/D 留量低速捕获后交给巡线；真实 AC 参考、赛道几何、半圆出口航向与四圈参考不重新定义或累加漂移。

实际工程已接入。十二套实际模块 ASan/UBSan 回归和 STM32 50 单元构建通过，FLASH 47392 B、RAM 5664 B，暂存/实际及 ELF/HEX 闪存数据一致；覆盖全部点位方向、斜线反馈收敛、C/D 捕获、停稳、配置检查和 0° 参数回退。保留任务一/二控制、轮速标定、PI、各项保护及阶段预算；未针对 B 点停车另调故障时限。

[T29 说明与固件](/Users/mzh/Desktop/车车/output/固件接入包/T29_任务三四转向余量包/转向余量与烧录说明.md)。修改前 T28 备份：`/Users/mzh/Desktop/车车/output/固件备份/Sunward_T29转向余量前备份_2026-10-14_g_johs5b`。新标题 TASK 3 TURN V2 / TASK 4 TURN V2。本次新角度改动尚未提交/推送、未烧录、未实车测试，不把软件验证视为投影覆盖或现场用时验收。

### 2.81 用户主动回退到 T28，T29 交付固件仍保留（2026-10-15）

用户询问能否烧录 T29，随后说明“我已经回退到了T28”。现场核对本地工程 OLED 标题为 TASK 3 SEEK V1 / TASK 4 SEEK V1，Debug HEX SHA256 为 `39c1800c812c830bad6bfeaf319f3eab732c1aae045ecca32b04232f84aad80a`，与已验证 T28 交付包一致；这是用户主动回退，不据此重新接入或覆盖为 T29。用户这句话没有单独确认车上已烧录哪一版。

T29 包内 HEX 仍为 `6ef094d8ff2c5f87662489a0dd8846e5a68b74216b6be017d60ca2f28bc340c8`，与 T29 安装时的已验证固件一致，可作为独立固件文件选择烧录。当前从 Sunward 工程重新编译/下载会得到 T28；要试 T29，应明确选择 T29 包内 HEX，选择任务三/四后标题应为 TURN V2。两版交付包均未被本轮修改，本轮未烧录或操作车辆。

## 3. 电机点动测试与停止

| 现象/数据 | 记录及解释 |
|---|---|
| 初期两轮都不动 | 你报告过此现象；之后点动已调通 |
| A命令1200 | 你报告“1200的时候A才动”；最终确认A正命令向前 |
| A、B同时设为1200，按Reset不动 | 你报告过；实验代码有“两个CMD不能同时非零”的保护，因此这次不动不能用来证明双轮供电或驱动故障 |
| 点动后来正常 | 你确认“ok了”，之后继续核对轮子及编码器映射 |
| 1200对应的驱动量比例 | 按代码7200满量程计算，`1200/7200≈16.7%`；这是代码换算，不是示波器实测占空比 |

1200是这次测试中能带动A的命令值；尚未精确测得起转阈值，不能认定每个电机、每种负载都必须到1200才能起转。

整理时核对到的代码状态：

```c
#define LAB_ENABLE_ON_RAW 0
#define LAB_TEST_A_CMD    0
#define LAB_TEST_B_CMD    0
```

`Lab_MotorTestOnce()`调用已注释；初始化仍调用`Lab_MotorStartBrake()`。点动实验脉冲时长为代码设置的100ms，实际持续时间尚未用仪器测量。

PWM配置（代码核对）：TIM3、PSC=0、ARR=7199、四通道PWM mode 1、High极性、初始Pulse=7200。按72MHz定时器时钟计算，PWM周期对应10kHz。

**尚未提供的实物证据：** 四个电机输入停止时是否均高、点动波形是否约10kHz、停止时的实际制动/滑行表现。串口CCR或BRAKE提示不能替代这些测量。

## 4. 两个开关与USB供电

### 4.1 使能开关

你实测：ON=0，OFF=1。程序对应`LAB_ENABLE_ON_RAW=0`。

这是PC13上的逻辑使能开关；按原理图，它与切断电池主供电的开关作用不同。

### 4.2 电池电源开关和USB

你观察到：连接USB串口时，关闭电池电源开关后，程序仍能运行、串口仍有ADC数据。

原理图中USB经D3接入板上5V，再由稳压电路产生3.3V，所以USB也能给单片机供电。PC1经分压测的是电池电源开关后的VIN；它不直接测开关前的电池端子。

OFF时仍读到约484的具体硬件原因尚未实测定位。USB通过板上电路反向影响VIN是可能的解释，不能当作已查明的结论。

**处理原则：** 不把484当成ADC零偏，不从正常电池读数中减去484。

## 5. 串口、基础GPIO与LF04

### 5.1 串口设置

截图显示串口参数：115200波特率、8数据位、无校验、1停止位。

### 5.2 基础GPIO检查

2026-10-06上传的截图记录：

| 截图 | 四路原始输入 | KEY | EN_RAW | CFG |
|---|---|---:|---:|---|
| 13:55:55截图 | 1、1、1、1 | 0 | 0 | FAIL |
| 14:00:38截图 | 1、1、1、1 | 0 | 0 | PASS |

后一次截图证明当时程序的基础GPIO配置检查已通过。KEY=0只是该截图时的原始状态，没有提供按键按下/松开的完整实测结果。

### 5.3 LF04暂缓项目

你当时没有白底黑线，所以暂不填写黑白测试表。四路都读到1，不足以确认黑线/白底的电平含义，也不足以验证四路对黑白的响应。

以下仍待记录：每路在白底/黑线上的原始值、实际左右排列、传感器安装高度、阈值调节和现场光照条件。电机、编码器、定时器和ADC的独立测试可以继续；自动巡线要等这些输入标定完成。

## 6. TIM2的10ms节拍（9.3）

代码核对：

| 项目 | 配置 |
|---|---|
| 定时器时钟 | 72MHz |
| PSC | `72-1=71` |
| ARR | `10000-1=9999` |
| 计算周期 | `(71+1)×(9999+1)/72000000=10ms` |
| 启动 | `HAL_TIM_Base_Start_IT(&htim2)` |
| 回调 | 每次TIM2更新中断递增`lab_tick10_count` |

你先报告“只出现一行就停了”。当时核对发现`Lab_PrintTickRate()`在无限循环之外；调整花括号位置后，你确认“ok 正常输出”。

验收日志应约为`TIM2: 100 ticks in 1000 ms`。你已确认持续正常输出，但没有在聊天中提供逐行日志数值，所以本文不编造每次实际ticks/elapsed。

状态：平均节拍验证通过。每拍抖动、加入控制任务后的耗时和漏拍尚未测量。目前回调只计数，还没有运行速度PI或航向控制。

## 7. 电池ADC（9.4.1）

### 7.1 已核对的配置和调用

| 项目 | 值 |
|---|---|
| 输入 | PC1 / ADC1_IN11 |
| GPIO | Analog |
| Scan / Continuous / Discontinuous | 均关闭 |
| 普通转换通道数 | 1 |
| 触发 | 软件触发 |
| 数据对齐 | 右对齐 |
| 采样时间 | 239.5 ADC时钟周期 |
| ADC时钟 | PCLK2 72MHz ÷8 = 9MHz |
| 启动校准 | 初始化后调用`HAL_ADCEx_Calibration_Start()` |
| 读取 | Start → PollForConversion → GetValue → Stop |
| 日志间隔 | 主循环每100ms打印BAT_RAW |

整理前检查到最新代码已编译成功；ADC读取代码已接完整。

### 7.2 你提供的实际测量

| 供电条件 | ADC raw | 万用表实测 | 备注 |
|---|---:|---:|---|
| USB连接，电池电源开关OFF | 约484 | 未提供VIN/PC1实测值 | 单片机仍由USB供电；不是ADC零点 |
| USB连接，电池电源开关ON | 1349～1355 | 电池两端11.94V | 电池标称12V |
| 仅电池供电、USB拔除 | 待测 | 待测 | 尚未报告此条件下的测量 |

### 7.3 原理图换算与第一组校验

原理图分压：上臂R2=10kΩ，下臂R3=1kΩ，倍率为11。假设ADC参考电压为3.3V：

```text
VIN估算值 = raw / 4095 × 3.3 × 11
```

| raw | PC1电压估算 | VIN电压估算 |
|---:|---:|---:|
| 484 | 约0.390V | 约4.290V |
| 1349 | 约1.087V | 约11.958V |
| 1355 | 约1.092V | 约12.011V |

对照电池实测11.94V，本组估算值高约0.018～0.071V，差异约0.15%～0.60%。参考电压尚未实测；电池端子与VIN也可能有开关和接线压降，因此这只是当前第一组对照结果，不是全量程精度结论。

状态：ADC读取及第一组电压对照正常。第二组不同实际电池电压下的“万用表电压＋raw”仍待记录。

## 8. MPU6050原始数据与偏航轴（9.4.2）

数据来源：[records-2026-10-07-14-13-45.json](/Users/mzh/Downloads/records-2026-10-07-14-13-45.json)。原文件保留未修改。

记录时间：2026-10-07 14:13:18.849～14:13:35.348，持续16.499秒，共166组原始数据。串口接收时间戳间隔99～101ms，中位数100ms；这是日志接收间隔，不是对MCU采样抖动的仪器测量。

### 8.1 转动时各轴变化

| 轴 | 最小raw | 最大raw | 最大值减最小值 |
|---|---:|---:|---:|
| GX | -1877 | -612 | 1265 |
| GY | 1455 | 2315 | 860 |
| GZ | -5536 | 7114 | 12650 |

GZ变化明显大于另外两轴，支持Z轴作为本车平面转弯的偏航轴。加速度AZ中位数15971；当前代码配置±2g，其数值接近静止重力对应16384 raw，作为辅助观察，未作加速度标定。

### 8.2 你再次确认的操作

- 观察方向：站在车尾，面向车头。
- 第一次明显转动车头（约14:13:20，GZ大幅变正）是向左转。
- 开始约1秒、结束约3秒，小车均完全静止。
- 你补充确认：过程中不是匀速转动。本轮只用于辨识偏航轴和方向，不要求匀速；转速变化会使陀螺仪原始值大小变化。后续求角度时需要按各次角速度和实际时间间隔积分，不能用峰值角速度乘整段时长。
- 你随后补充：上一次是推着小车向前行进并转弯，并非原地转动车身。前进中的转弯同样改变车头方向，因此这段日志仍可用于辨识偏航轴和左右转符号；不把它当作有明确90°参考的转角验收。下一轮原地水平转动是为了更方便对齐初始和90°方向，并非陀螺仪只能测原地转动。

据此，后续统一相对航向：**Z轴，左转为正，右转为负**。判断符号应针对扣掉静止零偏后的角速度，不能直接拿负的静止raw判断车仍在右转。

### 8.3 静止零偏候选

| 时段 | 样本数 | GX平均raw | GY平均raw | GZ平均raw |
|---|---:|---:|---:|---:|
| 开始约1秒 | 10 | -1218.5 | 1867.3 | -422.8 |
| 结束平稳段14:13:31.849～14:13:35.348 | 36 | -1235.1 | 1867.1 | -422.7 |

两个静止段GZ平均值接近，因此本次偏航零偏候选为约-423 raw。结束段GZ标准差约11.6 raw。本次记录仍不能替代每次开机、模块稳定后保持静止的正式零偏校准，不把-423永久写死为常数。

当前Sunward驱动设置并读回陀螺仪±250°/s，换算系数131 raw/(°/s)。后续计算应为：

```text
偏航角速度(°/s) = (GZ - 本次静止校准的平均GZ) / 131
```

若不扣除本次约-423 raw的零偏，静止时直接换算约为-3.23°/s，积分30秒可能造成约-97°的虚假变化。这只是由零偏计算出的误差示例，不是已经完成的30秒角度漂移实测。

### 8.4 本轮结论与下一步

原始数据持续读取和偏航轴/方向辨识已完成。上传文件没有包含启动时的status、WHO、GYRO、ACCEL等配置日志；当前代码只有初始化及读回检查成功才会打印原始数据，但仍应另外保留一次完整启动日志作为记录。

下一步：正式静止采样求零偏，使用实际采样时间积分相对角度，再完成手动约90°和静止30秒漂移测试。对应诊断代码和放置位置已准备，见[零偏与角度操作指南](/Users/mzh/Desktop/车车/output/固件接入包/MPU6050_9.4.2接入包/9.4.2_下一步_零偏与角度.md)；目前实物结果仍待测。当前100ms串口日志不是已接入的10ms航向控制任务，不用本段随手转动的记录冒充90°精度验收。

### 8.5 正式校准与相对转角日志（15:28）

数据来源：[records-2026-10-07-15-28-55.json](/Users/mzh/Downloads/records-2026-10-07-15-28-55.json)。共143条串口记录，其中139条为角度输出。原文件保留未修改。

本次完整记录了启动到角度计算：

| 项目 | 日志实测/读回 |
|---|---|
| 基础GPIO检查 | pullup=PASS |
| PWM初始化提示 | BRAKE A/B，CCR1..4=7200；未提供实物波形 |
| MPU初始化 | status=0、ADDR=0x68、WHO=0x68、LINES=3 |
| 电源/采样配置读回 | PWR=0x01、DIV=9、DLPF=3 |
| 量程配置读回 | GYRO=0x00（±250°/s）、ACCEL=0x00（±2g） |
| 校准开始 | 15:28:21.047 |
| 校准完成 | 15:28:26.050，CAL OK |
| 静止零偏 | BIAS_Z=-424.44 raw（500组均值） |
| 校准期间Z轴最大最小差 | SPAN_Z=31 raw |
| 输出中的采样间隔 | DT_US=9995～10004µs，约10ms |
| 故障提示 | 本文件未出现FAIL、CAL UNSTABLE、GAP或SATURATED |

输出中的DT_US只是每条日志对应的最近一次读取间隔，不是全部采样间隔的完整统计，也不是示波器测量。

转动前的平稳段AGE_MS=202～15002：YAW范围0.00～0.08°，末值0.07°，W范围-0.06～+0.12°/s。若该段确实静止，可作为约15秒的初步漂移观察，不能代替30秒测试。

之后正向转动，结束平稳段AGE_MS=20002～27802：YAW范围89.25～89.29°，平均约89.273°，末值89.28°；W回到-0.04～+0.13°/s附近。角度保留在约89.3°、角速度回到0附近，是相对角度累加后的正常表现。

你确认：实际是左转约90°，只是目测，没有使用纸上直角或其他明确角度参考。因此本次记录为“目测左转约90°，程序测得约+89.3°”，证明方向和量级一致，不把与90°相差约0.7～0.8°直接当作传感器的测量误差。

状态：串口输出、完整身份/量程读回、500组零偏校准和相对角度计算已跑通。本次中途转动，且最终AGE_MS=27802，不是从置零开始连续静止30秒的漂移验收。

### 8.6 负向转角与再次校准日志（15:33～15:34）

数据来源：[records-2026-10-07-15-34-19.json](/Users/mzh/Downloads/records-2026-10-07-15-34-19.json)。共178条串口记录，其中172条为角度输出。原文件保留未修改。

文件开头15:33:27.175出现一次`YAW CAL UNSTABLE`，表示那次校准被程序拒绝；仅凭该提示无法确认具体原因。15:33:36.403出现新的启动日志，随后重新校准成功。成功这段的结果如下：

| 项目 | 日志实测/读回 |
|---|---|
| MPU初始化 | status=0、ADDR=0x68、WHO=0x68、LINES=3 |
| 配置读回 | PWR=0x01、DIV=9、DLPF=3、GYRO=0x00、ACCEL=0x00 |
| 校准开始/完成 | 15:33:38.745 → 15:33:43.749，CAL OK |
| 静止零偏 | BIAS_Z=-424.00 raw（500组均值） |
| 校准期间Z轴最大最小差 | SPAN_Z=27 raw |
| 输出中的采样间隔 | DT_US=9995～10004µs，约10ms；仅统计打印时的最近一次读取间隔 |
| 成功校准后的故障提示 | 未出现新的校准失败、读取失败、间隔异常或饱和提示 |
| 首条/末条角度输出 | AGE_MS=202 / 34402 |

开始平稳段AGE_MS=202～6002：YAW范围-0.01～+0.01°，末值-0.01°；W范围-0.08～+0.04°/s。之后发生明显负向转动，整段打印角速度最低为-44.62°/s。

结束平稳段AGE_MS=22002～34402：YAW范围-90.61～-90.57°，平均约-90.594°，末值-90.61°；W范围-0.09～+0.06°/s。角速度回到0附近，积分角度保留在约-90.6°，与负向转动后停住的行为一致。该平稳段首末角度变化约-0.04°，持续约12.4秒；是否完全静止尚待你确认。

你确认：实际右转约90°，使用纸上直角或其他直角参考。程序停稳后测得约-90.6°，右转为负的符号正确；相对名义-90°相差约-0.6°（角度幅值大约0.6°）。这是一组有方向参考的初步对照，尚未统计重复性，也未测量手动对齐误差，不把0.6°认定为传感器独立误差或精度上限。

**仍未完成连续静止30秒测试：** 最后AGE_MS虽达到34402，但中途转动过。验收漂移时须重新启动，等待CAL OK后从置零开始保持车身不动，直到AGE_MS至少30000，再比较起止YAW。此日志无需据此修改积分代码。

### 8.7 连续静止约62秒的漂移记录（15:38～15:39）

数据来源：[records-2026-10-07-15-39-35.json](/Users/mzh/Downloads/records-2026-10-07-15-39-35.json)。共312条串口记录，其中310条为角度输出。原文件保留未修改。

**你确认的操作条件：校准时碰过车，CAL OK后一直静止。** 因此本轮可记录当前校准结果下的静止漂移，但不能写成“从启动到校准结束都完全静止”。

| 项目 | 日志结果 |
|---|---|
| MPU初始化与配置读回 | status=0、ADDR=0x68、WHO=0x68、PWR=0x01、DIV=9、DLPF=3、GYRO=0x00、ACCEL=0x00、LINES=3 |
| 校准完成 | 15:38:30.963，CAL OK，置零YAW=0.00 |
| 本轮零偏 | BIAS_Z=-424.70 raw |
| 校准Z轴最大最小差 | SPAN_Z=173 raw；高于此前31、27，且你确认校准时碰过车 |
| 第一条角度 | AGE_MS=202，YAW=0.00° |
| 约30秒 | AGE_MS=30002，YAW=+0.01° |
| 约60秒 | AGE_MS=60002，YAW=+0.11° |
| 最后一条 | AGE_MS=62002，YAW=+0.11° |
| 前30秒角度范围 | -0.03～+0.01°，最大最小差0.04° |
| 全段角度范围 | -0.03～+0.11°，最大最小差0.14° |
| 全段打印角速度范围 | W=-0.09～+0.10°/s |
| 打印时最近一次采样间隔 | DT_US=9998～10001µs |
| 角度日志间隔 | AGE_MS每条增加200ms，未出现重置或缺失的打印节拍 |

本轮置零后30秒的角度漂移约+0.01°，62秒约+0.11°，短时静止表现良好；数据只代表这次供电、温度及本轮校准条件，打印分辨率为0.01°，不能据此宣称传感器具有0.01°绝对精度。文件未见校准失败、读取失败、间隔异常或饱和提示。DT_US仅对应打印时最近一次读取，不是全部内部采样的完整统计。

本次程序虽接受了校准，但校准期间碰车可能影响零偏，CAL OK不能替代实际静止条件。下一步重新Reset，从预热、校准一直到CAL OK后至少30秒，全程不碰车、不拉USB线，再记录一次漂移；目前无需根据本日志修改代码。

### 8.8 30秒漂移复测（15:43～15:44）

数据来源：[records-2026-10-07-15-44-08.json](/Users/mzh/Downloads/records-2026-10-07-15-44-08.json)。共159条串口记录，其中157条为角度输出。原文件保留未修改。

你确认：本轮从按Reset松手后，到校准完成和记录结束，全程没有碰车或拉动USB线。全程静止条件已确认。

| 项目 | 日志结果 |
|---|---|
| MPU初始化与配置读回 | status=0、ADDR=0x68、WHO=0x68、PWR=0x01、DIV=9、DLPF=3、GYRO=0x00、ACCEL=0x00、LINES=3 |
| 校准完成 | 15:43:35.457，CAL OK，置零YAW=0.00 |
| 本轮零偏 | BIAS_Z=-425.91 raw |
| 校准Z轴最大最小差 | SPAN_Z=36 raw；相比上一轮碰车时173，波动明显减小 |
| 第一条角度 | AGE_MS=202，YAW=0.00° |
| 约30秒 | AGE_MS=30002，YAW=+0.03° |
| 最后一条 | AGE_MS=31402，YAW=+0.04° |
| 前30秒角度范围 | 0.00～+0.03° |
| 全段角度范围 | 0.00～+0.04° |
| 全段打印角速度范围 | W=-0.08～+0.09°/s |
| 打印时最近一次采样间隔 | DT_US=9995～10004µs |
| 角度日志间隔 | AGE_MS每条增加200ms，未出现重置或缺失的打印节拍 |

本轮置零后30秒角度变化约+0.03°，短时漂移很小；文件未见校准失败、读取失败、间隔异常或饱和提示。目前无需修改代码。结合你确认的全程静止条件，本轮30秒静止漂移检查已完成。此结果不代表各种温度、供电条件下的精度或长期漂移，DT_US也不是全部内部采样的完整统计。

### 8.9 左转与转回起始方向（15:50）

数据来源：[records-2026-10-07-15-50-37.json](/Users/mzh/Downloads/records-2026-10-07-15-50-37.json)。共185条串口记录，其中183条为角度输出。文件前7条角度属于上一次运行，AGE_MS约36202～37802；之后重新校准。本次分析只使用15:50:00.932的CAL OK之后176条角度输出，避免把不同置零基准的两段混在一起。原文件保留未修改。

| 项目 | 本次校准后的结果 |
|---|---|
| 校准开始/完成 | 15:49:55.928 → 15:50:00.932，CAL OK |
| 零偏与校准波动 | BIAS_Z=-425.22 raw，SPAN_Z=27 raw |
| 起始平稳段 | AGE_MS=202～4002，打印YAW均为0.00° |
| 左转后平稳段 | AGE_MS=10002～18002，YAW=+89.02～+89.05°，平均约+89.03° |
| 回转后平稳段 | AGE_MS=27002～35202，YAW=-0.36～-0.35°，平均约-0.354° |
| 最后角度 | AGE_MS=35202，YAW=-0.36° |
| 打印角速度范围 | -42.82～+35.03°/s |
| 打印时最近一次读取间隔 | DT_US=9995～10003µs |
| 本次角度打印间隔 | AGE_MS每条增加200ms，未见中途重新置零 |

数据呈现“由0向正方向转到约+89°，停稳，再向负方向转回约0°”的完整过程。转动期间最大角度+89.47°、回转期间最低-0.95°含手动调整过程；比较方向参考时应使用停稳段，而非运动中的极值。成功校准后未见读取失败、间隔异常、饱和或新的校准失败提示。

实际是否使用直角参考左转约90°、再转回原来的方向，待你确认。若按该方法操作，则本次左90°对照约+89.03°，相对名义+90°差约-0.97°；回到原方向后读数约-0.36°。两者都含手动对齐误差，不能仅凭一轮把它们当成传感器自身的绝对误差。本次中途转动车身，不属于新的连续静止30秒测试；此前15:43的静止漂移记录仍有效。

## 9. 尚未完成的记录

- LF04白底/黑线四路响应与排列标定。
- 电机停止四输入均高、点动PWM频率及实际停止行为。
- 每圈编码器计数的有标记复测及静止计数检查；16:20初测已记录但不作为CPR。轮径已报告65mm，左右是否相同待确认；轮距、负载下滚动周长和轮速单位换算仍待记录。
- TIM2逐行实际日志，以及正式控制任务加入后的耗时/抖动。
- 第二组电池电压与raw、实际ADC参考电压。
- USB拔除、仅电池供电条件下的运行与测量。
- MPU6050有外部参考的左90°转角对照、转回初始方向的回零偏差和转角重复性。右90°已完成一组有直角参考的初步对照（约-90.6°），左90°此前为目测（约+89.3°）。全程静止的30秒漂移检查已在15:43复测完成（30秒+0.03°）。完整启动身份/量程日志和500组零偏校准已留档；驱动接入、原始读取、偏航Z轴和左右转符号已完成。
- 速度闭环、自动巡线和完整赛道行为；当前不能据上述独立测试认定已经完成。

## 10. 原理图来源

`/Users/mzh/Desktop/车车/资料/主控板/C10B主板原理图_2025-02-24.pdf`

供电与PC1分压参考第1页；USB串口供电、电机驱动和使能开关参考第2页。
