Mu-Miao/Sunward_Data/output/调试工具/本地串口记录工具/使用说明.md

# 验证C10B串口控制线与Reset后的接收

2026-10-10后续：工具增加GO100!，配合[1米直行版本](/Users/mzh/Desktop/车车/output/固件接入包/T09_1米直行接入包/T09_第三步_1米直行与声光.md)。本阶段用户暂缓真实地面测试，可只在OFF状态下载、CAL检查；先不发送GO100。命令固定目标1米、巡航120mm/s、停稳后声光500ms，V/TIME不改变它。正式场地再跑；原GO20功能保留。

2026-10-10：工具增加GO20!命令，配合[20cm定距版本](/Users/mzh/Desktop/车车/output/固件接入包/T09_20cm定距接入包/T09_第二步_20cm定距停车.md)。先下载新固件、OFF静止CAL至READY，再ON发GO20；原GO仍是3秒航向短跑。

2026-10-09：工具增加CAL!/GO!命令，配合[T09航向保持版本](/Users/mzh/Desktop/车车/output/固件接入包/T09_航向保持接入包/T09_第一步_航向保持3秒.md)。需要下载新固件；使能OFF时CAL静止校准，READY后ON再GO。工具不会自动发送启动命令。

2026-10-08手动控制补充：工具现可发送F!/B!/L!/R!/STOP!/S!，以及停车时的V40!..V200!、TIME1!..TIME30!。需先烧录对应的手动控制固件；RUN!保留原三秒实验。具体见[手动试车命令](/Users/mzh/Desktop/车车/output/固件接入包/9.5_蓝牙手动控制包/手动试车命令.md)。本说明下面的Reset对照仅在使能OFF时进行。

适用于“连接能用，但按Reset后没有输出”的定位。2026-10-08已核对C10B原理图：板上CH9102F的RTS经Q1控制BOOT0，DTR/RTS经Q2、D4还可控制NRST。普通串口软件打开时置位RTS，可能使下一次Reset进入系统下载程序，因而没有用户程序日志。当前属于原理图与现象支持的优先假设，尚未测量实物BOOT0/NRST电压。

初版工具没有明确设置DTR/RTS，仍可能继承驱动默认置位状态，不能排除这个因素。新版打开串口后明确取消RTS/DTR置位，并检查驱动读回；CH9102的控制输出为低有效，取消置位预期使物理输出为高电平，从而让Q1关闭、BOOT0由R1下拉。此处驱动读回不代替引脚电压测量。工具仍使用本机Python标准库，不会自动发送RUN；当前MCU代码无需重新下载。

1. 车身固定、双轮架空，使能OFF。
2. 先在网页断开串口；网页已卡住就关闭那个串口助手标签页。不要让两个程序同时占用串口。
3. 原来的本地工具若还在运行，输入`q`回车或Ctrl+C退出。再双击同目录的`打开本地串口.command`，启动新版。
4. 确认看到`[控制线已释放] RTS未置位，DTR未置位`。若报驱动不支持或未释放，保留错误信息，暂不继续Reset。
5. 保持OFF，按一次板上Reset，等5秒。应重新出现`C10B_LINE_LAB boot`和持续DPI输出；再按一次Reset，等10秒。先只验证接收，不发送RUN。原来已经进入下载模式时，取消控制线置位本身不会跳回用户程序，需要这次Reset。
6. 输入`q`回车退出保存。JSON自动在本目录`接收记录`中，同名.bin保留原始字节。若仍没有启动文字，把终端的控制线提示、错误或无数据提示一起提供，继续查实物启动脚/复位脚和程序启动位置。工具出现“接收循环仍在运行”说明本机接收循环没有卡死，不代表MCU正常运行。

终端工具支持手动输入`RUN!`/`STOP!`后按回车发送，保持之前的架空和停车要求；这次对照只需OFF状态按Reset。Ctrl+C也能正常结束并保存。退出工具本身不会自动发STOP或改变使能。

工具按串口收到的原始片段记录，不假设USB一次读取就是一行，因此Reset截断半行仍会保存并继续读取。115200/8N1，无软件/硬件流控。打开串口时驱动仍可能短暂改变控制线，所以以新版“控制线已释放”后的手动Reset作为对照。原来的`.bin`和JSON未修改；修改前脚本与说明保存在`备份_RTS修正前`。

原理图还有两个相关事实：Reset按钮只拉低STM32的NRST，没有断掉USB串口芯片的电源；Type-C VBUS经D3进入板上5V，关闭电池开关并不等于板子完全断电。无需靠反复全断电来代替这次对照。

依据：`/Users/mzh/Desktop/车车/资料/主控板/C10B主板原理图_2025-02-24.pdf`第1页BOOT0/BOOT1下拉，第2页USB、Q1/Q2和RESET电路；[CH9102厂家手册镜像](https://dfsimg1.hqewimg.com/group1/M00/1A/07/wKhk7l_z9MyAUsJoAAKpffOcd60754.pdf)的DTR/RTS低有效定义；[ST AN2606启动说明](https://www.st.com/resource/en/application_note/cd00167594-stm32-microcontroller-system-memory-boot-mode-stmicroelectronics.pdf)。
