Mu-Miao/Sunward_Data/资料/主控板/C10B主板原理图_2025-02-24.pdf

# 3V3PB⁹ PB⁸

# 电池接口

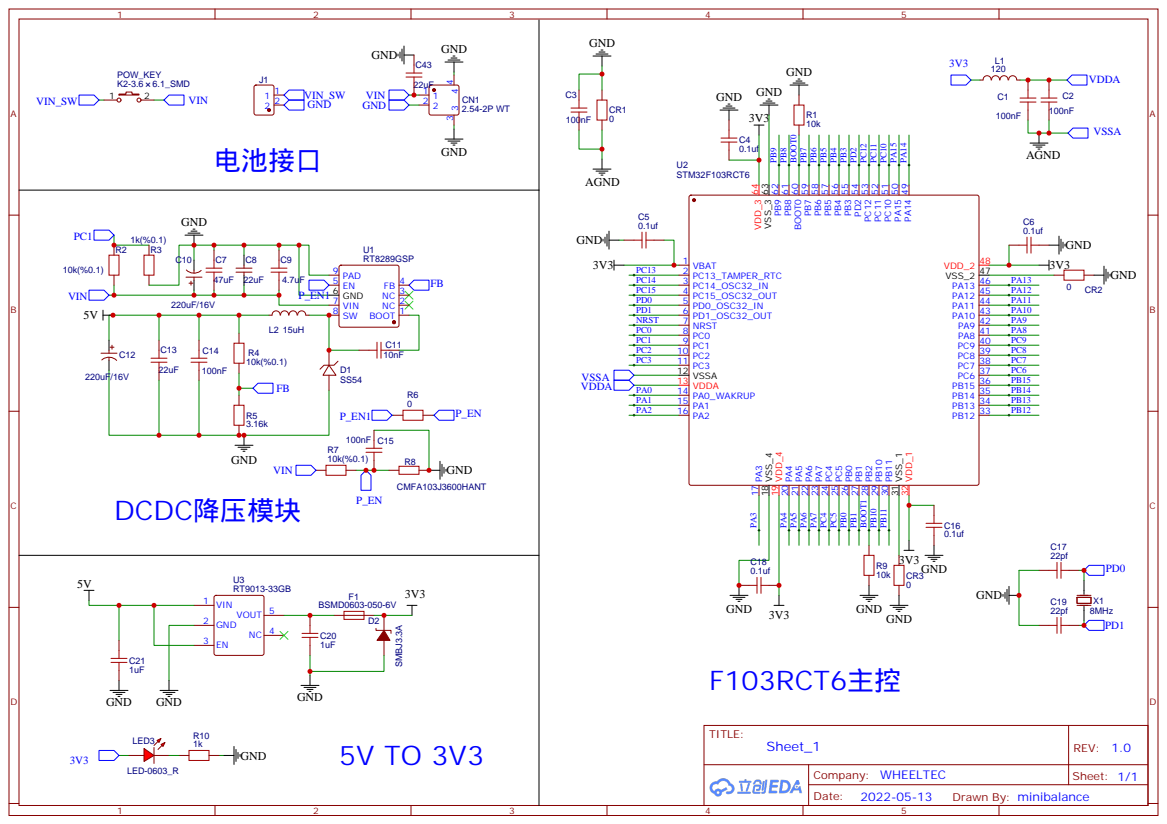
[picture p31: page 1]

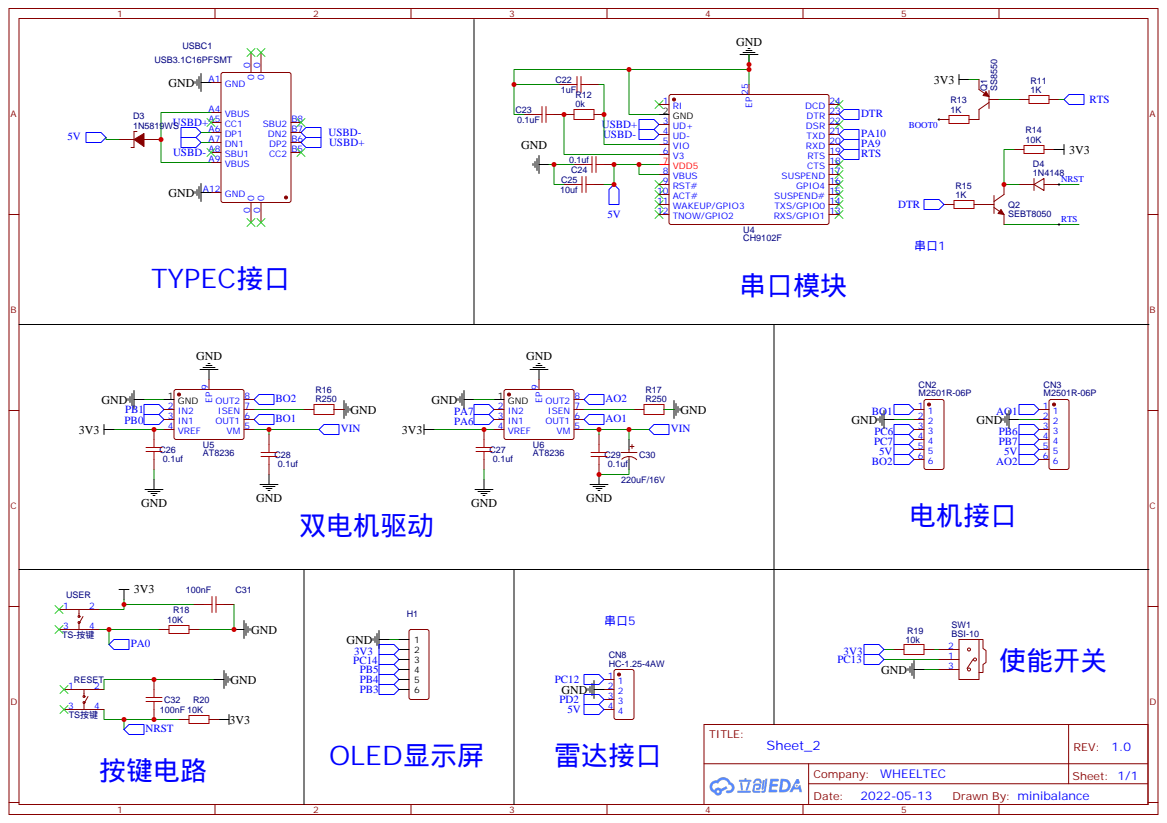
[picture p32: page 2]

# 蜂鸣器

# PS2手柄接口

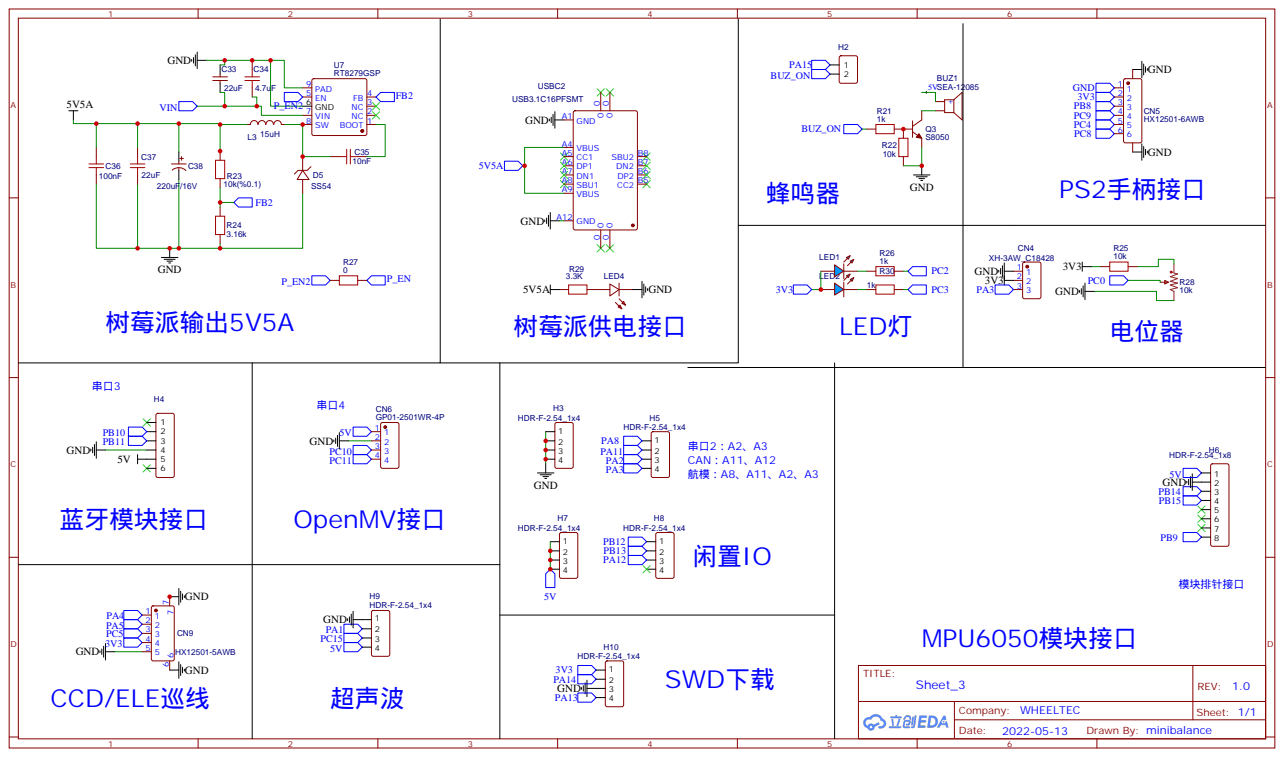
[picture p33: page 3]
