Mu-Miao/Sunward_Data/资料/模块资料/【WHEELTEC】LF04四路红外巡线模块附送资料/3.原理图/四路红外巡线模块原理图.pdf

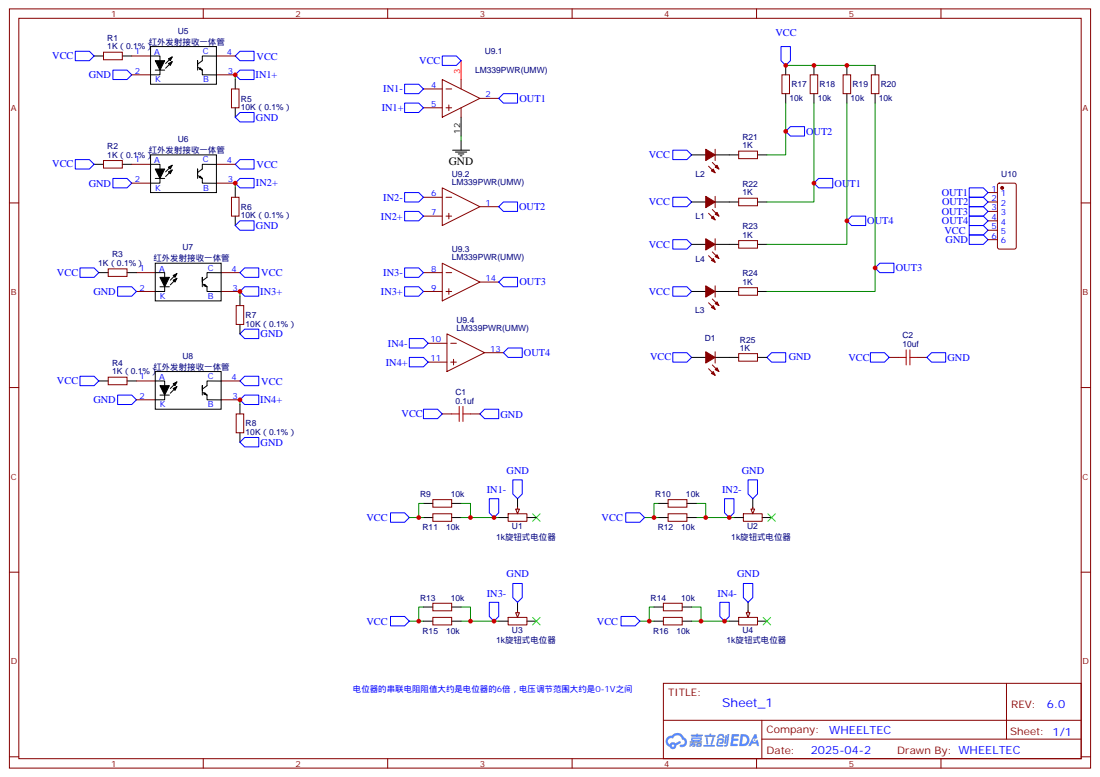
[picture p34: page 1]
