Mu-Miao/Sunward_Data/资料/厂家小车套件/小车/2.使用与开发手册/1.线性CCD相关/CCD巡线模块原理图.pdf

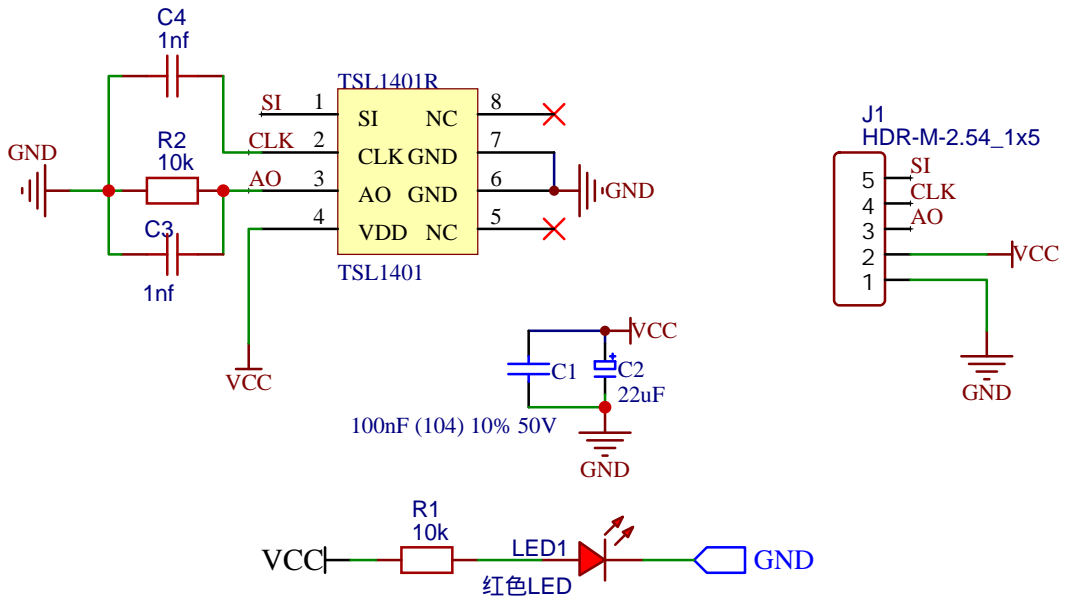
[picture p35: page 1]
