Mu-Miao/Sunward_Data/output/固件接入包/T13_模块化重构/baseline/Sunward.ioc

Mcu.UserName=STM32F103RCTx
PA0-WKUP.GPIO_Label=KEY_U
PA0-WKUP.Signal=GPIO_Input
PA10.Signal=USART1_RX
PA13.Signal=SYS_JTMS-SWDIO
PA14.Signal=SYS_JTCK-SWCLK
PA15.GPIO_Label=Buzzer
PA15.Signal=GPIO_Output
PA6.Signal=S_TIM3_CH1
PA7.Signal=S_TIM3_CH2
PA9.Signal=USART1_TX
PB0.Signal=S_TIM3_CH3
PB1.Signal=S_TIM3_CH4
PB10.Signal=USART3_TX
PB11.Signal=USART3_RX
PB14.GPIO_Label=MPU_SCL
PB14.Signal=GPIO_Output
PB15.GPIO_Label=MPU_SDA
PB15.Signal=GPIO_Output
PB6.Signal=S_TIM4_CH1
PB7.Signal=S_TIM4_CH2
PB8.GPIO_Label=LF4
PB8.Signal=GPIO_Input
PC1.Signal=ADCx_IN11
PC13-TAMPER-RTC.Signal=GPIO_Input
PC2.GPIO_Label=LED1
PC2.Signal=GPIO_Output
PC3.GPIO_Label=LED2
PC3.Signal=GPIO_Output
PC4.GPIO_Label=LF3
PC4.Signal=GPIO_Input
PC6.Signal=S_TIM8_CH1
PC7.Signal=S_TIM8_CH2
PC8.GPIO_Label=LF1
PC8.Signal=GPIO_Input
PC9.GPIO_Label=LF2
PC9.Signal=GPIO_Input
PD0-OSC_IN.Signal=RCC_OSC_IN
PD1-OSC_OUT.Signal=RCC_OSC_OUT
