Mu-Miao/Sunward_Data/output/固件接入包/T29_任务三四转向余量包/staged_Sunward/Core/Inc/main.h

#define LED1_Pin GPIO_PIN_2
#define LED1_GPIO_Port GPIOC
#define LED2_Pin GPIO_PIN_3
#define LED2_GPIO_Port GPIOC
#define KEY_U_Pin GPIO_PIN_0
#define KEY_U_GPIO_Port GPIOA
#define LF3_Pin GPIO_PIN_4
#define LF3_GPIO_Port GPIOC
#define MPU_SCL_Pin GPIO_PIN_14
#define MPU_SCL_GPIO_Port GPIOB
#define MPU_SDA_Pin GPIO_PIN_15
#define MPU_SDA_GPIO_Port GPIOB
#define LF1_Pin GPIO_PIN_8
#define LF1_GPIO_Port GPIOC
#define LF2_Pin GPIO_PIN_9
#define LF2_GPIO_Port GPIOC
#define Buzzer_Pin GPIO_PIN_15
#define Buzzer_GPIO_Port GPIOA
#define LF4_Pin GPIO_PIN_8
#define LF4_GPIO_Port GPIOB
