Mu-Miao/Sunward_Data/示例代码/main_line_oled.c

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
/* Includes ------------------------------------------------------------------*/
#include "main.h"

/* USER CODE BEGIN Includes */
#include "oled.h"
#include <stdio.h>
/* USER CODE END Includes */


void SystemClock_Config(void);
static void MX_GPIO_Init(void);
/* USER CODE BEGIN PFP */
static uint8_t Read_Line_Sensors(void);
static void OLED_Show_Line_Sensors(uint8_t line_data);
/* USER CODE END PFP */

/* USER CODE BEGIN 0 */
static uint8_t Read_Line_Sensors(void)
{
  uint8_t data = 0U;

  if (HAL_GPIO_ReadPin(LINE1_GPIO_Port, LINE1_Pin) == GPIO_PIN_SET) data |= (1U << 0);
  if (HAL_GPIO_ReadPin(LINE2_GPIO_Port, LINE2_Pin) == GPIO_PIN_SET) data |= (1U << 1);
  if (HAL_GPIO_ReadPin(LINE3_GPIO_Port, LINE3_Pin) == GPIO_PIN_SET) data |= (1U << 2);
  if (HAL_GPIO_ReadPin(LINE4_GPIO_Port, LINE4_Pin) == GPIO_PIN_SET) data |= (1U << 3);
  if (HAL_GPIO_ReadPin(LINE5_GPIO_Port, LINE5_Pin) == GPIO_PIN_SET) data |= (1U << 4);
  if (HAL_GPIO_ReadPin(LINE6_GPIO_Port, LINE6_Pin) == GPIO_PIN_SET) data |= (1U << 5);
  if (HAL_GPIO_ReadPin(LINE7_GPIO_Port, LINE7_Pin) == GPIO_PIN_SET) data |= (1U << 6);

  return data;
}

static void OLED_Show_Line_Sensors(uint8_t line_data)
{
  char value_text[] = "VAL:0000000";
  char bar_text[] = "BAR:.......";
  char info_text[22];
  uint8_t active_count = 0U;

  for (uint8_t i = 0U; i < 7U; ++i)
  {
    if ((line_data & (1U << i)) != 0U)
    {
      value_text[4U + i] = '1';
      bar_text[4U + i] = '#';
      active_count++;
    }
  }

  (void)snprintf(info_text, sizeof(info_text),
                 "HEX:%02X  ON:%u", line_data, active_count);

  OLED_WriteString(0U, 2U, value_text);
  OLED_WriteString(0U, 4U, bar_text);
  OLED_WriteString(0U, 6U, "                     ");
  OLED_WriteString(0U, 6U, info_text);
}
/* USER CODE END 0 */

/**
  * @brief  The application entry point.
  * @retval int
  */
int main(void)
{

  /* USER CODE BEGIN 1 */
  uint8_t line_data;
  uint8_t previous_line_data = 0xFFU;
  /* USER CODE END 1 */

  /* MCU Configuration--------------------------------------------------------*/

  /* Reset of all peripherals, Initializes the Flash interface and the Systick. */
  HAL_Init();

  /* Configure the system clock */
  SystemClock_Config();

  /* Initialize all configured peripherals */
  MX_GPIO_Init();
  /* USER CODE BEGIN 2 */
  OLED_Init();
  OLED_Clear();
  OLED_WriteString(0U, 0U, "OUT:1234567");
  /* USER CODE END 2 */

  /* Infinite loop */
  /* USER CODE BEGIN WHILE */
  while (1)
  {
    /* USER CODE END WHILE */

    /* USER CODE BEGIN 3 */
    line_data = Read_Line_Sensors();

    if (line_data != previous_line_data)
    {
      previous_line_data = line_data;
      OLED_Show_Line_Sensors(line_data);
    }

    HAL_Delay(20U);
  /* USER CODE END 3 */
}
}

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
