Mu-Miao/Sunward_Data/output/固件接入包/T13_模块化重构/Core/Inc/car_state.h

#ifndef CAR_STATE_H
#define CAR_STATE_H
#include "stm32f1xx_hal.h"
#include "lab_uart_async.h"

/* Internal application state. Owned by CarApp, used only in foreground.
 * Hardware IRQs continue to communicate through lab_uart_async queues. */
typedef enum { IDLE, RUNNING, DONE, OFF, LOW, ADC_BAD, GAP,
    REVERSE, FAST, STALL, UART_BAD, STOPPED, YAW_BAD, BRAKING,
    TIMEOUT, SETTLE_BAD, LINE_LOST, LINE_BAD } TestState;
enum { LEFT = 0, RIGHT = 1 };
typedef enum { MOVE_NONE, MOVE_TEST, MOVE_FORWARD, MOVE_BACK, MOVE_LEFT,
    MOVE_RIGHT, MOVE_HEADING, MOVE_DISTANCE, MOVE_ROUTE, MOVE_LINE, MOVE_TASK2 } Motion;
typedef enum { Y_NONE, Y_WARM, Y_CAL, Y_READY, Y_FAIL } YawPhase;
typedef enum { KEY_NONE, KEY_CAL, KEY_START, KEY_STOP, KEY_WAIT, KEY_BLOCK, KEY_MODE } KeyAction;
typedef enum { KEY_EVENT_NONE, KEY_EVENT_SHORT, KEY_EVENT_HOLD } KeyEvent;
typedef struct {
    TIM_HandleTypeDef *encoder;
    uint16_t old_count;
    float velocity, integral;
    int command;
    uint32_t bad_sign_us, stall_us;
} Wheel;
typedef struct {
    char text[12];
    unsigned length;
    uint8_t discard;
    uint32_t ms;
} CommandInput;

typedef struct {
    YawPhase phase;
    uint8_t available;
    uint8_t cal_requested;
    uint32_t warm_ms;
    uint32_t cycles;
    uint32_t samples;
    uint32_t io_us;
    int32_t sum;
    int16_t min[3];
    int16_t max[3];
    float bias;
    float angle;
    float previous_rate;
    float reference;
    float error;
    float diff;
} CarHeadingState;

typedef struct {
    KeyAction action;
    uint8_t raw;
    uint8_t stable;
    uint8_t armed;
    uint8_t press_enabled;
    uint8_t off_pending;
    uint8_t press_busy;
    uint32_t change_ms;
    uint32_t events;
    uint32_t hold_ms;
    Motion selected_motion;
} CarButtonState;

typedef struct {
    uint8_t raw[4];
    uint8_t black[4];
    uint8_t valid;
    uint8_t count;
    uint8_t center_seen;
    uint8_t center_ready;
    uint8_t invalid_seen;
    uint32_t center_ms;
    uint32_t sample_ms;
    uint32_t invalid_ms;
    float error;
    float diff;
} CarLineState;

typedef struct {
    Motion motion;
    float distance_mm[2];
    float base;
    float goal;
    float cruise;
    float slow;
    uint16_t distance_count[2];
    uint8_t tracking;
    uint8_t settle_seen;
    uint32_t brake_ms;
    uint32_t settle_ms;
    uint32_t manual_duration;
    uint32_t run_duration;
    uint32_t switch_ms;
    uint32_t start_ms;
    unsigned manual_speed;
    uint8_t switching;
    float targets[2];
    uint8_t leg;
    uint8_t edge_seen;
    uint32_t edge_ms;
    uint32_t elapsed_ms;
    float leg_start;
    float start_heading;
} CarRouteState;

typedef struct {
    Wheel items[2];
} CarWheelState;

typedef struct {
    CommandInput inputs[LAB_UART_COUNT];
} CarCommandState;

typedef struct {
    ADC_HandleTypeDef * adc;
    uint8_t valid;
    uint32_t sample_ms;
    uint32_t raw;
} CarPowerState;

typedef struct {
    uint8_t active;
    uint8_t ready_led_on;
    uint32_t ms;
} CarSignalState;

typedef struct {
    uint32_t render_ms;
    uint32_t oled_log_ms;
    uint32_t line_log_ms;
    uint32_t heading_log_ms;
    uint32_t button_log_ms;
    uint32_t motion_log_ms;
} CarUiState;

typedef struct {
    TestState state;
    uint8_t active;
    uint8_t primed;
    uint8_t on_seen;
    uint8_t bluetooth_on;
    uint32_t hz;
    uint32_t old_cycles;
    uint32_t old_tick;
    uint32_t old_ms;
    uint32_t on_ms;
    uint32_t dt_us;
    char fault_wheel;
    void (* drive)(int, int);
} CarRuntimeState;

typedef struct CarAppContext {
    CarHeadingState heading;
    CarButtonState button;
    CarLineState line;
    CarRouteState route;
    CarWheelState wheel;
    CarCommandState command;
    CarPowerState power;
    CarSignalState signal;
    CarUiState ui;
    CarRuntimeState runtime;
} CarAppContext;
#endif
