Mu-Miao/Sunward_Data/资料/模块资料/【WHEELTEC】LF04四路红外巡线模块附送资料/1.STM32例程/STM32F407VET6_26年H题赛道巡线例程_C30D/SYSTEM/sys/sys.c

#include "sys.h"    

//THUMB指令不支持汇编内联
//采用如下方法实现执行汇编指令WFI  
__asm void WFI_SET(void)
{
	WFI;		  
}
//关闭所有中断(但是不包括fault和NMI中断)
__asm void INTX_DISABLE(void)
{
	CPSID   I
	BX      LR	  
}
//开启所有中断
__asm void INTX_ENABLE(void)
{
	CPSIE   I
	BX      LR  
}
//设置栈顶地址
//addr:栈顶地址
__asm void MSR_MSP(u32 addr) 
{
	MSR MSP, r0 			//set Main Stack value
	BX r14
}
