Mu-Miao/Sunward_Data/output/固件接入包/T14_任务三接入包/Core/Inc/car_line.h

#ifndef CAR_LINE_H
#define CAR_LINE_H
#include "car_state.h"

/* Internal foreground module API; state lifetime is owned by CarApp. */
void CarLine_Read(CarAppContext *app);
void CarLine_Decode(CarAppContext *app);
void CarLine_Sample(CarAppContext *app, uint32_t now, int timing_ok);
void CarLine_SetTargets(CarAppContext *app, uint32_t now, float base);
#endif
