Mu-Miao/Sunward_Data/output/固件接入包/T14_任务三接入包/Core/Inc/car_signal.h

#ifndef CAR_SIGNAL_H
#define CAR_SIGNAL_H
#include "car_state.h"

/* Internal foreground module API; state lifetime is owned by CarApp. */
void CarSignal_Set(CarAppContext *app, int on);
void CarSignal_UpdateReady(CarAppContext *app, uint32_t now);
#endif
