Mu-Miao/Sunward_Data/output/固件接入包/T21_任务四四圈接入包/Core/Src/car_task4.c

#include "car_task4.h"
#include "car_route.h"
#include "car_config.h"

CarTask3Config CarTask4_Config(void)
{
    CarTask3Config config = CarRoute_Task3Config();
    config.laps = DPT_TASK4_LAPS;
    config.deadline_ms = DPT_TASK4_TIMEOUT_MS;
    return config;
}
