Mu-Miao/Sunward_Data/output/固件接入包/T13_模块化重构/Core/Inc/dual_pi_test.h

#ifndef DUAL_PI_TEST_H
#define DUAL_PI_TEST_H
#include "car_config.h"
#include "car_app.h"
/* Legacy source compatibility; new application code uses car_app.h. */
HAL_StatusTypeDef DualPITest_Begin(UART_HandleTypeDef *uart,
    TIM_HandleTypeDef *left_encoder, TIM_HandleTypeDef *right_encoder,
    ADC_HandleTypeDef *battery_adc, void (*motor_ab)(int a, int b));
HAL_StatusTypeDef DualPITest_EnableBluetooth(UART_HandleTypeDef *bluetooth);
void DualPITest_EnableHeading(int mpu_initialized);
void DualPITest_Poll(uint32_t tick10_count);
#endif
