Mu-Miao/Sunward_Data/(commit log)

2026-10-14 Import selected Sunward project sources, docs and current deliverables
2026-10-19 同步 T28 回退记录及厂家示例清理
2026-10-19 忽略本地汇报目录
2026-10-25 同步 TASK4 V18_FLOW 与 V19_EDGE 交付的测试日志与验证文档（不含固件二进制）
