Mu-Miao/Sunward_Data/(notices)

Notices in the files:
output/固件接入包/T29_任务三四转向余量包/staged_Sunward/Core/Inc/main.h:
Copyright (c) 2026 STMicroelectronics.
All rights reserved.
This software is licensed under terms that can be found in the LICENSE file
